synthesissolutions/geeksforkids/README.md

# geeksforkids
car_firmware - Code for RC/Joytick controlled cars
