synthesissolutions/geeksforkids/hardware/ControlBoardT36/ControlBoardT36.png

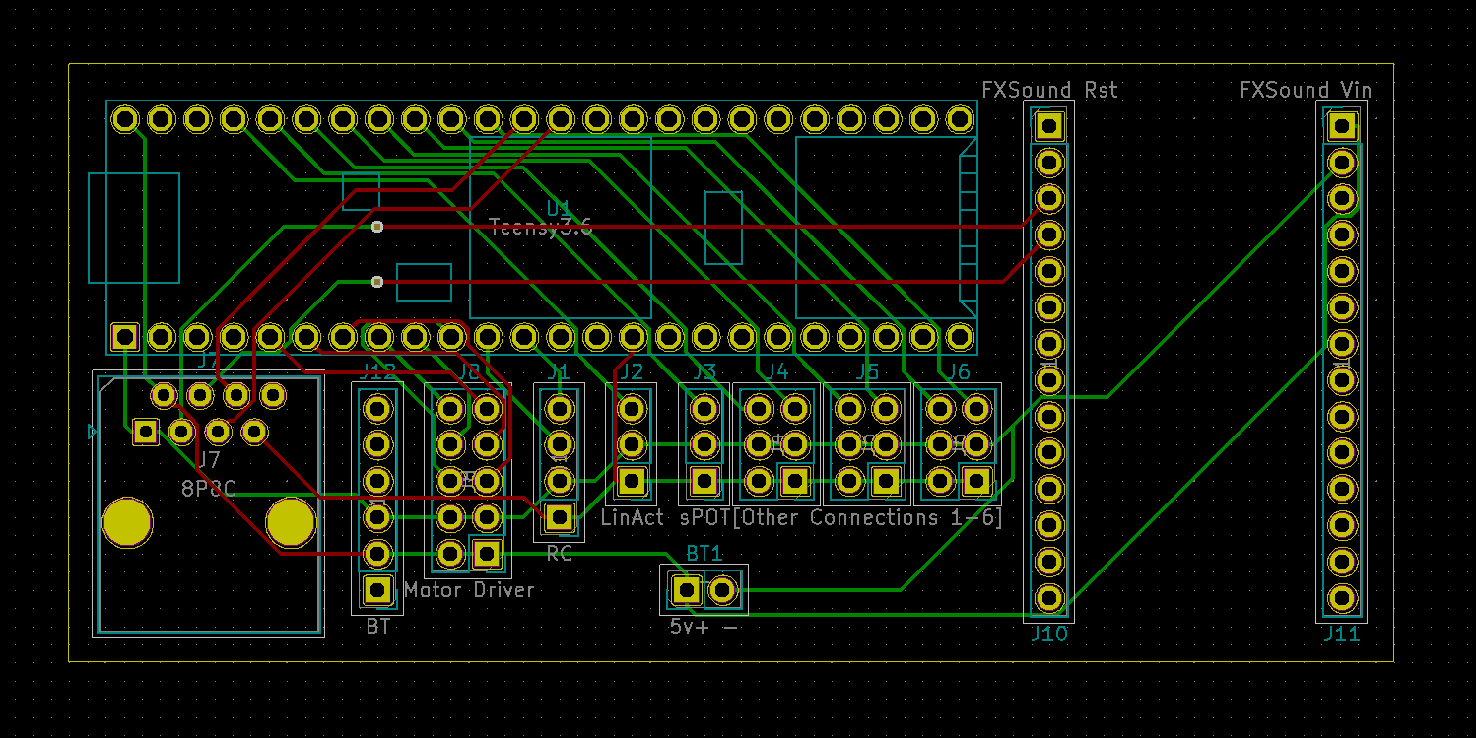
hardware/ControlBoardT36/ControlBoardT36.png
