synthesissolutions/geeksforkids/hardware/Drive Systems/Joystick/JoystickBoard/JoystickBoard.png

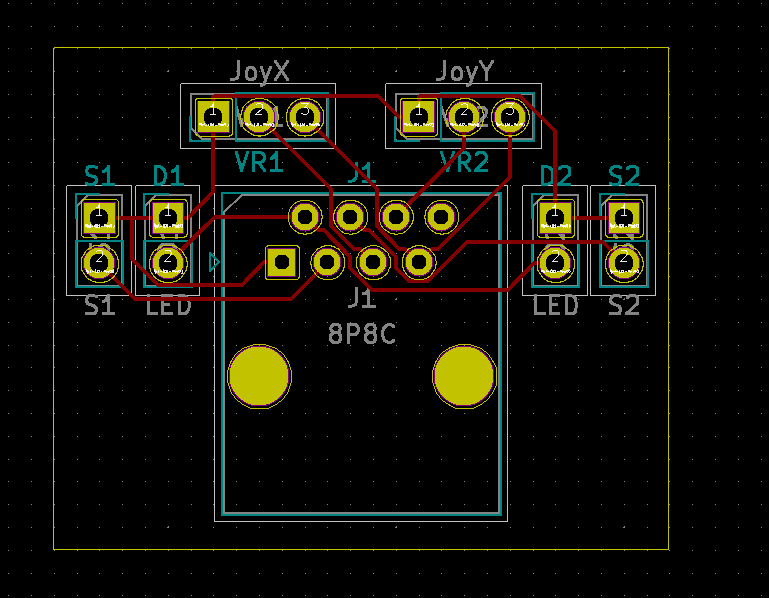
hardware/Drive Systems/Joystick/JoystickBoard/JoystickBoard.png
