synthesissolutions/geeksforkids/hardware/InputBoardSTM32/InputBoardSTM32-PCB.PNG

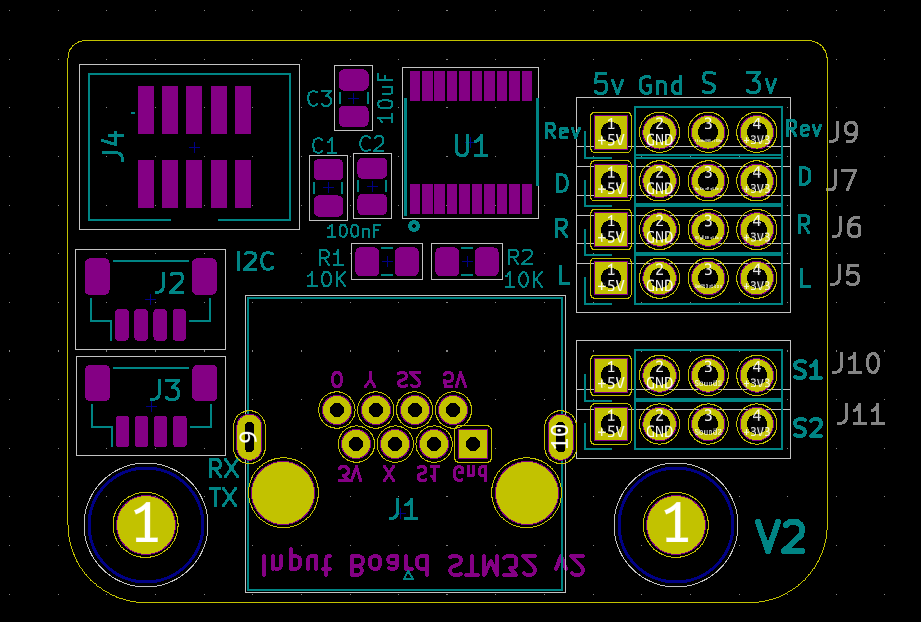
hardware/InputBoardSTM32/InputBoardSTM32-PCB.PNG
