synthesissolutions/geeksforkids/hardware/InputBoardSTM32QFN28/InputBoardSTM32QFN28-PCB.PNG

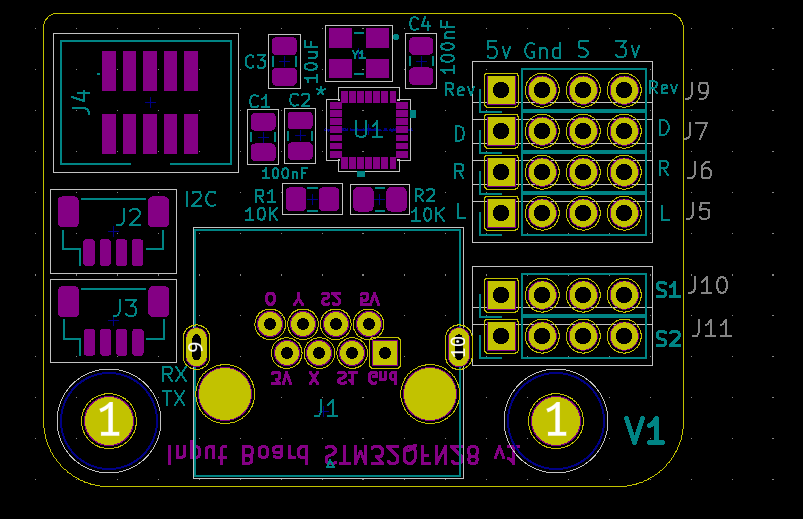
hardware/InputBoardSTM32QFN28/InputBoardSTM32QFN28-PCB.PNG
