synthesissolutions/geeksforkids/hardware/ControlPanelSTM32QFN28/production/gerber/bom.csv

Designator | Footprint | Quantity | Value | LCSC Part #
_3 |  | 1
C1, C2, C4 | 0402 | 3 | 100nF | C307331
C3 | 0603 | 1 | 10uF | C96446
D1 | 0603 | 1 | LED_Small
J1 | RJ45_x08_Tab_Up | 1 | 8P8C
J10, J11, J5, J6, J9 | JST_XH_B2B-XH-A_1x02_P2.50mm_Vertical | 5 | Conn_01x04_Male | C158012
J12, J13, J14, J15, J7, J8 | JST_XH_B2B-XH-A_1x02_P2.50mm_Vertical | 6 | Conn_01x02_Male | C158012
R1 | 0402 | 1 | 470 | C25117
U1 | STM32G031G8U6 | 1 | STM32G031F4Px | C432211
Y1 | OSC_ECS-3225MVQ-160-BP-TR | 1 | ECS-3225MVQ-160-BP-TR | C252336
