synthesissolutions/geeksforkids/hardware/Drive Systems/Drive By Wire (Ryder)/RyderSteeringButtonHolder/production/bom.csv

Designator | Footprint | Quantity | Value | LCSC Part #
J1 | JST_SH_SM03B-SRSS-TB_1x03-1MP_P1.00mm_Horizontal | 1 | Conn_01x03_Pin | C160403
J2 | button-holder1 | 1 | ButtonHolder
