synthesissolutions/geeksforkids/hardware/Drive Systems/Control Panel (New)/Small_Button/production/bom.csv

Designator | Footprint | Quantity | Value | LCSC Part #
J1 | JST_SH_SM03B-SRSS-TB_1x03-1MP_P1.00mm_Horizontal | 1 | JST SH | C160403
R1 | 0603 | 1 | 150Ω | C2907103
