synthesissolutions/geeksforkids/hardware/Evaluation and Test Boards/ATTinyBreakOut_DFRobot_Amp/parts.txt

https://www.digikey.com/product-detail/en/maxim-integrated/MAX9744ETH/MAX9744ETH-ND/1937401
https://www.digikey.com/product-detail/en/alpha-omega-semiconductor-inc/AOD417/785-1106-1-ND/1856049
https://www.digikey.com/product-detail/en/tdk-corporation/MPZ2012S221AT000/445-1568-1-ND/571898
https://www.digikey.com/product-detail/en/stackpole-electronics-inc/RNCP0805FTD10K0/RNCP0805FTD10K0CT-ND/2240601
https://www.digikey.com/product-detail/en/yageo/RC0805FR-0720KL/311-20-0KCRCT-ND/730667
https://www.digikey.com/product-detail/en/kemet/C0805C471K5RACTU/399-1142-1-ND/411417
https://www.digikey.com/product-detail/en/kemet/C0805C104M3RACTU/399-8000-1-ND/3471723
https://www.digikey.com/product-detail/en/kemet/C0805C474K4RACTU/399-8099-1-ND/3471822
https://www.digikey.com/product-detail/en/kemet/C0805C225K3RAC7800/399-11941-1-ND/5267659
https://www.digikey.com/product-detail/en/kemet/C0805C106K4PACTU/399-8012-1-ND/3471735
https://www.digikey.com/product-detail/en/rubycon/16ZLH470MEFC8X11-5/1189-1859-ND/3563382
