synthesissolutions/geeksforkids/hardware/Action Challenges/ButtonToActionChallenge/ButtonToActionChallenge.step

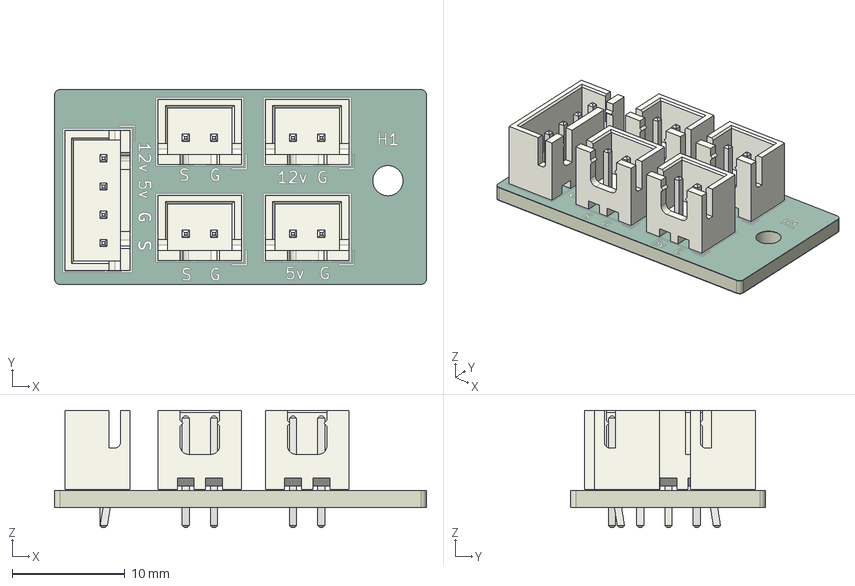
[picture p5: CAD file, 2026-05-23]
hardware/Action Challenges/ButtonToActionChallenge/ButtonToActionChallenge.step
32.9 x 17.3 x 10.4 mm
JST_XH_B4B-XH-A_1x04_P2.50mm_Vertical
JST_XH_B2B-XH-A_1x02_P2.50mm_Vertical x 4
ButtonToActionChallenge_silkscreen x 2
ButtonToActionChallenge_soldermask x 2
ButtonToActionChallenge_PCB
