synthesissolutions/geeksforkids/hardware/Action Challenges/Magic_Wand_Timer_Simplified/Magic_Wand_Timer_Simplified.step

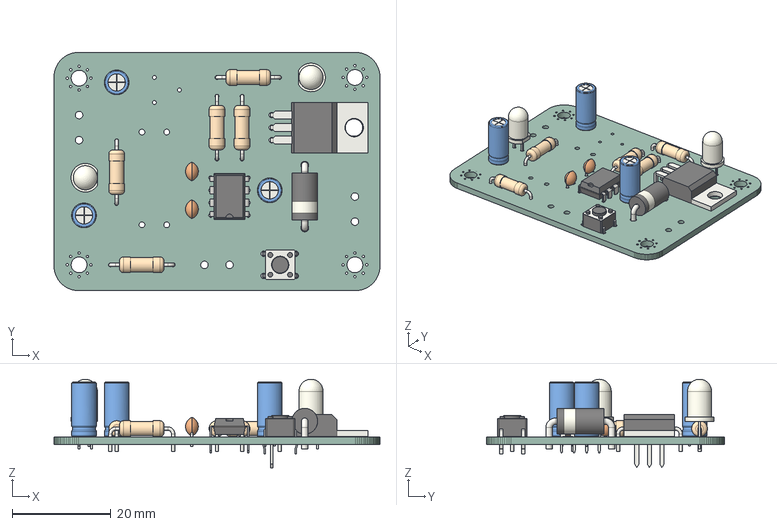
[picture p6: CAD file, 2024-05-20]
hardware/Action Challenges/Magic_Wand_Timer_Simplified/Magic_Wand_Timer_Simplified.step
66.0 x 48.3 x 17.9 mm
Magic_Wand_Timer_Simplified PCB
