synthesissolutions/geeksforkids/hardware/Action Challenges/Pulse_Fixed_Timer/3D_Models/TC33X-2-504E.step

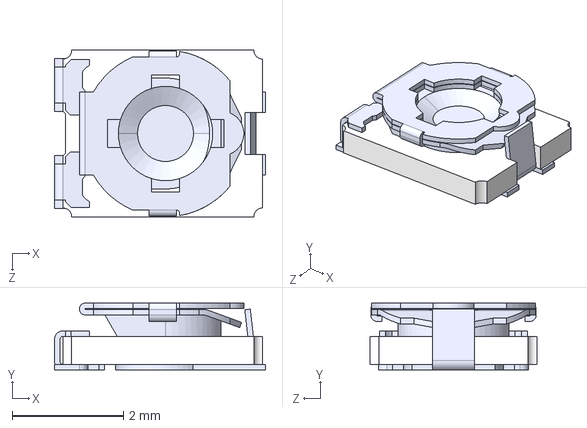
[picture p7: CAD file, 2024-11-27]
hardware/Action Challenges/Pulse_Fixed_Timer/3D_Models/TC33X-2-504E.step
3.80 x 1.20 x 3.00 mm
