synthesissolutions/geeksforkids/hardware/Action Challenges/Pulse_PWM_Timer/3D_Models/DFN8_LM393_STM.step

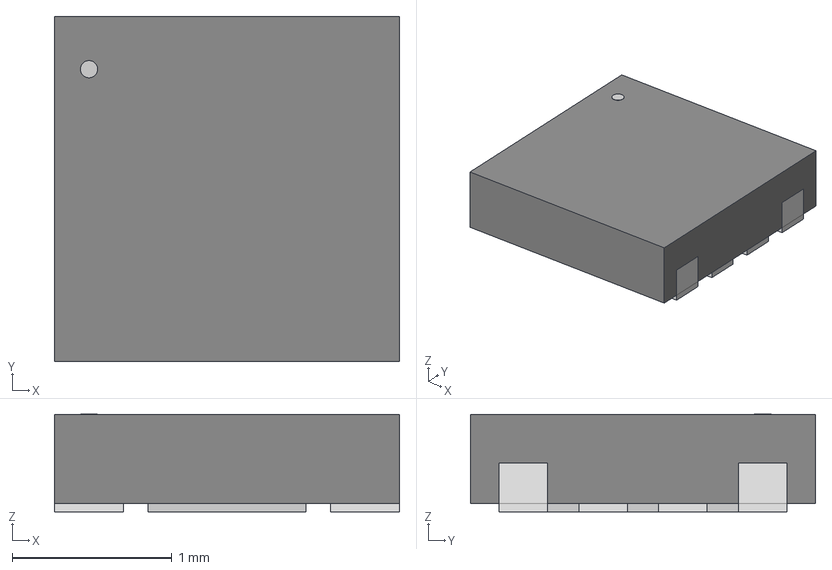
[picture p8: CAD file, 2024-11-27]
hardware/Action Challenges/Pulse_PWM_Timer/3D_Models/DFN8_LM393_STM.step
2.16 x 2.16 x 0.612 mm
