synthesissolutions/geeksforkids/hardware/Action Challenges/Pulse_PWM_Timer/Pulse_PWM_Timer.step

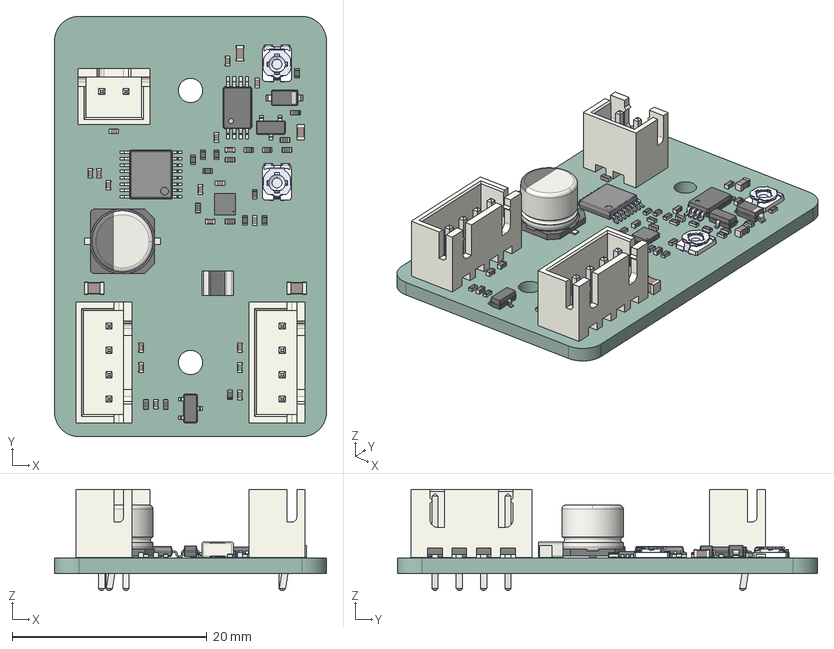
[picture p9: CAD file, 2024-11-27]
hardware/Action Challenges/Pulse_PWM_Timer/Pulse_PWM_Timer.step
27.9 x 43.2 x 10.4 mm
R_0402_1005Metric x 19
C_0402_1005Metric x 18
C_0603_1608Metric x 2
PWP0016C_ASM
SOT_23 x 2
JST_B4B_XH_A x 2
C_0805_2012Metric x 2
JST_B2B_XH_A
D_SOD_123
TC33X-2-202E x 2
Fuse_1210_3225Metric
TSSOP_8_44x3mm_P065mm
CP_Elec_63x54
Pulse_PWM_Timer_PCB
