synthesissolutions/geeksforkids/hardware/ControlPanelV3/ControlPanelV3.step

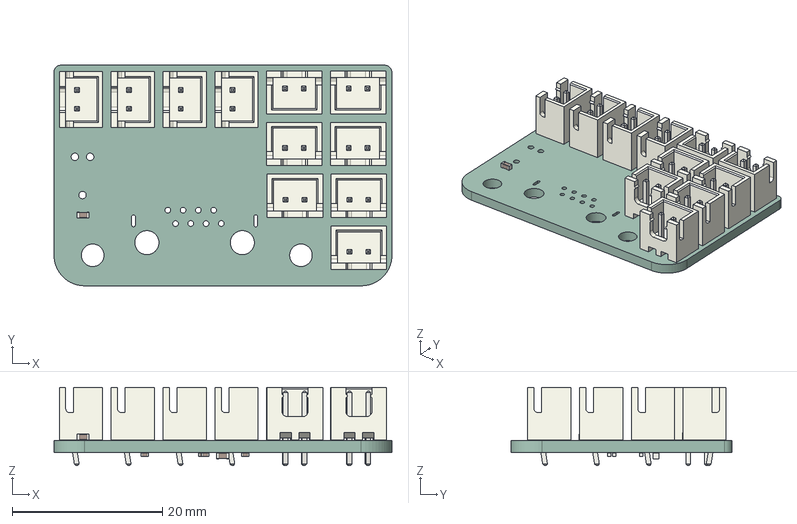
[picture p10: CAD file, 2024-12-07]
hardware/ControlPanelV3/ControlPanelV3.step
45.0 x 29.4 x 10.4 mm
JST_B2B_XH_A x 11
C_0603_1608Metric x 2
C_0402_1005Metric x 4
ControlPanelSTM32QFN28_PCB
