synthesissolutions/geeksforkids/hardware/Drive Systems/Control Panel (New)/Large_Button/button_pcb.step

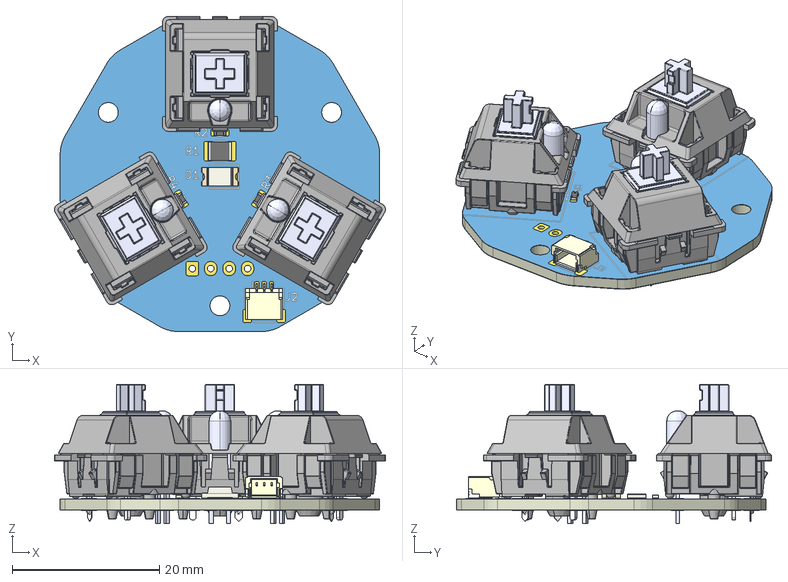
[picture p11: CAD file, 2025-04-16]
hardware/Drive Systems/Control Panel (New)/Large_Button/button_pcb.step
44.9 x 42.8 x 18.9 mm
R_0603_1608Metric x 3
MX Öá °´¼ü¡ä_¨¹___¡§1 x 3
MX ס סͥ¨¢¨¬_¡§¡顧__ x 3
MXס ϞñLEDLEDLED x 3
MXÖá ÖáÌå µ×²¿ ¦Ì¡Á2__Ä¬ÈÏ_¨¢2____¨¨_ x 3
֫½ğ__Ĭɏ__¨¨_ x 3
R_1210_3225Metric
JST_SH_SM03B-SRSS-TB_1x03-1MP_P1.00mm_Horizontal
LED_2010_5025Metric_Castellated
large_button_copper
large_button_silkscreen
large_button_soldermask
large_button_PCB
