synthesissolutions/geeksforkids/hardware/Drive Systems/Control Panel (New)/Small_Button/button_pcb.step

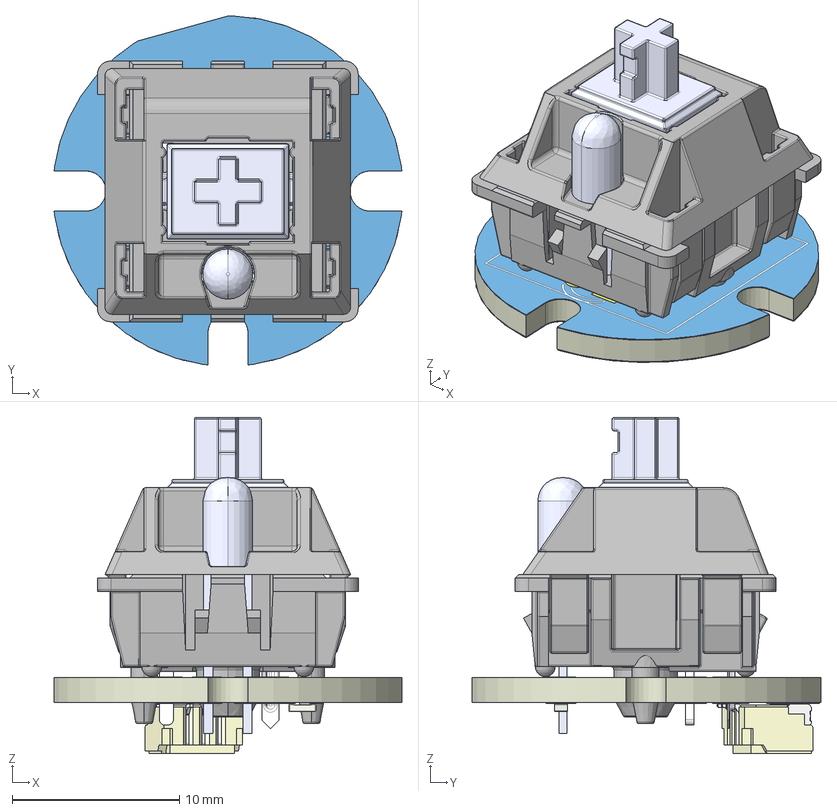
[picture p12: CAD file, 2025-04-16]
hardware/Drive Systems/Control Panel (New)/Small_Button/button_pcb.step
20.8 x 20.9 x 20.1 mm
MX Öá °´¼ü¡ä_¨¹___¡§1
MX ס סͥ¨¢¨¬_¡§¡顧__
MXס ϞñLEDLEDLED
MXÖá ÖáÌå µ×²¿ ¦Ì¡Á2__Ä¬ÈÏ_¨¢2____¨¨_
֫½ğ__Ĭɏ__¨¨_
JST_SH_SM03B-SRSS-TB_1x03-1MP_P1.00mm_Horizontal
R_0603_1608Metric
Small_Button_copper
Small_Button_silkscreen
Small_Button_soldermask
Small_Button_PCB
