synthesissolutions/geeksforkids/hardware/Drive Systems/Control Panel (No Touch)/ControlPanel_CapacitiveTouch/.step

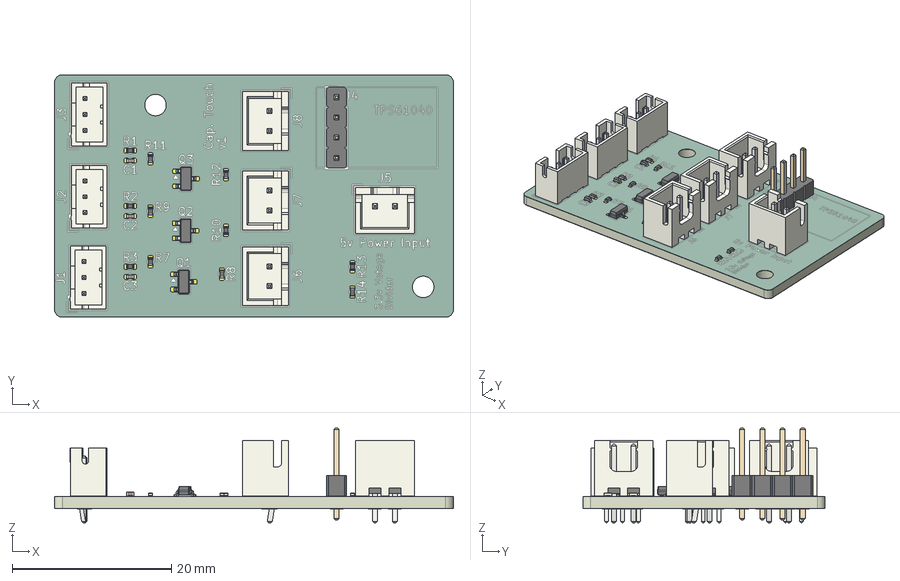
[picture p13: CAD file, 2026-05-23]
hardware/Drive Systems/Control Panel (No Touch)/ControlPanel_CapacitiveTouch/.step
50.2 x 30.5 x 11.9 mm
R_0402_1005Metric x 11
C_0402_1005Metric x 3
JST_XH_B2B-XH-A_1x02_P2.50mm_Vertical x 4
JST_PH_B3B-PH-K_1x03_P2.00mm_Vertical x 3
SOT-23 x 3
PinHeader_1x04_P2.54mm_Vertical
ControlPanel_CapacitiveTouch_copper
ControlPanel_CapacitiveTouch_silkscreen x 2
ControlPanel_CapacitiveTouch_soldermask x 2
ControlPanel_CapacitiveTouch_PCB
