synthesissolutions/geeksforkids/hardware/Drive Systems/Drive By Wire (Fisher Price)/DriveByWireInputAltSTM32QFN28/DriveByWireInputAltSTM32QFN28.step

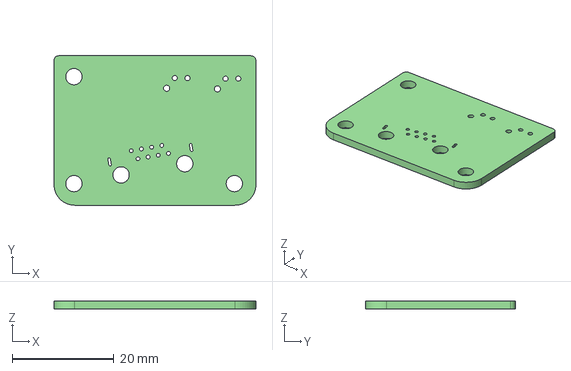
[picture p14: CAD file, 2022-08-21]
hardware/Drive Systems/Drive By Wire (Fisher Price)/DriveByWireInputAltSTM32QFN28/DriveByWireInputAltSTM32QFN28.step
39.7 x 29.4 x 1.60 mm
