synthesissolutions/geeksforkids/hardware/Drive Systems/Drive By Wire (Fisher Price)/DriveByWireMr360Sensor/3d_models/EG1249.stp

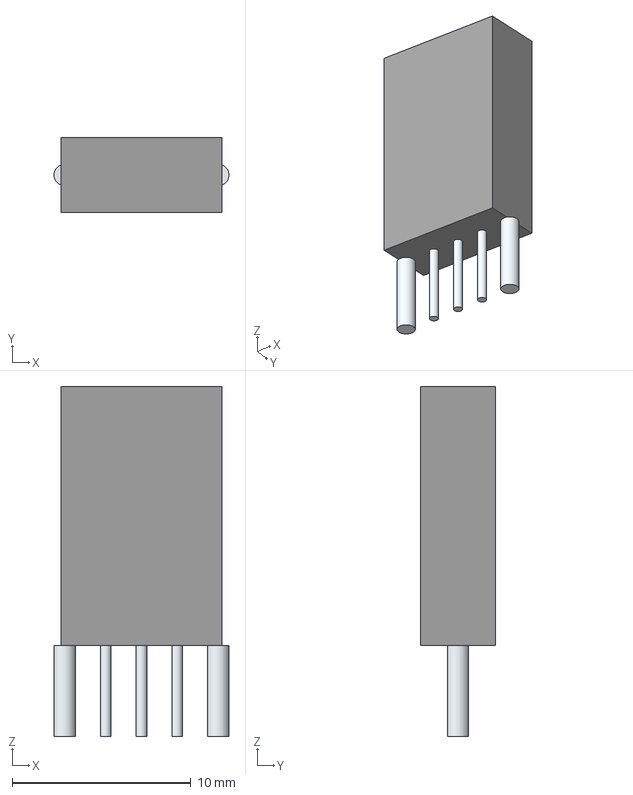
[picture p15: CAD file, 2022-07-25]
hardware/Drive Systems/Drive By Wire (Fisher Price)/DriveByWireMr360Sensor/3d_models/EG1249.stp
9.80 x 4.20 x 19.6 mm
Leads x 5
