synthesissolutions/geeksforkids/hardware/Drive Systems/Drive By Wire (Fisher Price)/DriveByWireMr360Sensor/TLE5501E0001XUMA1.step

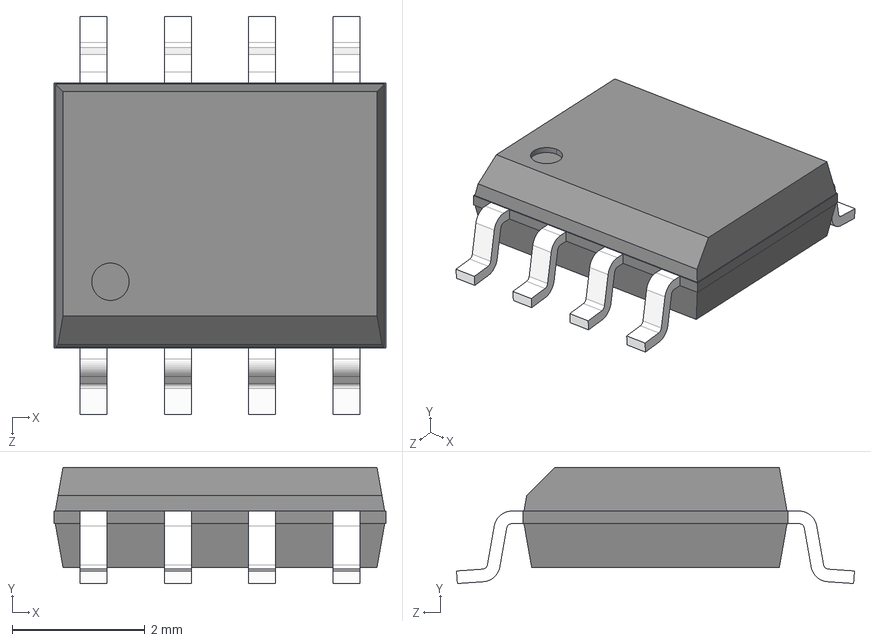
[picture p16: CAD file, 2022-08-19]
hardware/Drive Systems/Drive By Wire (Fisher Price)/DriveByWireMr360Sensor/TLE5501E0001XUMA1.step
5.00 x 1.75 x 6.00 mm
