synthesissolutions/geeksforkids/hardware/Drive Systems/Drive By Wire (Fisher Price)/DriveByWireMrSensor/3d_models/SO8_SOT96-1_NXP.step

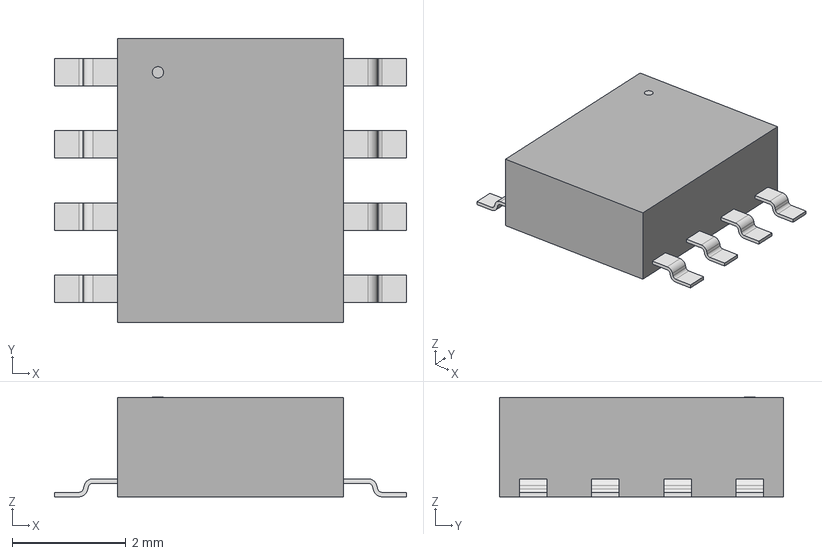
[picture p17: CAD file, 2021-11-19]
hardware/Drive Systems/Drive By Wire (Fisher Price)/DriveByWireMrSensor/3d_models/SO8_SOT96-1_NXP.step
6.20 x 5.00 x 1.75 mm
