synthesissolutions/geeksforkids/hardware/Drive Systems/Drive By Wire (Fisher Price)/DriveByWireMrSensor/DriveByWire PCB Sketch V2.dxf

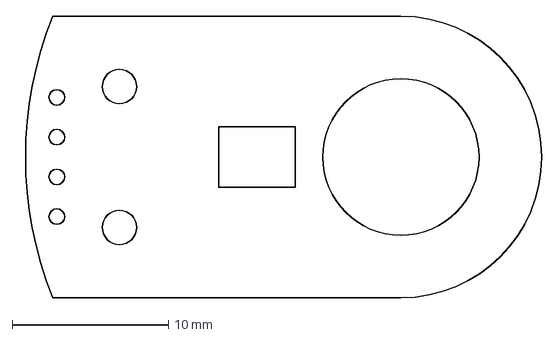
[picture p18: CAD file, 2021-12-07]
hardware/Drive Systems/Drive By Wire (Fisher Price)/DriveByWireMrSensor/DriveByWire PCB Sketch V2.dxf
33.6 x 18.0 mm
