synthesissolutions/geeksforkids/hardware/Drive Systems/Drive By Wire (Ryder)/RyderDriveByWireMicrocontroller/RyderDriveByWireMicrocontroller.step

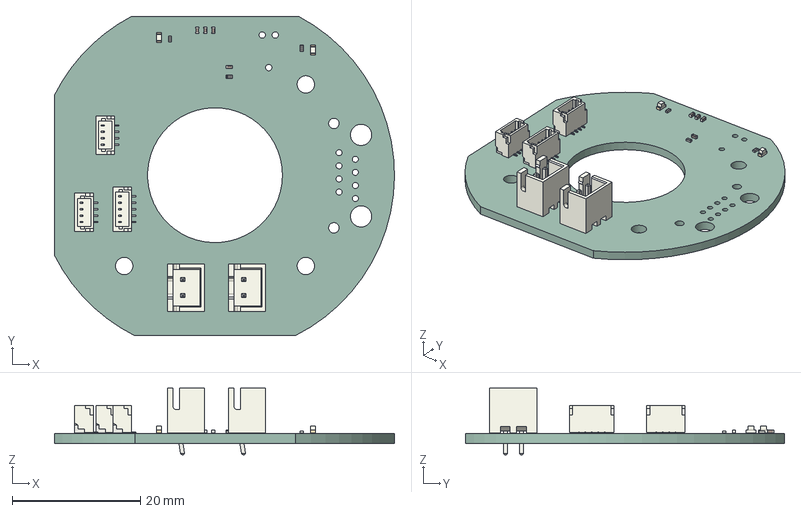
[picture p19: CAD file, 2026-04-09]
hardware/Drive Systems/Drive By Wire (Ryder)/RyderDriveByWireMicrocontroller/RyderDriveByWireMicrocontroller.step
53.0 x 49.8 x 10.4 mm
C_0402_1005Metric x 4
JST_SH_BM04B-SRSS-TB_1x04-1MP_P1.00mm_Vertical x 2
JST_XH_B2B-XH-A_1x02_P2.50mm_Vertical x 2
R_0402_1005Metric x 3
JST_SH_BM05B-SRSS-TB_1x05-1MP_P1.00mm_Vertical
LED_0603_1608Metric x 2
RyderDriveByWireMicrocontroller_PCB
