synthesissolutions/geeksforkids/hardware/Drive Systems/Drive By Wire (Ryder)/RyderSteeringButtonConnector/RyderSteeringButtonConnector.step

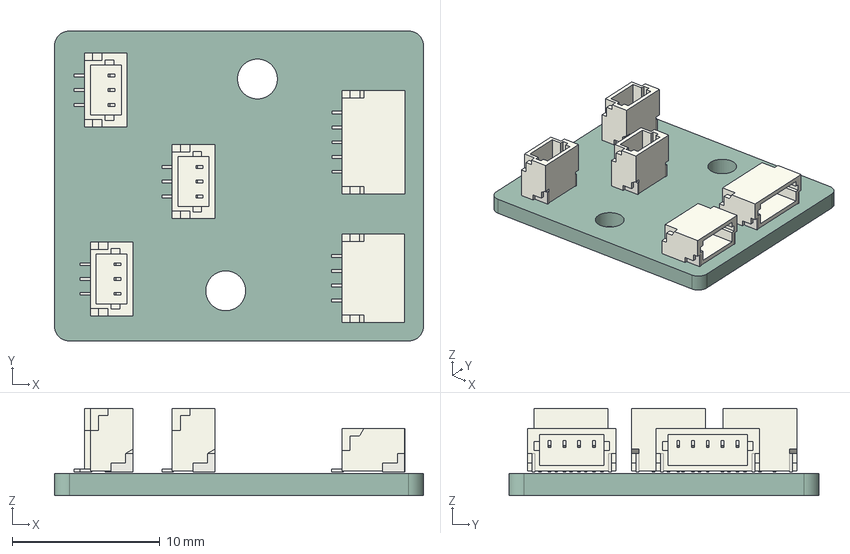
[picture p20: CAD file, 2026-03-16]
hardware/Drive Systems/Drive By Wire (Ryder)/RyderSteeringButtonConnector/RyderSteeringButtonConnector.step
25.0 x 21.0 x 5.92 mm
JST_SH_BM03B-SRSS-TB_1x03-1MP_P1.00mm_Vertical x 3
JST_SH_SM05B-SRSS-TB_1x05-1MP_P1.00mm_Horizontal
JST_SH_SM04B-SRSS-TB_1x04-1MP_P1.00mm_Horizontal
RyderSteeringButtonConnector_PCB
