synthesissolutions/geeksforkids/hardware/Drive Systems/Joystick/InputJoyStickSTM32QFN28/InputJoyStickSTM32QFN28.step

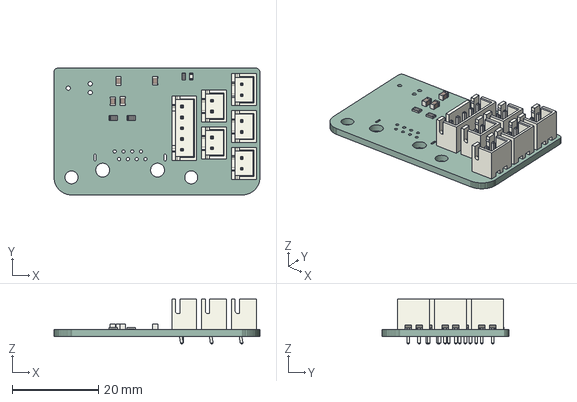
[picture p21: CAD file, 2023-12-19]
hardware/Drive Systems/Joystick/InputJoyStickSTM32QFN28/InputJoyStickSTM32QFN28.step
47.7 x 29.4 x 10.4 mm
InputJoyStickSTM32QFN28 PCB
