synthesissolutions/geeksforkids/hardware/Evaluation and Test Boards/FeatherRJ45/3d/TS-1187A-B-A-B.step

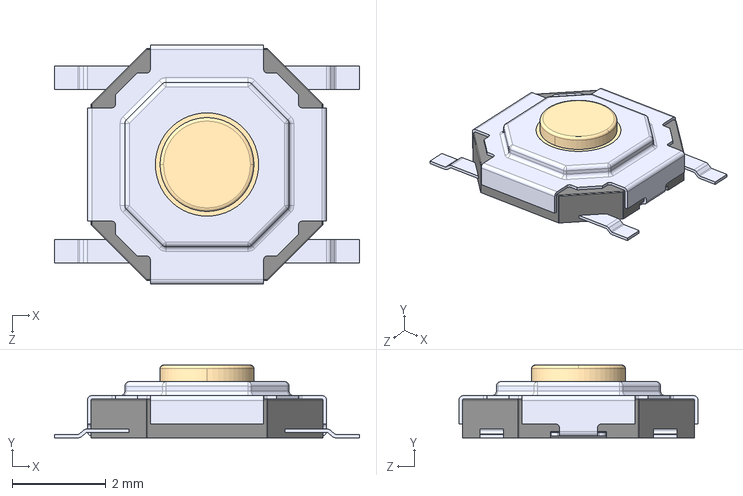
[picture p22: CAD file, 2023-11-09]
hardware/Evaluation and Test Boards/FeatherRJ45/3d/TS-1187A-B-A-B.step
6.50 x 1.55 x 5.10 mm
