synthesissolutions/geeksforkids/hardware/Evaluation and Test Boards/TOF_Button KB2040/TOF_Button KB2040.step

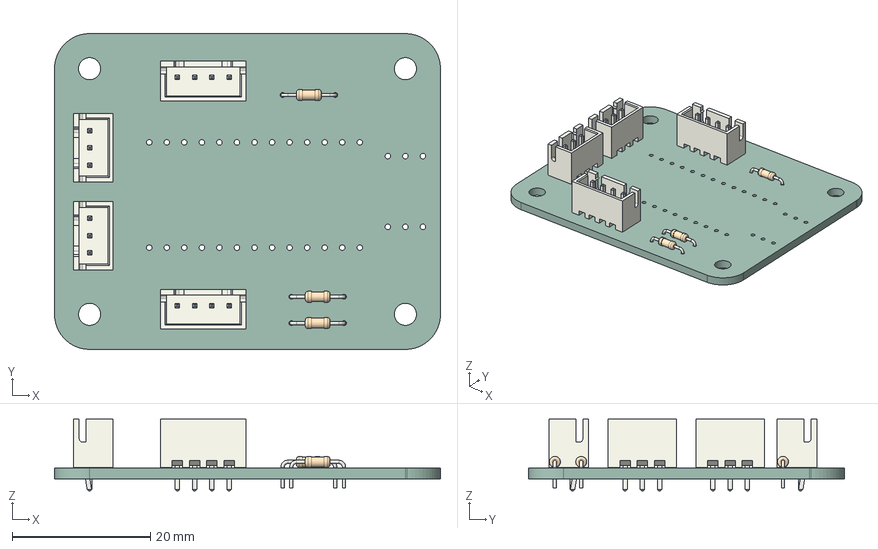
[picture p23: CAD file, 2026-03-21]
hardware/Evaluation and Test Boards/TOF_Button KB2040/TOF_Button KB2040.step
55.9 x 45.7 x 10.4 mm
R_Axial_DIN0204_L36mm_D16mm_P762mm_Horizontal x 3
JST_B3B_XH_A x 2
JST_B4B_XH_A x 2
TOF_Button KB2040_PCB
