synthesissolutions/geeksforkids/hardware/Fisher Price Base/motor-controller-v2/Brushed_DC_Motor_Driver.step

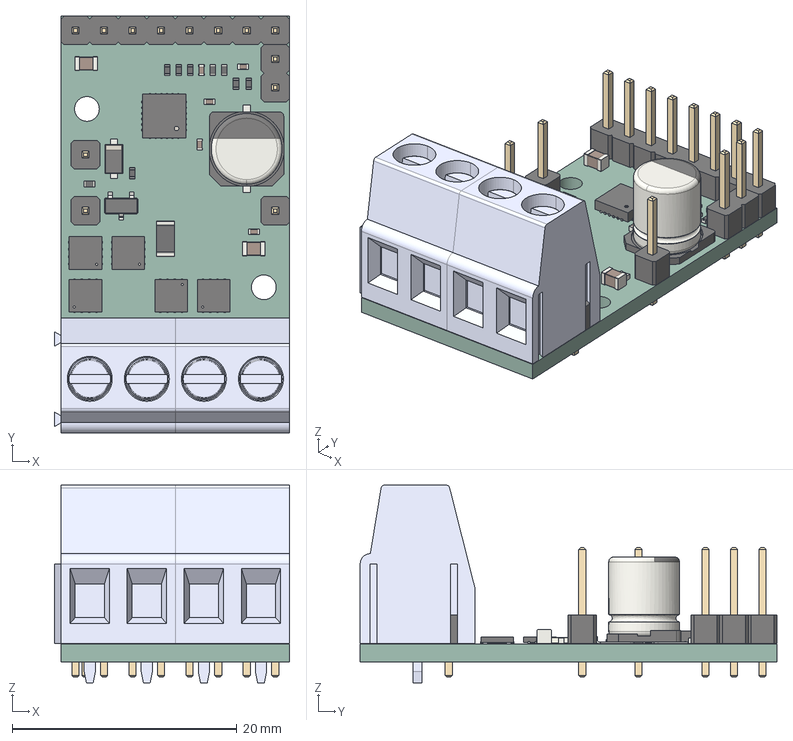
[picture p24: CAD file, 2025-10-25]
hardware/Fisher Price Base/motor-controller-v2/Brushed_DC_Motor_Driver.step
20.9 x 37.1 x 17.6 mm
PCB
