synthesissolutions/geeksforkids/hardware/SimpleBuildSoundsAmp/SimpleBuildSoundsAmp.step

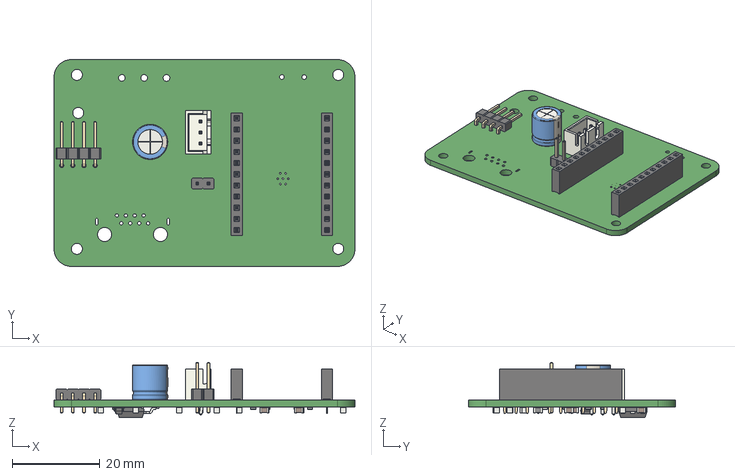
[picture p26: CAD file, 2021-07-20]
hardware/SimpleBuildSoundsAmp/SimpleBuildSoundsAmp.step
68.5 x 47.1 x 12.6 mm
