synthesissolutions/geeksforkids/hardware/Action Challenges/Pulse_PWM_Timer/3D_Models/PWP0016C.stp

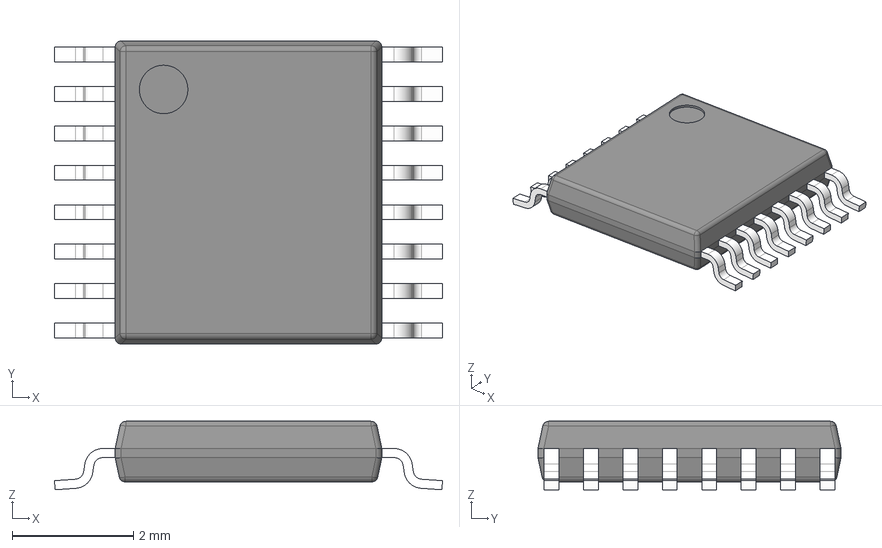
[picture p27: CAD file, 2024-11-27]
hardware/Action Challenges/Pulse_PWM_Timer/3D_Models/PWP0016C.stp
6.40 x 5.00 x 1.13 mm
BODY-TSSOP
LEAD-TSSOP x 16
PIN1
DAP
