synthesissolutions/geeksforkids/hardware/Drive Systems/Drive By Wire (Fisher Price)/DriveByWireMr360Sensor/3d_models/TLE5501E0002XUMA1.stp

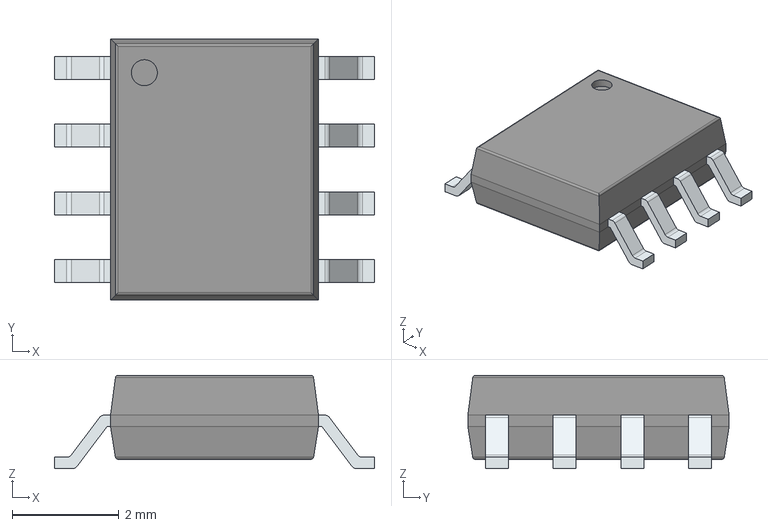
[picture p28: CAD file, 2022-07-25]
hardware/Drive Systems/Drive By Wire (Fisher Price)/DriveByWireMr360Sensor/3d_models/TLE5501E0002XUMA1.stp
6.00 x 4.90 x 1.75 mm
PinsArrayLR
