synthesissolutions/geeksforkids/hardware/Drive Systems/Drive By Wire (Fisher Price)/DriveByWireMrSensor/pcb_fusion_layout.dxf

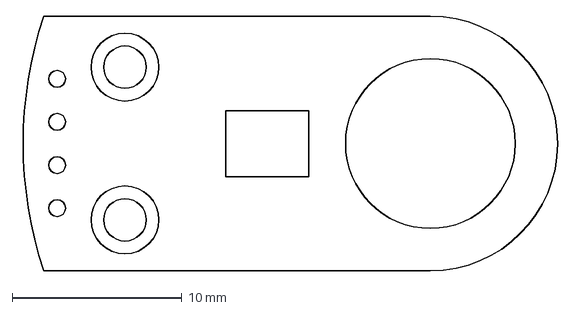
[picture p29: CAD file, 2021-11-19]
hardware/Drive Systems/Drive By Wire (Fisher Price)/DriveByWireMrSensor/pcb_fusion_layout.dxf
31.9 x 15.0 mm
