synthesissolutions/geeksforkids/hardware/Evaluation and Test Boards/FeatherRJ45/3d/TYPE-C-31-M-12.step

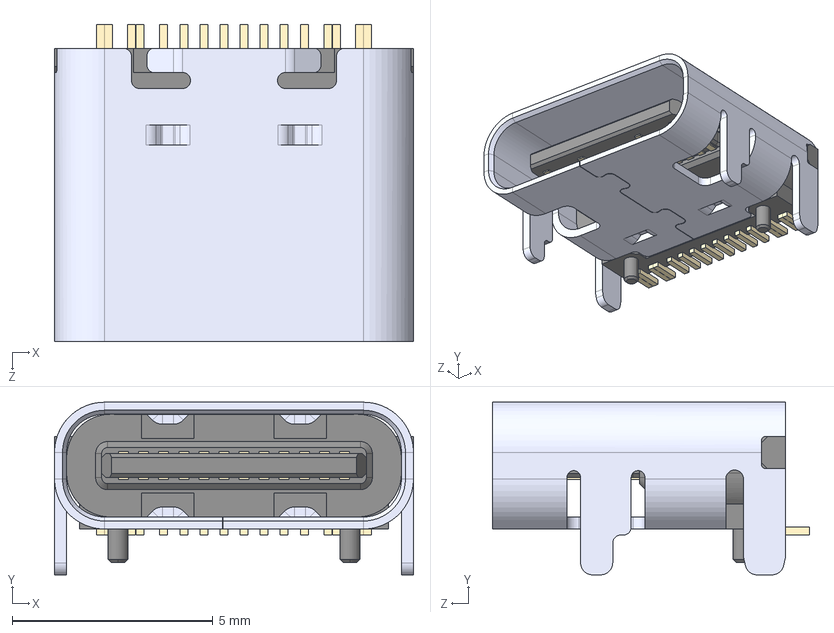
[picture p30: CAD file, 2023-11-09]
hardware/Evaluation and Test Boards/FeatherRJ45/3d/TYPE-C-31-M-12.step
8.94 x 4.30 x 7.90 mm
