synthesissolutions/geeksforkids/hardware/Ryder/geeks-ecu/3Dmodels/NS-Tech_Grove_1x04_P2mm_Vertical.step

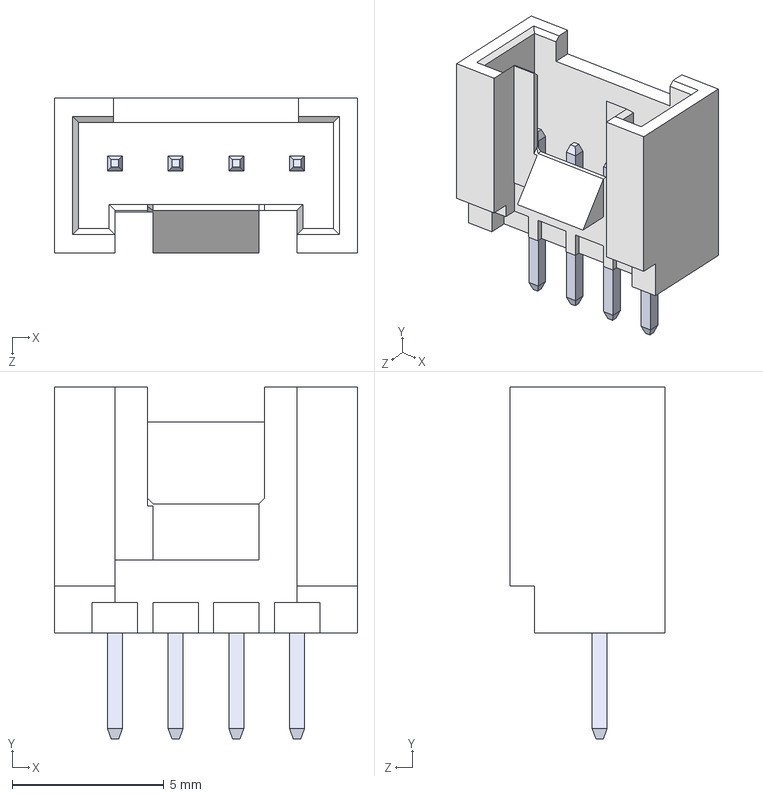
[picture p31: CAD file, 2026-04-27]
hardware/Ryder/geeks-ecu/3Dmodels/NS-Tech_Grove_1x04_P2mm_Vertical.step
10.0 x 11.6 x 5.10 mm
