synthesissolutions/geeksforkids/hardware/Drive Systems/Drive By Wire (Fisher Price)/DriveByWireMr360Sensor/3d_models/RJHSE-3380.stp

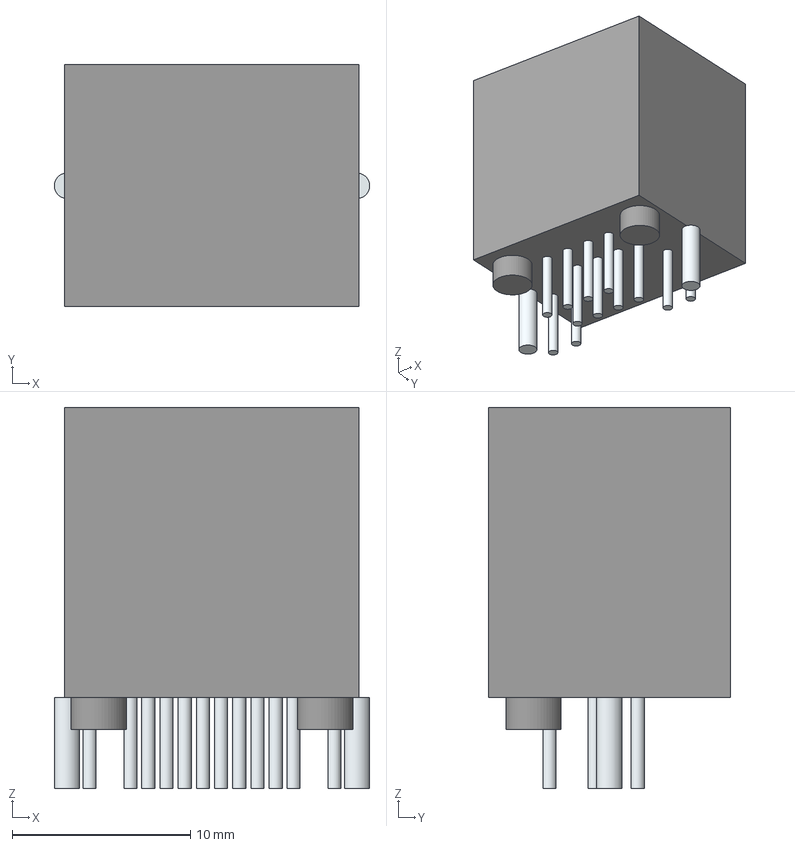
[picture p32: CAD file, 2022-07-25]
hardware/Drive Systems/Drive By Wire (Fisher Price)/DriveByWireMr360Sensor/3d_models/RJHSE-3380.stp
17.7 x 13.6 x 21.4 mm
Lugs x 16
Leads x 16
