synthesissolutions/geeksforkids/hardware/Drive Systems/Drive By Wire (Fisher Price)/DriveByWireMrSensor/DriveByWireMrSensor.step

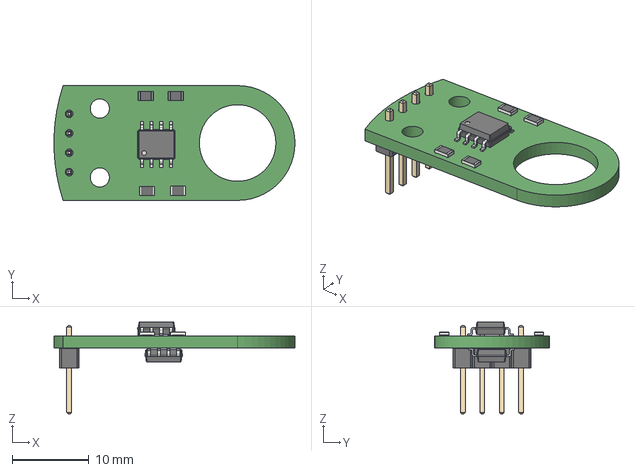
[picture p33: CAD file, 2021-11-19]
hardware/Drive Systems/Drive By Wire (Fisher Price)/DriveByWireMrSensor/DriveByWireMrSensor.step
31.5 x 15.0 x 12.0 mm
