synthesissolutions/geeksforkids/hardware/Ryder/geeks-ecu/3Dmodels/TerminalBlock_CUI_TB007-508-02_1x02_P5.08mm_Horizontal.step

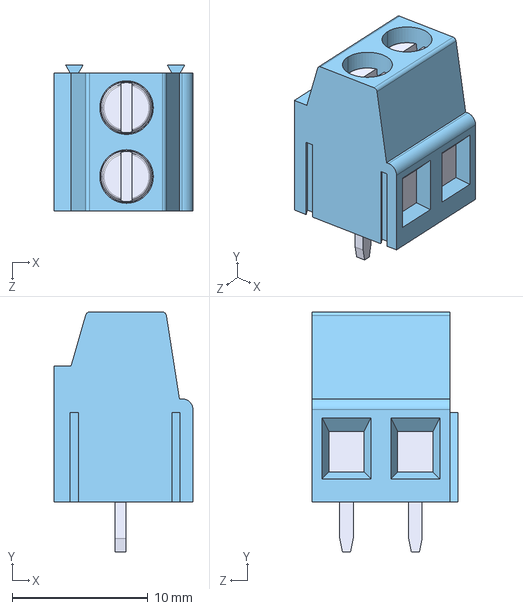
[picture p34: CAD file, 2026-04-27]
hardware/Ryder/geeks-ecu/3Dmodels/TerminalBlock_CUI_TB007-508-02_1x02_P5.08mm_Horizontal.step
10.2 x 17.7 x 10.8 mm
