synthesissolutions/geeksforkids/hardware/Ryder/geeks-ecu/3Dmodels/Same_Sky_TB005-762-02BE.step

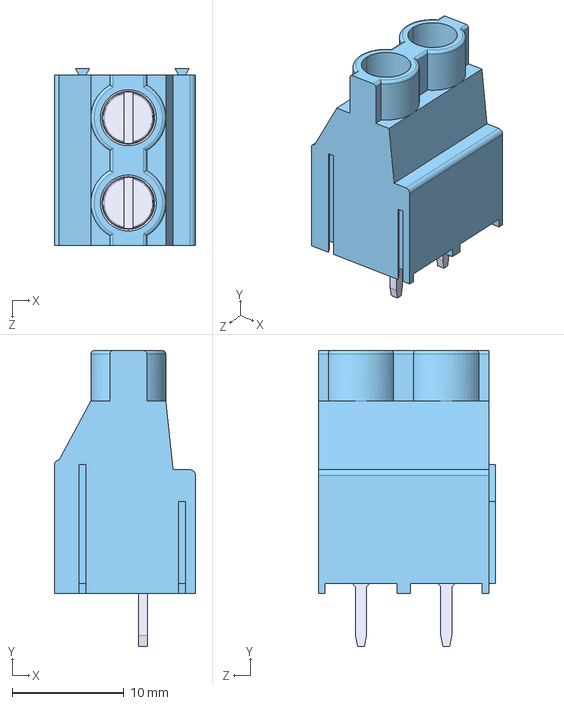
[picture p35: CAD file, 2026-03-14]
hardware/Ryder/geeks-ecu/3Dmodels/Same_Sky_TB005-762-02BE.step
12.6 x 26.5 x 15.8 mm
