synthesissolutions/geeksforkids/hardware/Ryder/geeks-ecu/3Dmodels/APR.stp

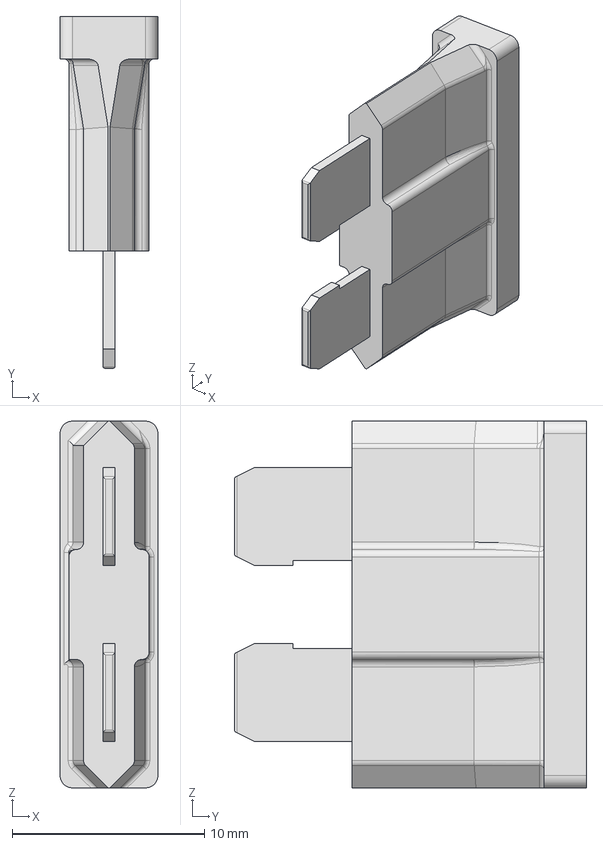
[picture p36: CAD file, 2026-03-14]
hardware/Ryder/geeks-ecu/3Dmodels/APR.stp
5.08 x 18.3 x 19.0 mm
