synthesissolutions/geeksforkids/hardware/Ryder/geeks-ecu/3Dmodels/J115F11A_Sealed_NoPin6.stp

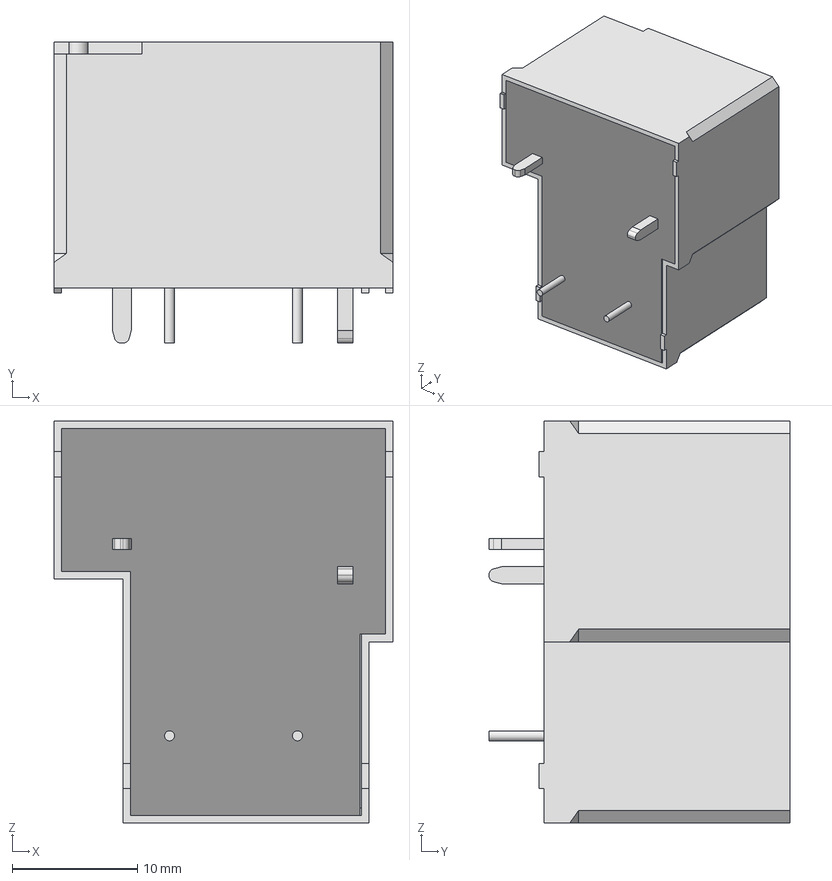
[picture p37: CAD file, 2026-03-14]
hardware/Ryder/geeks-ecu/3Dmodels/J115F11A_Sealed_NoPin6.stp
27.0 x 24.0 x 32.1 mm
J115F1_Cover
J115F11A_Base Plate
J115F1_Terminal_Coil x 2
J115F1_Terminal_Contacts
J115F1_Terminal_Common
