synthesissolutions/geeksforkids/hardware/Ryder/geeks-ecu/3Dmodels/3557-2.step

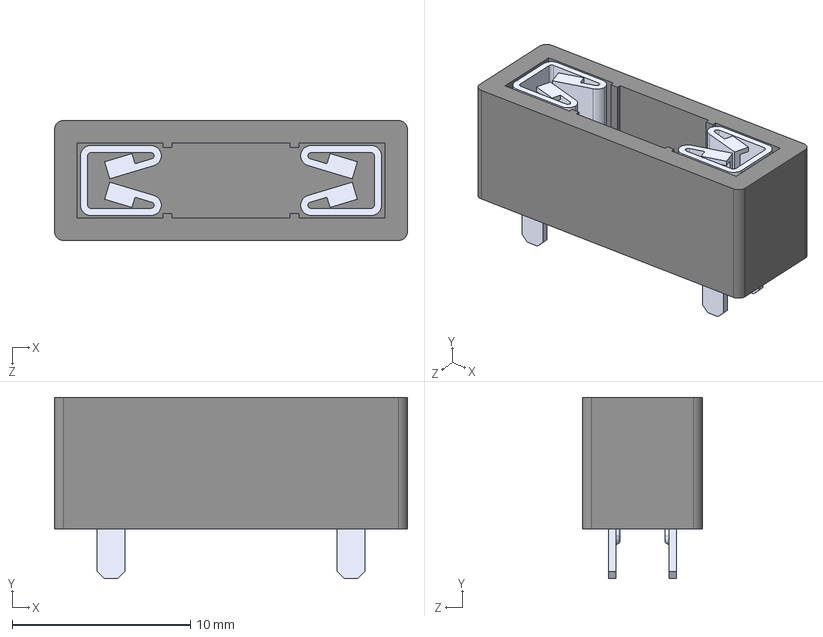
[picture p38: CAD file, 2026-03-14]
hardware/Ryder/geeks-ecu/3Dmodels/3557-2.step
19.8 x 10.2 x 6.73 mm
