synthesissolutions/geeksforkids/hardware/Ryder/geeks-ecu/3Dmodels/3568.step

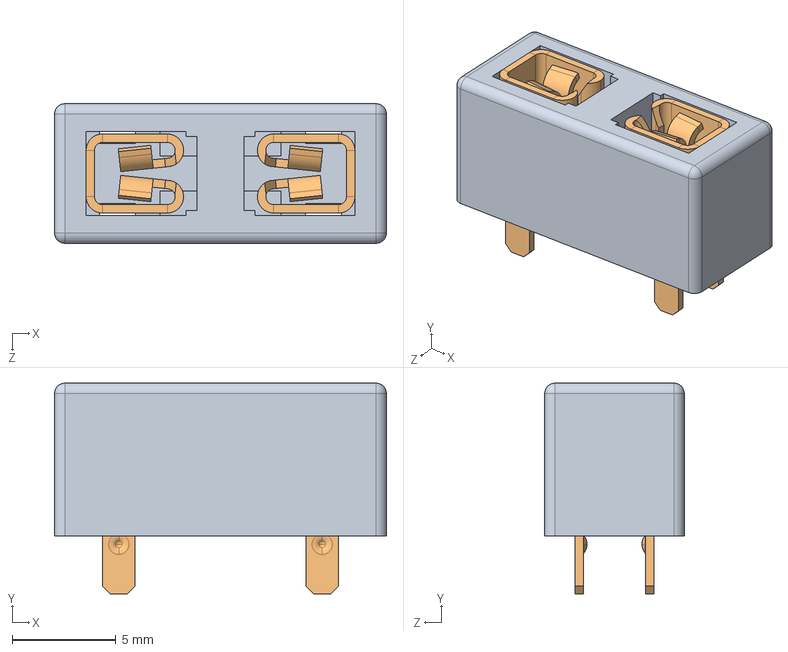
[picture p39: CAD file, 2026-03-14]
hardware/Ryder/geeks-ecu/3Dmodels/3568.step
16.0 x 10.2 x 6.73 mm
F3568-1
3557_rev.C x 2
