synthesissolutions/geeksforkids/(list of files, cad)

Other CAD files:
hardware/Drive Systems/Drive By Wire (Fisher Price)/DriveByWireMr360Sensor/3d_models/NE555DR.stp
