synthesissolutions/geeksforkids/hardware/Ryder/geeks-ecu/geeks-ecu.pdf

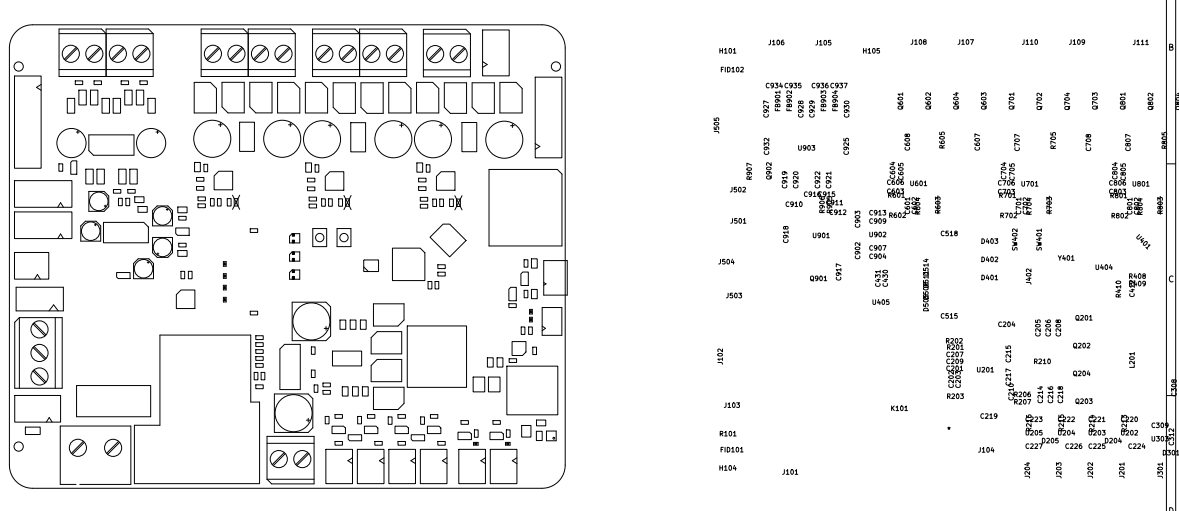
[picture p40: page 1]

Learn Science and Math Club
Sheet:
File: geeks-ecu.kicad_pcb
Title: Electronics Control Unit (ECU)

Size: USLedger | Rev: V1
KiCad E.D.A. 10.0.1 | Id: 1/1
