synthesissolutions/geeksforkids/hardware/Ryder/geeks-ecu/geeks-ecu_ASSY.pdf

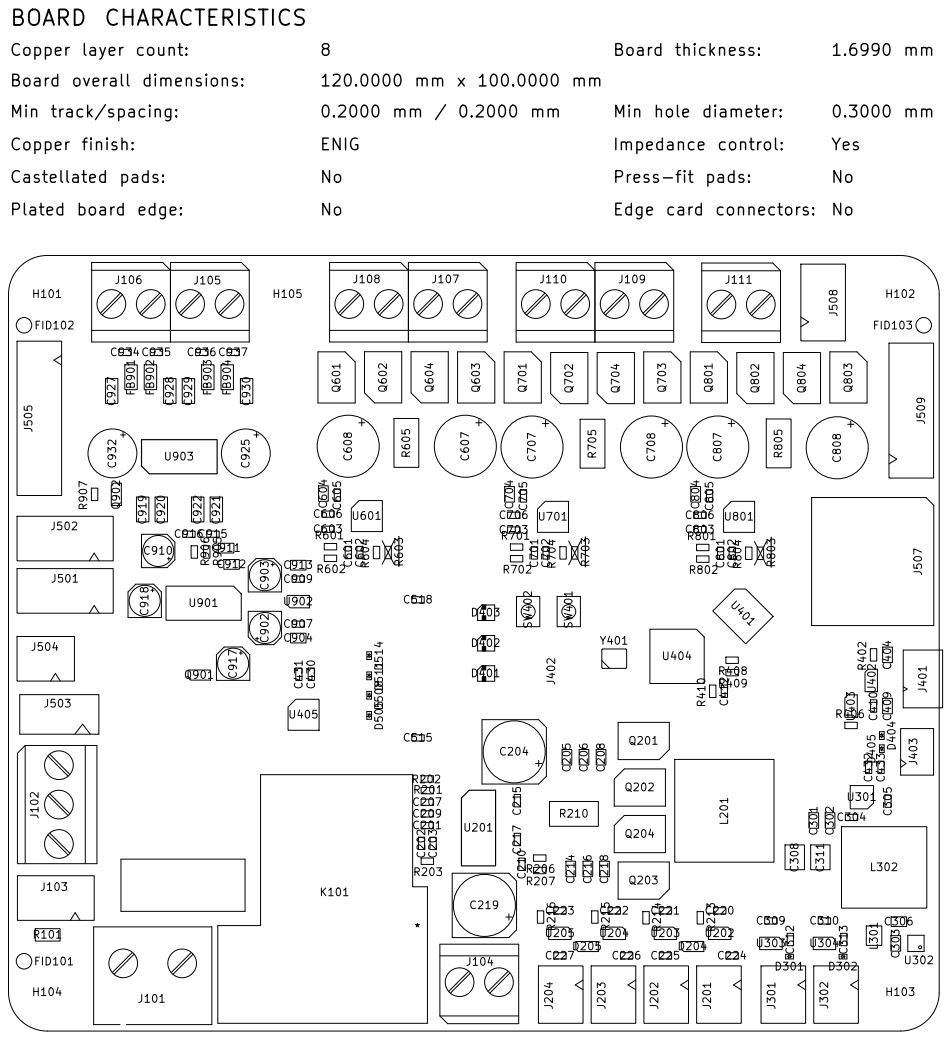
[picture p41: page 1]

Geeks for Kids
Learn Science and Math Club
Sheet:
File: geeks-ecu.kicad_pcb
Title: Electronics Control Unit (ECU)

Size: USLedger | Rev: V1
KiCad E.D.A. 10.0.1 | Id: 1/2

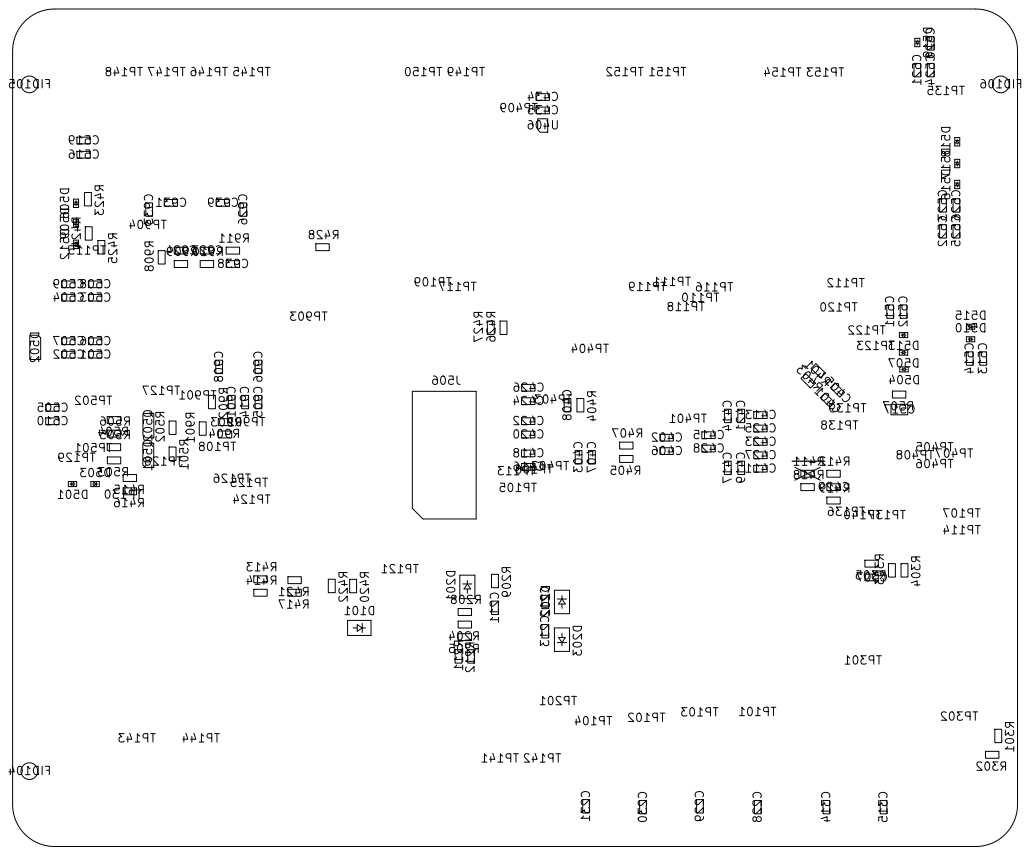
[picture p42: page 2]

Learn Science and Math Club
Sheet:
File: geeks-ecu.kicad_pcb
Title: Electronics Control Unit (ECU)

Size: USLedger | Rev: V1
KiCad E.D.A. 10.0.1 | Id: 2/2
