synthesissolutions/geeksforkids/hardware/Ryder/geeks-ecu/geeks-ecu_SCM.pdf

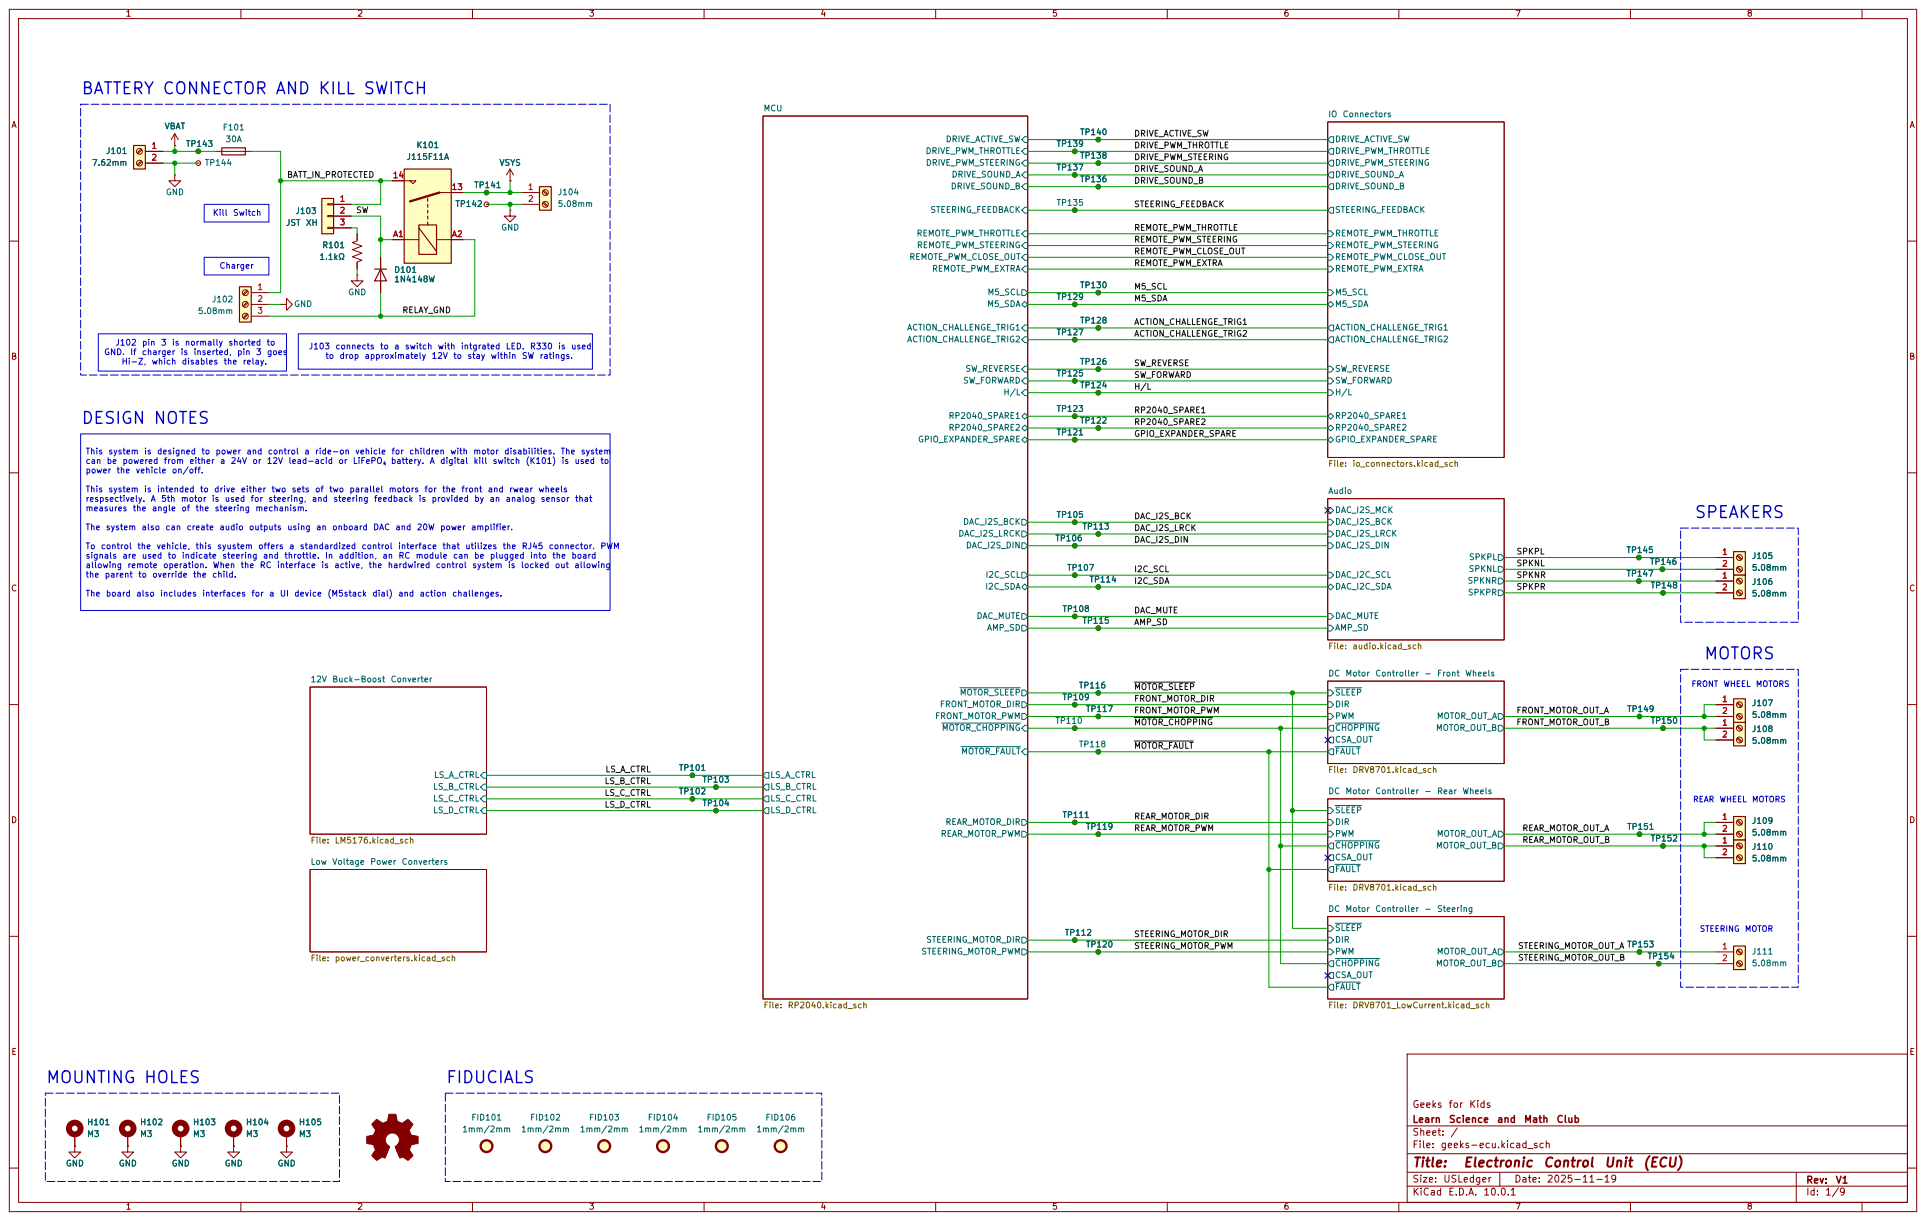
[picture p43: page 1]

BATTERY CONNECTOR AND KILL SWITCH

Charger J102 pin 3 is normally shorted to GND. If charger is inserted, pin 3 goes Hi-Z, which disables the relay. Kill Switch

J103 connects to a switch with intgrated LED. R330 is used
to drop approximately 12V to stay within SW ratings.

This system is designed to power and control a ride-on vehicle for children with motor disabilities. The system
can be powered from either a 24V or 12V lead-acid or LiFePO4 battery. A digital kill switch (K101) is used to
power the vehicle on/off. This system is intended to drive either two sets of two parallel motors for the front and rwear wheels

respsectively. A 5th motor is used for steering, and steering feedback is provided by an analog sensor that measures the angle of the steering mechanism. The system also can create audio outputs using an onboard DAC and 20W power amplifier. To control the vehicle, this syustem offers a standardized control interface that utilizes the RJ45 connector. PWM

signals are used to indicate steering and throttle. In addition, an RC module can be plugged into the board
allowing remote operation. When the RC interface is active, the hardwired control system is locked out allowing
the parent to override the child. The board also includes interfaces for a UI device (M5stack dial) and action challenges.

SPKNL TP146 TP146 | 2 2
SPKNR TP147 TP147 | 1 1
SPKPR TP148 TP148 | 2 2

LS_D_CTRL 12V Buck-Boost Converter File: LM5176.kicad_sch

DC Motor Controller - Front Wheels File: DRV8701.kicad_sch DIR

TP110 | TP150 | 1 1
TP118 | | | 2 2

DC Motor Controller - Rear Wheels File: DRV8701.kicad_sch
FAULT SLEEP

TP112 TP112 STEERING_MOTOR_DIR | | TP152 | 1 1

Low Voltage Power Converters File: power_converters.kicad_sch

DC Motor Controller - Steering

TP120 TP120 STEERING_MOTOR_PWM

STEERING_MOTOR_OUT_B TP154 TP154 | 2

Geeks for Kids
Learn Science and Math Club
Sheet: /
File: geeks-ecu.kicad_sch
Title: Electronic Control Unit (ECU)

Size: USLedger | Rev: V1
KiCad E.D.A. 10.0.1 | Id: 1/9

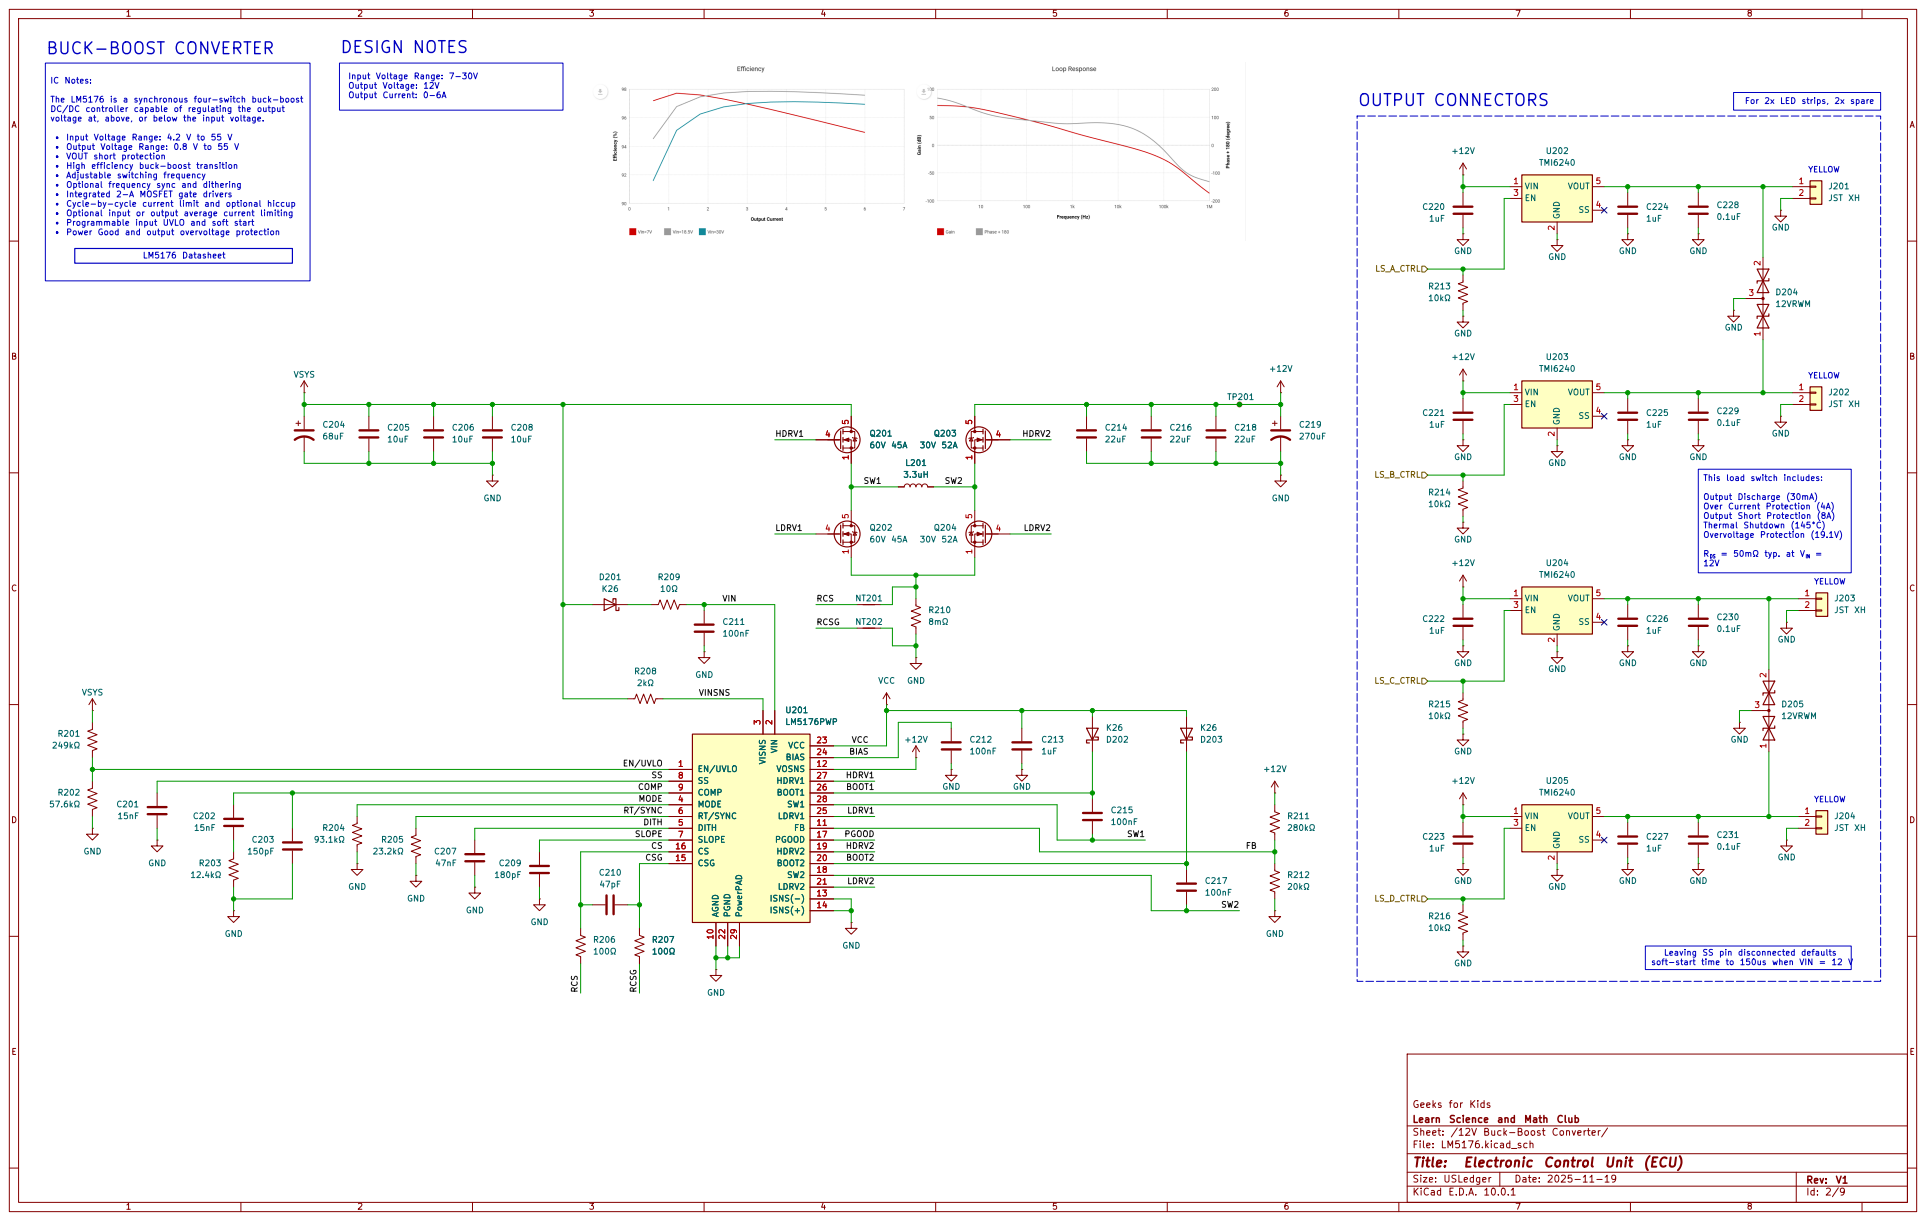
[picture p44: page 2]

YELLOW BUCK-BOOST CONVERTER

For 2x LED strips, 2x spare DESIGN NOTES

Input Voltage Range: 7-30V Output Voltage: 12V Output Current: 0-6A

IC Notes: The LM5176 is a synchronous four-switch buck-boost DC/DC controller capable of regulating the output

voltage at, above, or below the input voltage. • Input Voltage Range: 4.2 V to 55 V • Output Voltage Range: 0.8 V to 55 V • VOUT short protection • High efficiency buck-boost transition • Adjustable switching frequency • Optional frequency sync and dithering • Integrated 2-A MOSFET gate drivers • Cycle-by-cycle current limit and optional hiccup • Optional input or output average current limiting • Programmable input UVLO and soft start • Power Good and output overvoltage protection

This load switch includes: Output Discharge (30mA) Over Current Protection (4A)

Output Short Protection (8A) Thermal Shutdown (145°C)

Overvoltage Protection (19.1V) RDS = 50mΩ typ. at V IN =

3 MODE 4 DITH 5 RT/SYNC 6

Leaving SS pin disconnected defaults
soft-start time to 150us when VIN = 12 V

Learn Science and Math Club
Sheet: /12V Buck-Boost Converter/
File: LM5176.kicad_sch

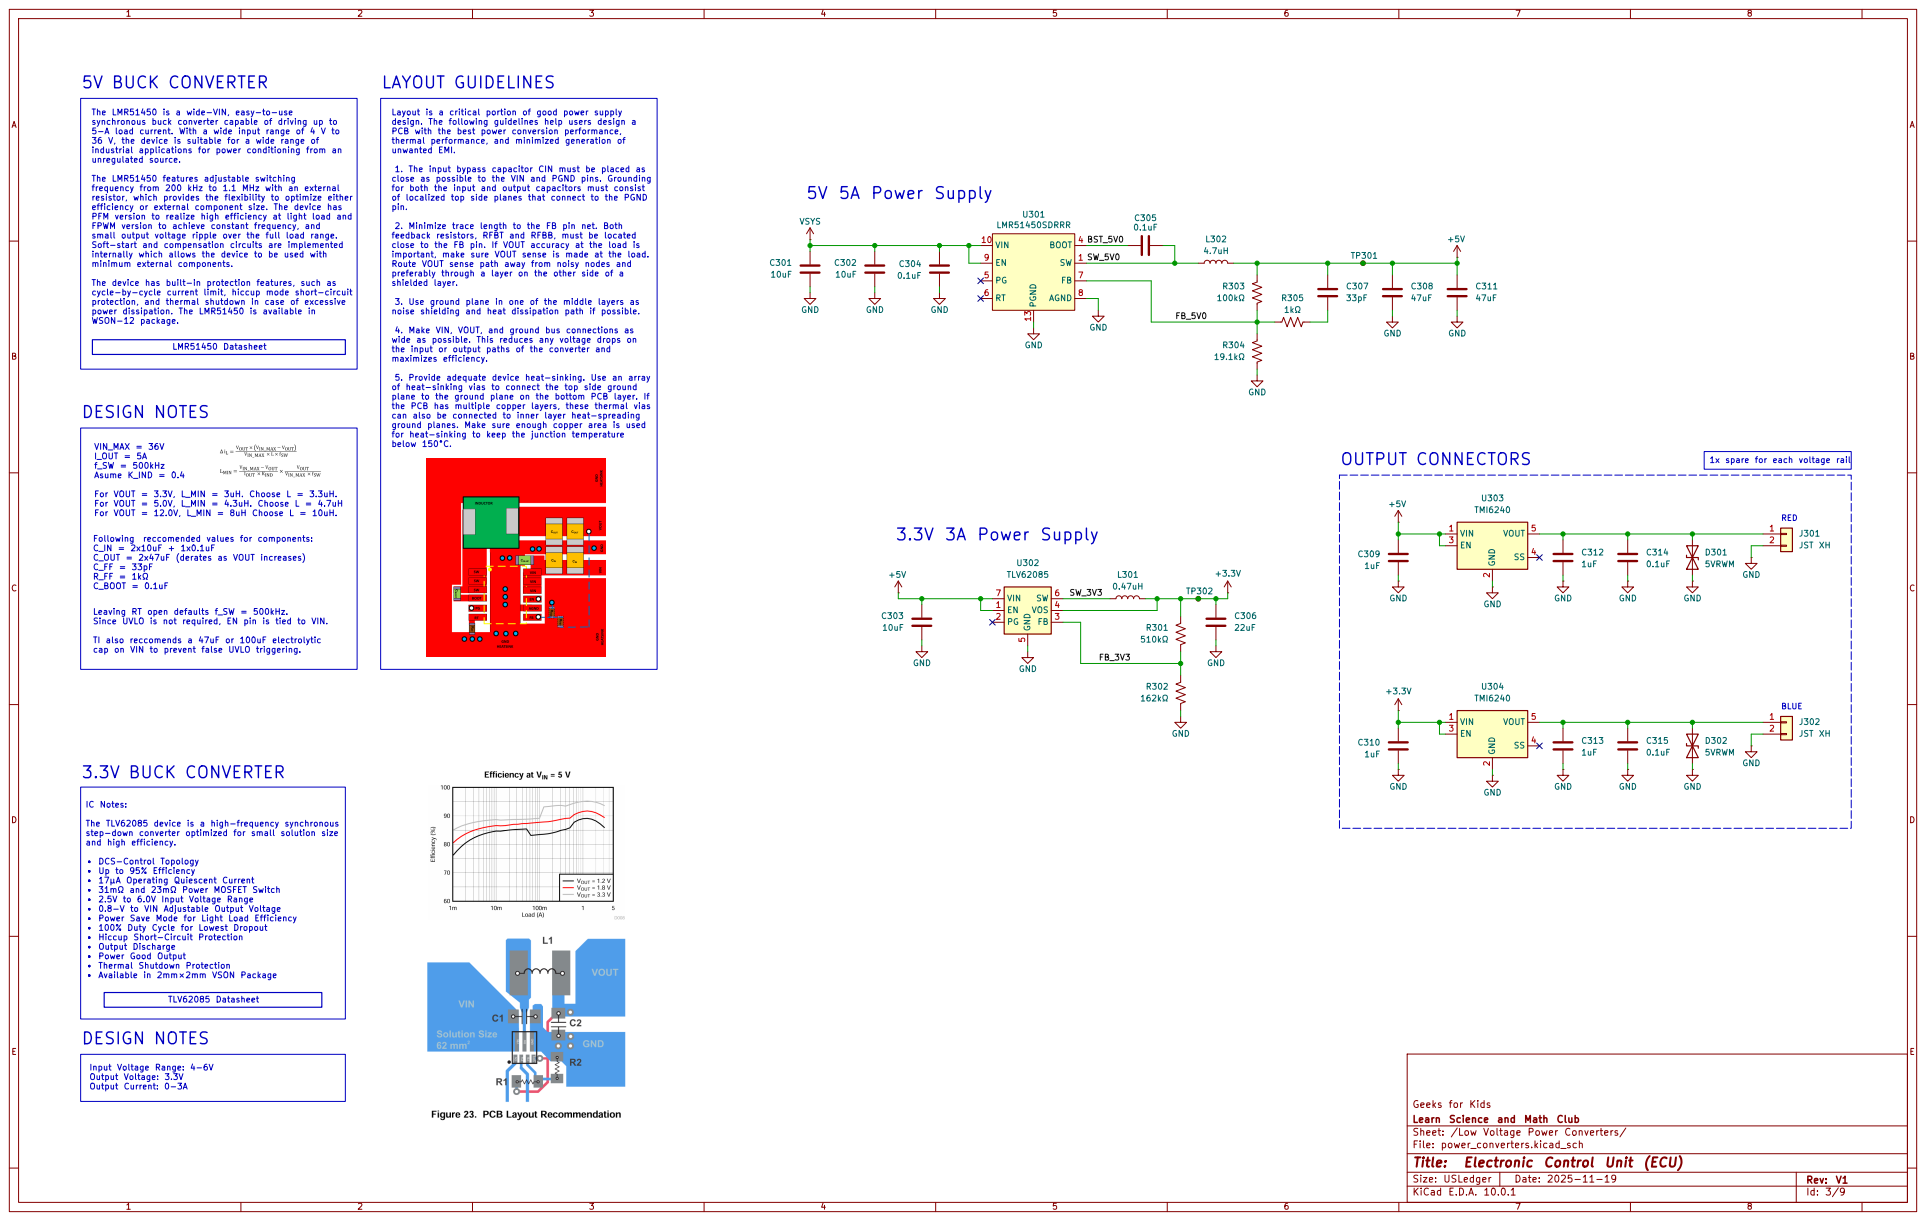
[picture p45: page 3]

BLUE RED LAYOUT GUIDELINES

The LMR51450 is a wide-VIN, easy-to-use
synchronous buck converter capable of driving up to 5-A load current. With a wide input range of 4 V to 36 V, the device is suitable for a wide range of

Layout is a critical portion of good power supply
design. The following guidelines help users design a PCB with the best power conversion performance, thermal performance, and minimized generation of unwanted EMI. 1. The input bypass capacitor CIN must be placed as close as possible to the VIN and PGND pins. Grounding

industrial applications for power conditioning from an
unregulated source. The LMR51450 features adjustable switching

frequency from 200 kHz to 1.1 MHz with an external resistor, which provides the flexibility to optimize either efficiency or external component size. The device has PFM version to realize high efficiency at light load and

for both the input and output capacitors must consist of localized top side planes that connect to the PGND

pin. 2. Minimize trace length to the FB pin net. Both

FPWM version to achieve constant frequency, and
small output voltage ripple over the full load range. Soft-start and compensation circuits are implemented

feedback resistors, RFBT and RFBB, must be located
close to the FB pin. If VOUT accuracy at the load is
important, make sure VOUT sense is made at the load. Route VOUT sense path away from noisy nodes and

internally which allows the device to be used with minimum external components. The device has built-in protection features, such as cycle-by-cycle current limit, hiccup mode short-circuit protection, and thermal shutdown in case of excessive power dissipation. The LMR51450 is available in WSON-12 package.

preferably through a layer on the other side of a
shielded layer. 3. Use ground plane in one of the middle layers as noise shielding and heat dissipation path if possible. 4. Make VIN, VOUT, and ground bus connections as wide as possible. This reduces any voltage drops on

the input or output paths of the converter and maximizes efficiency. 5. Provide adequate device heat-sinking. Use an array of heat-sinking vias to connect the top side ground

plane to the ground plane on the bottom PCB layer. If
the PCB has multiple copper layers, these thermal vias can also be connected to inner layer heat-spreading

For VOUT = 12.0V, L_MIN = 8uH Choose L = 10uH. DESIGN NOTES

ground planes. Make sure enough copper area is used
for heat-sinking to keep the junction temperature below 150°C.

1x spare for each voltage rail

For VOUT = 3.3V, L_MIN = 3uH. Choose L = 3.3uH. For VOUT = 5.0V, L_MIN = 4.3uH. Choose L = 4.7uH

Following reccomended values for components: C_IN = 2x10uF + 1x0.1uF C_OUT = 2x47uF (derates as VOUT increases) C_FF = 33pF R_FF = 1kΩ

Leaving RT open defaults f_SW = 500kHz. Since UVLO is not required, EN pin is tied to VIN.

TI also reccomends a 47uF or 100uF electrolytic cap on VIN to prevent false UVLO triggering.

IC Notes: The TLV62085 device is a high-frequency synchronous

step-down converter optimized for small solution size and high efficiency. • DCS-Control Topology • Up to 95% Efficiency • 17μA Operating Quiescent Current • 31mΩ and 23mΩ Power MOSFET Switch • 2.5V to 6.0V Input Voltage Range • 0.8-V to VIN Adjustable Output Voltage • Power Save Mode for Light Load Efficiency • 100% Duty Cycle for Lowest Dropout • Hiccup Short-Circuit Protection • Output Discharge • Power Good Output • Thermal Shutdown Protection • Available in 2mm×2mm VSON Package

Input Voltage Range: 4-6V Output Voltage: 3.3V Output Current: 0-3A

Geeks for Kids
Learn Science and Math Club
Sheet: /Low Voltage Power Converters/
File: power_converters.kicad_sch

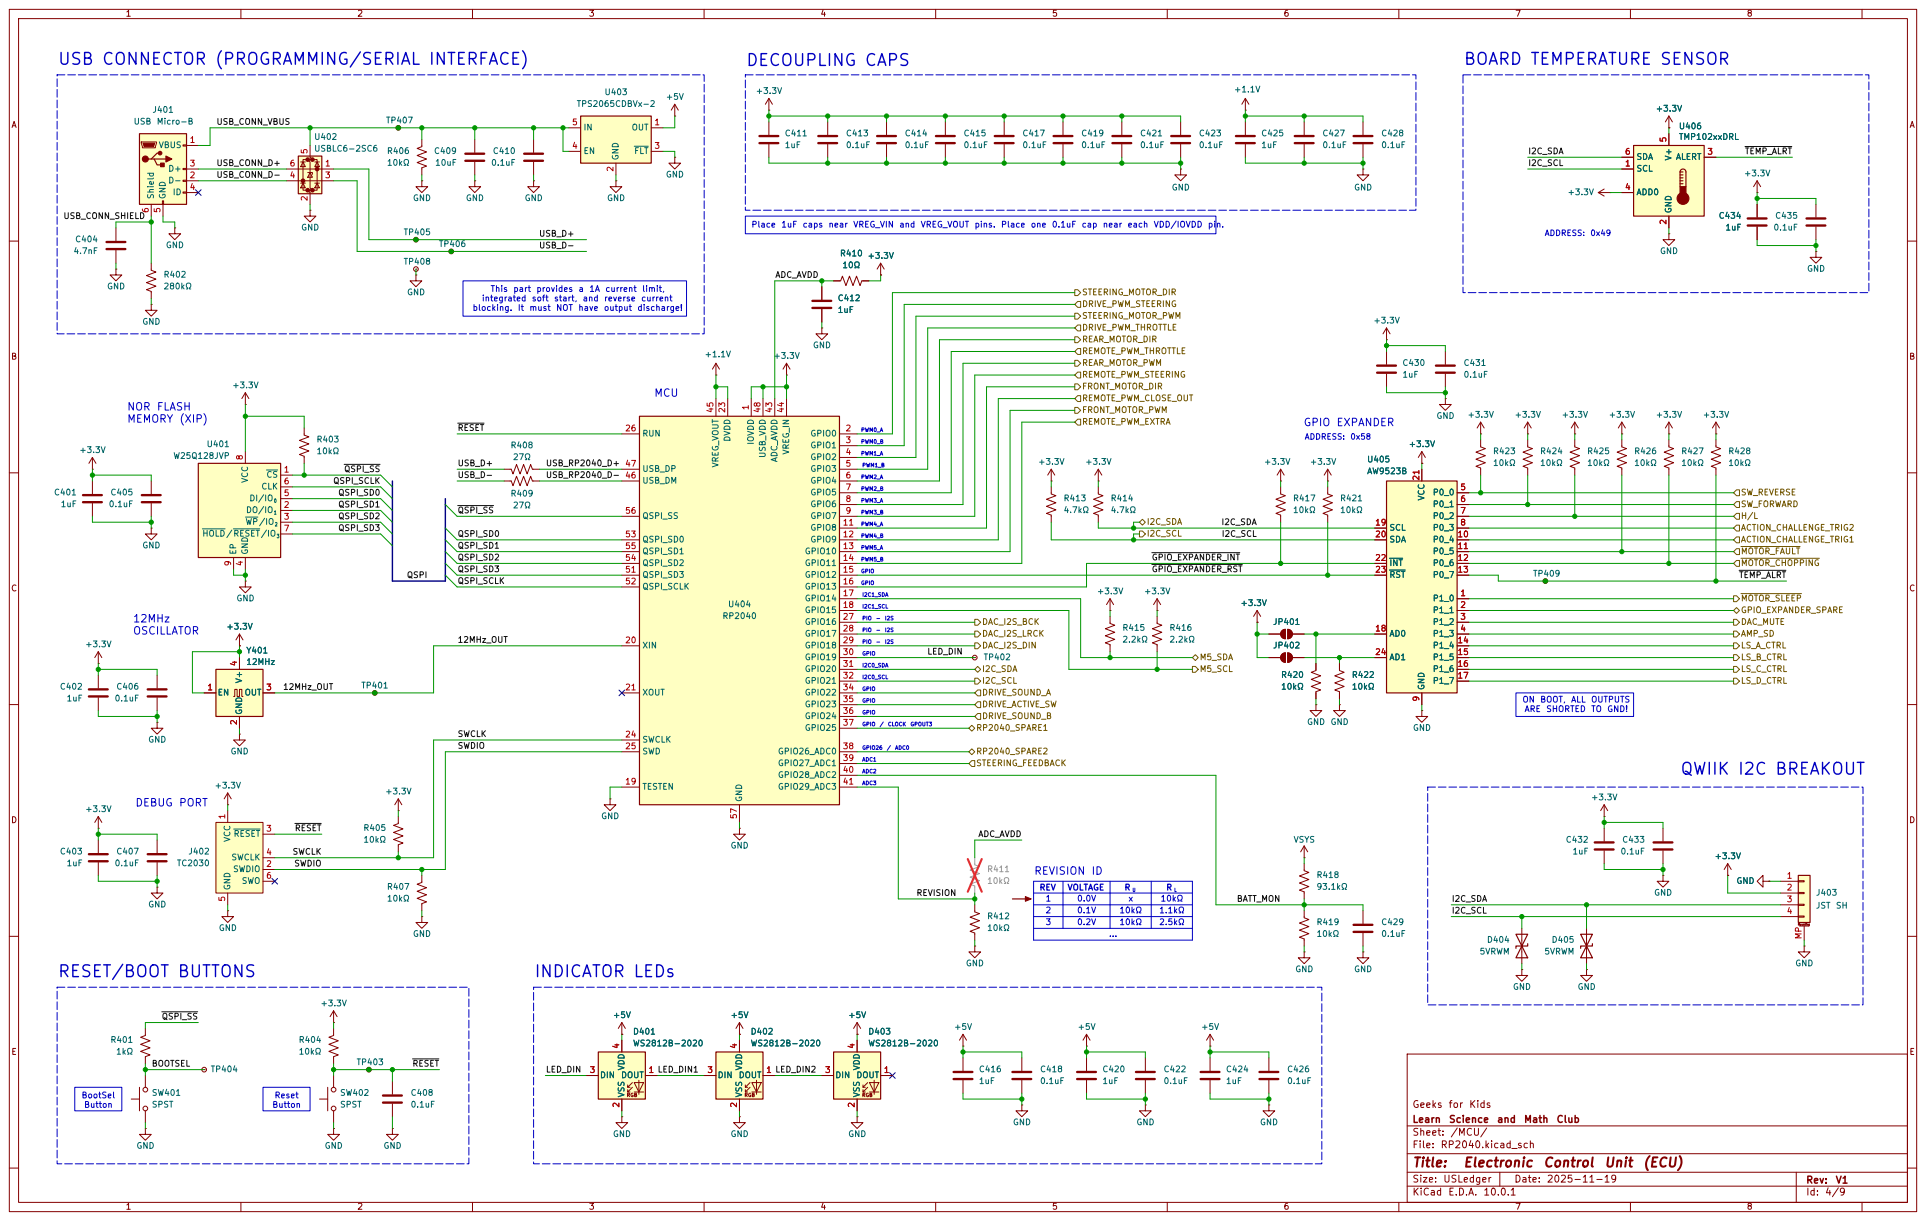
[picture p46: page 4]

USB CONNECTOR (PROGRAMMING/SERIAL INTERFACE)

This part provides a 1A current limit,

4 DI/IO0 5 CLK 6 HOLD/RESET/IO3 7 VCC

INT 22 RST 23

ARE SHORTED TO GND! Reset Button BootSel Button

2 | 0.1V | 10kΩ | 1.1kΩ
3 | 0.2V | 10kΩ | 2.5kΩ

Geeks for Kids
Learn Science and Math Club
Sheet: /MCU/
File: RP2040.kicad_sch

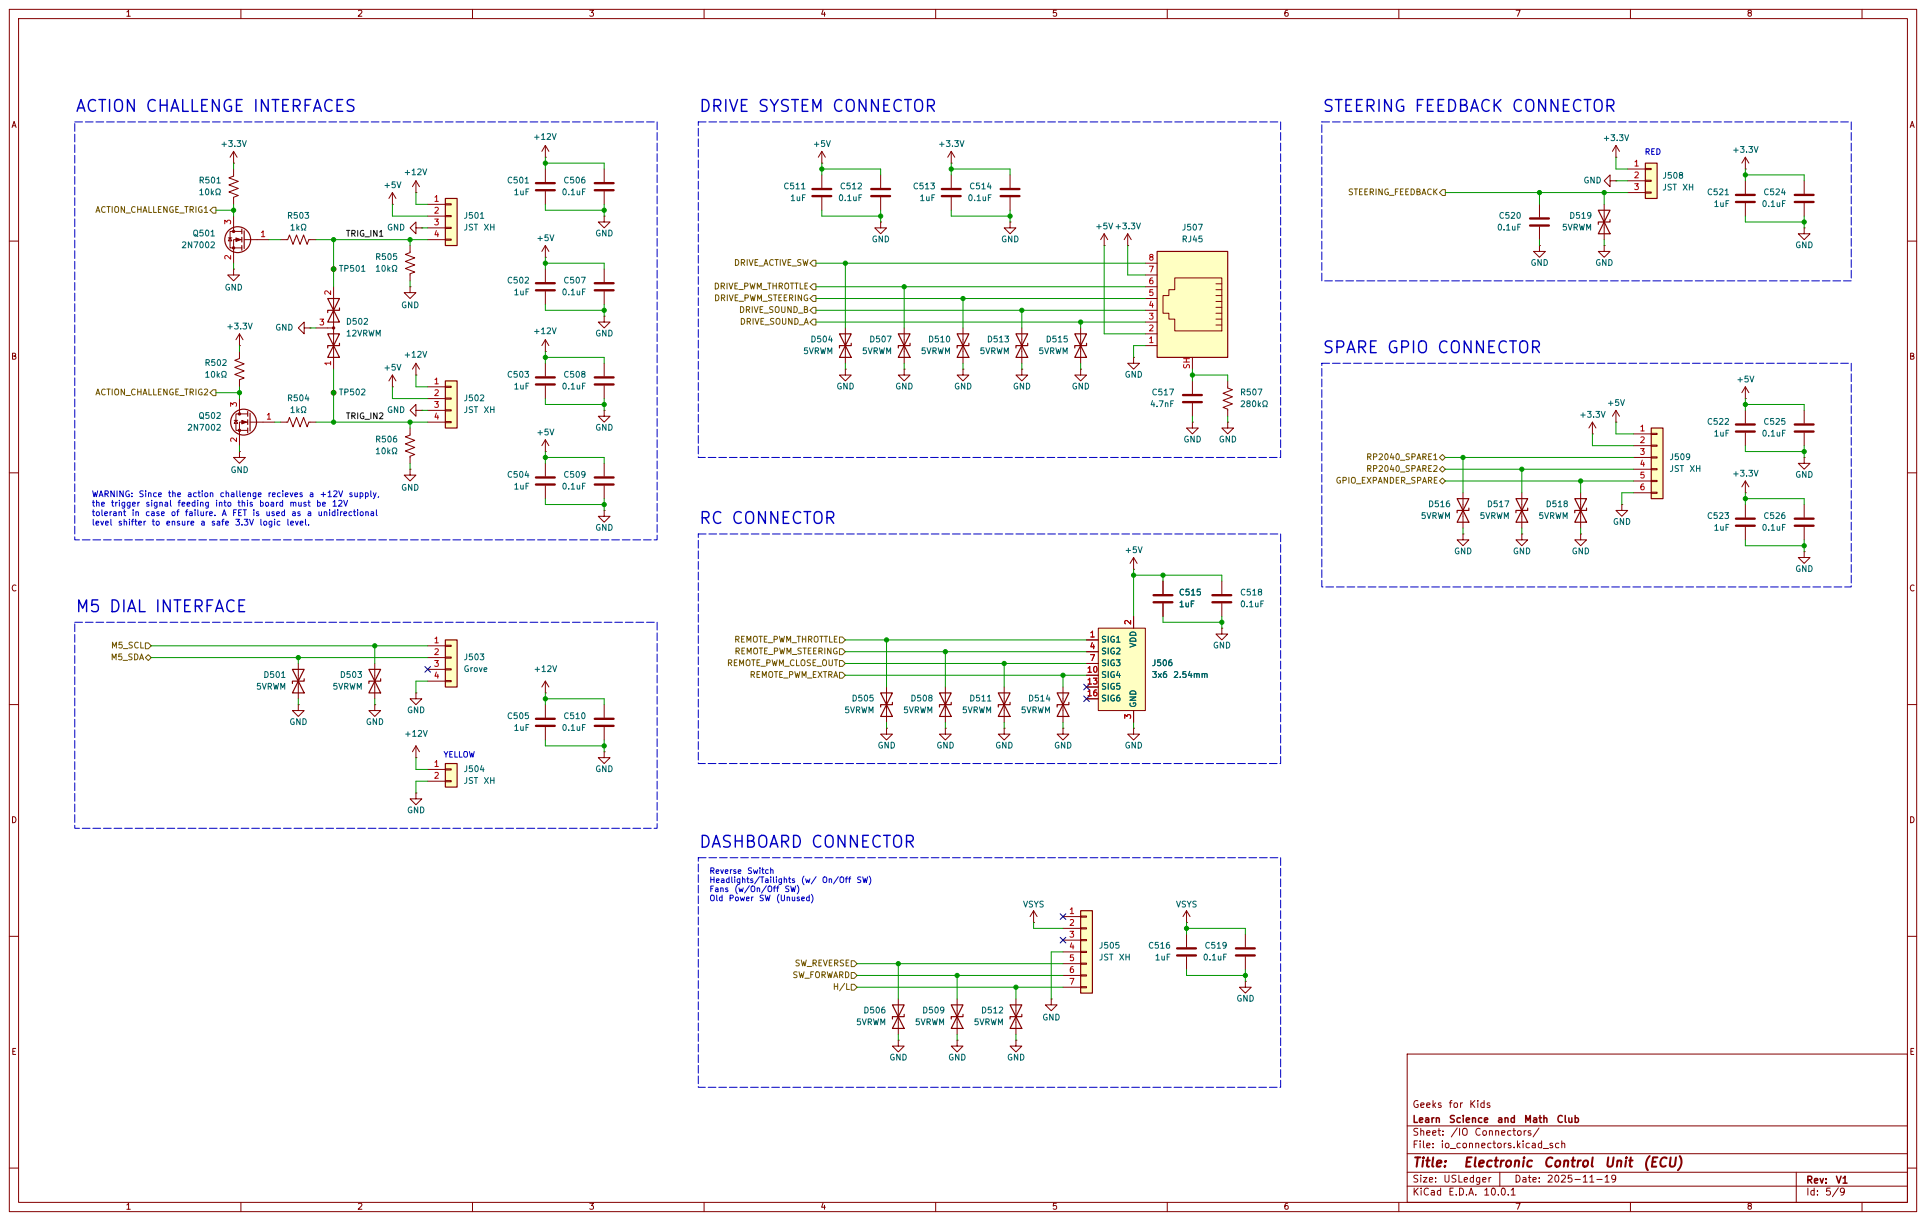
[picture p47: page 5]

WARNING: Since the action challenge recieves a +12V supply,
the trigger signal feeding into this board must be 12V
tolerant in case of failure. A FET is used as a unidirectional

SIG3 7
SIG4 10

Reverse Switch Headlights/Tailights (w/ On/Off SW) Fans (w/On/Off SW) Old Power SW (Unused)

Geeks for Kids
Learn Science and Math Club
Sheet: /IO Connectors/
File: io_connectors.kicad_sch

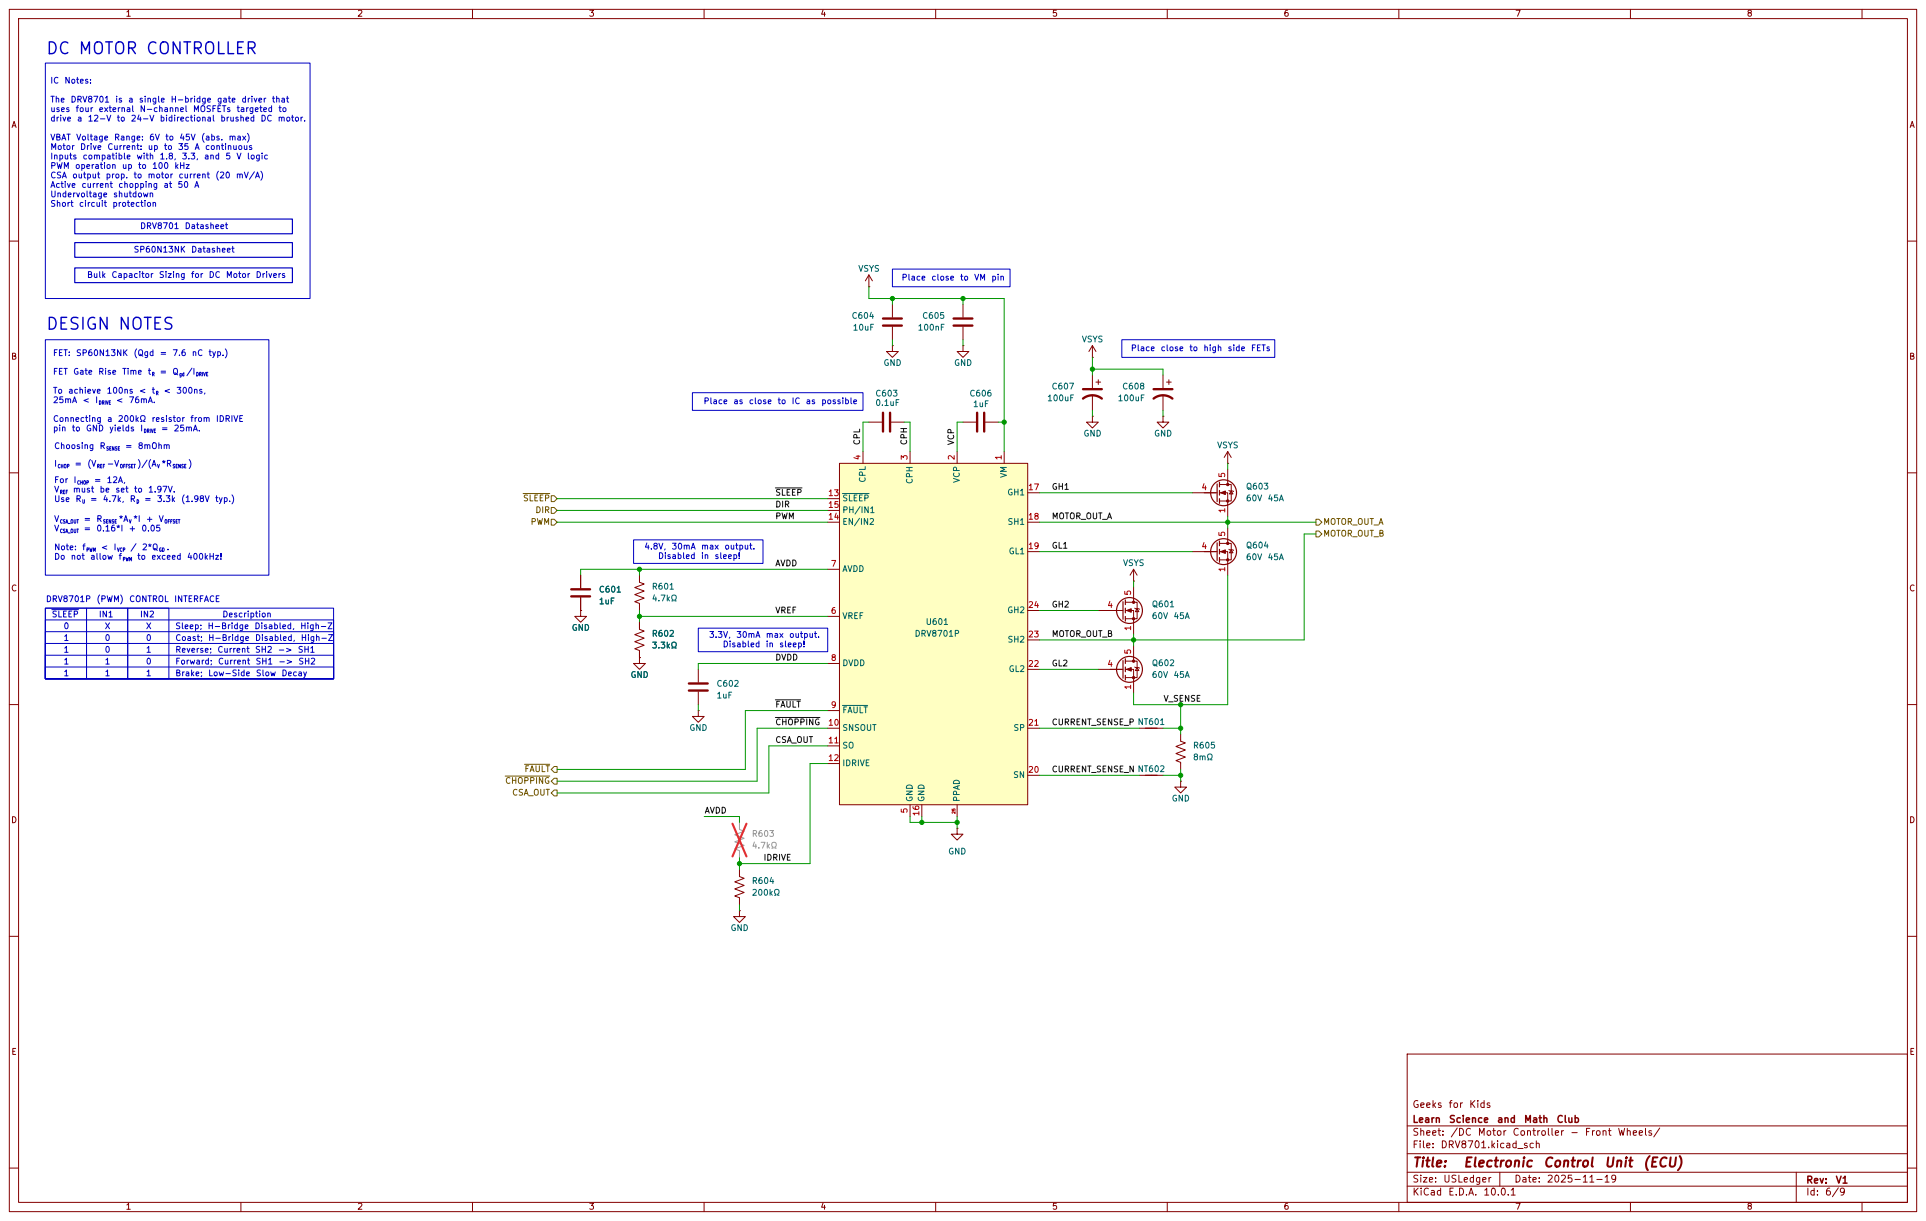
[picture p48: page 6]

IC Notes: The DRV8701 is a single H-bridge gate driver that uses four external N-channel MOSFETs targeted to

drive a 12-V to 24-V bidirectional brushed DC motor. VBAT Voltage Range: 6V to 45V (abs. max) Motor Drive Current: up to 35 A continuous

FET: SP60N13NK (Qgd = 7.6 nC typ.) FET Gate Rise Time t R = Qgd /I DRIVE To achieve 100ns < t R < 300ns, 25mA < I DRIVE < 76mA. DESIGN NOTES

Connecting a 200kΩ resistor from IDRIVE pin to GND yields I DRIVE = 25mA. V CSA_OUT = RSENSE *A V *I + V OFFSET V CSA_OUT = 0.16*I + 0.05

For I CHOP = 12A, V REF must be set to 1.97V. Use R U = 4.7k, RD = 3.3k (1.98V typ.)

1 Note: f PWM < I VCP / 2*QGD . Do not allow f PWM to exceed 400kHz!

0 | X | X | Forward; Current SH1 -> SH2 Brake; Low-Side Slow Decay DRV8701P (PWM) CONTROL INTERFACE 1 Sleep; H-Bridge Disabled, High-Z
SLEEP 1 | 0 | 0 | Description 1 Coast; H-Bridge Disabled, High-Z

0 | | Reverse; Current SH2 -> SH1

Learn Science and Math Club
Sheet: /DC Motor Controller - Front Wheels/
File: DRV8701.kicad_sch

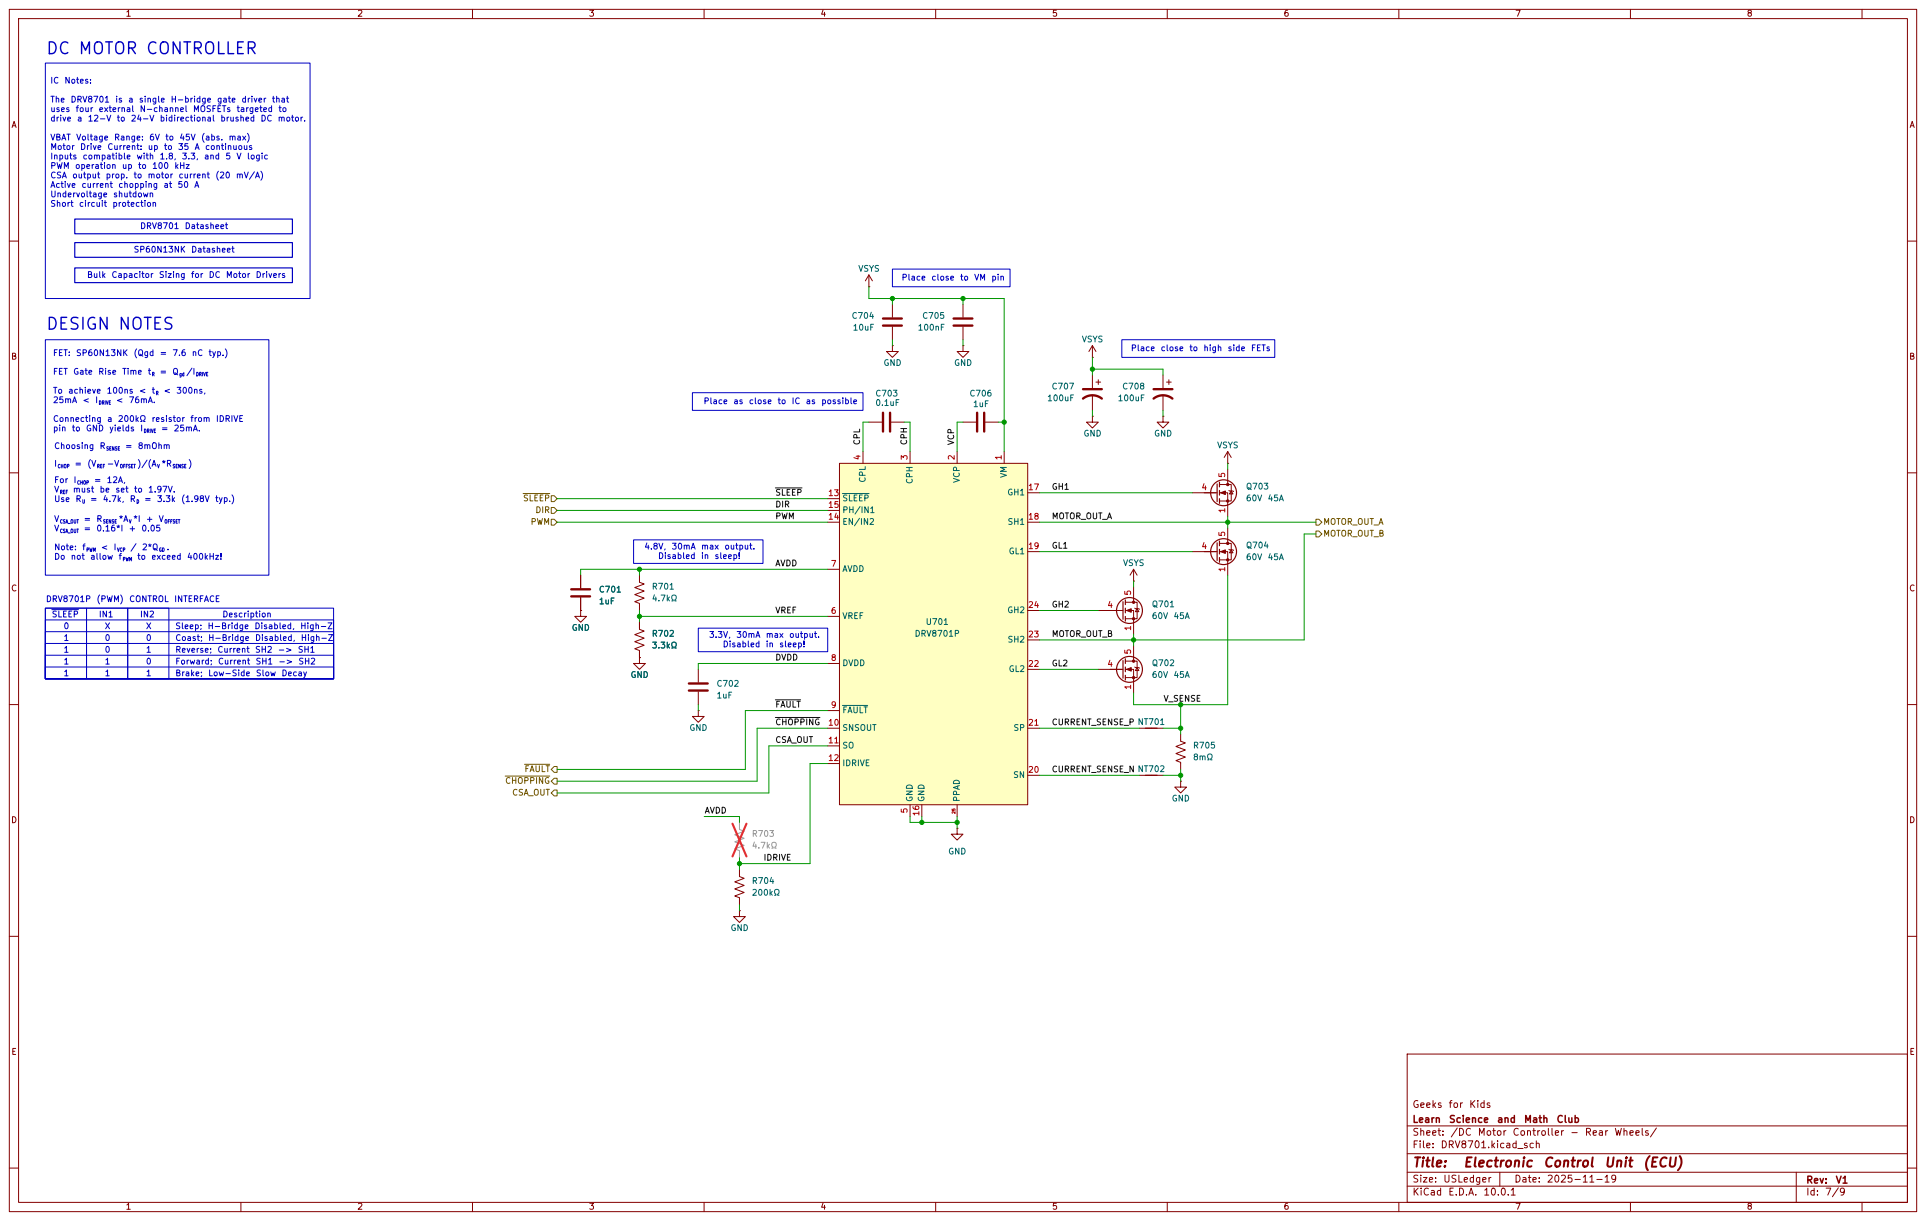
[picture p49: page 7]
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

1 Note: f PWM < I VCP / 2*QGD . Do not allow f PWM to exceed 400kHz!

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

0 | | Reverse; Current SH2 -> SH1

Learn Science and Math Club
Sheet: /DC Motor Controller - Rear Wheels/
File: DRV8701.kicad_sch

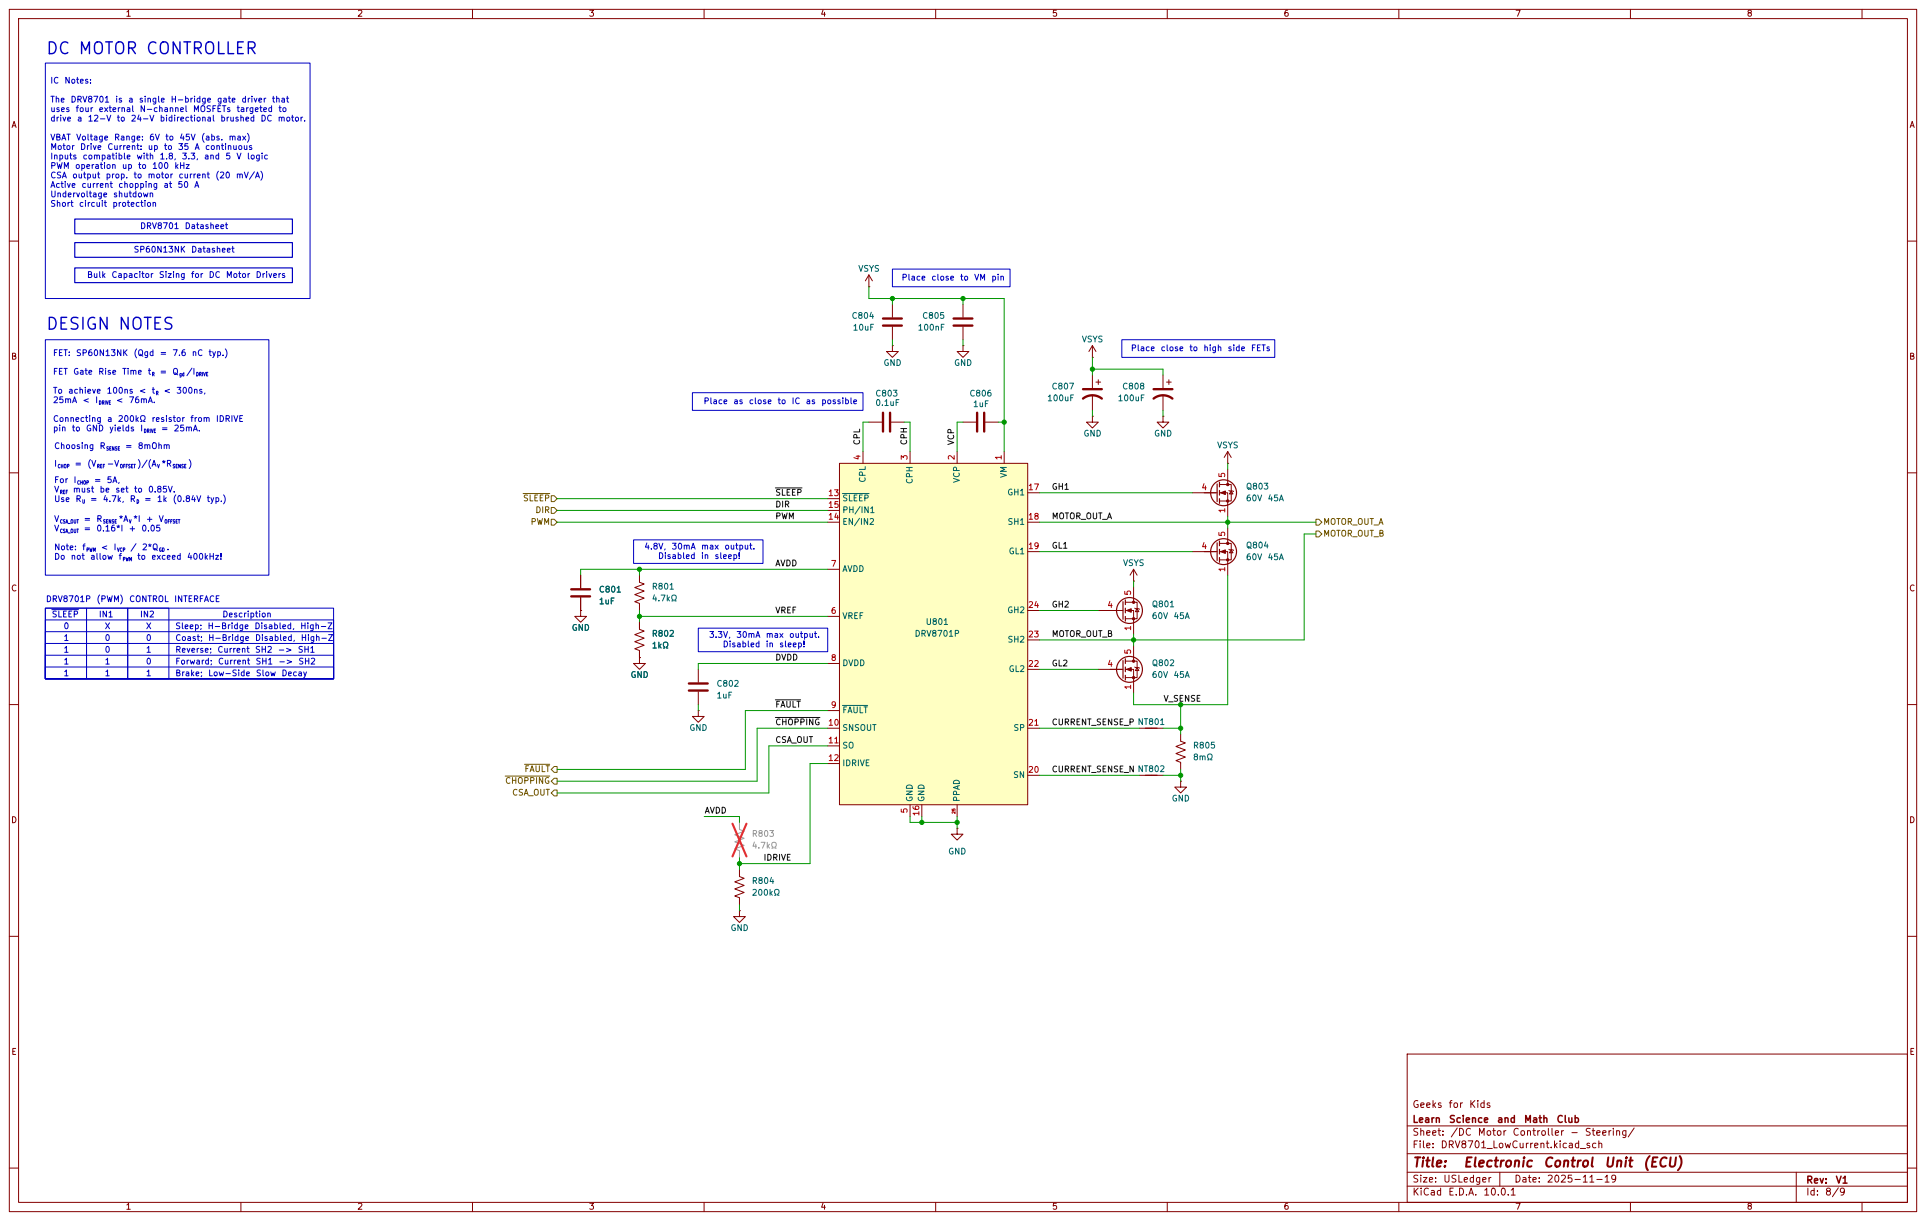
[picture p50: page 8]
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

V CSA_OUT = RSENSE *A V *I + V OFFSET V CSA_OUT = 0.16*I + 0.05 Note: f PWM < I VCP / 2*QGD . Do not allow f PWM to exceed 400kHz! DESIGN NOTES

FET: SP60N13NK (Qgd = 7.6 nC typ.) 0

I CHOP = (V REF -V OFFSET )/(A V *RSENSE )
For I CHOP = 5A, V REF must be set to 0.85V. Use R U = 4.7k, RD = 1k (0.84V typ.) 1

4.8V, 30mA max output. Disabled in sleep!

SLEEP | IN1 | IN2
0 | X | X | Sleep; H-Bridge Disabled, High-Z

Reverse; Current SH2 -> SH1 Coast; H-Bridge Disabled, High-Z

3.3V, 30mA max output. Disabled in sleep!

1 | | 0 | Forward; Current SH1 -> SH2 Brake; Low-Side Slow Decay

Geeks for Kids
Learn Science and Math Club
Sheet: /DC Motor Controller - Steering/
File: DRV8701_LowCurrent.kicad_sch

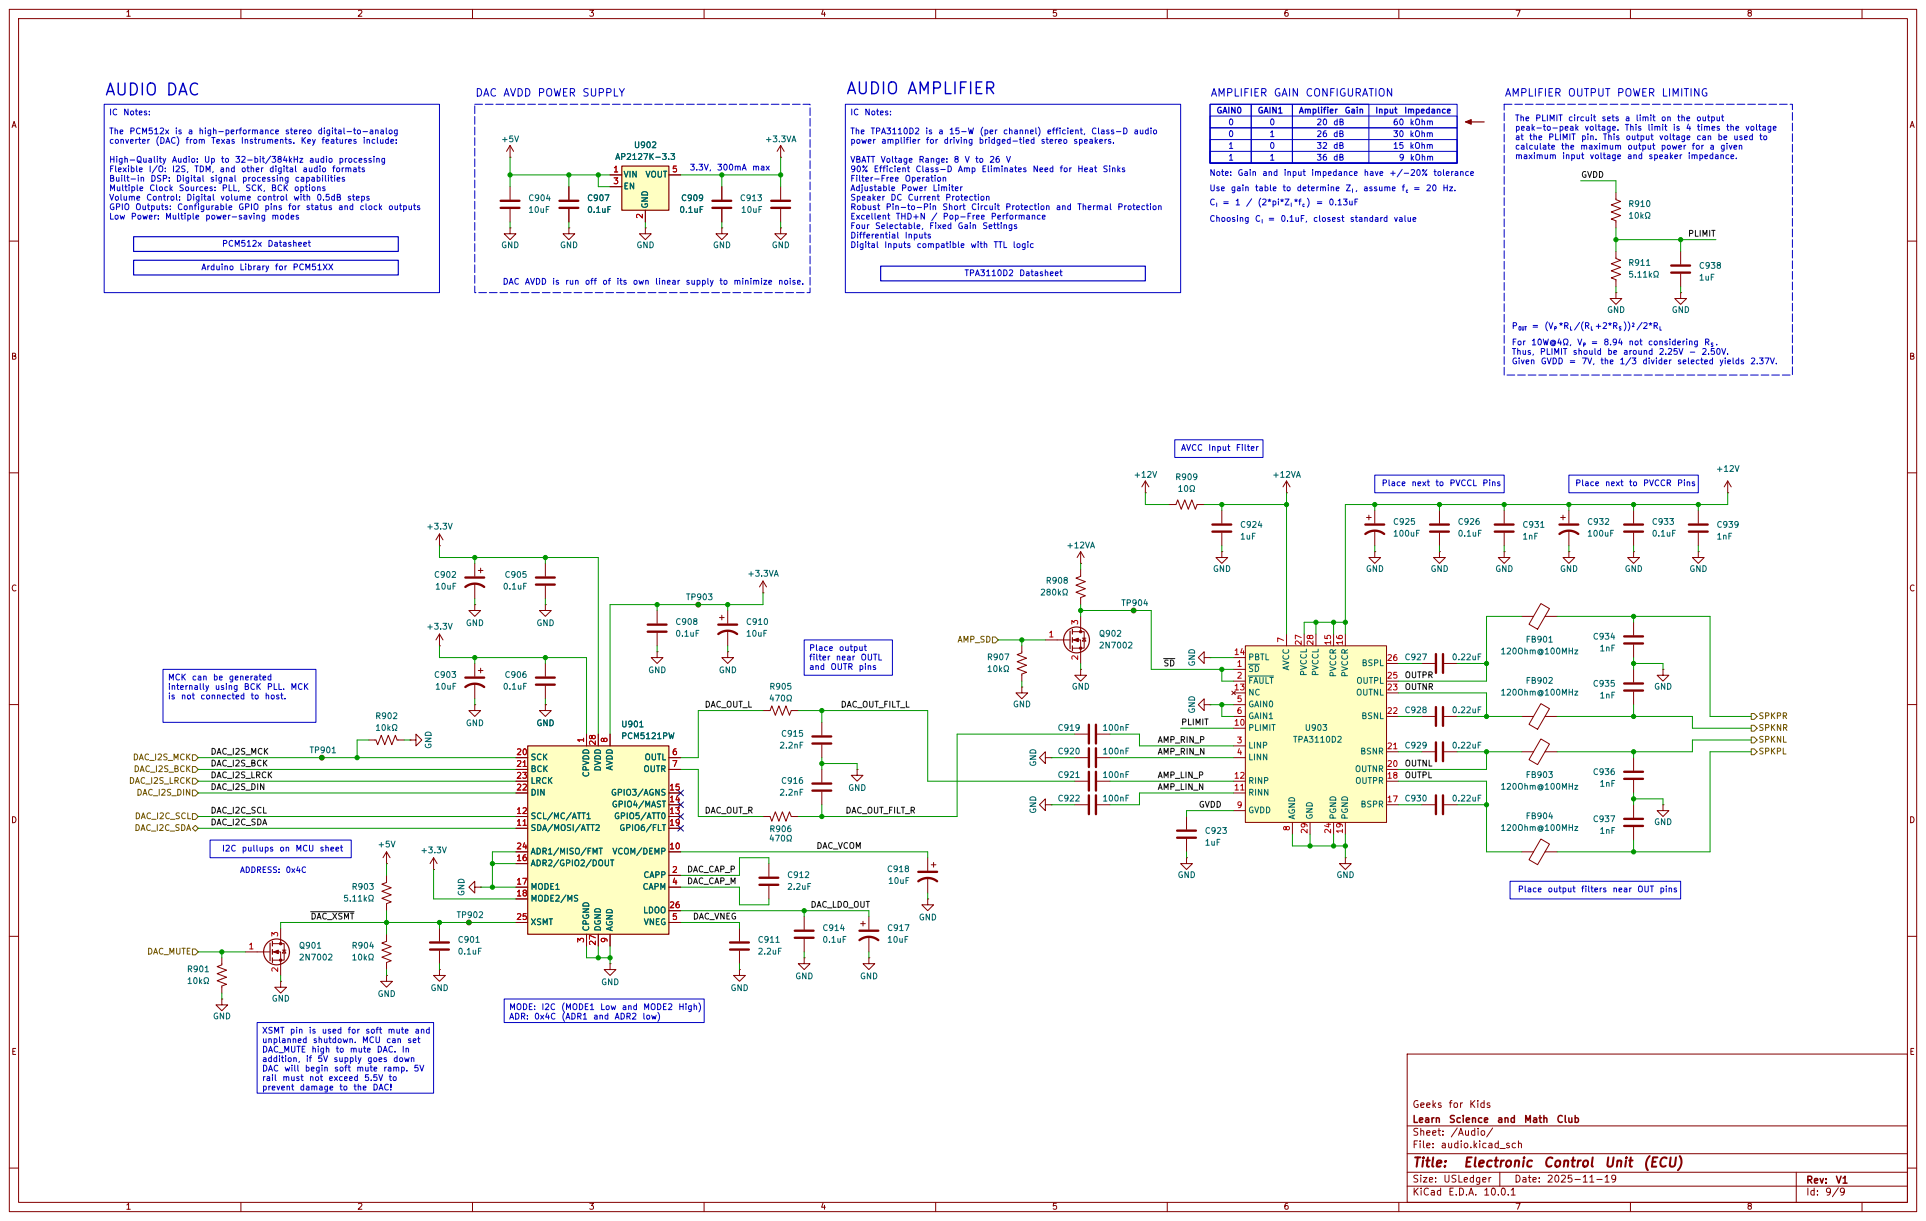
[picture p51: page 9]

36 dB DAC AVDD POWER SUPPLY
0.1uF GND

2 /2*RL 9 kOhm AUDIO AMPLIFIER
+3.3VA GND

Thus, PLIMIT should be around 2.25V - 2.50V. Given GVDD = 7V, the 1/3 divider selected yields 2.37V. AMPLIFIER GAIN CONFIGURATION

IC Notes: The PCM512x is a high-performance stereo digital-to-analog

IC Notes: The TPA3110D2 is a 15-W (per channel) efficient, Class-D audio

The PLIMIT circuit sets a limit on the output
peak-to-peak voltage. This limit is 4 times the voltage at the PLIMIT pin. This output voltage can be used to

converter (DAC) from Texas Instruments. Key features include: High-Quality Audio: Up to 32-bit/384kHz audio processing

power amplifier for driving bridged-tied stereo speakers. VBATT Voltage Range: 8 V to 26 V 90% Efficient Class-D Amp Eliminates Need for Heat Sinks Filter-Free Operation

calculate the maximum output power for a given maximum input voltage and speaker impedance. PCM512x Datasheet MCK can be generated

Flexible I/O: I2S, TDM, and other digital audio formats Built-in DSP: Digital signal processing capabilities

Multiple Clock Sources: PLL, SCK, BCK options Volume Control: Digital volume control with 0.5dB steps GPIO Outputs: Configurable GPIO pins for status and clock outputs

Adjustable Power Limiter Speaker DC Current Protection Robust Pin-to-Pin Short Circuit Protection and Thermal Protection

Low Power: Multiple power-saving modes

Excellent THD+N / Pop-Free Performance
Four Selectable, Fixed Gain Settings Differential Inputs

Choosing CI = 0.1uF, closest standard value

Digital Inputs compatible with TTL logic

For 10W@4Ω, V P = 8.94 not considering RS .

8 GVDD 9 PLIMIT 10 RINN 11 RINP 12 NC 13 PBTL 14 PVCCR 15 PVCCR 16 BSPR 17 OUTPR 18 PGND 19 OUTNR 20 BSNR 21 BSNL 22 OUTNL 23 PGND 24 OUTPL 25 BSPL 26 PVCCL 27 PVCCL 28 GND 29 U903

internally using BCK PLL. MCK
is not connected to host.

SCK 20 BCK 21 DIN 22 LRCK 23

I2C pullups on MCU sheet

Place output filters near OUT pins

MODE: I2C (MODE1 Low and MODE2 High) ADR: 0x4C (ADR1 and ADR2 low)

unplanned shutdown. MCU can set DAC_MUTE high to mute DAC. In

addition, if 5V supply goes down DAC will begin soft mute ramp. 5V

rail must not exceed 5.5V to
prevent damage to the DAC!

Geeks for Kids
Learn Science and Math Club
Sheet: /Audio/
File: audio.kicad_sch
