synthesissolutions/geeksforkids/hardware/Evaluation and Test Boards/motor-controller-v3/motor-controller-v3_PCB.pdf

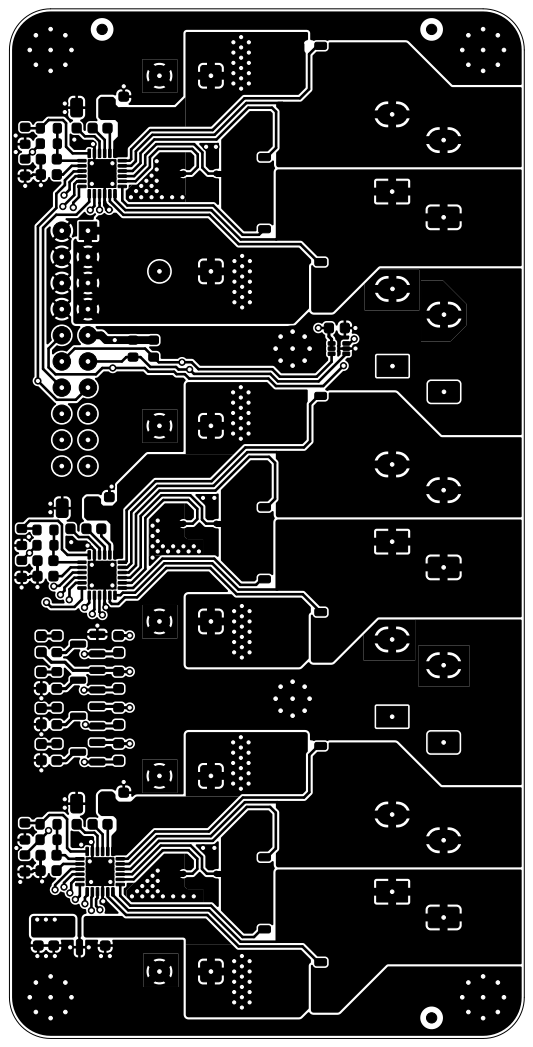
[picture p52: page 1]

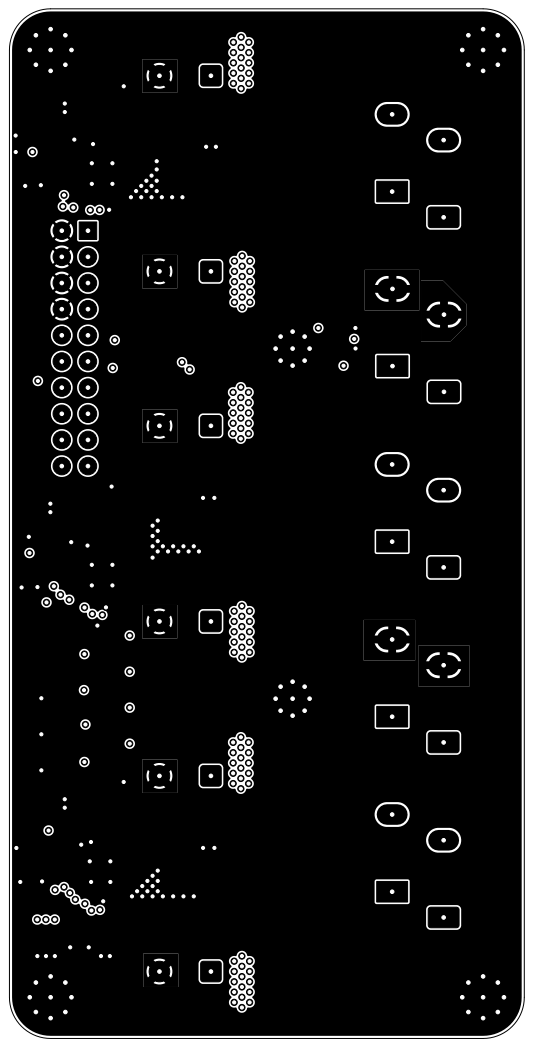
[picture p53: page 2]

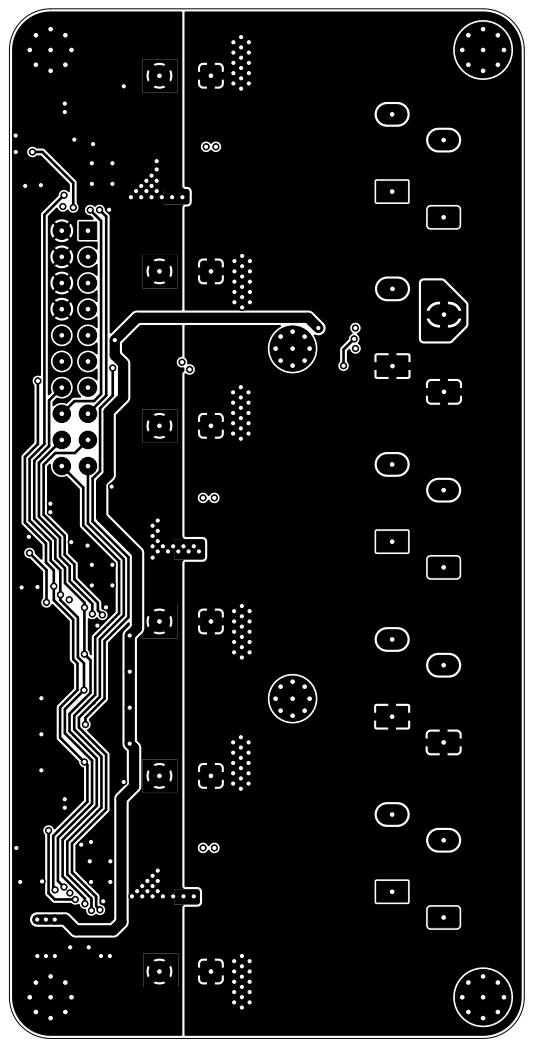
[picture p54: page 3]

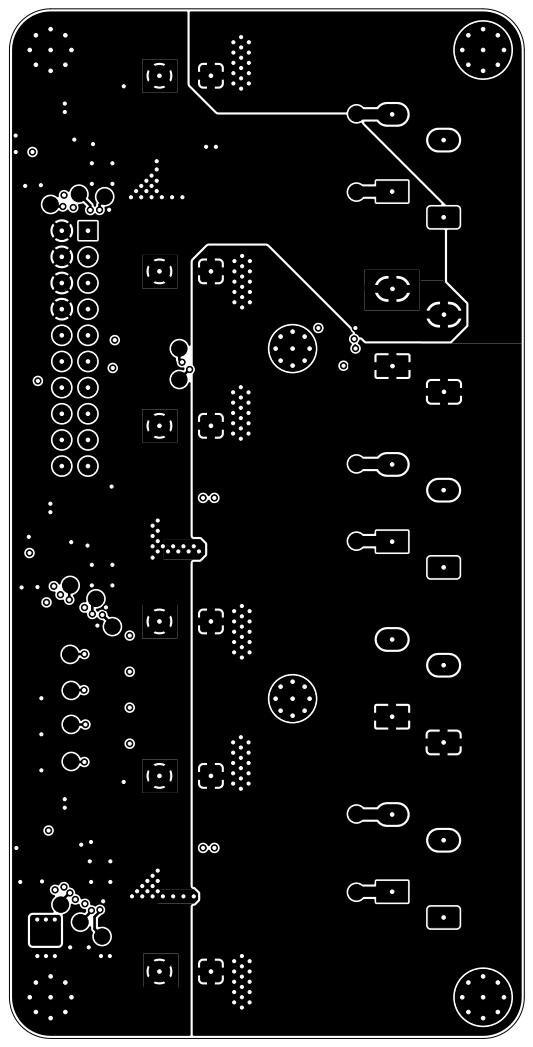
[picture p55: page 4]

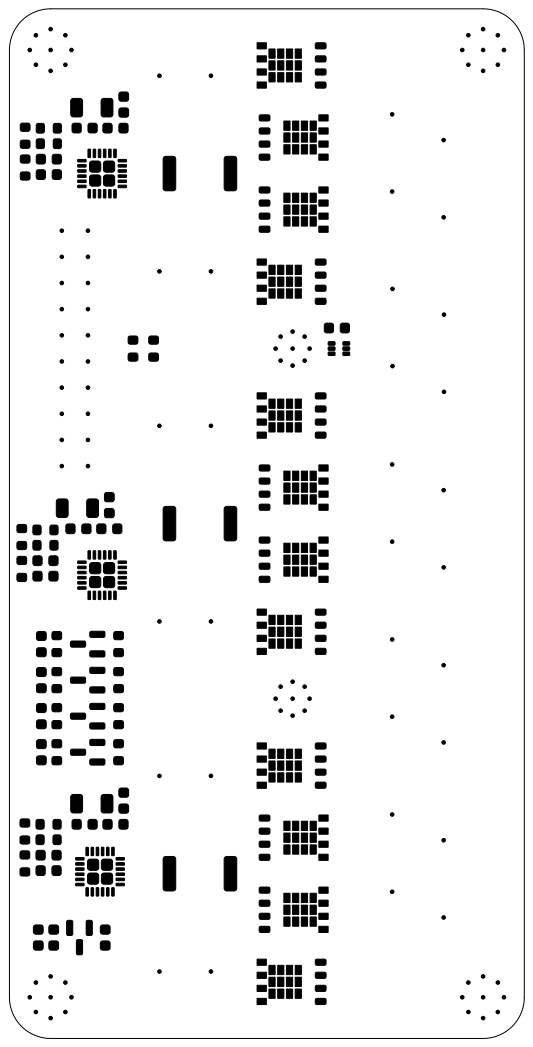
[picture p56: page 5]

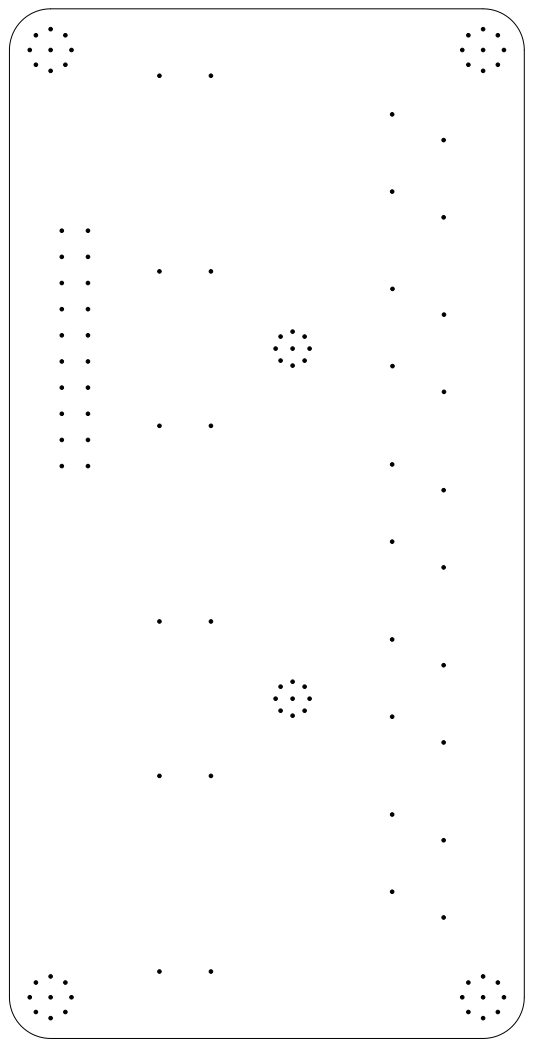
[picture p57: page 6]

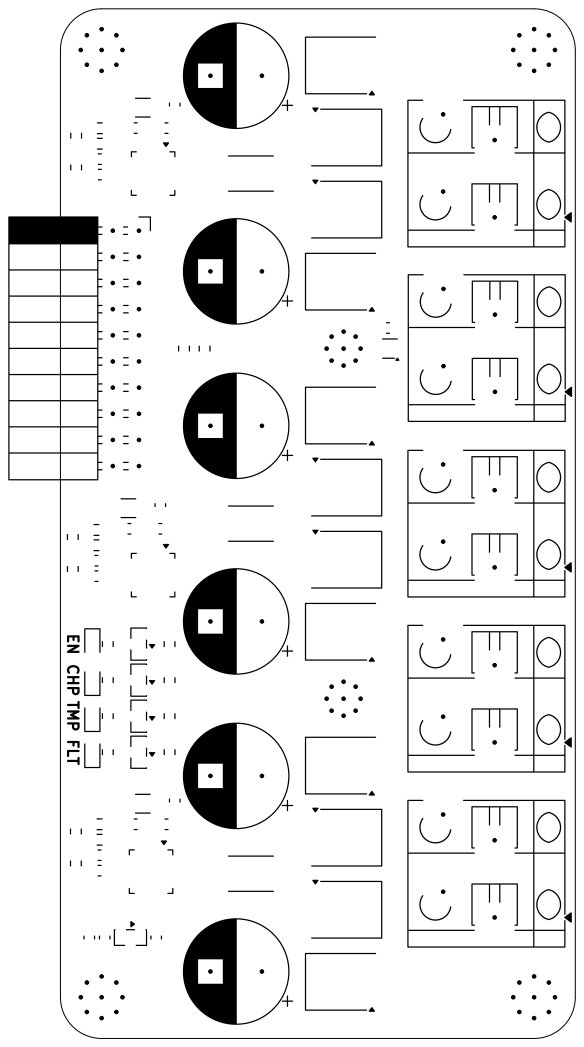
[picture p58: page 7]

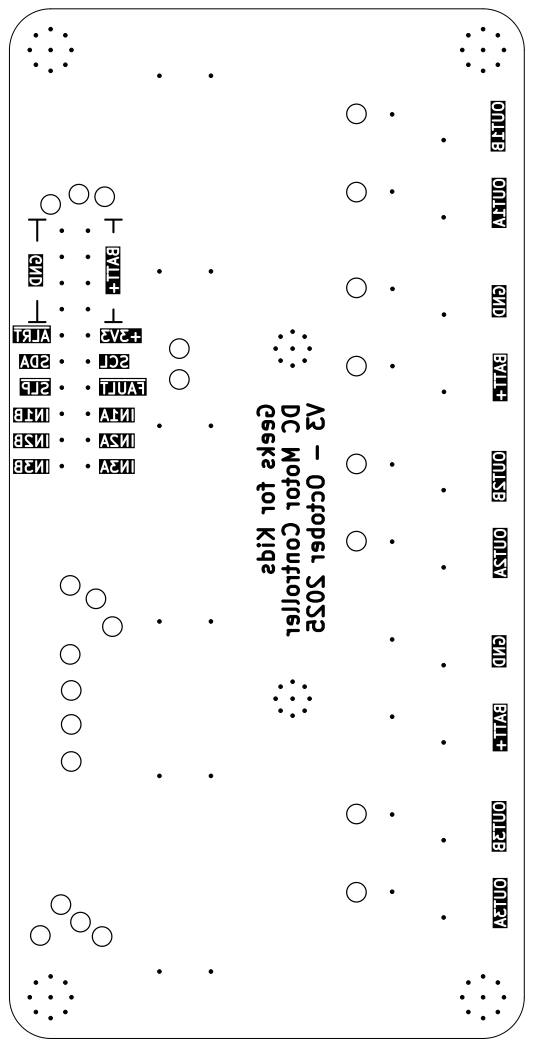
[picture p59: page 8]

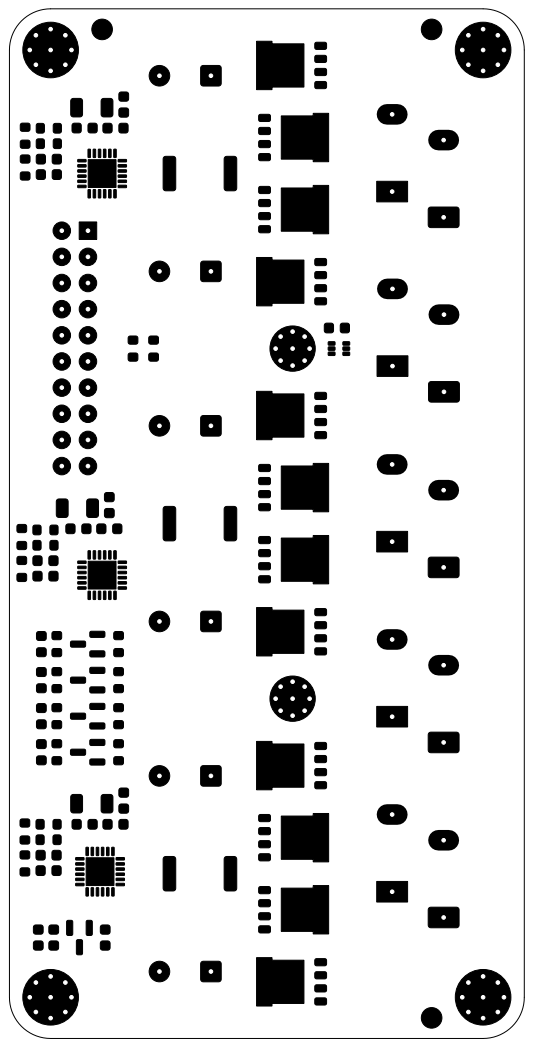
[picture p60: page 9]

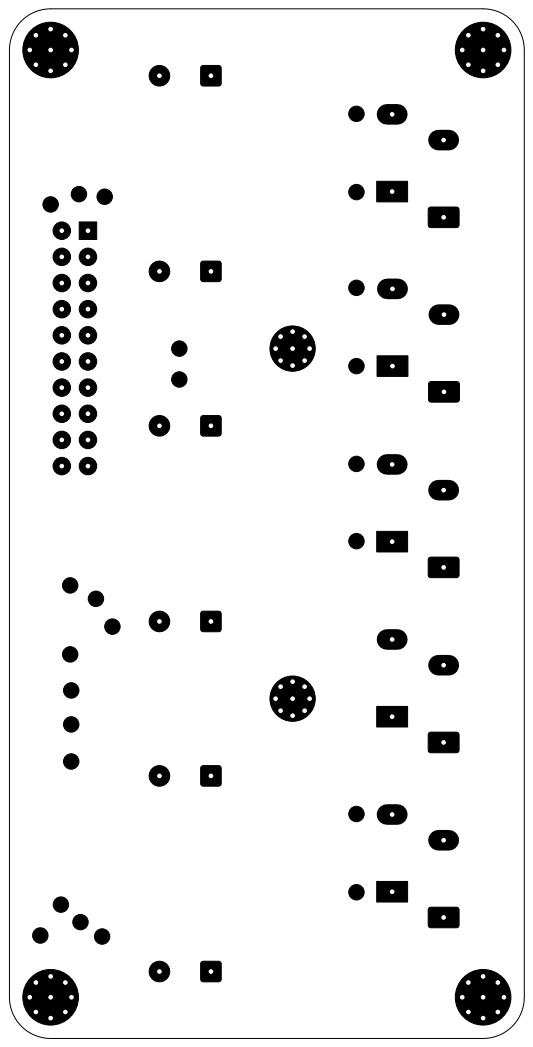
[picture p61: page 10]

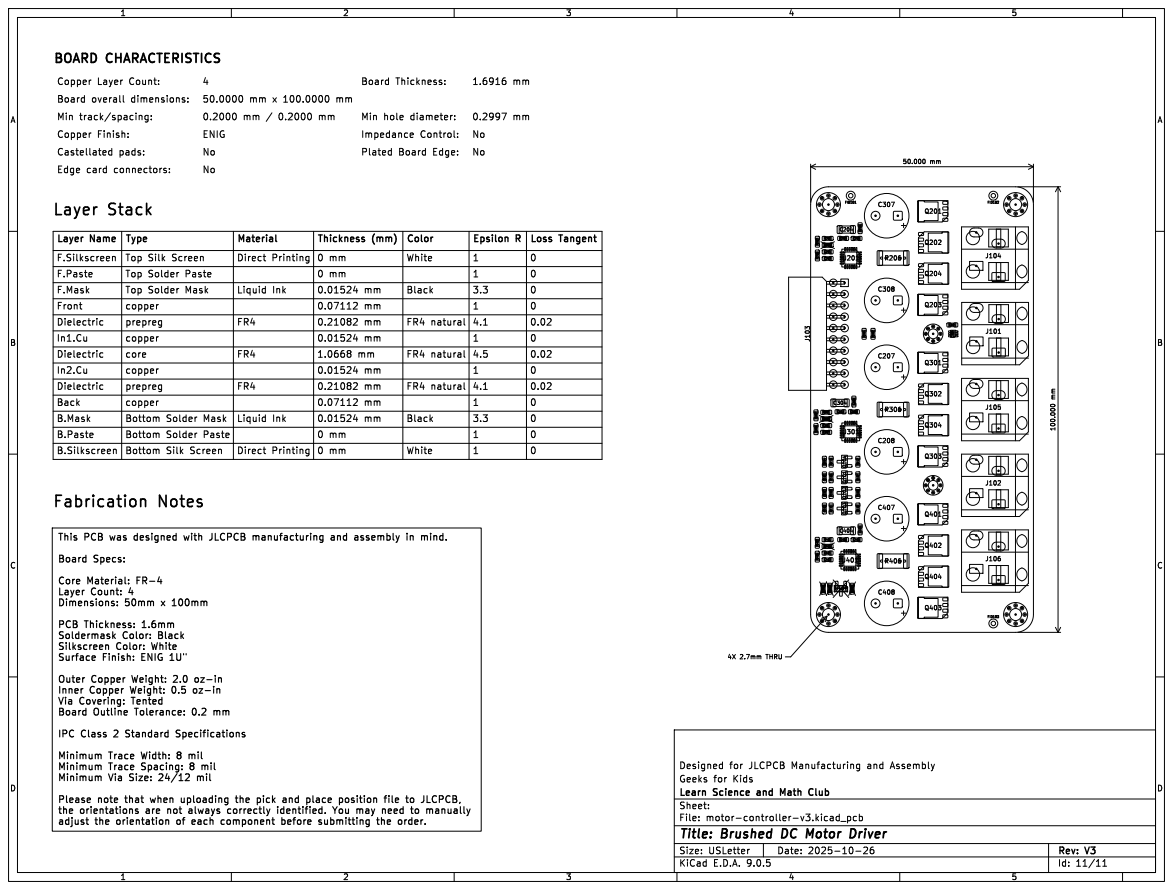
[picture p62: page 11]

Edge card connectors: Layer Name | prepreg Layer Stack Type | 0.21082 mm | Color | Epsilon R | 0.02 F.Mask B.Paste Copper Finish:

Material Back | Thickness (mm) 0.07112 mm | | White
Notes Screen Fabrication | | 0.01524 mm | | | 0 Top Silk

Screen | | 0.21082 mm | | | | | 0 Bottom Silk

0 mm
0 mm | | 0
0.01524 mm

In2.Cu | copper B.Silkscreen | | | 0.01524 mm | | 1 | 0
FR4 natural | 1 Dielectric | 0

core | | 1.0668 mm | | 4.5

B.Mask | prepreg | | | | 1 | 0

Bottom Solder Paste Bottom Solder Mask | | 0.01524 mm | | | 3.3 | 0

0 mm | | | 1
0 mm | | | 0

Core Material: FR-4 Layer Count: 4 Dimensions: 50mm x 100mm

PCB Thickness: 1.6mm
Soldermask Color: Black Silkscreen Color: White Surface Finish: ENIG 1U" Outer Copper Weight: 2.0 oz-in

Inner Copper Weight: 0.5 oz-in Via Covering: Tented Board Outline Tolerance: 0.2 mm
