synthesissolutions/geeksforkids/hardware/Evaluation and Test Boards/motor-controller-v3/motor-controller-v3_SCM.pdf

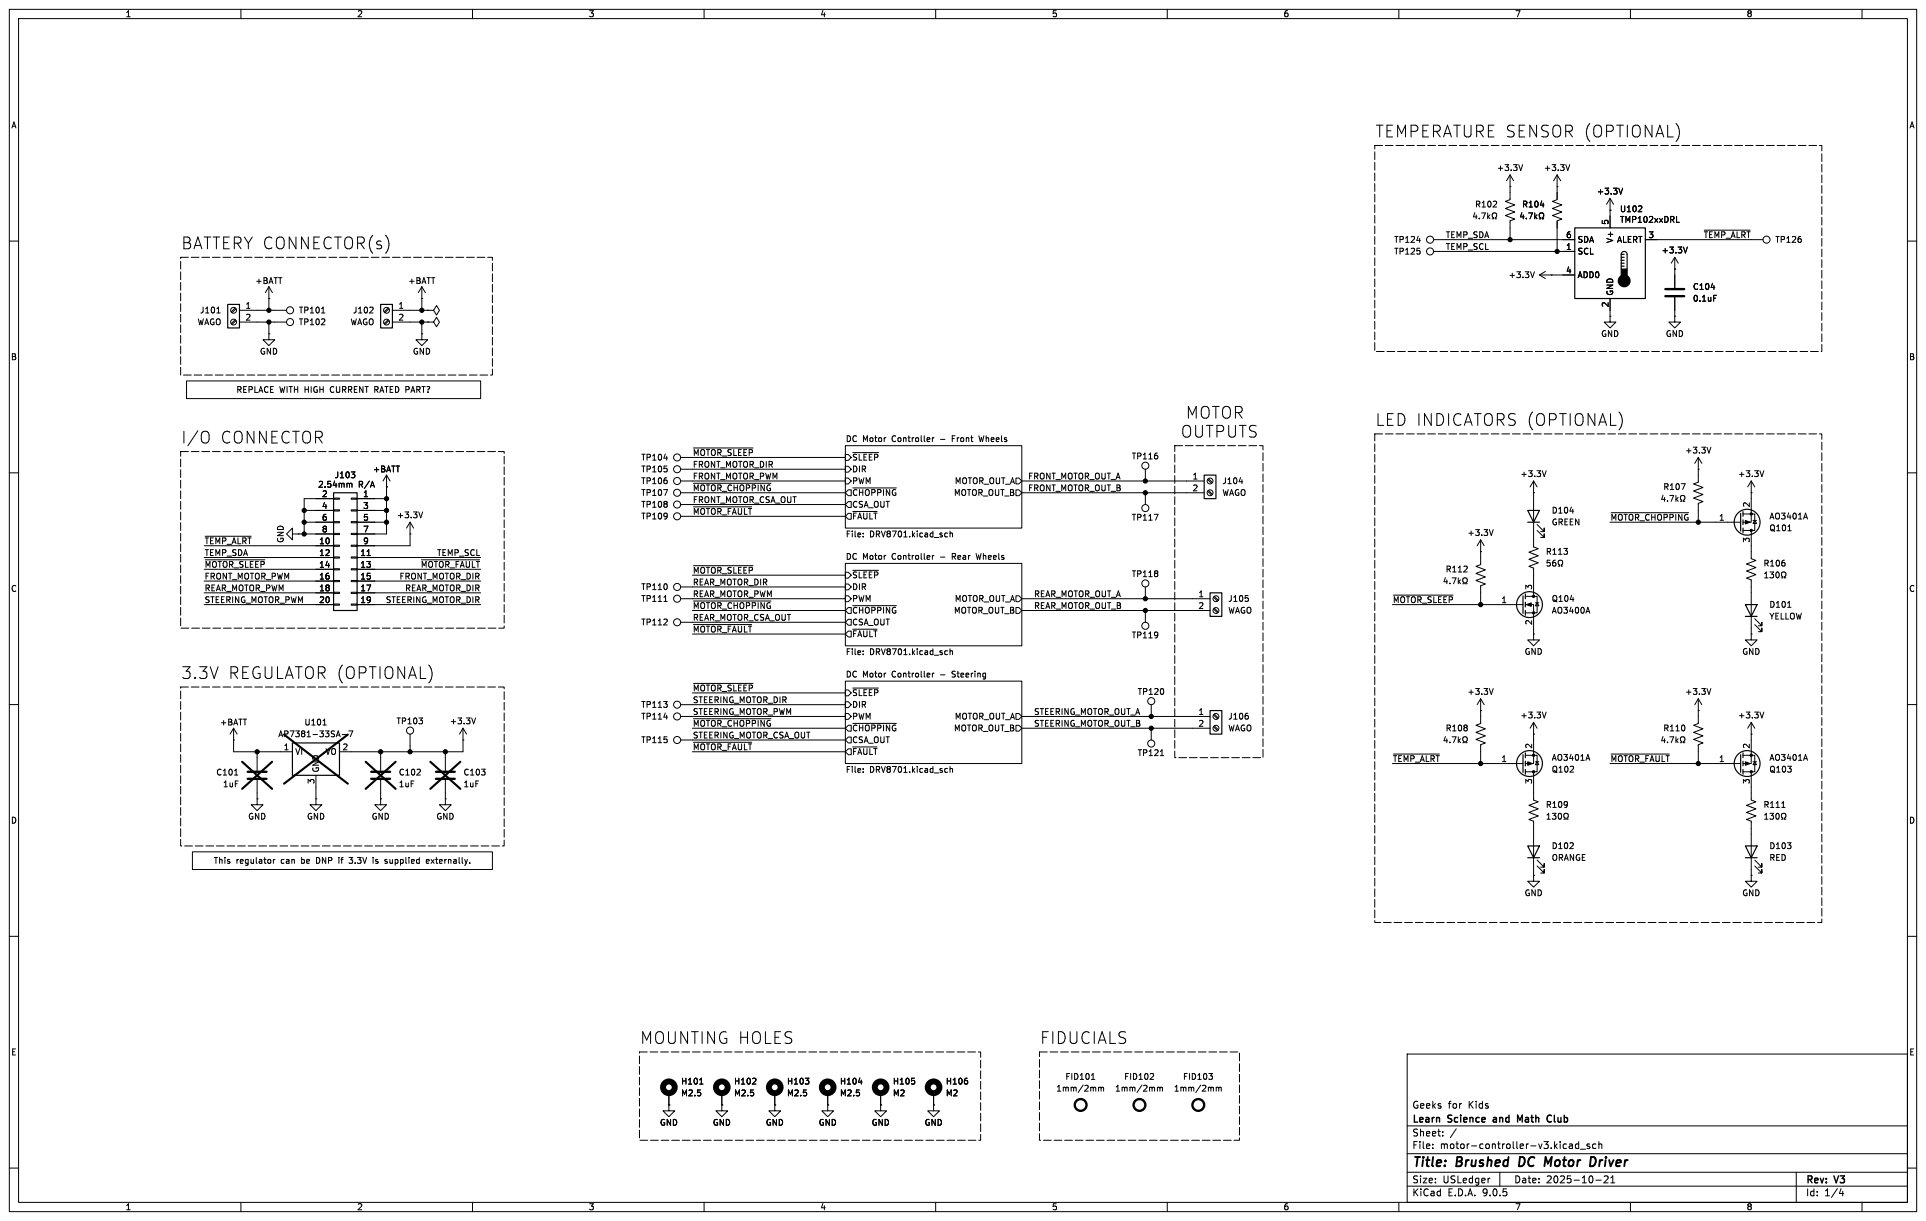
[picture p63: page 1]

REPLACE WITH HIGH CURRENT RATED PART? BATTERY CONNECTOR(s)

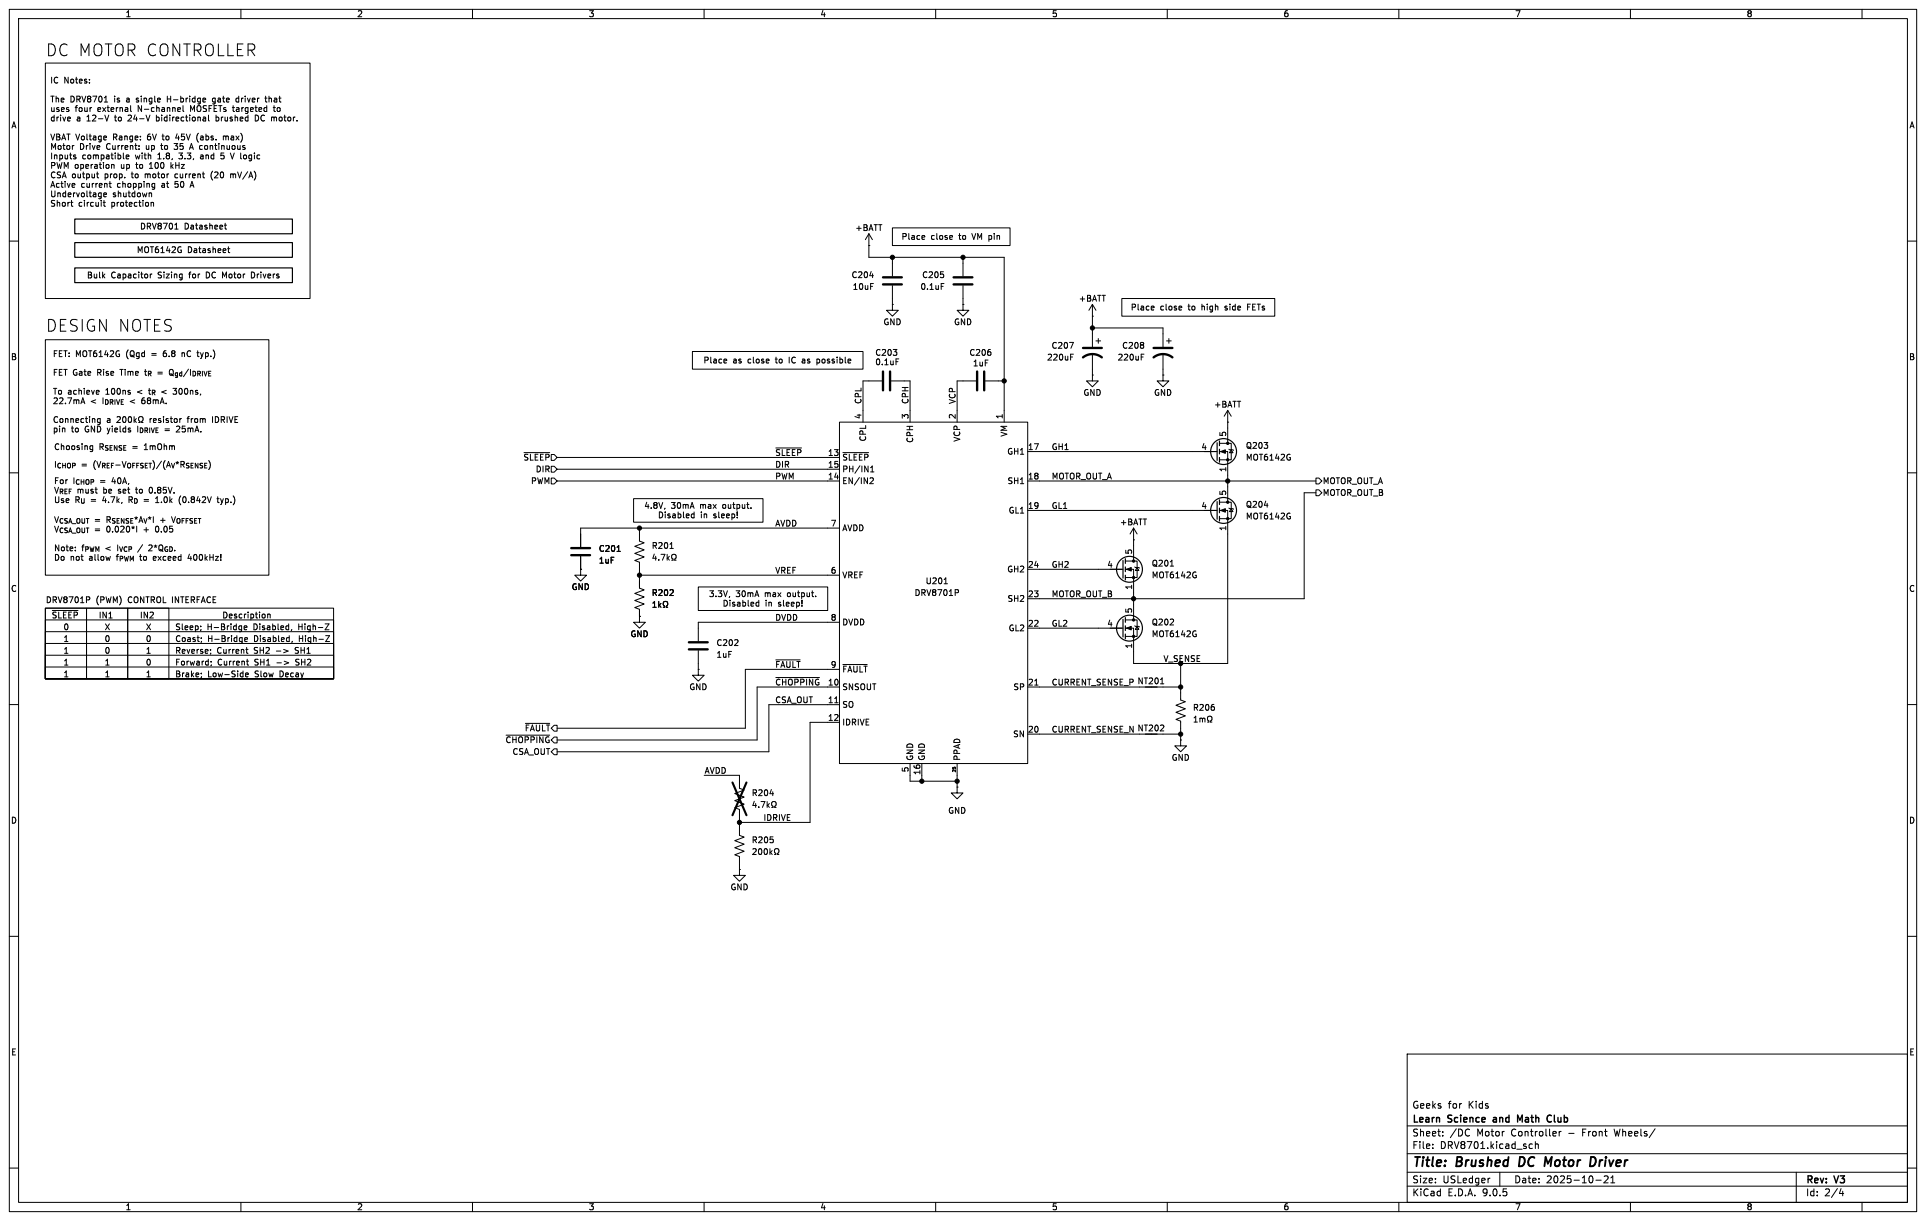
[picture p64: page 2]

FET Gate Rise Time t_{R}= Q_{gd}/I_{DRIVE} To achieve 100ns < t_{R}< 300ns, 22.7mA < I_{DRIVE} < 68mA. FET: MOT6142G (Qgd = 6.8 nC typ.)

pin to GND yields I_{DRIVE} = 25mA. V_{CSA_OUT} = R_{SENSE}*A_{V}*I + V_{OFFSET}
Choosing R_{SENSE} = 1mOhm
I_{CHOP} = (V_{REF}-V_{OFFSET})/(A_{V}*R_{SENSE})
For I_{CHOP} = 40A, V_{REF} must be set to 0.85V. Use R_{U}= 4.7k, R_{D}= 1.0k (0.842V typ.)

IN2 DRV8701P (PWM) CONTROL INTERFACE Description

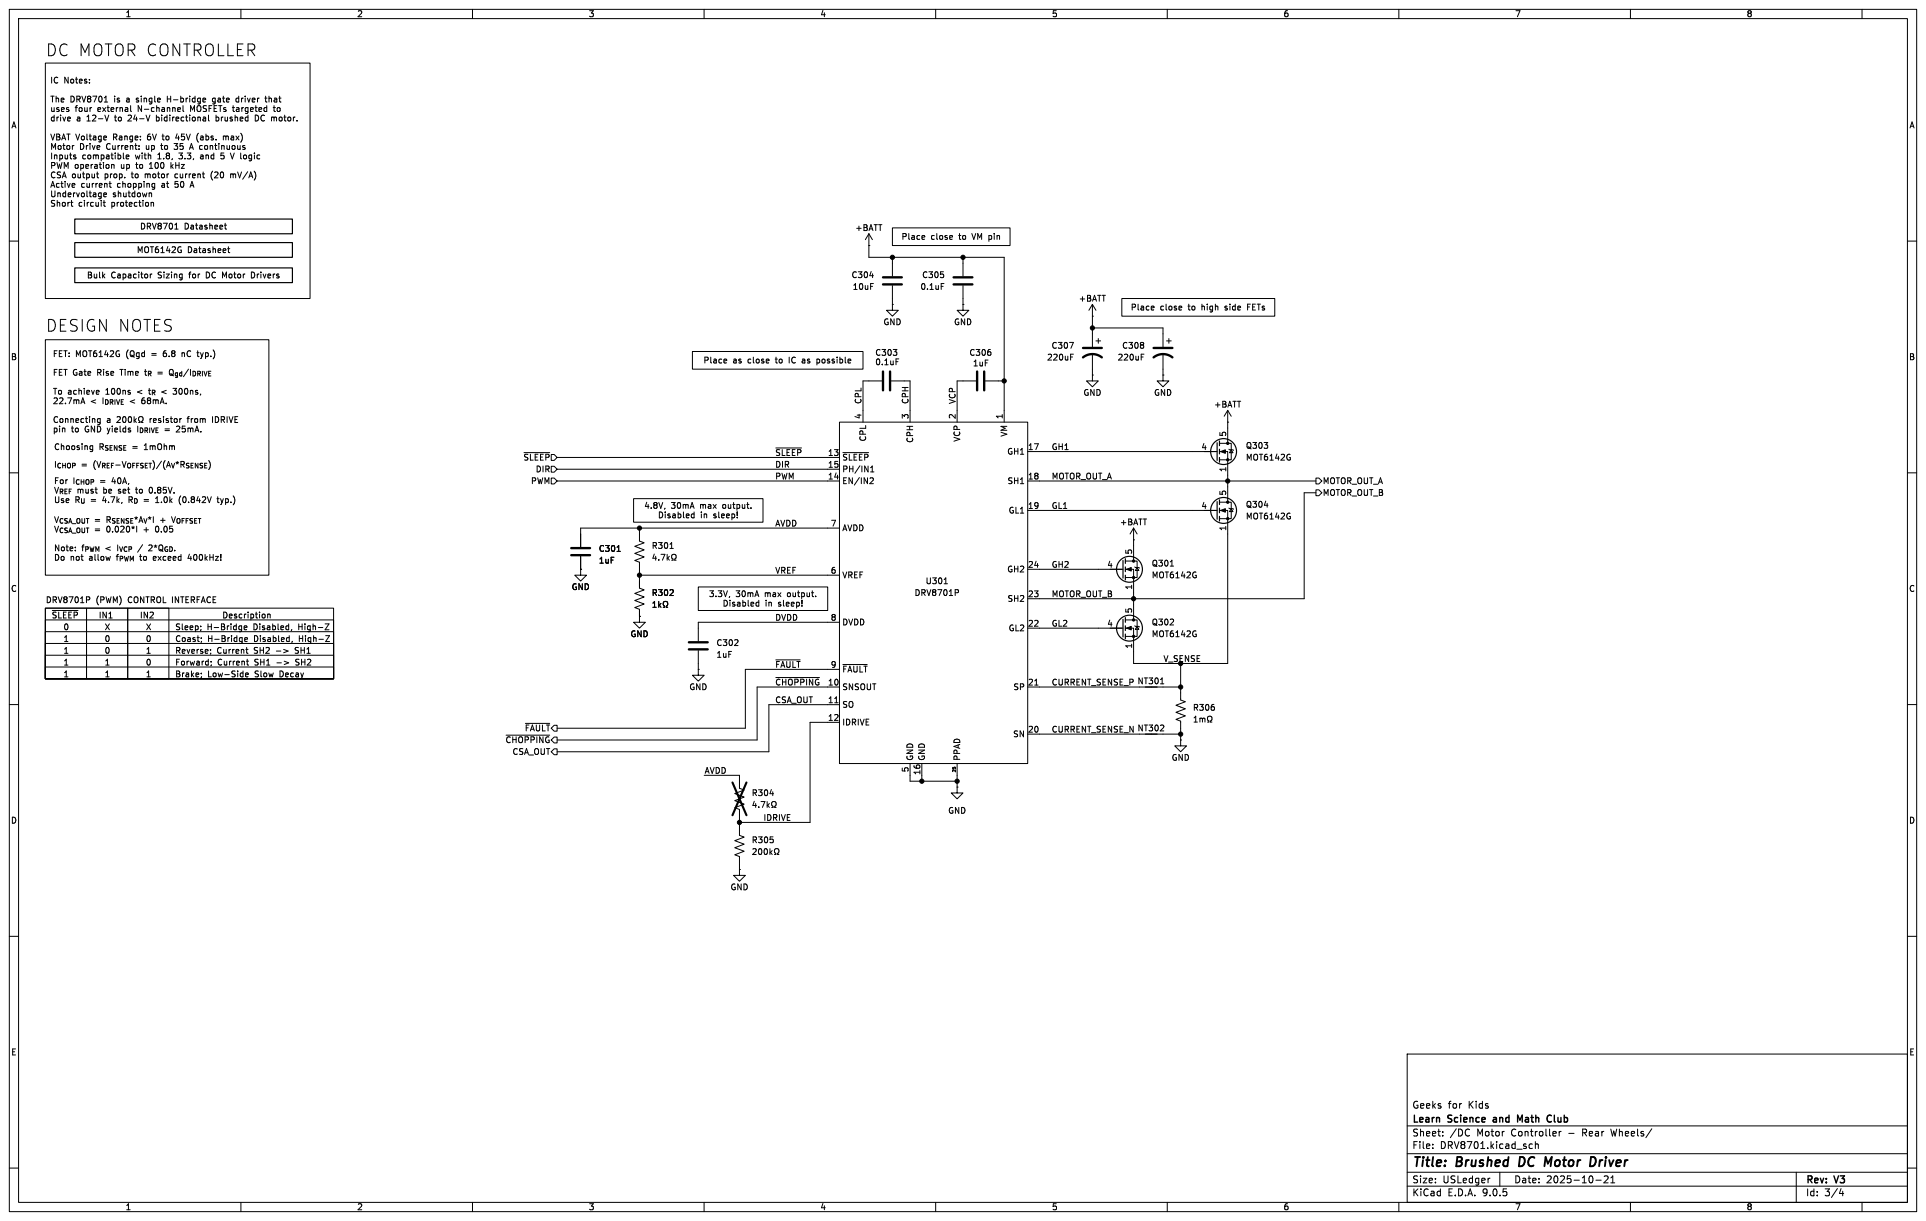
[picture p65: page 3]
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

IN2 DRV8701P (PWM) CONTROL INTERFACE Description

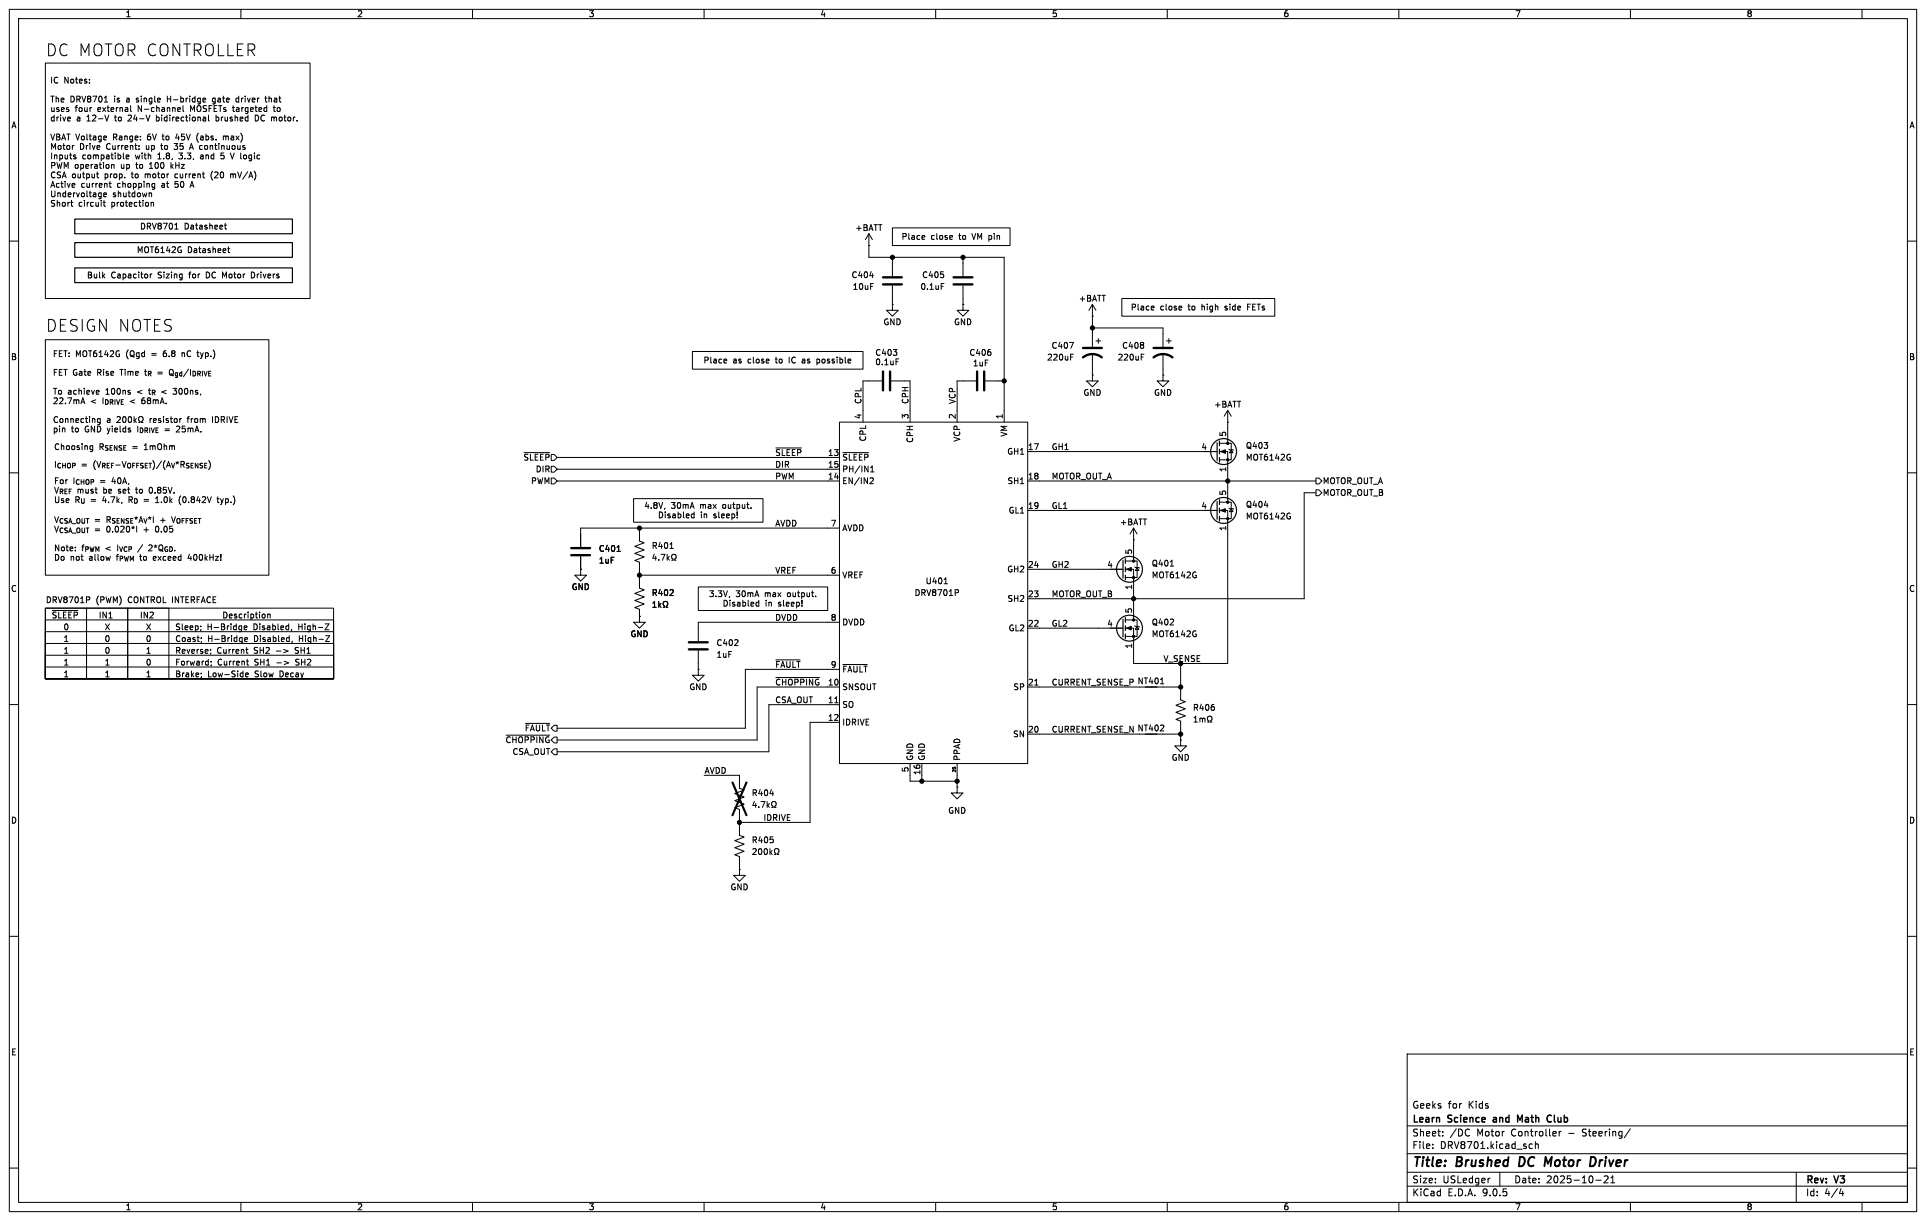
[picture p66: page 4]
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

IN2 DRV8701P (PWM) CONTROL INTERFACE Description
