synthesissolutions/geeksforkids/hardware/InputBoardSTM32/InputBoardSTM32-schematic.pdf

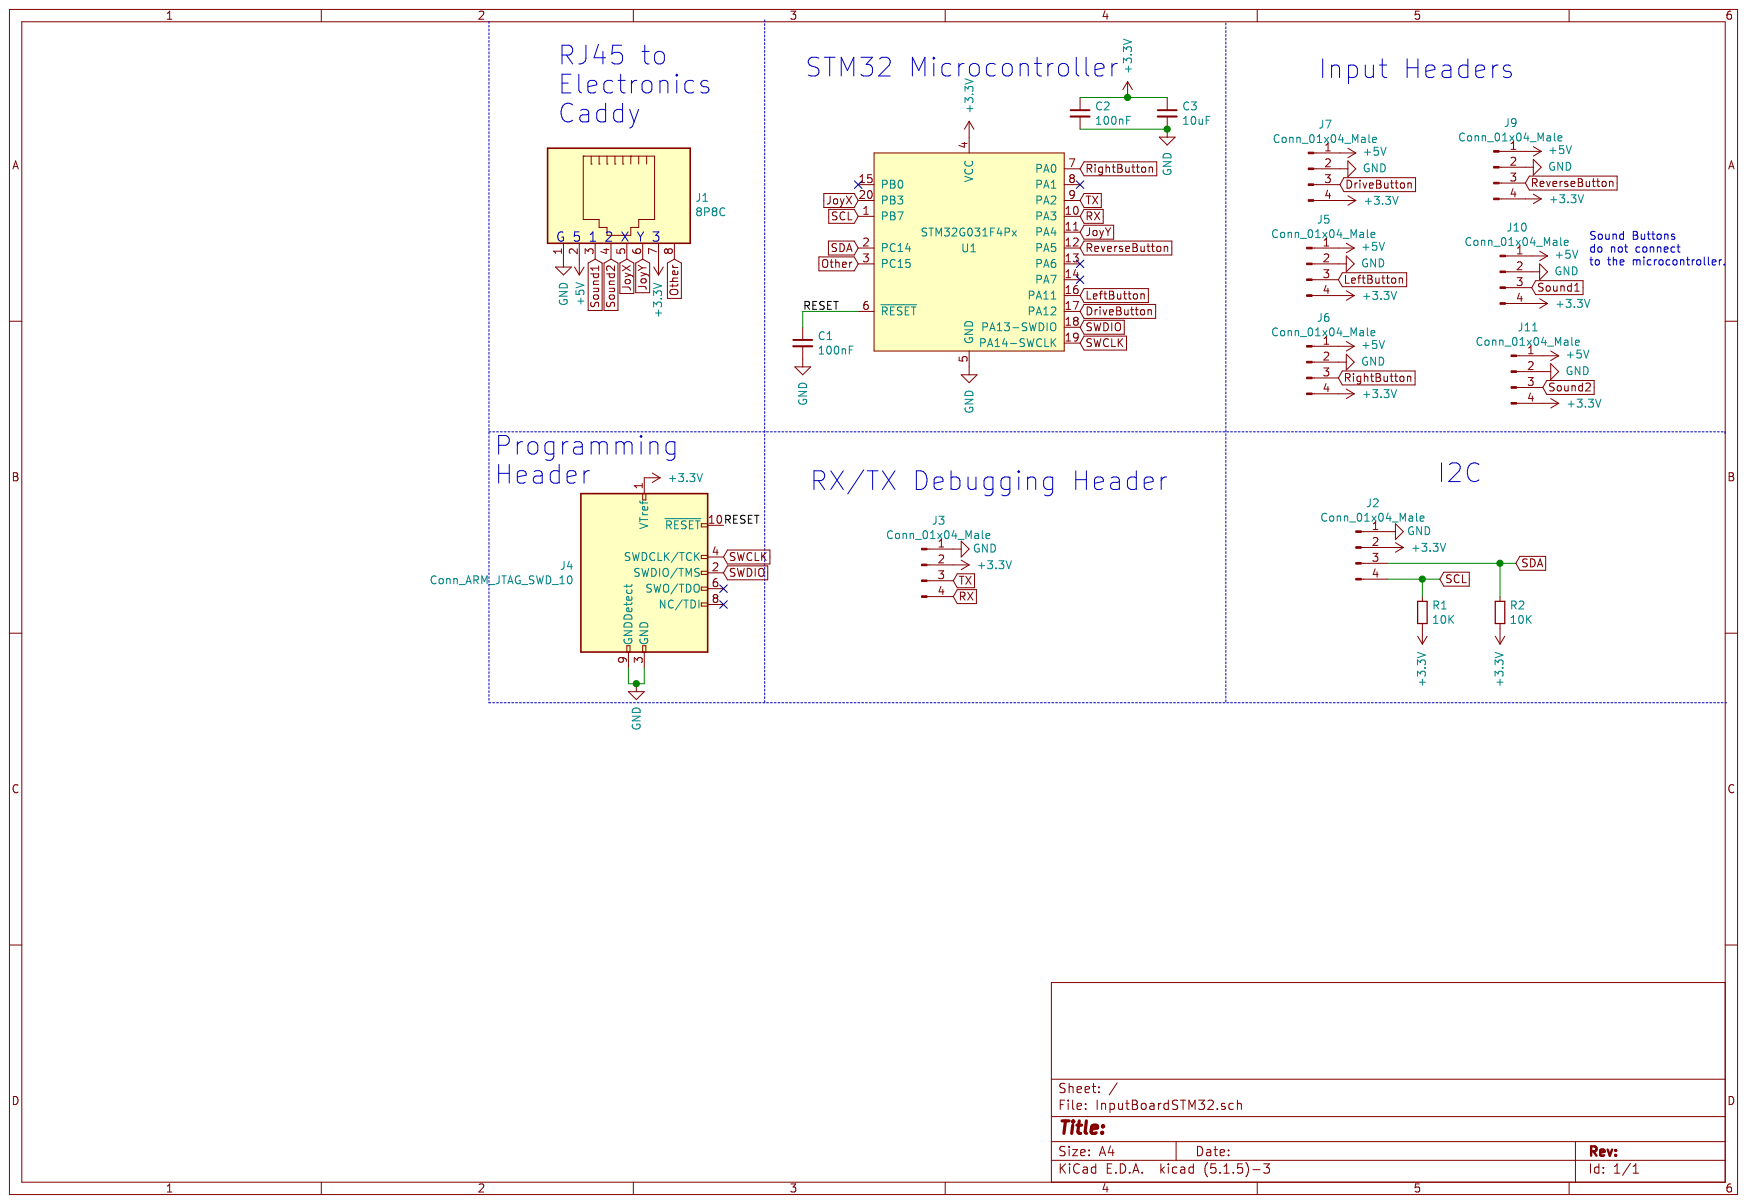
[picture p67: page 1]
