synthesissolutions/geeksforkids/hardware/InputBoardSTM32QFN28/InputBoardSTM32QFN28-schematic.pdf

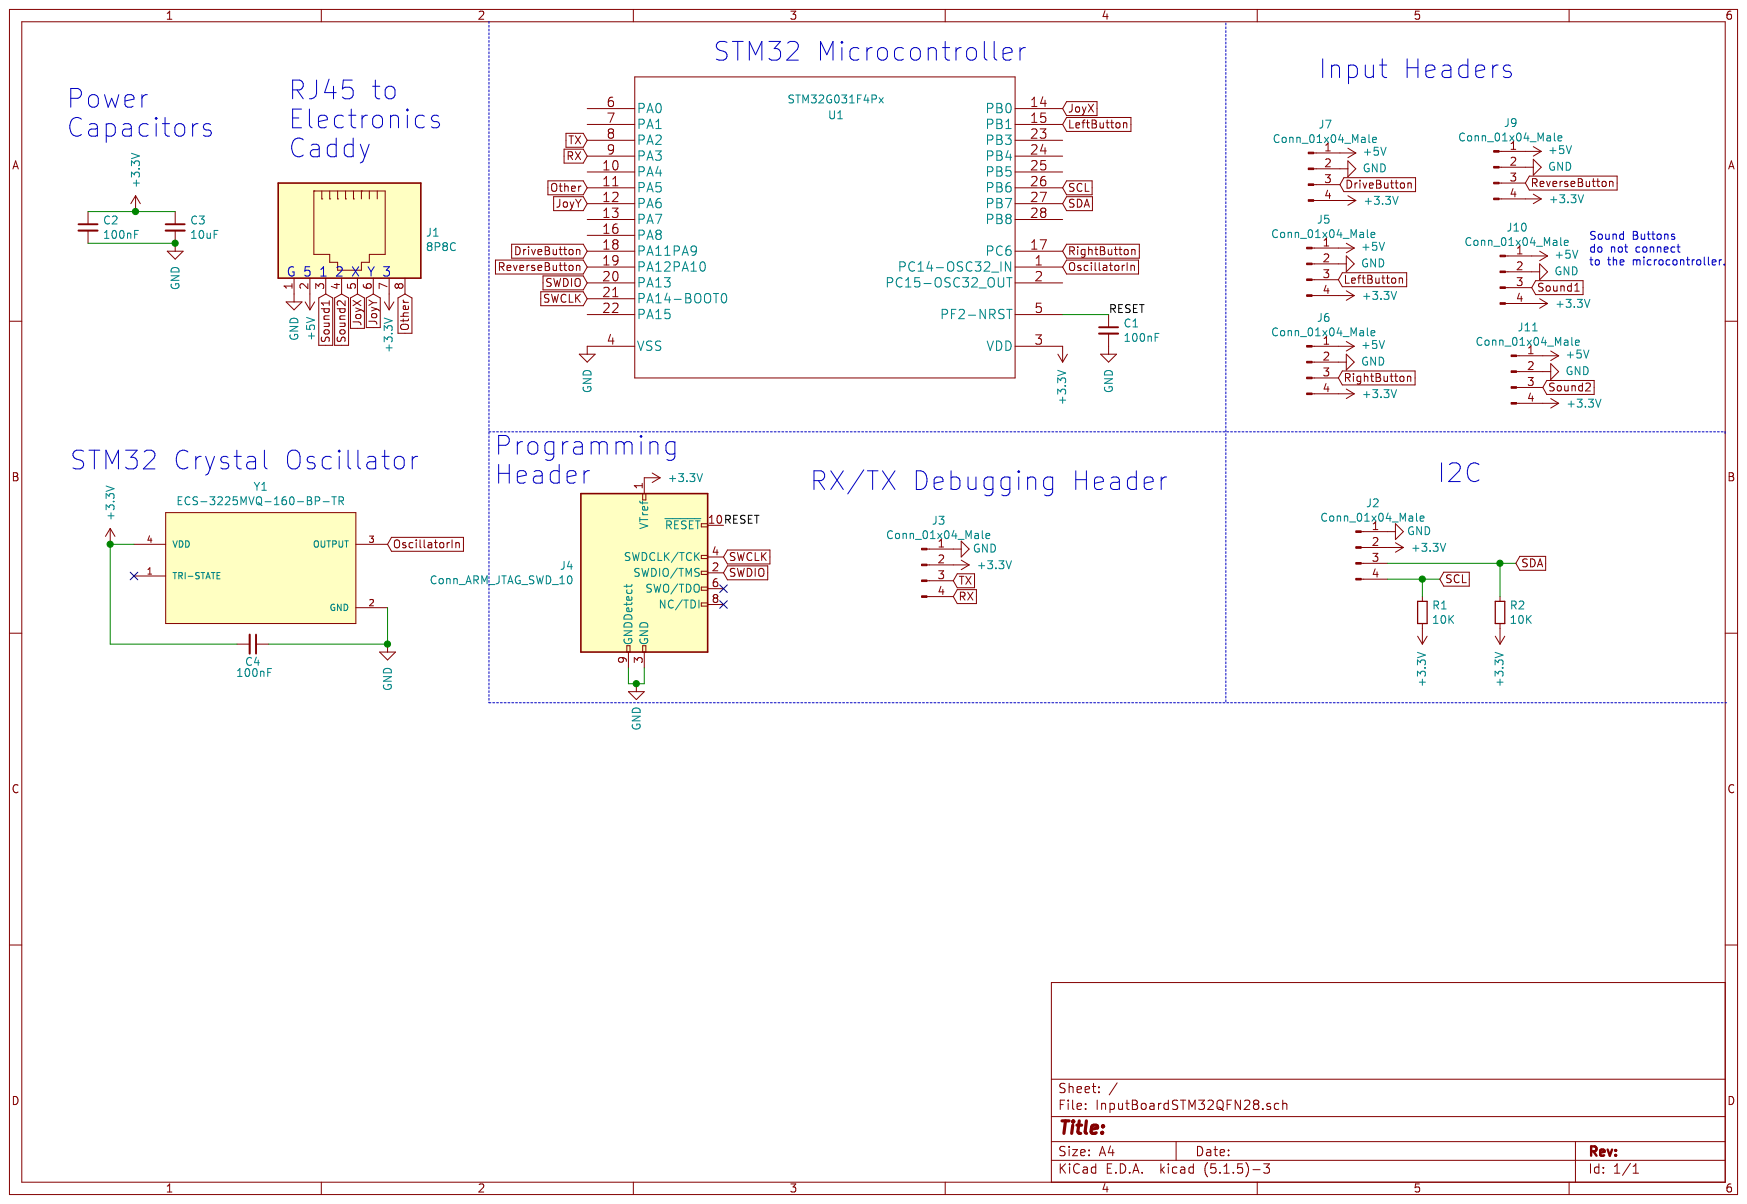
[picture p68: page 1]
