synthesissolutions/geeksforkids/hardware/STM32QFN28Breakout/STM32QFN28Breakout-PCB.pdf

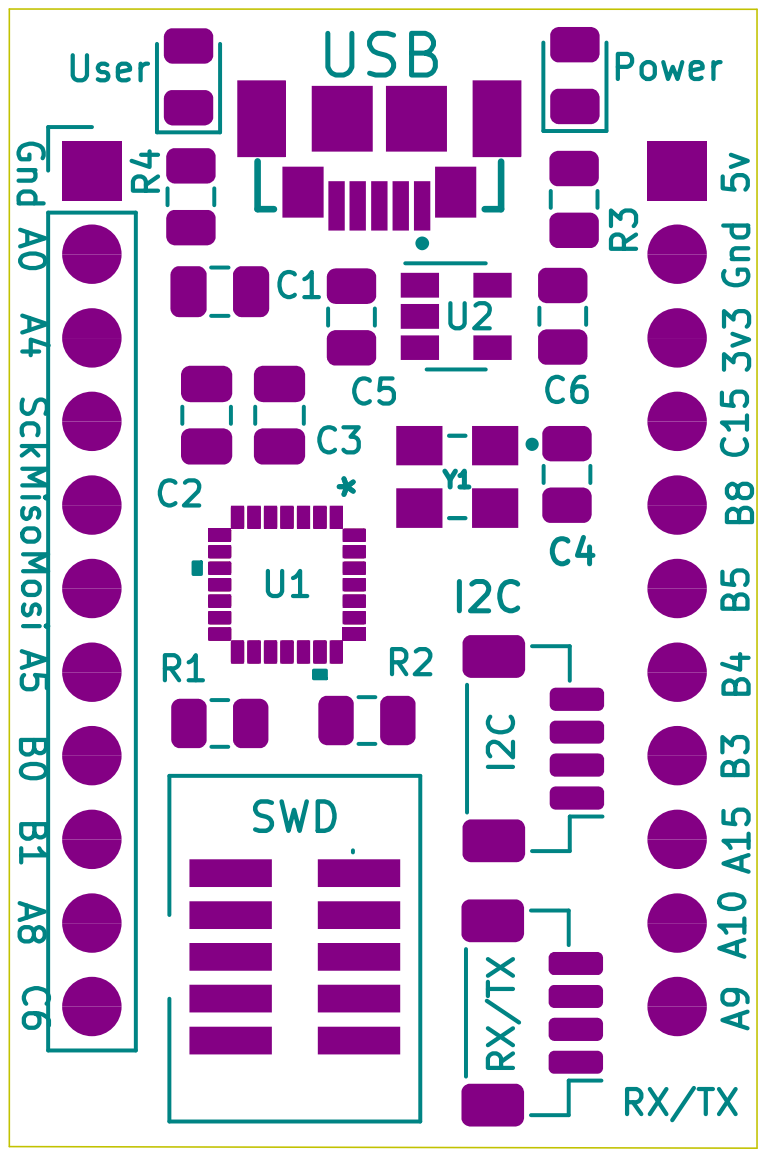
[picture p69: page 1]
