synthesissolutions/geeksforkids/hardware/STM32QFN28Breakout/STM32QFN28Breakout-schematic.pdf

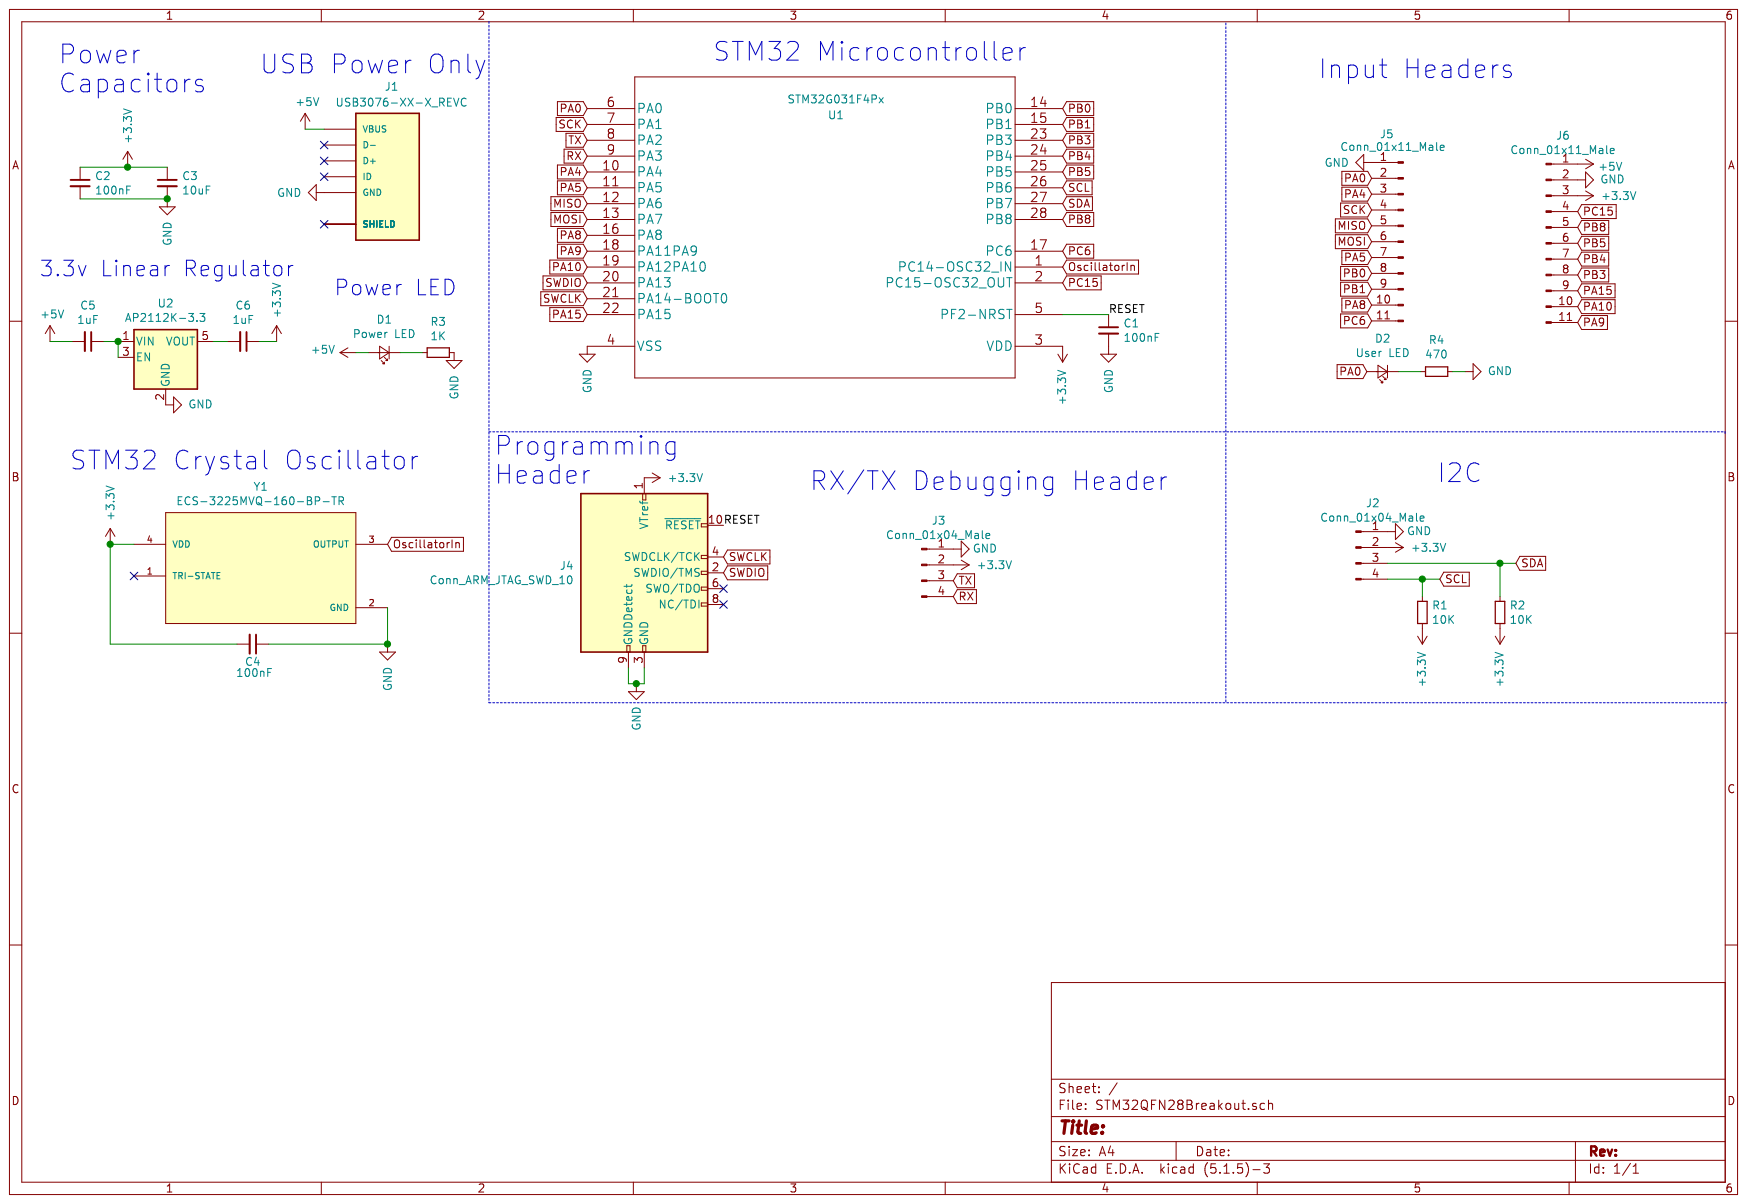
[picture p70: page 1]
