synthesissolutions/geeksforkids/hardware/HallSensorSMD/Hall Sensor SMD 7 Pos-PCB Layout.pdf

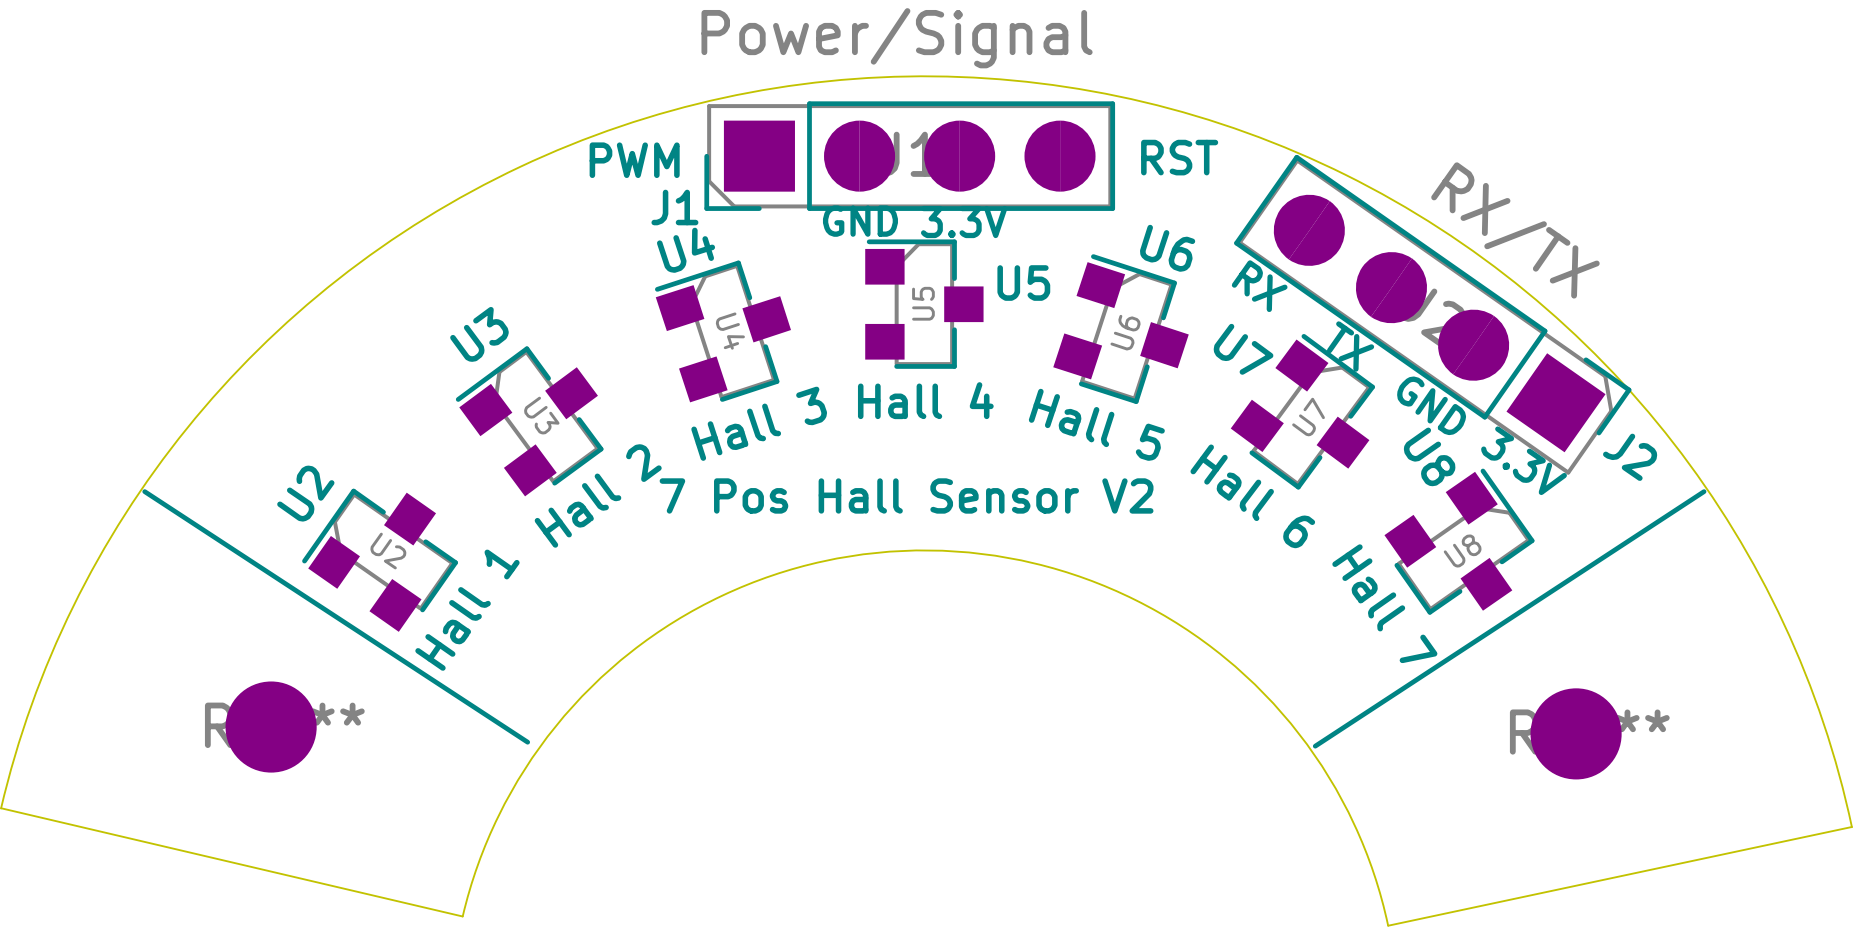
[picture p71: page 1]
