synthesissolutions/geeksforkids/hardware/HallSensorSMD/Hall Sensor SMD 7 Pos-Schematic.pdf

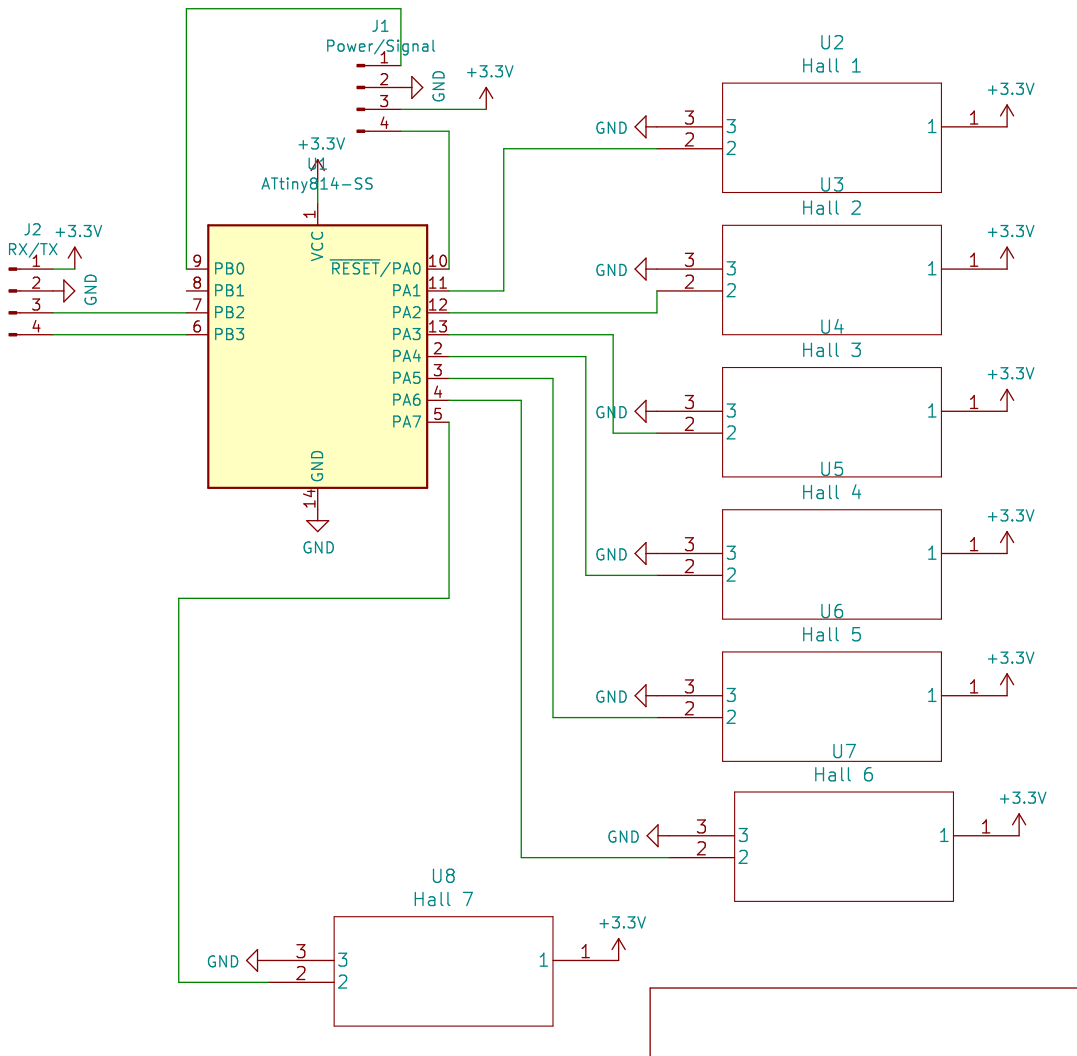
[picture p72: page 1]
