synthesissolutions/geeksforkids/hardware/HallSensorSMD_9_Pos/Hall Sensor SMD 9 Pos-PCB Layout.pdf

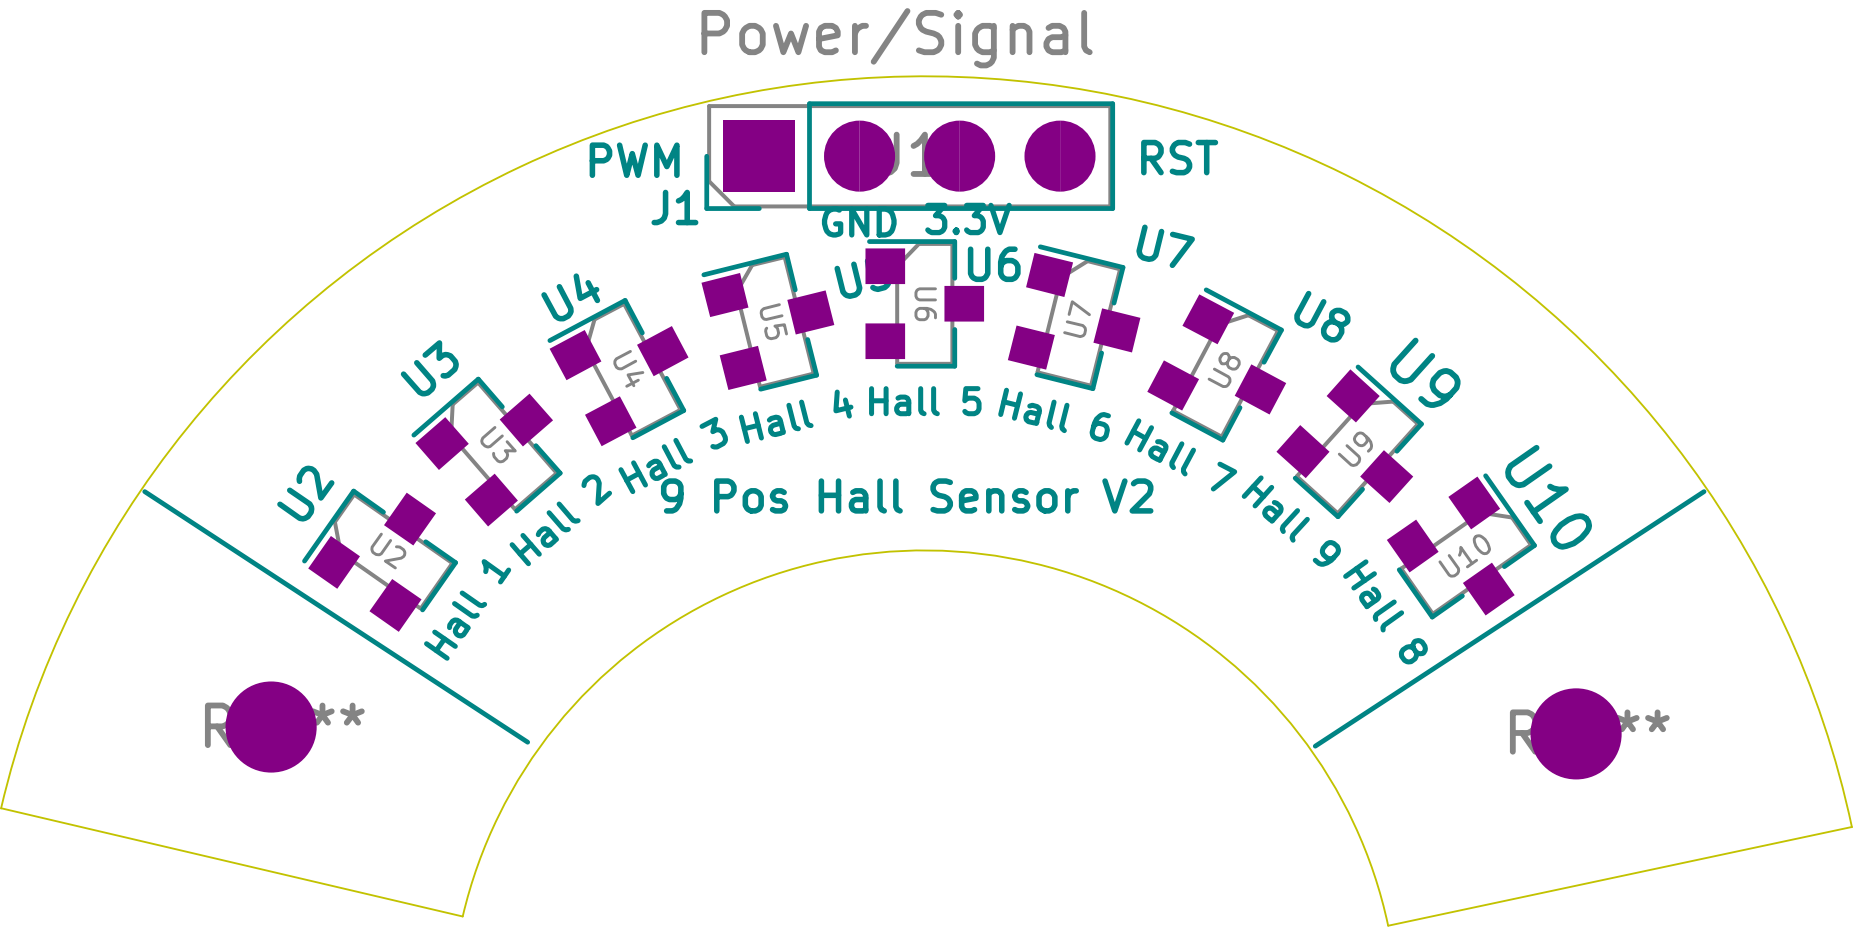
[picture p73: page 1]
