synthesissolutions/geeksforkids/hardware/HallSensorSMD_9_Pos/Hall Sensor SMD 9 Pos-Schematic.pdf

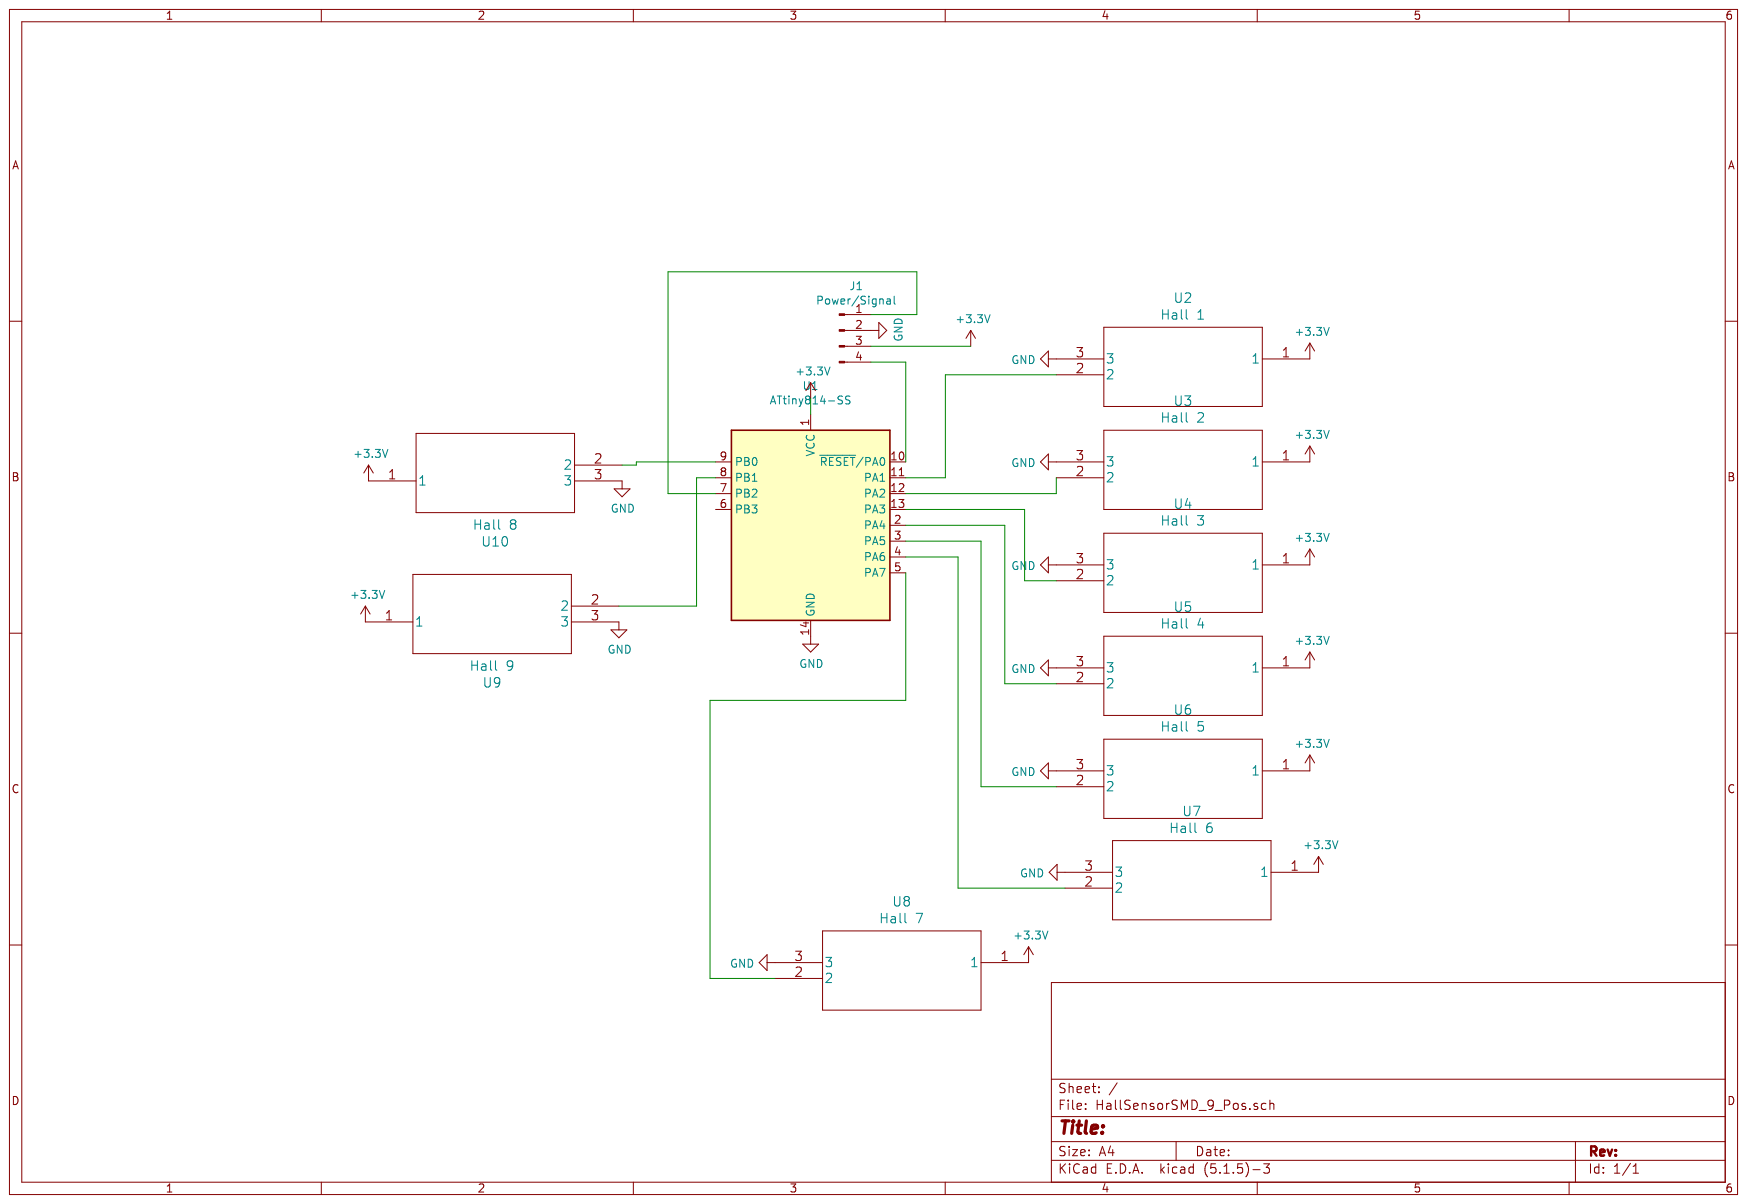
[picture p74: page 1]
