synthesissolutions/geeksforkids/hardware/ControlBoardT4/ControlBoardT4_PCB.pdf

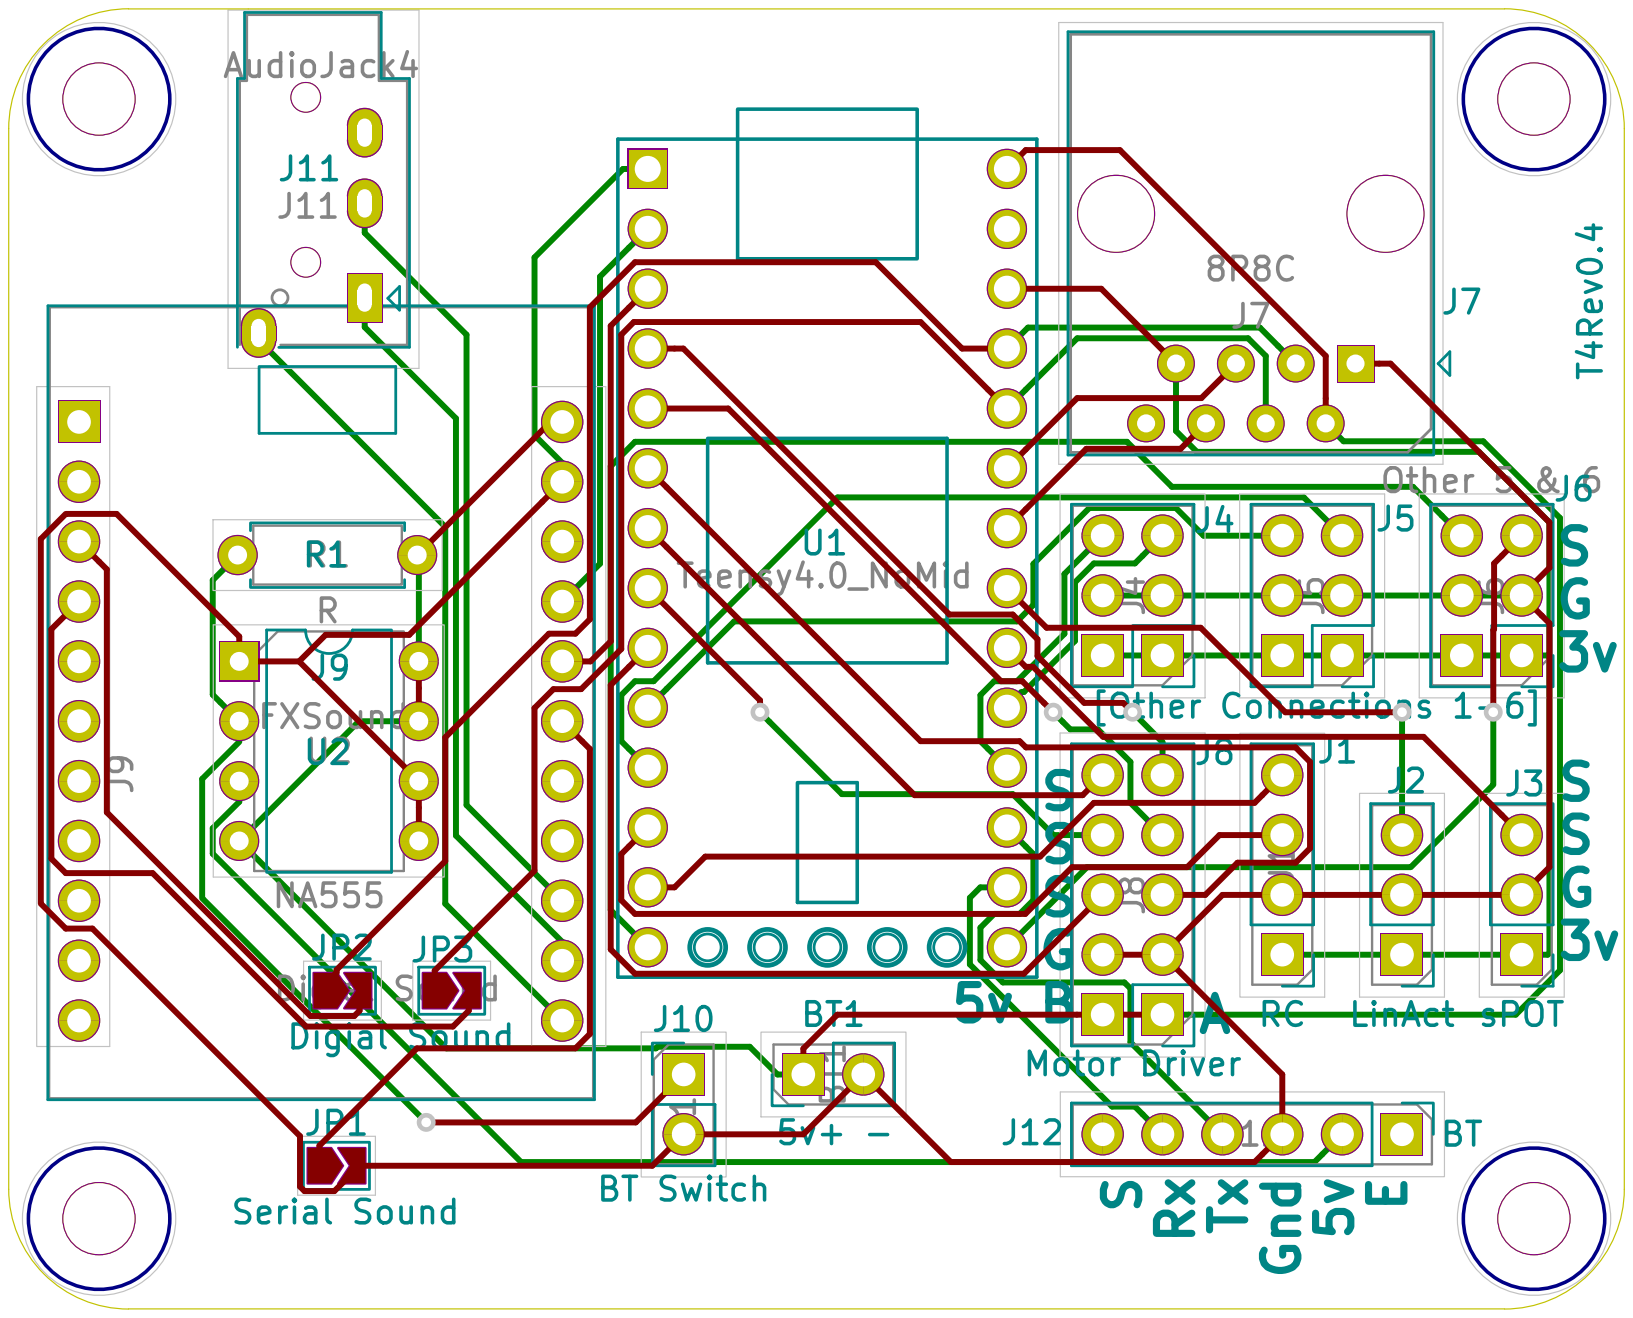
[picture p75: page 1]
