synthesissolutions/geeksforkids/hardware/ControlBoardT4/ControlBoardT4_Schematic.pdf

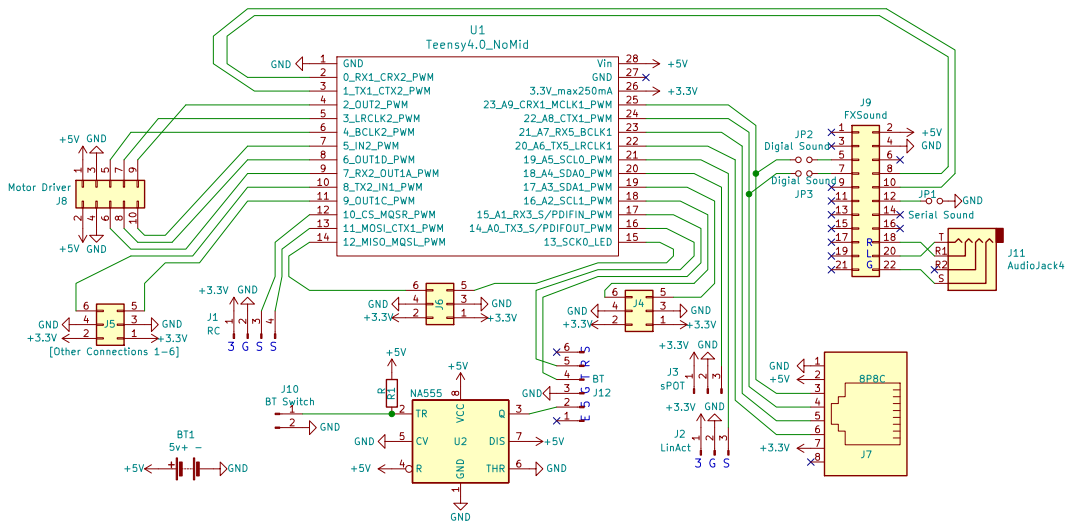
[picture p76: page 1]
