synthesissolutions/geeksforkids/hardware/PowerBreakout/PowerBreakout_PCB.pdf

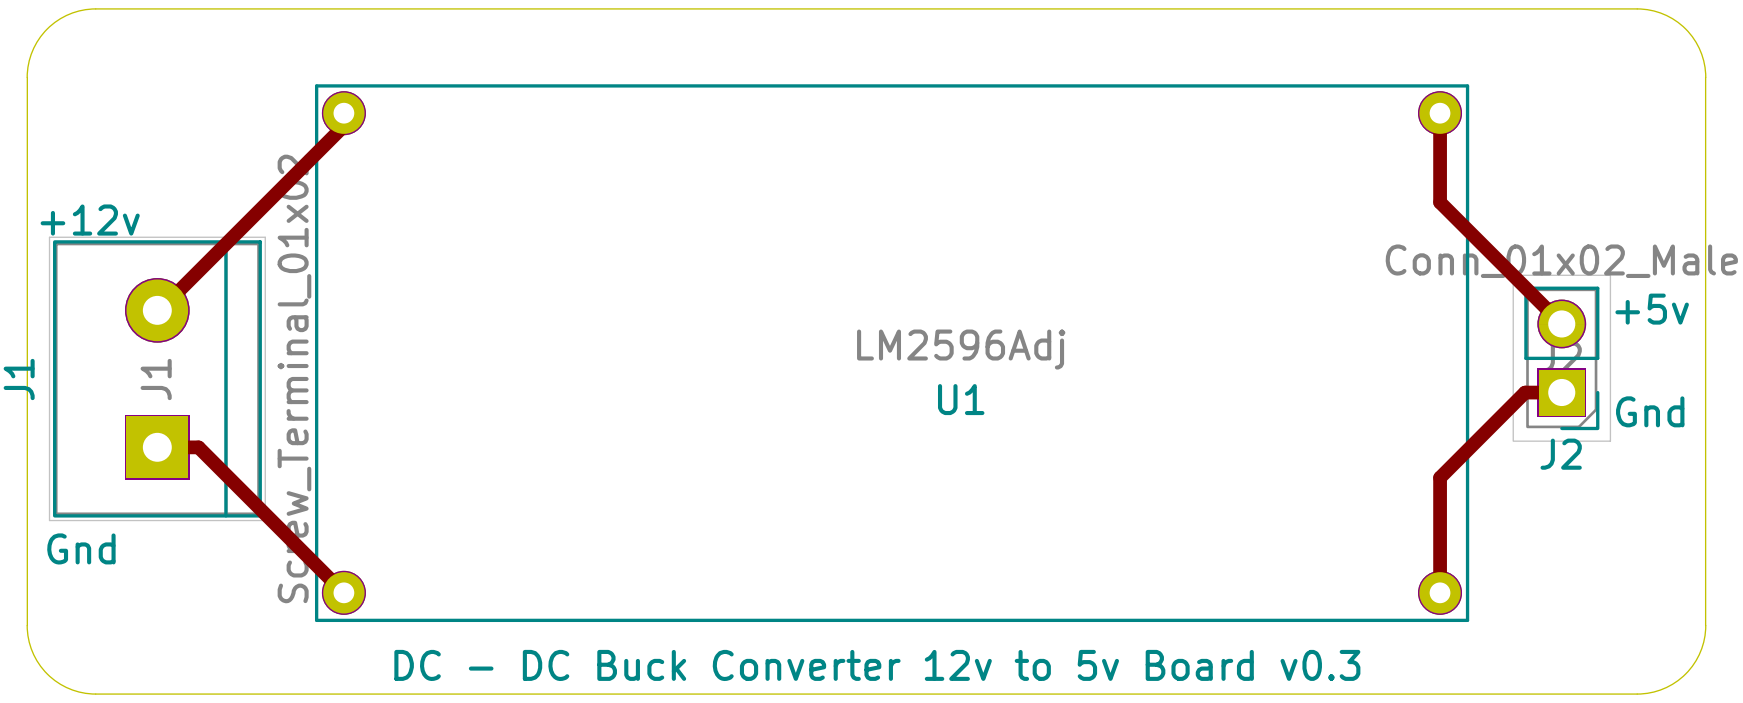
[picture p77: page 1]
