synthesissolutions/geeksforkids/hardware/PowerBreakout/PowerBreakout_Schematic.pdf

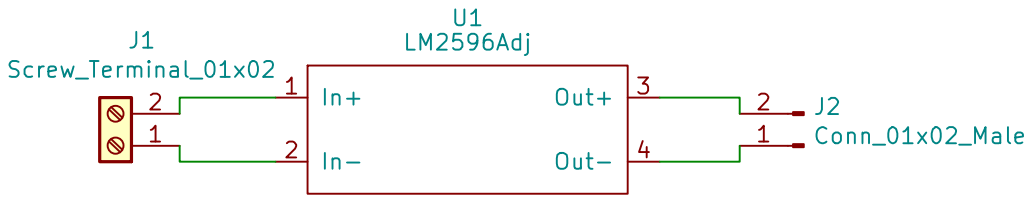
[picture p78: page 1]
