synthesissolutions/geeksforkids/hardware/Action Challenges/Magic_Wand_Timer_Simplified/Magic_Wand_Timer_Simplified.pdf

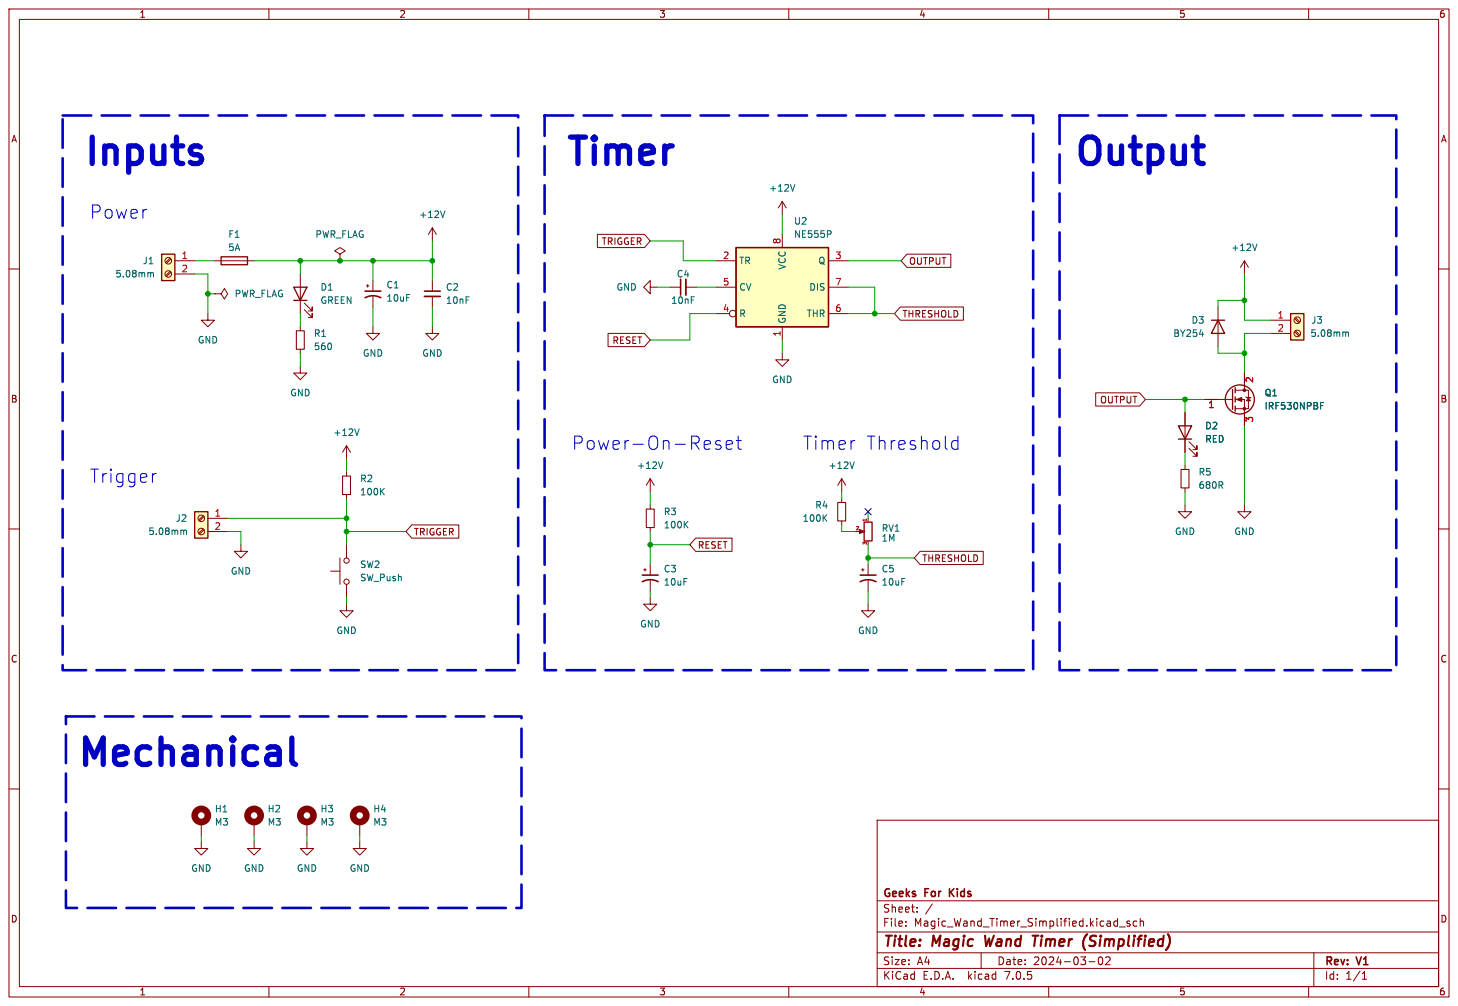
[picture p79: page 1]
