synthesissolutions/geeksforkids/hardware/Fisher Price Base/motor-controller-v2/Brushed_DC_Motor_Driver_SCM.pdf

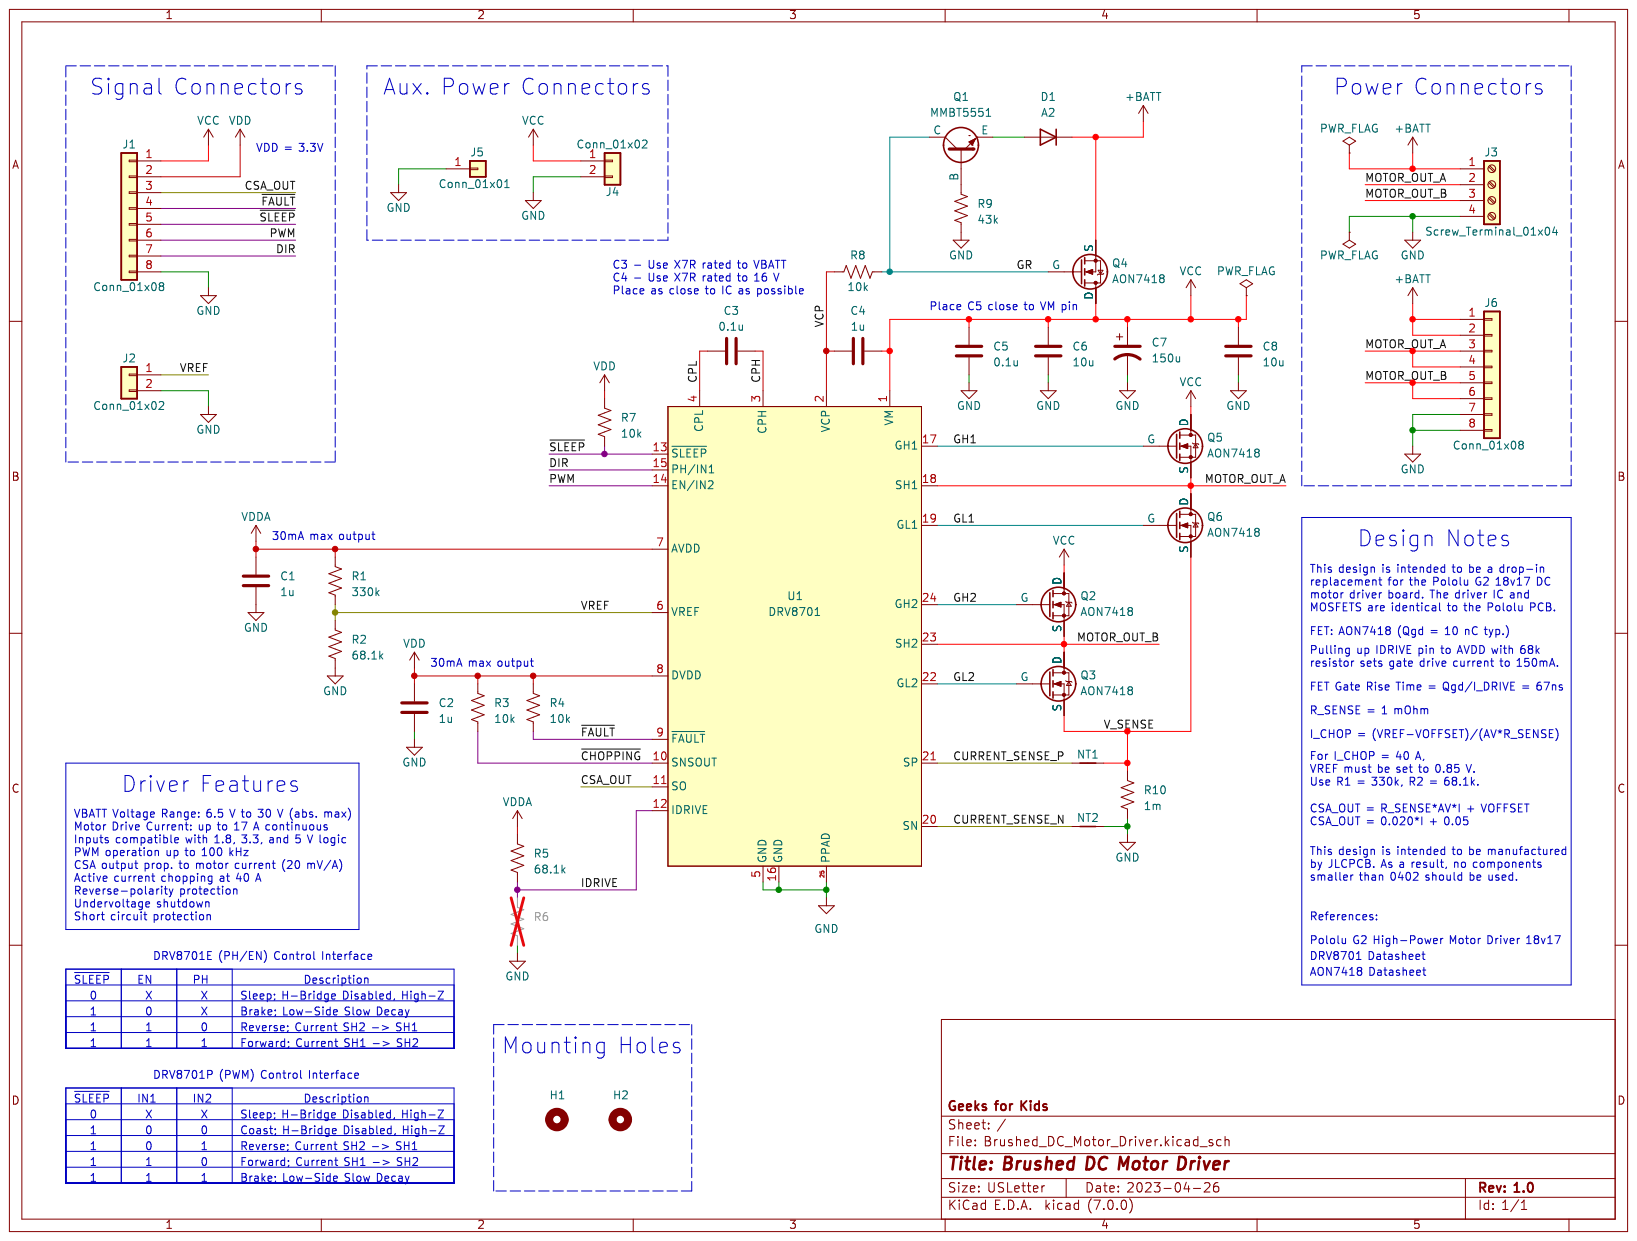
[picture p89: page 1]
