synthesissolutions/geeksforkids/hardware/Drive Systems/Joystick/JoystickBoard/JoystickBoard_PCB.pdf

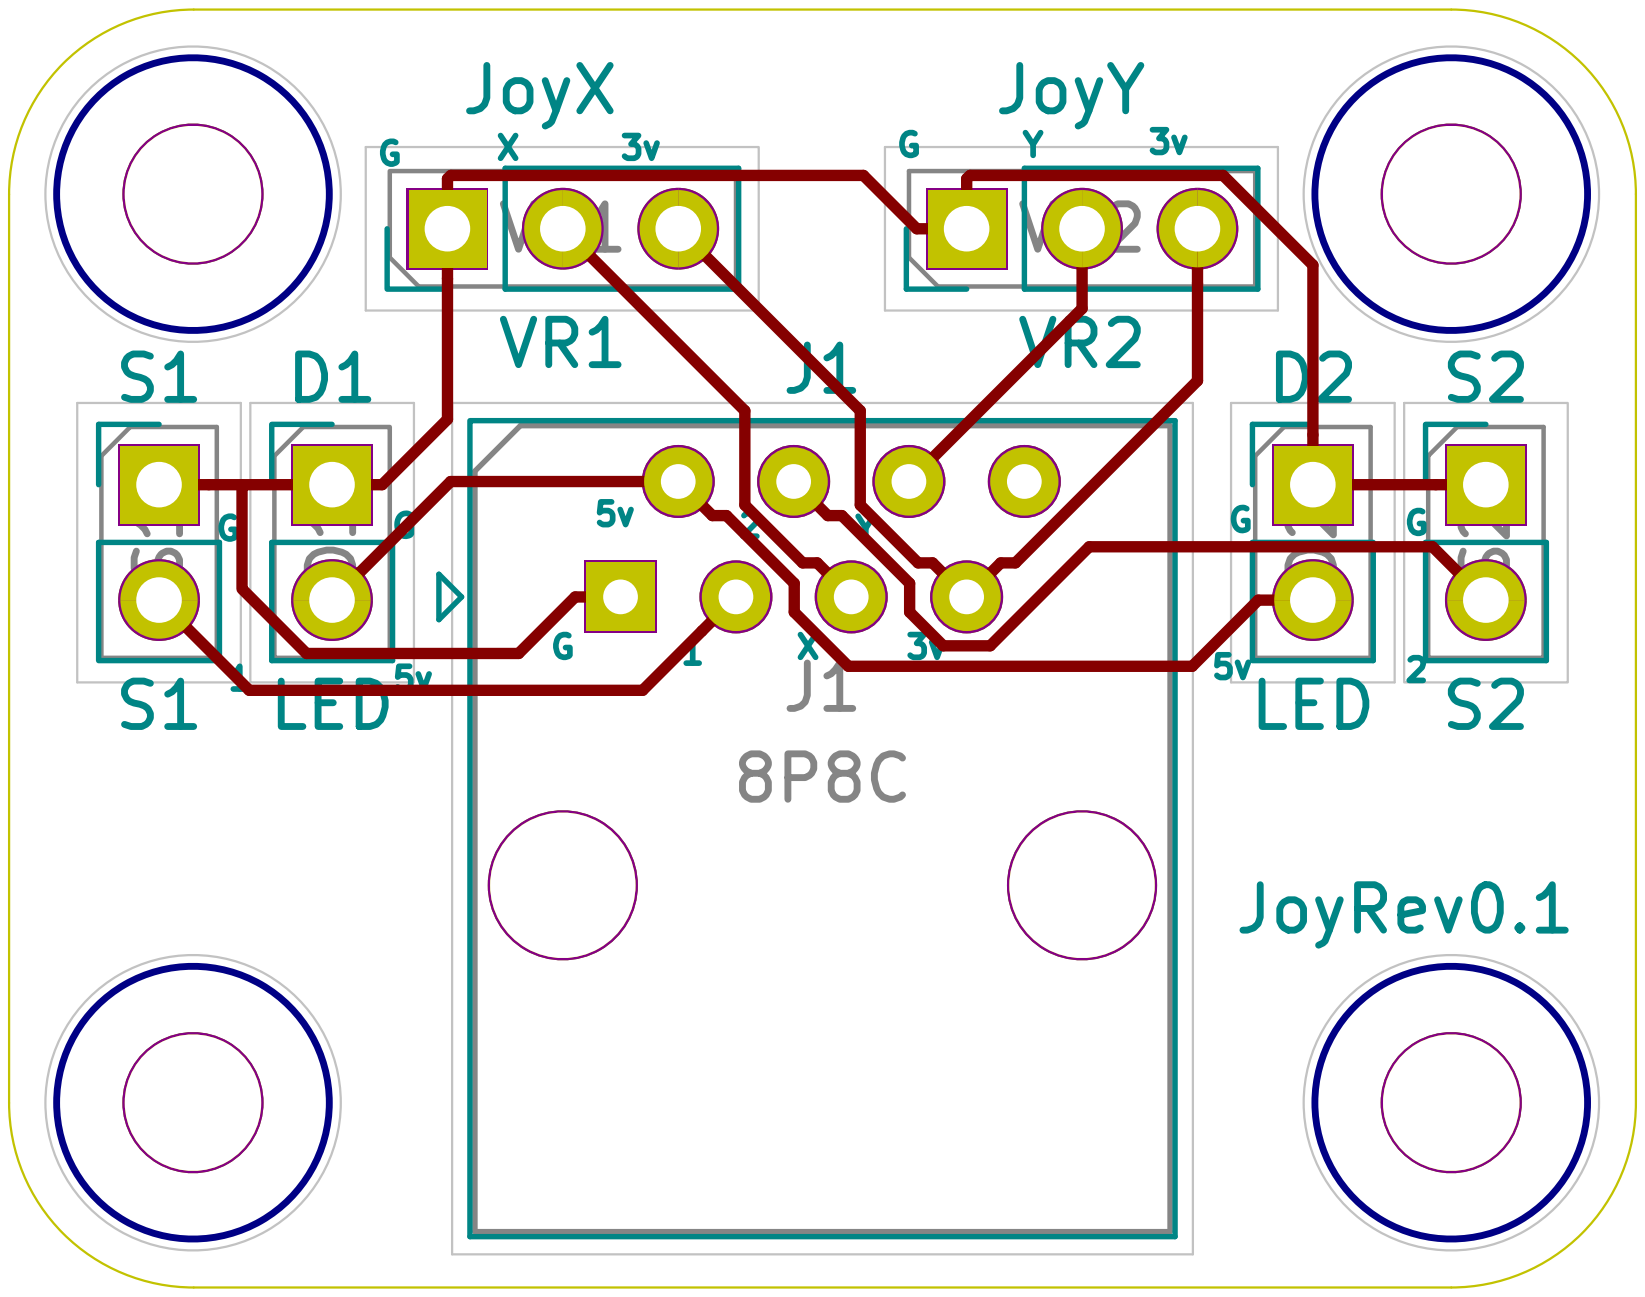
[picture p90: page 1]
