synthesissolutions/geeksforkids/hardware/Drive Systems/Joystick/JoystickBoard/JoystickBoard_Schematic.pdf

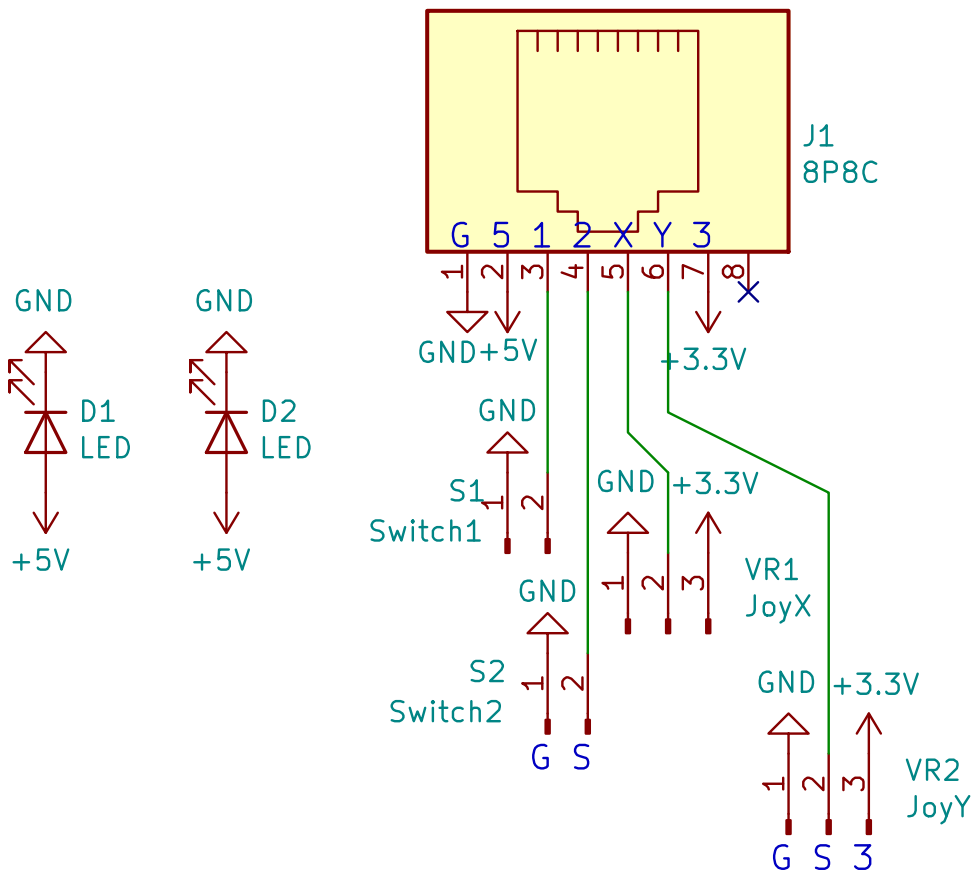
[picture p91: page 1]
