synthesissolutions/geeksforkids/hardware/ControlInputTestFeather/MAX9744.sch

## KiCad design hardware/ControlInputTestFeather/MAX9744.sch (2021-03-09)

Schematic: MAX9744.sch

Parts:
C1, C2: 0.47µF; C_0805_2012Metric_Pad1.15x1.40mm_HandSolder; DigiKey ID 399-8099-1-ND
C3: 470µF; CP_Radial_D8.0mm_P3.50mm; DigiKey ID 1189-1859-ND
C4, C5: 10µF; C_0805_2012Metric_Pad1.15x1.40mm_HandSolder; DigiKey ID 399-8012-1-ND
C6, C7, C9, C10: 0.1µF; C_0805_2012Metric_Pad1.15x1.40mm_HandSolder; DigiKey ID 399-8000-1-ND
C8: 2.2µF; C_0805_2012Metric_Pad1.15x1.40mm_HandSolder; DigiKey ID 399-11941-1-ND
C12, C13: 470pF; C_0805_2012Metric_Pad1.15x1.40mm_HandSolder; DigiKey ID 399-1142-1-ND
FB1, FB2, FB3: MPZ2012S221AT00; L_0805_2012Metric_Pad1.15x1.40mm_HandSolder; DigiKey ID 445-1568-1-ND
J14: Volume; PinHeader_1x03_P2.54mm_Vertical
J15: Left Speaker; TerminalBlock_bornier-2_P5.08mm
Q1: AOD417; TO-252-2pin3D; DigiKey ID 785-1106-1-ND
R5, R6, R7, R8: 20K; R_0805_2012Metric_Pad1.15x1.40mm_HandSolder; DigiKey ID 311-20.0KCRCT-ND
R9, R10: 10K; R_0805_2012Metric_Pad1.15x1.40mm_HandSolder; DigiKey ID RNCP0805FTD10K0CT-ND
U4: MAX9744; max9744eth&plus_Mod; DigiKey ID MAX9744ETH+-ND

Notes on the sheet:
+ -
