synthesissolutions/geeksforkids/hardware/PowerBreakout/PowerBreakout.sch

## KiCad design hardware/PowerBreakout/PowerBreakout.sch (2019-11-03)

Schematic: PowerBreakout.sch

Parts:
J1: Screw_Terminal_01x02; TerminalBlock_bornier-2_P5.08mm
J2: Conn_01x02_Male; PinHeader_1x02_P2.54mm_Vertical
U1: LM2596Adj
