synthesissolutions/geeksforkids/hardware/TeensyPlusFeather/TeensyPlusFeather.sch

## KiCad design hardware/TeensyPlusFeather/TeensyPlusFeather.sch (2022-02-03)


Parts:
J5: I2C; JST_SH_SM05B-SRSS-TB_1x05-1MP_P1.00mm_Horizontal
R1, R2: 10K; R_0805_2012Metric_Pad1.15x1.40mm_HandSolder
U1: Teensy4.0_NoMid; Teensy40_NoMid
U3: OLED Feather; Feather_nRF52840

Connections:
+3.3V: J5.2, U1.26 (3.3V_max250mA), U3.2 (3V)
+5V: U1.28 (Vin), U3.26 (USB)
A0: U1.16 (14_A0_TX3_S/PDIFOUT_PWM), U3.5 (A0)
A1: U1.17 (15_A1_RX3_S/PDIFIN_PWM), U3.6 (A1)
A2: U1.18 (16_A2_SCL1_PWM), U3.7 (A2)
A3: U1.19 (17_A3_SDA1_PWM), U3.8 (A3)
D2: U1.4 (2_OUT2_PWM), U3.16 (D2)
D5: U1.7 (5_IN2_PWM), U3.19 (5)
D6: U1.8 (6_OUT1D_PWM), U3.20 (6)
D7: U1.9 (7_RX2_OUT1A_PWM)
D8: U1.10 (8_TX2_IN1_PWM)
D9: U1.11 (9_OUT1C_PWM), U3.21 (9)
D10: U1.12 (10_CS_MQSR_PWM), U3.22 (10)
D11: U1.13 (11_MOSI_CTX1_PWM), U3.23 (11)
GND: J5.1, U1.1 (GND), U1.27 (GND), U3.4 (Gnd)
I2C_SCL: R1.1, U1.21 (19_A5_SCL0_PWM), U3.10 (A5), U3.18 (SCL)
I2C_SDA: R2.1, U1.20 (18_A4_SDA0_PWM), U3.9 (A4), U3.17 (SDA)
MI: U1.14 (12_MISO_MQSL_PWM), U3.13 (MI), U3.24 (12)
unnamed: J5.3, R2.2
unnamed: J5.4, R1.2
RCPWMSteering: U3.12 (M0)
RX: U1.2 (0_RX1_CRX2_PWM), U3.14 (RX)
SCK: U1.15 (13_SCK0_LED), U3.11 (SCK), U3.25 (13)
TX: U1.3 (1_TX1_CTX2_PWM), U3.15 (TX)
