synthesissolutions/geeksforkids/software/Arduino/car_firmware_ryder_rp2040_m5dial/r_remote_control.ino

 /**
 * RemoteControl Class
 * 
 * This class serves to be the interface to the to the parental remote control unit
 */

// The number of throttle and steering readings to average to smooth results
#define RC_THROTTLE_READINGS 15
#define RC_STEERING_READINGS 15

// The number of readings to take to check for unusual values that would indicate
// a bad RC start. Typically caused by someone holding the throttle in while turning on the remote.
#define RC_START_LENGTH 10

// We are getting small amounts of spurious data related to the I2S signal this amounts
// to 1 or 2 bad signals per second. To avoid this appearing like the parent is taking control
// of the car, we require a number of consecutive signals not at "center" for steering or throttle
// before locking the child out of the car and taking action on the signal.
#define CONSECUTIVE_SIGNALS_REQUIRED  10

class RemoteControl {
  private:

    int pinRCSteering;
    int pinRCThrottle;

    // If this is set to true, the parent will be steering the car with the remote
    // while the child uses a button or equivalent to control the throttle
    // in this case, we don't want the parent steering the car to lock the child out
    bool childThrottleOnly;
    
    // variables to track the PWM signals
    unsigned long steeringPulseStart; // the timestamp in ms for the current PWM steering pulse
    unsigned long steeringPwm = 0;    // the length of the last full PWM steering pulse in microseconds
    boolean steeringSignalHigh = false; // flag indicating that the start of a PWM signal (rising edge) has occured
    unsigned long throttlePulseStart; // the timestamp in ms for the current PWM throttle pulse
    unsigned long throttlePwm = 0;    // the length of the last full PWM throttle pulse in microseconds
    boolean throttleSignalHigh = false; // flag indicating that the start of a PWM signal (rising edge) has occured
    
    // these are in raw pin read units (0 to 1024)
    int steeringMin = STEERING_RC_MIN;
    int steeringCenter = STEERING_RC_CENTER;
    int steeringMax = STEERING_RC_MAX;

    // these are in raw pin read units (0 to 1024)
    int throttleMin = THROTTLE_RC_MIN;
    int throttleCenter = THROTTLE_RC_CENTER;
    int throttleMax = THROTTLE_RC_MAX;
    
    // initial values of -1 ... used to help figure out if we've seen a 0 signal yet
    int steeringScaled = -1;
    int throttleScaled = -1;

    unsigned long lastSignificantInputMillis = 0;
    unsigned long numberOfSteeringInputs = 0;
    unsigned long numberOfThrottleInputs = 0;


    int throttleReadings[RC_THROTTLE_READINGS];
    int throttleIndex = 0;

    int steeringReadings[RC_STEERING_READINGS];
    int steeringIndex = 0;
    
    boolean hasCentered = false;

  public: 
    // Track the first few signal readings and mark a bad start if any of those readings
    // are outside of a small dead zone
    boolean badControlStart = false;
    unsigned long throttlePwmStart[RC_START_LENGTH];
    int throttlePwmStartIndex = 0;
    unsigned long steeringPwmStart[RC_START_LENGTH];
    int steeringPwmStartIndex = 0;

    // Default constructor ... does nothing.  This allows us to delay setting the pins until we want to (via the init method).
    RemoteControl() {
    }

    // initial setup
    void init(int steeringPin, int throttlePin, bool throttleOnly) {
      pinRCSteering = steeringPin;
      pinRCThrottle = throttlePin;
      childThrottleOnly = throttleOnly;
    }

    void initAveragingArrays() {
      for (int i = 0; i < RC_THROTTLE_READINGS; i++) {
        throttleReadings[i] = throttleCenter;
      }
      for (int i = 0; i < RC_STEERING_READINGS; i++) {
        steeringReadings[i] = steeringCenter;
      }
    }
    
    void setSteeringRange(int sMin, int sCenter, int sMax) {
      steeringMin = sMin;
      steeringCenter = sCenter;
      steeringMax = sMax;
    }

    void setThrottleRange(int tMin, int tCenter, int tMax) {
      throttleMin = tMin;
      throttleCenter = tCenter;
      throttleMax = tMax;
    }
    
    /*
     * get the current steering position (scaled units -100 to 100)
     */
    int getSteeringScaled() {
      return steeringScaled;
    }
    
    int updateSteeringScaled() {
      int steeringRaw = steeringPwm;
      
      // Value is not in the expected range return 0 as a safe value
      if (steeringRaw == 0 || steeringRaw >= RC_LIMIT) {
        return 0; 
      }

      if (steeringRaw < steeringCenter) {
        steeringScaled = constrain(map(steeringRaw, steeringMin, steeringCenter, -100, 0), -100, 0);
      } else if (steeringRaw > steeringCenter) {
        steeringScaled = constrain(map(steeringRaw, steeringCenter, steeringMax, 0, 100), 0, 100);        
      } else {
        steeringScaled = 0;
      }

      if (steeringScaled >= RC_STEERING_DEADZONE_LOW && steeringScaled <= RC_STEERING_DEADZONE_HIGH) {
        steeringScaled = 0;
        numberOfSteeringInputs = 0;
      } else {
        if (!childThrottleOnly) {
          numberOfSteeringInputs++;
          if (numberOfSteeringInputs > CONSECUTIVE_SIGNALS_REQUIRED) {
            lastSignificantInputMillis = millis();
          }
        }
      }
      
      return steeringScaled;
    }

    /*
     * get the current throttle position (scaled units -100 to 100)
     */
    int getThrottleScaled() {
      return throttleScaled;
    }
    
    int updateThrottleScaled() {  
      int throttleRaw = throttlePwm;

      // Value is not in the expected range return 0 as a safe value
      if (throttleRaw == 0 || throttleRaw >= RC_LIMIT) {
        return 0; 
      }

      if (throttleRaw < throttleCenter) {
        throttleScaled = constrain(map(throttleRaw, throttleMin, throttleCenter, -100, 0), -100, 0);
      } else if (throttleRaw > throttleCenter) {
        throttleScaled = constrain(map(throttleRaw, throttleCenter, throttleMax, 0, 100), 0, 100);        
      } else {
        throttleScaled = 0;
      }

      if (throttleScaled >= RC_THROTTLE_DEADZONE_LOW && throttleScaled <= RC_THROTTLE_DEADZONE_HIGH) {
        throttleScaled = 0;
        numberOfThrottleInputs = 0;
      } else {
        numberOfThrottleInputs++;
        if (numberOfThrottleInputs > CONSECUTIVE_SIGNALS_REQUIRED) {
          lastSignificantInputMillis = millis();
        }
      }

      return throttleScaled;
    }

    boolean isBadRcStart() {
      return badControlStart;
    }

    /*
     * Is the remote control "hot" ... meaning does the parent have control.  This also accounts for the timeout... e.g. has the parent had control recently.
     */
    boolean isActive() {
       
      //If we've not yet centered the controls, then we're not active yet
      if (!hasCentered) {
        if (steeringScaled == 0 && throttleScaled == 0) {
          hasCentered=true;          
        } else {
          return false;         
        }
      }

      // we're active if we've had a significant input recently enough
      if (millis() - lastSignificantInputMillis < RC_OVERRIDE_TIMEOUT) {
        return true;
      }
      
      return false;
    }

    /* 
     * Handler for IRQ updates for steering.
     * 
     * NOTE: This code is considered critical (should not be interrupted), but does not disable interrupts.  This is because we assume it's being 
     *       called in an IRQ handler and therefore interrupts are already disabled until we exit.  We are doing the math to figure out the pulse width
     *       and the scaled signal here, which is based on the assumption that the board in use (e.g. teensy) is much faster in clock speed than the 
     *       resolution of the PWM signal.  
     */
    void steeringIRQHandler() {
      if(digitalRead(pinRCSteering) == 1){
        if (!steeringSignalHigh) {
          // rising edge of the PWM signal
          // record when the pulse started
          steeringPulseStart = micros();
          steeringSignalHigh = true;
        }
        
      } else if (steeringSignalHigh) {
        // falling edge of the PWM signal
        // record the duty cycle in microseconds
        steeringPwm = micros() - steeringPulseStart;

        if (steeringPwmStartIndex < 10) {
          steeringPwmStart[steeringPwmStartIndex] = steeringPwm;
          steeringPwmStartIndex++;

          // CRITICAL NOTE: If the RC steering is not centered when it is turned on
          // then when it is turned off it will return a non-centered result.
          // !!!!! IMPORTANT !!!!! This means that when the RC remote is turned off in this
          // case and the car is still it will turn the wheel in that direction
          // and prevent the child from controlling via the joystick
          if (steeringPwm < 1400 || steeringPwm > 1600) {
            badControlStart = true;
          }
        }

        // reset for the next pulse
        steeringSignalHigh = false;
      }
      
    }
   
    /* 
     * Handler for IRQ updates for throttle.
     * 
     * NOTE: This code is considered critical (should not be interrupted), but does not disable interrupts.  This is because we assume it's being 
     *       called in an IRQ handler and therefore interrupts are already disabled until we exit.  We are doing the math to figure out the pulse width
     *       and the scaled signal here, which is based on the assumption that the board in use (e.g. teensy) is much faster in clock speed than the 
     *       resolution of the PWM signal.  
     */
    void throttleIRQHandler() {
      if(digitalRead(pinRCThrottle) == 1){
        if (!throttleSignalHigh) {
          // rising edge of the PWM signal
          // record when the pulse started
          throttlePulseStart = micros();
          throttleSignalHigh = true;
        }
      } else if (throttleSignalHigh) {
        // falling edge of the PWM signal
        // record the duty cycle in microseconds
        throttlePwm = micros() - throttlePulseStart;

        if (throttlePwmStartIndex < 10) {
          int badPwmCount = 0;
          throttlePwmStart[throttlePwmStartIndex] = throttlePwm;
          throttlePwmStartIndex++;

          // CRITICAL NOTE: If the RC throttle is not centered when it is turned on
          // then when it is turned off it will return a non-centered result.
          // !!!!! IMPORTANT !!!!! This means that when the RC remote is turned off in this
          // case and the car is still it will drive in that direction with the child having
          // no control via the joystick.
          if (throttlePwm < 1400 || throttlePwm > 1600) {
            badPwmCount++;
            // Because of spurious I2S signals, we don't want to declare a bad start from
            // a single bad reading
            if (badPwmCount > 1) {
              badControlStart = true;
            }
          }
        }

        // reset for the next pulse
        throttleSignalHigh = false;
      }
    }
    
    void getBadStartData(char *buffer) {
      sprintf(buffer, "%i %i %i %i %i %i %i %i %i %i", throttlePwmStart[0], throttlePwmStart[1], throttlePwmStart[2], throttlePwmStart[3], throttlePwmStart[4], throttlePwmStart[5], throttlePwmStart[6], throttlePwmStart[7], throttlePwmStart[8], throttlePwmStart[9]);
    }

    
    void getStatus(char * status) {
      sprintf(status, "[RemoteControl] throttleRaw:%lu throttleScaled:%i steeringRaw:%lu steeringScaled:%i last input: %lu counts: %lu %lu isActive:%s Bad Start:%s Has Centered: %s",
        throttlePwm,
        throttleScaled,
        steeringPwm,
        steeringScaled,
        lastSignificantInputMillis,
        numberOfSteeringInputs,
        numberOfThrottleInputs,
        isActive() ? "true" : "false",
        badControlStart ? "true" : "false",
        hasCentered ? "true" : "false");
    }  
};
