synthesissolutions/geeksforkids/software/STM32Workspace/STM32G031G8_DriveByWireRyder/Core/Src/main.c

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
/* Includes ------------------------------------------------------------------*/
#include "main.h"

/* USER CODE BEGIN PD */
#define MIN_SIN_SENSOR	425
#define MAX_SIN_SENSOR	630
#define MIN_SENSOR	350
#define MAX_SENSOR	700

// Read the Go Button and Reverse Switch and select one of the three options
#define THROTTLE_OFF 500
#define THROTTLE_FORWARD 800
#define THROTTLE_REVERSE 200

// Take the reading from the magnetic sensor and apply it's reading to the
// range below.
#define STEERING_LEFT 200
#define STEERING_RIGHT 800

#define CONFIG_THRESHOLD 1000
/* USER CODE END PD */

ADC_HandleTypeDef hadc1;
DMA_HandleTypeDef hdma_adc1;

TIM_HandleTypeDef htim3;

void SystemClock_Config(void);
static void MX_GPIO_Init(void);
static void MX_DMA_Init(void);
static void MX_TIM3_Init(void);
static void MX_ADC1_Init(void);
/* USER CODE BEGIN 0 */
long map(long x, long in_min, long in_max, long out_min, long out_max) {
  return (x - in_min) * (out_max - out_min) / (in_max - in_min) + out_min;
}
/* USER CODE END 0 */

/**
  * @brief  The application entry point.
  * @retval int
  */
int main(void)
{

  /* USER CODE BEGIN 1 */
	uint16_t pwmSteering = (STEERING_LEFT + STEERING_RIGHT) / 2;
	uint16_t pwmThrottle = THROTTLE_OFF;
	int throttleOn = 0;

	uint32_t configPressStartTime;
	uint8_t isConfigPressed = 0;
	uint8_t isInConfig = 0;

	uint32_t sensorData[2];
	uint32_t prevRawCosData;
	uint32_t rawSinData;
	uint32_t rawCosData;
	uint32_t finalData;
	uint8_t  startupComplete = 0;
  /* USER CODE END 1 */

  /* MCU Configuration--------------------------------------------------------*/

  /* Reset of all peripherals, Initializes the Flash interface and the Systick. */
  HAL_Init();

  /* Configure the system clock */
  SystemClock_Config();

  /* Initialize all configured peripherals */
  MX_GPIO_Init();
  MX_DMA_Init();
  MX_TIM3_Init();
  MX_ADC1_Init();
  /* USER CODE BEGIN 2 */
  HAL_TIM_PWM_Start(&htim3, TIM_CHANNEL_1);
  HAL_TIM_PWM_Start(&htim3, TIM_CHANNEL_3);

  HAL_ADC_Start_DMA(&hadc1, sensorData, 2);
  /* USER CODE END 2 */

  /* Infinite loop */
  /* USER CODE BEGIN WHILE */
  while (1)
  {
		// Get ADC values
		rawSinData = sensorData[0];
		prevRawCosData = rawCosData;
		rawCosData = sensorData[1];

	  	if (! HAL_GPIO_ReadPin(CONFIG_BUTTON_GPIO_Port, CONFIG_BUTTON_Pin)) {
	  		if (!isConfigPressed) {
	  			isConfigPressed = 1;
	  			configPressStartTime = HAL_GetTick();
	  		}
	  		HAL_GPIO_WritePin(LED_LEFT_GPIO_Port, LED_LEFT_Pin, GPIO_PIN_SET);

	  		if (HAL_GetTick() - configPressStartTime > CONFIG_THRESHOLD) {
	  			isInConfig = 1;
	  			HAL_GPIO_WritePin(LED_RIGHT_GPIO_Port, LED_RIGHT_Pin, GPIO_PIN_SET);
	  		}
	  	} else {
	  		isConfigPressed = 0;
	  		HAL_GPIO_WritePin(LED_LEFT_GPIO_Port, LED_LEFT_Pin, GPIO_PIN_RESET);
	  	}

		/*
		if (rawSinData < MIN_SIN_SENSOR) {
			finalData += rawCosData - prevRawCosData;
		} else if (rawSinData > MAX_SIN_SENSOR) {
			finalData -= rawCosData - prevRawCosData;
		} else {
			finalData = rawSinData;
			startupComplete = 1;
		}
		*/

		finalData = rawSinData;
		startupComplete = 1;

		if (startupComplete) {
			pwmSteering = map(finalData, MIN_SENSOR, MAX_SENSOR, STEERING_LEFT, STEERING_RIGHT);
		} else {
			pwmSteering = (STEERING_LEFT + STEERING_RIGHT)  / 2;
		}


		if (pwmSteering > STEERING_RIGHT) {
			pwmSteering = STEERING_RIGHT;
		} else if (pwmSteering < STEERING_LEFT) {
			pwmSteering = STEERING_LEFT;
		}

		HAL_ADC_Start_DMA(&hadc1, sensorData, 2);

		throttleOn = ! HAL_GPIO_ReadPin(GO_BUTTON_GPIO_Port, GO_BUTTON_Pin);

		// No longer using the reverse switch on the steering column
		if (throttleOn) {
			pwmThrottle = THROTTLE_FORWARD;
		} else {
			pwmThrottle = THROTTLE_OFF;
		}

		__HAL_TIM_SET_COMPARE(&htim3, TIM_CHANNEL_3, pwmSteering);
		__HAL_TIM_SET_COMPARE(&htim3, TIM_CHANNEL_1, pwmThrottle);
    /* USER CODE END WHILE */

    /* USER CODE BEGIN 3 */
  }
  /* USER CODE END 3 */
}

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
