synthesissolutions/geeksforkids/software/Arduino/car_firmware_ryder_rp2040_m5dial/z_setup_loop.ino

/**
 * THIS SHOULD BE THE LAST FILE TO LOAD.  
 * 
 * This contains the Arduino required setup() and loop() functions.  These functions depend upon everything else already being loaded, 
 *   so should be last in the compile process.
 * 
 */

/*
 * Objects that we'll need.  They'll auto construct, but the pattern we're using will require them to have their init() method called.
 */
Eeprom eeprom;
Configuration configuration;
M5DialConfiguration m5DialConfiguration;
Joystick joystick;
Steering steering;
Throttle throttle;
RemoteControl remoteControl;
Logger logger;
GpioExpander gpioExpander;
Led led;
SoundButtons soundButtons;
SoundProcessing soundProcessing;
SoundProcessingPcm soundProcessingPcm;

boolean isLogging = false;
boolean isConfiguring = false;

boolean checkForExtendedThrottle = false;
int extendThrottleTimeMilliseconds = 0;
int extendThrottleValueScaled = 0;
int extendSteeringValueScaled = 0;
int lastThrottleOnMillis = 0;
int yAxisScaled = 0;
int xAxisScaled = 0;
long millisTemp = 0;
long loopCount = 0;

/*
 * Interrupt request handlers.  The Arduino environment appears to require these to be global methods with no parms, so defining them here.
 *   Really just wrappers to call the proper RemoteControl methods.  
 */
 void handleRCSteeringInterrupt() { remoteControl.steeringIRQHandler(); }
 void handleRCThrottleInterrupt() { remoteControl.throttleIRQHandler(); }
 void handleJoystickSteeringInterrupt() { joystick.steeringIRQHandler(); }
 void handleJoystickThrottleInterrupt() { joystick.throttleIRQHandler(); }

/*
 * Now a couple of variables that help us do a bit of logging
 */
boolean rcInControl = false;
boolean joystickInControl = false;
boolean badStartMessageDisplayed = false;

boolean muteDac = false;
boolean dacMuted = false;

long tempMillis;

/*
 * Arduino defined setup function.  Automatically run once at restart of the device.
 */
void setup1() {
  soundProcessing.init();
}

void loop1() {
  if (!isConfiguring) {
    if (!soundProcessing.mp3Playing()) {
      if (soundButtons.getSoundAButtonPressed()) {
        soundProcessing.playSoundButtonA();
      } else if (soundButtons.getSoundBButtonPressed()) {
        soundProcessing.playSoundButtonB();
      } else if (soundButtons.getTrigger1Activated()) {
        soundProcessing.playActionTrigger1();
      } else if (soundButtons.getTrigger2Activated()) {
        soundProcessing.playActionTrigger2();
      } else {
        muteDac = true;
      }
    } else {
      muteDac = false;
    }
  }

  soundProcessing.processSoundRequests();
}

void setup() {
  // Control Connected setup
  // Each control system (joystick, control panel, etc.) must take this pin high to show they are connected
  pinMode(PIN_ACTIVE_SWITCH, INPUT_PULLDOWN);
  Wire.setSDA(PIN_I2C_SDA);
  Wire.setSCL(PIN_I2C_SCL);
  Wire.begin();   // Initialize I2C
      
  // set up the logger
  logger.init(LOGGER_UPDATE_TIME, &eeprom, &configuration, &joystick, &remoteControl, &steering, &throttle, &gpioExpander, &led, &soundButtons, &soundProcessingPcm, &soundProcessing);

  eeprom.init();
  logger.addLogLine("Eeprom initialized");
    
  configuration.init(&eeprom);
  logger.addLogLine("configuration initialized");

  soundProcessingPcm.init();
  gpioExpander.init();

  soundButtons.init(&gpioExpander);

  joystick.init(PIN_JOYSTICK_STEERING, PIN_JOYSTICK_THROTTLE, &gpioExpander);
  logger.addLogLine("joystick initialized");

  if (configuration.useRc()) {
    if (configuration.getReverseRcChannels()) {
      remoteControl.init(PIN_RC_THROTTLE, PIN_RC_STEERING, configuration.getChildThrottleOnly());
    } else {
      remoteControl.init(PIN_RC_STEERING, PIN_RC_THROTTLE, configuration.getChildThrottleOnly());
    }
    logger.addLogLine("remote control initialized");
  }

  led.init();
  led.setPowerPixel(0, 255, 0);
  led.setStatusPixel(0, 255, 0);

  throttle.init(PIN_THROTTLE_DIRECTION_FRONT, PIN_THROTTLE_PWM_FRONT, PIN_THROTTLE_DIRECTION_REAR, PIN_THROTTLE_PWM_REAR, configuration.getThrottleCoastMs(), configuration.getBrakeIntensity());
  logger.addLogLine("throttle initialized");
  
  steering.init(PIN_STEERING_DIRECTION, PIN_STEERING_PWM, PIN_STEERING_POSITION);
  logger.addLogLine("steering initialized");

  m5DialConfiguration.init(&configuration, &joystick, &steering);

  // Set steering limits from configuration
  steering.setSteeringCenterScaled(configuration.getSteeringCenter());
  steering.setSteeringMinScaled(configuration.getSteeringMin());
  steering.setSteeringMaxScaled(configuration.getSteeringMax());
  steering.initAveragingArrays();

  // Set Joystick configuration
  joystick.setXAxisRange(configuration.getJoystickSteeringMin(), configuration.getJoystickSteeringCenter(), configuration.getJoystickSteeringMax());
  joystick.setYAxisRange(configuration.getJoystickThrottleMin(), configuration.getJoystickThrottleCenter(), configuration.getJoystickThrottleMax());
  joystick.setInvertXAxis(configuration.getInvertJoystickX());
  joystick.setInvertYAxis(configuration.getInvertJoystickY());
  joystick.setUseDashShifterDirection(configuration.getUseDashDirection());

  checkForExtendedThrottle = configuration.getExtendThrottle() && configuration.usePwmJoystickY() && configuration.usePwmJoystickX();
  extendThrottleTimeMilliseconds = configuration.getExtendThrottleTimeMilliseconds();

  // Set RC/Parental Control Configuration
  remoteControl.setSteeringRange(configuration.getRcSteeringMin(), configuration.getRcSteeringCenter(), configuration.getRcSteeringMax());
  remoteControl.setThrottleRange(configuration.getRcThrottleMin(), configuration.getRcThrottleCenter(), configuration.getRcThrottleMax());
  remoteControl.initAveragingArrays();

  led.showPixels();
  delay(250); // give time for external device like M5Dial to startup

  configuration.update();

  delay(10);

  // All motors have been initialized to a non-moving state, ready to enable to the motor drivers`
  gpioExpander.setMotorSleep(HIGH);
  
  // set up the interrupt handlers
  if (configuration.useRc()) {
    if (configuration.getReverseRcChannels()) {
      attachInterrupt(digitalPinToInterrupt(PIN_RC_THROTTLE), &handleRCSteeringInterrupt, CHANGE);
      attachInterrupt(digitalPinToInterrupt(PIN_RC_STEERING), &handleRCThrottleInterrupt, CHANGE);
    } else {
      attachInterrupt(digitalPinToInterrupt(PIN_RC_STEERING), &handleRCSteeringInterrupt, CHANGE);
      attachInterrupt(digitalPinToInterrupt(PIN_RC_THROTTLE), &handleRCThrottleInterrupt, CHANGE);
    }
  }

  if (configuration.usePwmJoystickX()) {
    attachInterrupt(digitalPinToInterrupt(PIN_JOYSTICK_STEERING), &handleJoystickSteeringInterrupt, CHANGE);    
    joystick.setUseSteeringPwm(true);
  } else {
    joystick.setUseSteeringPwm(false);    
  }

  if (configuration.usePwmJoystickY()) {
    attachInterrupt(digitalPinToInterrupt(PIN_JOYSTICK_THROTTLE), &handleJoystickThrottleInterrupt, CHANGE);        
    joystick.setUseThrottlePwm(true);
  } else {
    joystick.setUseThrottlePwm(false);    
  }

  joystick.initAveragingArrays();
}

/*
 * Arduino defined loop function.  Automatically run repeatedly (after setup).
 */
void loop() {
  if (!isConfiguring && !isLogging && Serial) {
    // We have detected a Serial connection, check to see if we want logging or configuration
    led.setStatusPixel(0, 0, 255);
    led.showPixels();
    //delay(10);
    Serial.println("Press c to configure or any other key to run with logging");
    throttle.forceStop();
    steering.forceStop();

    while (!isConfiguring && !isLogging) {
      if (Serial.available() > 0) {
        if (Serial.read() == 'c') {
          Serial.println("Start Configuring");
          isConfiguring = true;
        } else {
          Serial.println("Start Logging");
          isLogging = true;
        }
      }
    }

    // Read and discard other input. This will also include the carriage return
    while (Serial.available() > 0) {
      Serial.read();
    }
  }
  
  if (isConfiguring) {
    // When configuration is active, the car cannot be driven.
    throttle.forceStop();
    steering.forceStop();

    gpioExpander.setDacMute(true);
    gpioExpander.setAmpSd(true);

    led.setStatusPixel(128, 0, 128);
    led.showPixels();
    delay(10);

    configuration.configureCar();
    // We will never return from this method.
    // The microcontroller will have to be reset for the car to begin running normally again
  } else if (configuration.getIsM5DialConfigurationMode()) {
    // When M5 Dial Configuration is active, the car cannot be driven.
    throttle.forceStop();
    steering.forceStop();

    m5DialConfiguration.m5DialConfigureCar();
    // We will never return from this method.
    // The microcontroller will have to be reset for the car to begin running normally again    
  } else if (configuration.useRc() && remoteControl.isBadRcStart()) {
    // A bad RC start is when the throttle trigger on the RC remote is pulled 
    // when the remote is turned on. This creates a situation where the 
    // failsafe setting used if the RC remote is turned off or loses connection,
    // will cause the car will drive at whatever speed was set when the remote was switched on.
    // To prevent this from happening, we disable the car if this is detected.
    // A full power cycle is required to break out of this condition.
    logger.addLogLine("Bad Start");
    throttle.forceStop();
    steering.forceStop();
  } else {
    // recalculate the scaled RC throttle and steering values
    // this is necessary to know whether or not the RC is active
    if (configuration.useRc()) {
      remoteControl.updateThrottleScaled();
      remoteControl.updateSteeringScaled();
    }
    
    // Is the parent overriding and taking control?
    if (configuration.useRc() && remoteControl.isActive()) {
      // while the RC is active, we want to keep averaging the childs controls
      lastThrottleOnMillis = 0;
      joystick.getXAxisScaled();
      joystick.getYAxisScaled();
      
      // Yep, the parent has taken over ... parent inputs only
      if (joystickInControl) {
        logger.addLogLine("RC has gone active, taking over from Joystick");
        joystickInControl=false;
        rcInControl=true;
      }
  
      // set the inputs from the RC
      steering.setSteeringPosition(remoteControl.getSteeringScaled());
      throttle.setThrottle(remoteControl.getThrottleScaled());
    } else if (!digitalRead(PIN_ACTIVE_SWITCH)) {
      // The Active Switch must be pulled high by the connected control system. Otherwise, we stop the car.
      logger.addLogLine("No control system connected. Force car to stop.");
      throttle.forceStop();
      steering.forceStop();
  
      // Take a few more steps so the logging can still be used without a control system attached
      joystick.getXAxisScaled();
      joystick.getYAxisScaled();
    } else {
      // Nope... the parent isn't controlling
      // check to see if the joystick active (e.g. has it centered at least once?)
      if (joystick.isActive()) {  
        // Yeah!  The kid is in control!
        if (rcInControl) {
          logger.addLogLine("Joystick is now in control, taking over from RC");
          joystickInControl=true;
          rcInControl=false;
        }

        if (configuration.getChildThrottleOnly()) {
          xAxisScaled = remoteControl.getSteeringScaled();
        } else {
          xAxisScaled = joystick.getXAxisScaled();          
        }
        
        yAxisScaled = joystick.getYAxisScaled();

        // Check for extended throttle and track if necessary
        if (checkForExtendedThrottle) {
          millisTemp = millis();
          
          if (abs(yAxisScaled) > 75) {
            lastThrottleOnMillis = millisTemp;
            extendThrottleValueScaled = yAxisScaled;
            extendSteeringValueScaled = xAxisScaled;
          } else if(millisTemp > 5000 && millisTemp - lastThrottleOnMillis < extendThrottleTimeMilliseconds) {
            // Override the current throttle and steering values with the saved values until the extended time expires
            xAxisScaled = extendSteeringValueScaled;
            yAxisScaled = extendThrottleValueScaled;
          }
        }

        // set the inputs from the Joystick
        // we need to get the speed multiplier each time,
        // because the speed potentiometer can be turned at any time to adjust the max speed
        steering.setSteeringPosition(xAxisScaled);
        throttle.setThrottle(yAxisScaled * configuration.getSpeedMultiplier());
      } else {
  
        // Whoops ... we got here becuase neither control is active.  Nobody is going anywhere until that changes.
        logger.addLogLine("RC in not active, Joystick is not active");
      }
    }      
  }

  // When Configuration is active we use the Serial output for logging message directly from that module
  if (isLogging) {
    // Only write the log messages if there is an active serial connection
    logger.writeLog();
  }

  // Don't need to update the configuration every time through the loop
  if (loopCount % 50 == 0) {
    configuration.update();
  }

  // Check for various error conditions and set the error neopixel
  // check in priority order
  if (gpioExpander.getMotorFault()) {
    led.setErrorPixel(255, 0, 0);    
  } else if (gpioExpander.getMotorChopping()) {
    led.setErrorPixel(255, 153, 28);    
  } else if (!digitalRead(PIN_ACTIVE_SWITCH)) {
    led.setErrorPixel(128, 128, 0);    
  } else {
    led.setErrorPixel(0, 0, 0);
  }

  if (muteDac && !dacMuted) {
    gpioExpander.setDacMute(true);
    dacMuted = true;
  } else if (dacMuted) {
    gpioExpander.setDacMute(false);
    dacMuted = false;
  }
  soundProcessingPcm.setVolume(configuration.getVolume());
  led.showPixels();
  soundButtons.processSoundButtons();
  loopCount++;
}
