synthesissolutions/geeksforkids/software/Arduino/car_firmware_ryder_rp2040_m5dial/t_throttle.ino

/**
 * Throttle class
 * 
 * This class serves to be the actual interface to driving the throttle for the car.  The intent of this class is to 
 *   allow for a throttle position to be set in scaled units (-100 to 100), and this class will take care of making the 
 *   changes to the steering as appropriate.
 *   
 *   A key feature of this class is the idea of moving the throttle to a new value over time (rather than an imeediate change), 
 *     to help minimize jerky behavior.  
 */
 
#define DRIVE_MOTOR_STATE_STOPPED   0
#define DRIVE_MOTOR_STATE_STOPPING  1
#define DRIVE_MOTOR_STATE_MOVING    2

class Throttle {

  private:

    int frontForwardPin;
    int frontReversePin;
    int rearForwardPin;
    int rearReversePin;

    int throttleTargetScaled = 0;
    float currentThrottleScaled = 0;
    int currentPwmOut = 0;

    int currentMotorState = DRIVE_MOTOR_STATE_STOPPED;
    int motorCoastTimeMs = 0;
    int brakingIntensity = 7;
    long motorStoppingStartMs = 0;
    int motorBrakePulseCount = 0;

    unsigned long lastThrottleUpdateMillis = 0;
  public: 

    // default constructor that really does nothing
    Throttle() {
    }

    // Used during a bad start scenario or when the car is being configured
    void forceStop() {
      // Set both Pins HIGH for brake, LOW for coast
      currentMotorState = DRIVE_MOTOR_STATE_STOPPED;
      digitalWrite(frontForwardPin, HIGH);
      digitalWrite(frontReversePin, HIGH);
      digitalWrite(rearForwardPin, HIGH);
      digitalWrite(rearReversePin, HIGH);
    }
    
    // initial setup
    void init(int dirLeftPin, int pwmLeftPin, int dirRightPin, int pwmRightPin, int coastMs, int bi) {
      // set the pins
      frontForwardPin = dirLeftPin;
      frontReversePin = pwmLeftPin;
      rearForwardPin = dirRightPin;
      rearReversePin = pwmRightPin;

      // set the pin modes
      pinMode(frontForwardPin, OUTPUT);
      pinMode(frontReversePin, OUTPUT);
      pinMode(rearForwardPin, OUTPUT);
      pinMode(rearReversePin, OUTPUT);

      motorCoastTimeMs = coastMs;
      brakingIntensity = bi;

      // make sure the motors are all off
      forceStop();

      // and do an initial update to get the timer kicked off
      updateThrottle();
    }

    /*
     * set the scaled throttle target.  Expected range is -100 to 100, 0=stopped
     */
    void setThrottle(int target) {
      if (target < -100) target = -100;
      if (target > 100) target = 100;
      
      this->throttleTargetScaled = target;

      updateThrottle();
    }

    /*
     * gets the current throttle
     */
    int getCurrentThrottleScaled() {
      return this->currentThrottleScaled;
    }

    /* 
     * updateThrottle
     * 
     * This is usually not necessary to call as it will get called by setThrottleScaled().  But it is safe to call as necessary.
     */
    void updateThrottle() {
      // Looks like it's time to update the throttle.  Now ... figure out the new current throttle should be.
      if (lastThrottleUpdateMillis == 0 || millis() - lastThrottleUpdateMillis > THROTTLE_UPDATE_MILLIS * 3) {
        // Case 1: just starting up.  Set the throttle to 0, and get set up for further running
        //         or we have a very large delta - this happens when there is no drive system and the remote is used for the first time
        currentThrottleScaled = 0;
      } else {
        // Case 2: not staring up, so let's do some work
        float throttleDelta = 2;
         
        // Figure out what to do with the current throttle (which direction do we apply the delta)
        /*
         * NOTE: This is the simplest application of a throttle rate change that is possible.  Nothing fancy, just decide in which direction to apply the 
         *        throttle change and apply it.  No special logic about stopping or anything.
         */
        if (throttleTargetScaled < currentThrottleScaled) {
          // calling for the throttle to be reduced in value
          currentThrottleScaled -= throttleDelta;        
        } else if (throttleTargetScaled > currentThrottleScaled) {
          // calling for the throttle to be increased in value
          currentThrottleScaled += throttleDelta;
        }
      }

      // figure out the throttle pwm setting (ignoring the direction)
      currentPwmOut = map(abs(currentThrottleScaled), 0.0, 100.0, THROTTLE_PWM_MIN, THROTTLE_PWM_MAX);

      // now set the direction and the throttle
      if (int(currentThrottleScaled)==0) {
        // stop
        bool motorStop = true;  // set to false to coast

        if (currentMotorState == DRIVE_MOTOR_STATE_MOVING) {
          // start coasting
          motorStop = false;
          motorStoppingStartMs = millis();
          currentMotorState = DRIVE_MOTOR_STATE_STOPPING;
          motorBrakePulseCount = 0;
        } else if (currentMotorState == DRIVE_MOTOR_STATE_STOPPING) {
          if (millis() - motorStoppingStartMs > motorCoastTimeMs) {
            // apply brake
            motorStop = true; 
            currentMotorState = DRIVE_MOTOR_STATE_STOPPED;
          } else {
            // brakingIntensity is a number from 1 to 10
            // convert that into an inverted number from 1 to 10 for the modulus operation
            // the higher the modulus number, the weaker the braking
            if(motorBrakePulseCount % (11 - brakingIntensity) == 0) {
              motorStop = true;
            } else {
              motorStop = false;
            }
            
            motorBrakePulseCount++;
          }
        }

        if (motorStop) {
          // break
          digitalWrite(frontForwardPin, HIGH);
          digitalWrite(frontReversePin, HIGH); 
          digitalWrite(rearForwardPin, HIGH);
          digitalWrite(rearReversePin, HIGH);                
        } else {
          // coast
          digitalWrite(frontForwardPin, LOW);
          digitalWrite(frontReversePin, LOW); 
          digitalWrite(rearForwardPin, LOW);
          digitalWrite(rearReversePin, LOW);                          
        }
      } else if (currentThrottleScaled < 0) {
        //reverse
        currentMotorState = DRIVE_MOTOR_STATE_MOVING;
        digitalWrite(frontForwardPin, LOW);
        analogWrite(frontReversePin, currentPwmOut);   
        analogWrite(rearForwardPin, currentPwmOut);       
        digitalWrite(rearReversePin, LOW);
      } else if (currentThrottleScaled>0) {
        //forward
        currentMotorState = DRIVE_MOTOR_STATE_MOVING;
        analogWrite(frontForwardPin, currentPwmOut);       
        digitalWrite(frontReversePin, LOW);
        digitalWrite(rearForwardPin, LOW);
        analogWrite(rearReversePin, currentPwmOut);             
      }

      lastThrottleUpdateMillis = millis();
    }

    void getStatus(char * status) {
      sprintf(status, "[Throttle] target:%i current:%f PWM:%i Brake Pulses: %i Coast Time: %i Braking Intensity: %i Motor State: %s",
        throttleTargetScaled,
        currentThrottleScaled,
        currentPwmOut,
        motorBrakePulseCount,
        motorCoastTimeMs,
        brakingIntensity,
        currentMotorState == DRIVE_MOTOR_STATE_STOPPED ? "stopped" : currentMotorState == DRIVE_MOTOR_STATE_STOPPING ? "*stopping*" : "moving");
    }
};
