synthesissolutions/geeksforkids/software/Arduino/car_firmware_ryder_rp2040_m5dial/aa_todo.ino

 /*
  * TODO:  Previous code had a "runaway" safety where if the same rc input was detected for too long (something like 2000 samples or 40 seconds) it would
  *         assume the rc input was faulty and ignore it until some kind of change was detected.  Should that still be done?  If so, the best place for
  *         that logic is probably in the isActive code for the remote control.
  *         
  *        The previous code also had an array to keep track of the pwm samples.  I think was was in anticipation of either averaging or doing some
  *         kind of sampling.  That code has not been repeated here.  We need to verify that is OK, and something hasn't been missed.
  */

/*

- figure out why the SoundProcessing status isn't printing properly - not urgent
- add the ability to show multiple error conditions - changing color each second to cycle through error conditions - not urgent

 */  
