synthesissolutions/geeksforkids/(commit log)

2019-05-18 arduino code from 2018 for reference
2019-05-18 isolated test code for joystick control of the LN298N motor controller with the linear actuator
2019-05-18 isolated test code for joystick control of the drive motors with motor controller
2019-05-18 combined test code for teensy with RC and Joystick input
2019-05-24 tuning and pin assignments. dip switch support. bug fixes
    [a_constants.ino, j_joystick.ino, s_steering.ino, x_logger.ino, z_setup_loop.ino]
2019-05-24 added invert steering
2019-05-24 rework of inversion ... joystick axes and rc steering/throttle can now be inverted. Removed the invert from the steering class. Joystick x-axis is now set to be inverted.
    [a_constants.ino, j_joystick.ino, r_remote_control.ino, s_steering.ino, x_logger.ino, z_setup_loop.ino]
2019-05-27 removing hard coded PWM values, adding logic to deal with asymmetrical throttle readings, updating pins for RC throttle and steering
2019-05-27 adding configuration class to handle configuration values based on the dip switches, implemented max speed multiplier configuration
2019-05-27 adding configuration, logging and functionality for the steering potentiometer and go button setup
2019-05-27 moving X/Y axis inversion from being set only through the constants to using the configuration object/dip switches
2019-05-29 reversing dip switch readings so the off position returns 0 and setting defaults so all dip switches down is the normal configuration
    [a_constants.ino, e_configuration.ino]
2019-06-01 adding additional log info to steering potentiometer configuration
2019-06-01 changes for steering potentiometer reality
2019-06-01 inverting the steering on the potetiometer
2019-06-01 manual steering adjustment for carter's car, need a much better way to handle this
2019-06-09 tuning the steering center deadzone to try to make the steering a bit more responsive
2019-06-09 swapping hard coded steering min and max with constants, commenting out some code
    [s_steering.ino]
2019-06-09 swapping logic on isReverse call for steering by potentiometer
2019-06-09 CRITICAL PATCH to prevent the car from moving unexpectedly if the RC remote is turned off based on special case start conditions
    [r_remote_control.ino, z_setup_loop.ino]
2019-09-05 moving software to a subfolder in preparation for adding kicad pcb files
2019-09-05 adding kicad files to .gitignore
2019-09-05 adding kicad files for teensy 3.6 and 4.0 control boards and small joystick breakout board
    [ControlBoardT36.kicad_pcb, ControlBoardT36.sch, ControlBoardT4.kicad_pcb, ControlBoardT4.sch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]
2019-09-05 moving Arduino sketches to a subfolder under software
2019-09-13 removing dip switch configuration and changing pins assignments for the go button and reverse switch
    [a_constants.ino, e_configuration.ino, x_logger.ino, z_setup_loop.ino]
2019-09-15 adjusting pin assignments for teensy 4 pcb
2019-09-20 updated the 555 timer pin 2 configuration with the resistor
    [ControlBoardT4.kicad_pcb, ControlBoardT4.sch]
2019-10-06 adding buck converter power breakout PCB
    [PowerBreakout-B_Cu.gbr, PowerBreakout-B_Mask.gbr, PowerBreakout-B_Paste.gbr, PowerBreakout-B_SilkS.gbr, PowerBreakout-Edge_Cuts.gbr, PowerBreakout-F_Cu.gbr, PowerBreakout-F_Mask.gbr, PowerBreakout-F_Paste.gbr]
2019-10-06 generating new Gerber files for rev 2 board
    [ControlBoardT4-B_Cu.gbr, ControlBoardT4-B_Mask.gbr, ControlBoardT4-B_Paste.gbr, ControlBoardT4-B_SilkS.gbr, ControlBoardT4-Edge_Cuts.gbr, ControlBoardT4-F_Cu.gbr, ControlBoardT4-F_Mask.gbr, ControlBoardT4-F_Paste.gbr]
2019-10-08 updated pcb file from creating drill file
    [ControlBoardT4.kicad_pcb]
2019-10-09 Separate Headphone Jack
    Updated T4 Control board to use a distinct headphone jack and the cheaper Adafruit FX board.
2019-10-17 Switched direction of the headphone jack
    Pointed the headphone jack in the same direction as the RJ45 connector.
    [ControlBoardT4.kicad_pcb]
2019-10-22 fixing power breakout board and footprint with proper dimensions
    [PowerBreakout.kicad_pcb]
2019-11-01 Fixed headphone jack x-axis.
    Fixed headphone jack x-axis. Created new PJ320A footprint in 'Useful Modifications' library. Updated schematic to use the new footprint.
    [ControlBoardT4.kicad_pcb, ControlBoardT4.sch]
2019-11-02 control board gerbers and zipped power board gerbers
    [ControlBoardT4-B_Cu.gbr, ControlBoardT4-B_Mask.gbr, ControlBoardT4-B_Paste.gbr, ControlBoardT4-B_SilkS.gbr, ControlBoardT4-Edge_Cuts.gbr, ControlBoardT4-F_Cu.gbr, ControlBoardT4-F_Mask.gbr, ControlBoardT4-F_Paste.gbr]
2019-11-02 adding text to mark Motor A and B for the motor controller headers, generating new Gerbers
    [ControlBoardT4-B_Cu.gbr, ControlBoardT4-B_Mask.gbr, ControlBoardT4-B_Paste.gbr, ControlBoardT4-B_SilkS.gbr, ControlBoardT4-Edge_Cuts.gbr, ControlBoardT4-F_Cu.gbr, ControlBoardT4-F_Mask.gbr, ControlBoardT4-F_Paste.gbr]
2019-11-03 fixing hole size for screw terminals (manually modified footprint) and generating gerbers
    [PowerBreakout-B_Cu.gbr, PowerBreakout-B_Mask.gbr, PowerBreakout-B_Paste.gbr, PowerBreakout-B_SilkS.gbr, PowerBreakout-Edge_Cuts.gbr, PowerBreakout-F_Cu.gbr, PowerBreakout-F_Mask.gbr, PowerBreakout-F_Paste.gbr]
2019-11-04 teenys 4 pin updates and adding bluetooth pin constants
2019-11-04 adding PDFs of the schematics and PCBs for quick reference
2019-12-07 Switched Motor Label moved headphone jack
    Switched A and B on motor label. Adjusted the headphone jack holes to allow the headphone jack to plug in further.
    [ControlBoardT4.kicad_pcb]
2019-12-07 New Board to allow sounds on the simple builds
    New Board to allow sounds on the simple builds
    [SimpleBuildSounds.kicad_pcb, SimpleBuildSounds.sch]
2019-12-07 Added Revision Number
    Added Revision Number to the silk screen of the pcb.
    [SimpleBuildSounds.kicad_pcb]
2020-01-27 Detail Silk Screen Changes
    Added In/Out labels for Buck Converter. Added voltage references for voltage in. Labeled Go Button and other button.
    [SimpleBuildSounds.kicad_pcb]
2020-02-16 Updated Screw Terminal to 3 position
    Removed the two, 2 position screw terminals and replaced with a single 3 position screw terminal.
    [SimpleBuildSounds.kicad_pcb, SimpleBuildSounds.sch]
2020-02-16 Added 3 position Screw Terminal
    Added 3 position Screw terminal to library.
2020-04-08 New Complex Control Board with 28 Pin Sound
    New Board that takes the 28 Pin FXSound board instead of the 22 Pin FXSound board.
    [ControlBoardT4_28PinSound.kicad_pcb, ControlBoardT4_28PinSound.sch]
2020-04-08 Adapter Board for 28Pin to 22Pin Conversion
    New Adapter board to convert the larger 28 Pin FXSound board to fit the control boards that receive the 22 Pin FX Board.
    [SoundAdapter28Pto22P.kicad_pcb, SoundAdapter28Pto22P.sch]
2020-05-03 5v power trace fix
    Update to fix a lost trace
    [ControlBoardT4_28PinSound.kicad_pcb]
2020-06-11 for some bizarre reason line[i] = String(""); causes a hard crash, switching to lines[i] = "" works fine, somehow caused by upgrading Arduino or Teensyduino
    [x_logger.ino]
2020-06-11 * some minor code formatting tweaks * changing configuration for actuator center, min and max to use scaled units instead of analog read units * changing steering code to use the center, min and max 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
2020-06-11 3.5mm Control, 3rd Button update, and new 28 pins
    Created a new Headphone Jack board to control cars with more standardized control systems. Added a third analog button to the Joystick board to allow for 3 button control. Added a configuration jumper to the 28 pin control boards to allow 3rd button control toggle. Created a new control board that integrates the buck converter into the board.
    [ControlBoardT4_28PinSound_Power.kicad_pcb, ControlBoardT4_28PinSound_Power.sch, HeadphoneJack.kicad_pcb, HeadphoneJack.sch, SimpleBuildSounds_28PinSound.kicad_pcb, SimpleBuildSounds_28PinSound.sch]
2020-06-28 two new boards for the hall sensor rotary encoder
    [HallSensor.kicad_pcb, HallSensor.sch, HallSensorDevBoard.kicad_pcb, HallSensorDevBoard.sch]
2020-06-28 gerbers for updated joystick pcb
    [JoystickBoard-B_Cu.gbr, JoystickBoard-B_Mask.gbr, JoystickBoard-B_Paste.gbr, JoystickBoard-B_SilkS.gbr, JoystickBoard-Edge_Cuts.gbr, JoystickBoard-F_Cu.gbr, JoystickBoard-F_Mask.gbr, JoystickBoard-F_Paste.gbr]
2020-06-28 gerbers for new hall sensor pcbs
    [HallSensor-B_Cu.gbr, HallSensor-B_Mask.gbr, HallSensor-B_Paste.gbr, HallSensor-B_SilkS.gbr, HallSensor-Edge_Cuts.gbr, HallSensor-F_Cu.gbr, HallSensor-F_Mask.gbr, HallSensor-F_Paste.gbr]
2020-06-28 switching bluetooth button to pulldown instead of pullup and swappping button press logic
    [bl_bluetooth.ino]
2020-06-28 adding gerbers for a variety of pcbs
    [ControlBoardT4_28PinSound-B_Cu.gbr, ControlBoardT4_28PinSound-B_Mask.gbr, ControlBoardT4_28PinSound-B_Paste.gbr, ControlBoardT4_28PinSound-B_SilkS.gbr, ControlBoardT4_28PinSound-Edge_Cuts.gbr, ControlBoardT4_28PinSound-F_Cu.gbr, ControlBoardT4_28PinSound-F_Mask.gbr, ControlBoardT4_28PinSound-F_Paste.gbr]
2020-06-28 adding gerbers for headphone jack pcb
    [HeadphoneJack-B_Cu.gbr, HeadphoneJack-B_Mask.gbr, HeadphoneJack-B_Paste.gbr, HeadphoneJack-Edge_Cuts.gbr, HeadphoneJack-F_Cu.gbr, HeadphoneJack-F_Paste.gbr, HeadphoneJack-F_SilkS.gbr, HeadphoneJack-NPTH.drl]
2020-06-29 adding drive by button functionality, general code cleanup
2020-07-05 adding drive by wire code
2020-07-05 adding missing kicad symbol libraries
2020-07-15 Hall Sensor PCB updates and Gerbers
    [HallSensor-B_Cu.gbr, HallSensor-B_Mask.gbr, HallSensor-B_Paste.gbr, HallSensor-B_SilkS.gbr, HallSensor-Edge_Cuts.gbr, HallSensor-F_Cu.gbr, HallSensor-F_Mask.gbr, HallSensor-F_Paste.gbr]
2020-07-15 Adding Pot to Servo Wire PCB
    [PotentiometerToServoWire-B_Cu.gbr, PotentiometerToServoWire-B_Mask.gbr, PotentiometerToServoWire-B_Paste.gbr, PotentiometerToServoWire-B_SilkS.gbr, PotentiometerToServoWire-Edge_Cuts.gbr, PotentiometerToServoWire-F_Cu.gbr, PotentiometerToServoWire-F_Mask.gbr, PotentiometerToServoWire-F_Paste.gbr]
2020-07-15 Adding VL53L0X Sesnor PCB
    [VL53L0XSensor-B_Cu.gbr, VL53L0XSensor-B_Mask.gbr, VL53L0XSensor-B_Paste.gbr, VL53L0XSensor-B_SilkS.gbr, VL53L0XSensor-Edge_Cuts.gbr, VL53L0XSensor-F_Cu.gbr, VL53L0XSensor-F_Mask.gbr, VL53L0XSensor-F_Paste.gbr]
2020-07-15 Minor update to VL53L0X sensor PCB
    [VL53L0XSensor.kicad_pcb]
2020-07-18 first pass at hall sensor code
2020-07-18 first pass at no-touch button using VL53L0X sensor
2020-07-27 tweaks for drive by wire and drive by button
2020-07-27 adjusting pins for distance sensor to use with ATTiny 3216 PCB
2020-07-28 hall sensor updates
2020-07-28 possible hall sensor for 814
    [HallSensorAtTiny814.kicad_pcb, HallSensorAtTiny814.sch]
2020-07-28 potentiometer to servo wire and other pcb tweaks
    [PotentiometerToServoWire-B_Cu.gbr, PotentiometerToServoWire-B_Mask.gbr, PotentiometerToServoWire-B_Paste.gbr, PotentiometerToServoWire-B_SilkS.gbr, PotentiometerToServoWire-Edge_Cuts.gbr, PotentiometerToServoWire-F_Cu.gbr, PotentiometerToServoWire-F_Mask.gbr, PotentiometerToServoWire-F_Paste.gbr]
2020-07-29 vl53l0x sensor pcb updates and pot pcb updates
    [PotentiometerToServoWire-B_Cu.gbr, PotentiometerToServoWire-B_Mask.gbr, PotentiometerToServoWire-B_Paste.gbr, PotentiometerToServoWire-B_SilkS.gbr, PotentiometerToServoWire-Edge_Cuts.gbr, PotentiometerToServoWire-F_Cu.gbr, PotentiometerToServoWire-F_Mask.gbr, PotentiometerToServoWire-F_Paste.gbr]
2020-07-30 changes to throttle and steering for Pololu 18v22 motor controller
2020-08-07 updating version number for pololu motor controller change
2020-08-15 adjusting code to support 3 motor channels instead of using a shared channel for the left and right motors
2020-08-21 Component Shift and Voltage Divider
    Shifted the teensy by 5mm and the headphone jack by 3mm. Integrated the voltage divider. Converted resistors to surface mount.
    [ControlBoardT4_28PinSound_Power.kicad_pcb, ControlBoardT4_28PinSound_Power.sch]
2020-08-21 KiCad 5.1.6 Schematic Update
    Updated KiCad to 5.1.6 and updated 555 timer footprint.
    [ControlBoardT4_28PinSound_Power.sch]
2020-09-03 Removed Headphone Jack Added Amp Chip
    Added the MAX9744 chip and removed the headphone jack. Added audio out for speaker connection. Moved 555 timer and jumper pins. Other minor changes.
    [ControlBoardT4_28PinSound_PowerAmp.kicad_pcb, ControlBoardT4_28PinSound_PowerAmp.sch, MAX9744.sch]
2020-09-24 Moved SMP parts to bottom
    Moved SMP parts to bottom of the board to make soldering easier. Extended leads on amp footprint to help with soldering. Moved power capacitor 8mm so it isn't in the way of the sound trigger board.
    [ControlBoardT4_28PinSound_PowerAmp.kicad_pcb]
2020-11-02 incorporating Randy's fixes for the logging code
    [a_constants.ino, b_eeprom.ino, bl_bluetooth.ino, e_configuration.ino, j_joystick.ino, k_button_drive.ino, p_drive_by_wire.ino, r_remote_control.ino]
2020-11-02 adjustments to potentiometer to servo wire pcb
    [PotentiometerToServoWire-B_Cu.gbr, PotentiometerToServoWire-B_Mask.gbr, PotentiometerToServoWire-B_Paste.gbr, PotentiometerToServoWire-B_SilkS.gbr, PotentiometerToServoWire-Edge_Cuts.gbr, PotentiometerToServoWire-F_Cu.gbr, PotentiometerToServoWire-F_Mask.gbr, PotentiometerToServoWire-F_Paste.gbr]
2020-11-02 generating gerbers for latest Teensy4 PCB with integrated power
    [ControlBoardT4_28PinSound_Power-B_Cu.gbr, ControlBoardT4_28PinSound_Power-B_Mask.gbr, ControlBoardT4_28PinSound_Power-B_Paste.gbr, ControlBoardT4_28PinSound_Power-B_SilkS.gbr, ControlBoardT4_28PinSound_Power-Edge_Cuts.gbr, ControlBoardT4_28PinSound_Power-F_Cu.gbr, ControlBoardT4_28PinSound_Power-F_Mask.gbr, ControlBoardT4_28PinSound_Power-F_Paste.gbr]
2020-11-02 vs1000 audio breakout PCBs for testing
    [VS1000BreakoutV2-B_Cu.gbr, VS1000BreakoutV2-B_Mask.gbr, VS1000BreakoutV2-B_Paste.gbr, VS1000BreakoutV2-B_SilkS.gbr, VS1000BreakoutV2-Edge_Cuts.gbr, VS1000BreakoutV2-F_Cu.gbr, VS1000BreakoutV2-F_Mask.gbr, VS1000BreakoutV2-F_Paste.gbr]
2020-11-02 renaming car firmware arduino code to 2020 to match reality
2020-11-04 New board to use the nRF52840
    New board to use the nRF52840
    [ControlBoardnRF_22PinSound_PowerAmp.kicad_pcb, ControlBoardnRF_22PinSound_PowerAmp.sch, MAX9744.sch]
2020-11-09 gerbers for v1 of the new nRF52840 PCB
    [ControlBoardnRF_22PinSound_PowerAmp-B_Cu.gbr, ControlBoardnRF_22PinSound_PowerAmp-B_Mask.gbr, ControlBoardnRF_22PinSound_PowerAmp-B_Paste.gbr, ControlBoardnRF_22PinSound_PowerAmp-B_SilkS.gbr, ControlBoardnRF_22PinSound_PowerAmp-Edge_Cuts.gbr, ControlBoardnRF_22PinSound_PowerAmp-F_Cu.gbr, ControlBoardnRF_22PinSound_PowerAmp-F_Mask.gbr, ControlBoardnRF_22PinSound_PowerAmp-F_Paste.gbr]
2020-11-09 updating arduino code to use SPI file system for configuration
2020-11-09 updating throttle and steering input pin mapping
2020-11-11 vs1000 breakout PCB updates
    [VS1000BreakoutV2.kicad_pcb, VS1000SimpleBreakout.sch]
2020-12-03 Component placement changes and updates
    [ControlBoardnRF_22PinSound_PowerAmp.kicad_pcb, ControlBoardnRF_22PinSound_PowerAmp.sch]
2020-12-05 Added the Amp chip to simple board
    In addition to the amp, updated Buck converter to Adafruit 5v buck converter. Also updated RJ45 to use the tab up footprint.
    [MAX9744.sch, SimpleBuildSoundsAmp.kicad_pcb, SimpleBuildSoundsAmp.sch]
2020-12-05 Board that only has the amp chip.
    Just in case we decide to keep the amp separate.
    [AmpOnly.kicad_pcb, AmpOnly.sch, MAX9744.sch]
2020-12-22 Minor pin adjustments
    Shifted all input pins way from RJ45 connector. Shifted BT Switch closer to RJ45 connector. Made the holds for the Feather 1mm instead of 1.1mm. Adjusted the screw hole on the MPM3610. Added the text USB on the usb side of the feather.
    [ControlBoardnRF_22PinSound_PowerAmp.kicad_pcb]
2020-12-22 Added 3v regulator and minor adjustments
    Added 3v regulator. Moved power label way from screw terminal. Added label for volume. Added label for Speaker wires. Added USB text on usb side of sound board.
    [SimpleBuildSoundsAmp.kicad_pcb, SimpleBuildSoundsAmp.sch]
2021-01-04 New Test Board
    New Test Board to test surface mounted components.
    [MAX9744.sch, TestBoard.kicad_pcb, TestBoard.sch]
2021-01-18 updates for 2021 simple and complex PCBs and new test PCB
    [AmpOnly-B_Cu.gbr, AmpOnly-B_Mask.gbr, AmpOnly-B_Paste.gbr, AmpOnly-B_SilkS.gbr, AmpOnly-Edge_Cuts.gbr, AmpOnly-F_Cu.gbr, AmpOnly-F_Mask.gbr, AmpOnly-F_Paste.gbr]
2021-01-18 reversing logic on bluetooth enable pin
    [bl_bluetooth.ino]
2021-01-18 adjustments to pin assignments for latest PCB layout
2021-01-30 initial design of SMD hall sensor PCB
    [HallSensorSMD.kicad_pcb, HallSensorSMD.sch]
2021-01-30 finishing v1 of the 7 pos SMD Hall sensor PCB
    [HallSensorSMD-B_Cu.gbr, HallSensorSMD-B_Mask.gbr, HallSensorSMD-B_Paste.gbr, HallSensorSMD-B_SilkS.gbr, HallSensorSMD-Edge_Cuts.gbr, HallSensorSMD-F_Cu.gbr, HallSensorSMD-F_Mask.gbr, HallSensorSMD-F_Paste.gbr]
2021-01-30 v1 of 9 position Hall Sensor PCB
    [HallSensorSMD_9_Pos-B_Cu.gbr, HallSensorSMD_9_Pos-B_Mask.gbr, HallSensorSMD_9_Pos-B_Paste.gbr, HallSensorSMD_9_Pos-B_SilkS.gbr, HallSensorSMD_9_Pos-Edge_Cuts.gbr, HallSensorSMD_9_Pos-F_Cu.gbr, HallSensorSMD_9_Pos-F_Mask.gbr, HallSensorSMD_9_Pos-F_Paste.gbr]
2021-01-31 New Input Board for button and drive by wire cars
    New board to be used in place of the joystick board when an analog signal is not being used.
    [InputBoard.kicad_pcb, InputBoard.sch]
2021-01-31 updating Hall Sensor 9 Position pin assignments
    [HallSensorSMD_9_Pos-B_Cu.gbr, HallSensorSMD_9_Pos-B_Mask.gbr, HallSensorSMD_9_Pos-B_Paste.gbr, HallSensorSMD_9_Pos-B_SilkS.gbr, HallSensorSMD_9_Pos-Edge_Cuts.gbr, HallSensorSMD_9_Pos-F_Cu.gbr, HallSensorSMD_9_Pos-F_Mask.gbr, HallSensorSMD_9_Pos-F_Paste.gbr]
2021-02-05 code changes to try and fix nrf52840 issues
    [a_constants.ino, b_spi.ino, s_steering.ino, x_logger.ino, z_setup_loop.ino]
2021-02-06 gerbers for input PCB
    [InputBoard-B_Cu.gbr, InputBoard-B_Mask.gbr, InputBoard-B_Paste.gbr, InputBoard-B_SilkS.gbr, InputBoard-Edge_Cuts.gbr, InputBoard-F_Cu.gbr, InputBoard-F_Mask.gbr, InputBoard-F_Paste.gbr]
2021-02-13 adjusting pins for input PCB to use PWM capable pins
    [InputBoard.sch]
2021-02-13 gerbers for V2 Input PCB
    [InputBoard-B_Cu.gbr, InputBoard-B_Mask.gbr, InputBoard-B_Paste.gbr, InputBoard-B_SilkS.gbr, InputBoard-Edge_Cuts.gbr, InputBoard-F_Cu.gbr, InputBoard-F_Mask.gbr, InputBoard-F_Paste.gbr]
2021-02-13 first attempt at Button Control Panel firmware
2021-02-13 simple code for PCB tester to print RC and Joystick X/Y values to serial output
2021-02-14 basic 7 position Hall Sensor code
2021-03-03 gerbers for HallSensor and InputBoard PCBs, updates to HallSensor PCBs
    [HallSensorSMD-B_Cu.gbr, HallSensorSMD-B_Mask.gbr, HallSensorSMD-B_Paste.gbr, HallSensorSMD-B_SilkS.gbr, HallSensorSMD-Edge_Cuts.gbr, HallSensorSMD-F_Cu.gbr, HallSensorSMD-F_Mask.gbr, HallSensorSMD-F_Paste.gbr]
2021-03-09 initial design for input control test board
    [ControlInputTest-B_Cu.gbr, ControlInputTest-B_Mask.gbr, ControlInputTest-B_Paste.gbr, ControlInputTest-B_SilkS.gbr, ControlInputTest-Edge_Cuts.gbr, ControlInputTest-F_Cu.gbr, ControlInputTest-F_Mask.gbr, ControlInputTest-F_Paste.gbr]
2021-03-14 Broke out Terminals to allow for Simple Caddy
    Updates that will help with making a Caddy for the simple Go Button cars. Spilt the power/relay terminal into two terminals and moved them to the other side of the board. This will allow for the removal of the WAGO connectors when wiring.
    [SimpleBuildSoundsAmp.kicad_pcb, SimpleBuildSoundsAmp.sch]
2021-03-14 fixing inputboard mounting holes and pin assignments
    [InputBoard-B_Cu.gbr, InputBoard-B_Mask.gbr, InputBoard-B_Paste.gbr, InputBoard-B_SilkS.gbr, InputBoard-Edge_Cuts.gbr, InputBoard-F_Cu.gbr, InputBoard-F_Mask.gbr, InputBoard-F_Paste.gbr]
2021-03-14 major rework of Input Board PCB V4
    [InputBoard.kicad_pcb, InputBoard.sch]
2021-03-15 hall sensor basic code for 9 positions
2021-03-16 input board pcb v4 gerbers
    [InputBoard-B_Cu.gbr, InputBoard-B_Mask.gbr, InputBoard-B_Paste.gbr, InputBoard-B_SilkS.gbr, InputBoard-Edge_Cuts.gbr, InputBoard-F_Cu.gbr, InputBoard-F_Mask.gbr, InputBoard-F_Paste.gbr]
2021-03-16 gerbers for new simple pcb for new caddy
    [SimpleBuildSoundsAmp-B_Cu.gbr, SimpleBuildSoundsAmp-B_Mask.gbr, SimpleBuildSoundsAmp-B_Paste.gbr, SimpleBuildSoundsAmp-B_SilkS.gbr, SimpleBuildSoundsAmp-Edge_Cuts.gbr, SimpleBuildSoundsAmp-F_Cu.gbr, SimpleBuildSoundsAmp-F_Mask.gbr, SimpleBuildSoundsAmp-F_Paste.gbr]
2021-03-27 updating pin assignments for 9 position hall sensor firmware
2021-03-27 updating pin assignments for control panel firmware
2021-03-27 adjusting car firmware to use analog values for RC input instead of PWM
2021-03-27 adding code to average linear actuator position readings to workaround jitter issue
    [s_steering.ino]
2021-04-03 adjusting steering, rc and joystick constants
2021-04-03 isolating 12v and amp from microcontroller
    [ControlBoardnRF_22PinSound_PowerAmp.kicad_pcb, ControlBoardnRF_22PinSound_PowerAmp.sch, MAX9744.sch, SimpleBuildSoundsAmp.kicad_pcb, SimpleBuildSoundsAmp.sch]
2021-04-04 Connected speaker traces
    Connected the speaker traces and updated some items on the silk screen.
    [SimpleBuildSoundsAmp.kicad_pcb]
2021-04-27 drive by wire firmware and 9 position hall sensor firmware from Randy
2021-05-03 more changes to sample ble code
2021-05-20 adjusting code to better tolerate missed pwm pulses
    [Drive_by_wire.ino]
2021-05-20 adjusting constants for actuator and loop delay
2021-05-20 adding method to allow the steering to be stopped by the main loop
2021-05-20 adding protection against continuing to run the steering actuator after a bad start or bluetooth activation
2021-05-21 adding reverse switch code to control panel firmware
    [control_panel_firmware.ino]
2021-05-21 updated code from Randy for hall sensor drive by wire firmware
2021-06-14 New board for Teensy 4.0
    22 pin sound board and integrated amp. Included changes that were made on the nRF board to allow the shift back to Teensy.
    [ControlBoardT4_22PinSound_PowerAmp.kicad_pcb, ControlBoardT4_22PinSound_PowerAmp.sch, MAX9744.sch]
2021-06-15 Updated printed version number
    [ControlBoardT4_22PinSound_PowerAmp.kicad_pcb]
2021-06-18 schematic almost complete for STM32 InputBoard
    [InputBoardSTM32.kicad_pcb, InputBoardSTM32.sch]
2021-06-19 InputBoardSTM32 V1 complete
    [InputBoardSTM32-B_Cu.gbr, InputBoardSTM32-B_Mask.gbr, InputBoardSTM32-B_Paste.gbr, InputBoardSTM32-B_SilkS.gbr, InputBoardSTM32-Edge_Cuts.gbr, InputBoardSTM32-F_Cu.gbr, InputBoardSTM32-F_Mask.gbr, InputBoardSTM32-F_Paste.gbr]
2021-06-19 updating joystick pcb to use tab-up rj-45 jack
    [JoystickBoard-B_Cu.gbr, JoystickBoard-B_Mask.gbr, JoystickBoard-B_Paste.gbr, JoystickBoard-B_SilkS.gbr, JoystickBoard-Edge_Cuts.gbr, JoystickBoard-F_Cu.gbr, JoystickBoard-F_Mask.gbr, JoystickBoard-F_Paste.gbr]
2021-07-13 starting to modify code for the new Teensy 4 PCB
2021-07-13 more teensy 4 code conversion
2021-07-17 reworking eeprom code and adding interrupt code for RC handling
    [a_constants.ino, b_eeprom.ino, e_configuration.ino, r_remote_control.ino, z_setup_loop.ino]
2021-07-17 adding PWM capabilities to joystick object
2021-07-17 adding STM32 symbol library
2021-07-18 adding missing KiCad library files
2021-07-18 updates to STM32 Input PCB and new STM32 QFN28 Input PCB
    [InputBoardSTM32.kicad_pcb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]
2021-07-19 Added space to allow for JST Connectors
    JST connectors are 2.54 pitch.
    [ControlBoardT4_22PinSound_PowerAmp.kicad_pcb, ControlBoardT4_22PinSound_PowerAmp.sch, MAX9744.sch]
2021-07-19 Added JST connector for Volume
    JST connector is 2.54 pitch. Added ground line on resistor R9.
    [MAX9744.sch, SimpleBuildSoundsAmp.kicad_pcb]
2021-07-19 creating Teensy version of the Input Tester with OLED Feather
    [ControlInputTestTeensy-B_Cu.gbr, ControlInputTestTeensy-B_Mask.gbr, ControlInputTestTeensy-B_Paste.gbr, ControlInputTestTeensy-B_SilkS.gbr, ControlInputTestTeensy-Edge_Cuts.gbr, ControlInputTestTeensy-F_Cu.gbr, ControlInputTestTeensy-F_Mask.gbr, ControlInputTestTeensy-F_Paste.gbr]
2021-07-19 STM32QFN28 Breakout PCB almost done
    [STM32QFN28Breakout.kicad_pcb, STM32QFN28Breakout.sch]
2021-07-19 adding software for prototype tank drive
2021-07-20 gerbers for various PCBs, update to potentiometer PCB to use JST
    [ControlBoardT4_22PinSound_PowerAmp-B_Cu.gbr, ControlBoardT4_22PinSound_PowerAmp-B_Mask.gbr, ControlBoardT4_22PinSound_PowerAmp-B_Paste.gbr, ControlBoardT4_22PinSound_PowerAmp-B_SilkS.gbr, ControlBoardT4_22PinSound_PowerAmp-Edge_Cuts.gbr, ControlBoardT4_22PinSound_PowerAmp-F_Cu.gbr, ControlBoardT4_22PinSound_PowerAmp-F_Mask.gbr, ControlBoardT4_22PinSound_PowerAmp-F_Paste.gbr]
2021-07-20 update to STM32QFN Breakout PCB
    [STM32QFN28Breakout-B_Cu.gbr, STM32QFN28Breakout-B_Mask.gbr, STM32QFN28Breakout-B_Paste.gbr, STM32QFN28Breakout-B_SilkS.gbr, STM32QFN28Breakout-Edge_Cuts.gbr, STM32QFN28Breakout-F_Cu.gbr, STM32QFN28Breakout-F_Mask.gbr, STM32QFN28Breakout-F_Paste.gbr]
2021-08-26 first set of STM32 projects including a couple of test projects
2021-09-13 fixing pin assignments for Teensy steering
    [a_constants.ino]
2021-10-13 adding halloween buzz lightyear costume code
    [halloween_2021_BuzzLighyear.ino]
2021-10-16 adusting version and fixing issue with loop delay not being called except during logging
    [a_constants.ino, z_setup_loop.ino]
2021-10-25 tweaks to Control Input for Teensy PCB
    [ControlInputTestTeensy-B_Cu.gbr, ControlInputTestTeensy-B_Mask.gbr, ControlInputTestTeensy-B_Paste.gbr, ControlInputTestTeensy-B_SilkS.gbr, ControlInputTestTeensy-Edge_Cuts.gbr, ControlInputTestTeensy-F_Cu.gbr, ControlInputTestTeensy-F_Mask.gbr, ControlInputTestTeensy-F_Paste.gbr]
2021-10-25 first pass at new Magnetic sensor PCB
    [MagneticSensor-B_Cu.gbr, MagneticSensor-B_Mask.gbr, MagneticSensor-B_Paste.gbr, MagneticSensor-B_SilkS.gbr, MagneticSensor-Edge_Cuts.gbr, MagneticSensor-F_Cu.gbr, MagneticSensor-F_Mask.gbr, MagneticSensor-F_Paste.gbr]
2021-10-25 fix and tweaks for STM32QFN28 breakout PCB
    [STM32QFN28Breakout-B_Cu.gbr, STM32QFN28Breakout-B_Mask.gbr, STM32QFN28Breakout-B_Paste.gbr, STM32QFN28Breakout-B_SilkS.gbr, STM32QFN28Breakout-Edge_Cuts.gbr, STM32QFN28Breakout-F_Cu.gbr, STM32QFN28Breakout-F_Mask.gbr, STM32QFN28Breakout-F_Paste.gbr]
2021-10-25 new adapter PCB for STM32 SWD programming
    [SWDAdapter.kicad_pcb, SWDAdapter.sch]
2021-11-09 first pass at drive by wire magnetoresistive sensor pcb
    [DriveByWireMrSensor.kicad_pcb, DriveByWireMrSensor.sch]
2021-11-12 adding second opamp into circuit
    [DriveByWireMrSensor.kicad_pcb, DriveByWireMrSensor.sch]
2021-11-16 first pass at new control panel PCB with JST connectors
    [ControlPanelSTM32QFN28.kicad_pcb, ControlPanelSTM32QFN28.sch]
2021-11-16 drive by wire pcb
    [DriveByWireMrSensor.kicad_pcb, DriveByWireMrSensor.sch, pcb_fusion_layout.dxf]
2021-11-18 New RJ45 Breakout board
    [RJ45Breakout.kicad_pcb, RJ45Breakout.sch]
2021-11-18 Updated surface mount location
    [ControlPanelSTM32QFN28.kicad_pcb]
2021-11-19 moving pcb file and generating gerbers
    [ControlPanelSTM32QFN28-B_Cu.gbr, ControlPanelSTM32QFN28-B_Mask.gbr, ControlPanelSTM32QFN28-B_Paste.gbr, ControlPanelSTM32QFN28-B_SilkS.gbr, ControlPanelSTM32QFN28-Edge_Cuts.gbr, ControlPanelSTM32QFN28-F_Cu.gbr, ControlPanelSTM32QFN28-F_Mask.gbr, ControlPanelSTM32QFN28-F_Paste.gbr]
2021-11-19 finalizing drive by wire magneto resistive PCB and gerbers
    [DriveByWireMrSensor-B_Cu.gbr, DriveByWireMrSensor-B_Mask.gbr, DriveByWireMrSensor-B_Paste.gbr, DriveByWireMrSensor-B_SilkS.gbr, DriveByWireMrSensor-Edge_Cuts.gbr, DriveByWireMrSensor-F_Cu.gbr, DriveByWireMrSensor-F_Mask.gbr, DriveByWireMrSensor-F_Paste.gbr]
2021-11-19 rj45 breakout gerbers
    [RJ45Breakout-B_Cu.gbr, RJ45Breakout-B_Mask.gbr, RJ45Breakout-B_Paste.gbr, RJ45Breakout-B_SilkS.gbr, RJ45Breakout-Edge_Cuts.gbr, RJ45Breakout-F_Cu.gbr, RJ45Breakout-F_Mask.gbr, RJ45Breakout-F_Paste.gbr]
2021-11-19 adding new 6 pin connector to swd adapter PCB and generating gerbers
    [SWDAdapter-B_Cu.gbr, SWDAdapter-B_Mask.gbr, SWDAdapter-B_Paste.gbr, SWDAdapter-B_SilkS.gbr, SWDAdapter-Edge_Cuts.gbr, SWDAdapter-F_Cu.gbr, SWDAdapter-F_Mask.gbr, SWDAdapter-F_Paste.gbr]
2021-11-19 fixing text on rj45 connector pcb and swd apapter shchematic
    [RJ45Breakout-B_Cu.gbr, RJ45Breakout-B_Mask.gbr, RJ45Breakout-B_Paste.gbr, RJ45Breakout-B_SilkS.gbr, RJ45Breakout-Edge_Cuts.gbr, RJ45Breakout-F_Cu.gbr, RJ45Breakout-F_Mask.gbr, RJ45Breakout-F_Paste.gbr]
2021-12-07 new input pcb for rugged digital joystick
    [InputBoardSTM32QFN28-B_Cu.gbr, InputBoardSTM32QFN28-B_Mask.gbr, InputBoardSTM32QFN28-B_Paste.gbr, InputBoardSTM32QFN28-B_SilkS.gbr, InputBoardSTM32QFN28-Edge_Cuts.gbr, InputBoardSTM32QFN28-F_Cu.gbr, InputBoardSTM32QFN28-F_Mask.gbr, InputBoardSTM32QFN28-F_Paste.gbr]
2021-12-07 STM32 Control Panel firmware tweaks to output PWM channels
2021-12-07 fixing drive by wire PCB to make space for shim and avoiding screw holes
    [DriveByWire PCB Sketch V2.dxf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]
2022-01-06 initial digital joystick firmware - includes LED debug code
2022-01-06 adding corrected input joystick PCB gerber files
    [InputBoardSTM32QFN28-B_Cu.gbr, InputBoardSTM32QFN28-B_Mask.gbr, InputBoardSTM32QFN28-B_SilkS.gbr, InputBoardSTM32QFN28-F_Mask.gbr, InputJoyStickSTM32QFN28-B_Cu.gbr, InputJoyStickSTM32QFN28-B_Mask.gbr, InputJoyStickSTM32QFN28-B_Paste.gbr, InputJoyStickSTM32QFN28-B_SilkS.gbr]
2022-01-06 adding RC Feather Control PCB and gerbers
    [MAX9744.sch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]
2022-01-07 swapping forward/reverse pins for Digital Joystick firmware
    [STM32G031G8_DigitalJoystickFirmware.ioc, main.c, main.h]
2022-01-14 updating pin assignments for digital joystick firmware
2022-01-14 initial OLED input tester for teensy code - analog readings only
2022-01-18 updating Teensy input tester to handle PWM and Analog display
2022-01-28 new drive by wire firmware
2022-01-28 test stepper motor code
2022-02-03 PCB image and schematics for a couple of boards
2022-02-03 moving old PCBs to Archive folder
    [AmpOnly-B_Cu.gbr, AmpOnly-B_Mask.gbr, AmpOnly-B_Paste.gbr, AmpOnly-B_SilkS.gbr, AmpOnly-Edge_Cuts.gbr, AmpOnly-F_Cu.gbr, AmpOnly-F_Mask.gbr, AmpOnly-F_Paste.gbr]
2022-02-03 New Teensy with Feather and I2C connector PCB
    [TeensyPlusFeather.kicad_pcb, TeensyPlusFeather.sch]
2022-02-04 TeensyPlusFeather PCB cleanup
    [TeensyPlusFeather.kicad_pcb]
2022-02-25 test code for Pitt State prototype
2022-02-25 drive by wire nearly final firmware
2022-02-25 adding throttle including reverse to test code
    [StepperSimpleJoystick.ino]
2022-02-26 first pass at car firmware for pitt state, sending steering over i2c
2022-02-26 steering firmware created and tweaked timings
2022-02-26 fixing weird startup issue and adding in reverse code
    [e_configuration.ino, s_steering.ino, t_throttle.ino, z_setup_loop.ino]
2022-02-28 braking tweaks, steering code cleanup, adding in GPIO expander code
2022-03-03 adjusting code to handle multiple brake motors and multiple drive motors, first pass
2022-03-03 updating steering code to handle four stepper motors and limit switches - first pass
2022-03-03 saving copy of working single stepper motor code
2022-03-03 fixed issue with steering code and removed some debugging output
    [SteeringFirmware.ino]
2022-03-11 changing steering firmware for pitt state from I2C to analog
2022-03-13 trying to sort out multiple stepper motor problems
    [SteeringFirmware.ino]
2022-03-16 removing GPIO expander for pitt state reverse signal
    [a_constants.ino, t_throttle.ino]
2022-03-16 remove all multi-stepper code
2022-03-16 adding defines for the three parameters that can change by wheel
2022-03-18 updating braking code to use the relays
2022-03-27 Nano Motor controller for Pitt State two Nanos on one PCB
    [Two Motor Nano Controller-B_Cu.gbr, Two Motor Nano Controller-B_Mask.gbr, Two Motor Nano Controller-B_Paste.gbr, Two Motor Nano Controller-B_SilkS.gbr, Two Motor Nano Controller-Edge_Cuts.gbr, Two Motor Nano Controller-F_Cu.gbr, Two Motor Nano Controller-F_Mask.gbr, Two Motor Nano Controller-F_Paste.gbr]
2022-03-27 additional file
    [Two Motor Nano Controller.kicad_pcb]
2022-03-28 additional pcb for pitt state prototype
    [ThrottleReverseBrake.kicad_pcb, ThrottleReverseBrake.sch]
2022-03-29 fixing go button issue in drive by wire firmware and upgrading to STM32 CubeIDE 1.9
    [STM32G031G8_DriveByWire.ioc, main.c]
2022-03-30 updated Pitt State PCBs
    [ThrottleReverseBrake-B_Cu.gbr, ThrottleReverseBrake-B_Mask.gbr, ThrottleReverseBrake-B_Paste.gbr, ThrottleReverseBrake-B_SilkS.gbr, ThrottleReverseBrake-Edge_Cuts.gbr, ThrottleReverseBrake-F_Cu.gbr, ThrottleReverseBrake-F_Mask.gbr, ThrottleReverseBrake-F_Paste.gbr]
2022-03-30 adding additional sound headers to primary Teensy 4 PCB
    [ControlBoardT4_22PinSound_PowerAmp-B_Cu.gbr, ControlBoardT4_22PinSound_PowerAmp-B_Mask.gbr, ControlBoardT4_22PinSound_PowerAmp-B_Paste.gbr, ControlBoardT4_22PinSound_PowerAmp-B_SilkS.gbr, ControlBoardT4_22PinSound_PowerAmp-Edge_Cuts.gbr, ControlBoardT4_22PinSound_PowerAmp-F_Cu.gbr, ControlBoardT4_22PinSound_PowerAmp-F_Mask.gbr, ControlBoardT4_22PinSound_PowerAmp-F_Paste.gbr]
2022-04-05 test code pitt state stepper motors
2022-04-14 pitt state steering code change for new PCBs
2022-04-16 more pitt state steering code tests
2022-04-16 adding limit switch code for pitt state steering partially done
2022-04-17 fixing up the pitt state steering code to use the flexystepper library and the new limit switches
    [SteeringFirmwareFlexyStepper.ino]
2022-04-22 reading both sin and cos for drive by wire firmware
2022-04-28 updating control panel to STM32 CubeIDE 1.9
2022-04-28 updating digital joystick firmware to lastest STM32 CubeIDE
2022-04-30 adding PWM support to EspNow Sender code for RC
2022-05-01 reversing forward backward pins
    [STM32G031G8_DigitalJoystickFirmware.ioc, main.c, main.h]
2022-06-02 adding feature to extend the throttle for a set period of time
2022-06-04 troubleshooting extend throttle code
2022-06-04 reworking extended throttle functionality
    [j_joystick.ino, z_setup_loop.ino]
2022-07-10 New RJ45 breakout board for Go Button
    [RJ45GoButton.kicad_pcb, RJ45GoButton.kicad_sch, RJ45GoButton.sch]
2022-07-10 Reordered pins to be 1-8 instead
    [RJ45Breakout.kicad_pcb, RJ45Breakout.kicad_sch]
2022-07-10 Connected 3 of the sound pins to teensy
    KiCad 6
    [ControlBoardT4_22PinSound_PowerAmp.kicad_pcb, ControlBoardT4_22PinSound_PowerAmp.kicad_sch, MAX9744.kicad_sch]
2022-07-10 Added Sound Pin Breakout
    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
    [MAX9744.kicad_sch, SimpleBuildSoundsAmp.kicad_pcb, SimpleBuildSoundsAmp.kicad_sch]
2022-07-14 fixing poorly defined digital joystick firmware variables
    [main.c]
2022-07-14 cleaning up drive-by-wire code
2022-07-21 adding RJ45 splitter PCB for clinic cars
    [Clinic_RJ45_Splitter-B_Cu.gbr, Clinic_RJ45_Splitter-B_Mask.gbr, Clinic_RJ45_Splitter-B_Paste.gbr, Clinic_RJ45_Splitter-B_Silkscreen.gbr, Clinic_RJ45_Splitter-Edge_Cuts.gbr, Clinic_RJ45_Splitter-F_Cu.gbr, Clinic_RJ45_Splitter-F_Mask.gbr, Clinic_RJ45_Splitter-F_Paste.gbr]
2022-07-24 first pass at new drive by wire input PCB
    [DriveByWireInputSTM32QFN28.kicad_pcb, DriveByWireInputSTM32QFN28.kicad_sch, DriveByWireInputSTM32QFN28.sch]
2022-07-24 Board for inside steering wheel of drive by wire
    [DriveByWireButton.kicad_pcb, DriveByWireButton.kicad_sch]
2022-07-24 finalizing drive-by-wire PCBs
    [DriveByWireInputAltSTM32QFN28-B_Cu.gbr, DriveByWireInputAltSTM32QFN28-B_Mask.gbr, DriveByWireInputAltSTM32QFN28-B_Paste.gbr, DriveByWireInputAltSTM32QFN28-B_Silkscreen.gbr, DriveByWireInputAltSTM32QFN28-Edge_Cuts.gbr, DriveByWireInputAltSTM32QFN28-F_Cu.gbr, DriveByWireInputAltSTM32QFN28-F_Mask.gbr, DriveByWireInputAltSTM32QFN28-F_Paste.gbr]
2022-07-25 drive by wire sensor PCB changes and new PCB
    [DriveByWireMr360Sensor-B_Cu.gbr, DriveByWireMr360Sensor-B_Mask.gbr, DriveByWireMr360Sensor-B_Paste.gbr, DriveByWireMr360Sensor-B_Silkscreen.gbr, DriveByWireMr360Sensor-Edge_Cuts.gbr, DriveByWireMr360Sensor-F_Cu.gbr, DriveByWireMr360Sensor-F_Mask.gbr, DriveByWireMr360Sensor-F_Paste.gbr]
2022-07-25 updating SWD adapter PCB to include 5 pin SH connector
    [SWDAdapter-B_Cu.gbr, SWDAdapter-B_Mask.gbr, SWDAdapter-B_Paste.gbr, SWDAdapter-B_Silkscreen.gbr, SWDAdapter-Edge_Cuts.gbr, SWDAdapter-F_Cu.gbr, SWDAdapter-F_Mask.gbr, SWDAdapter-F_Paste.gbr]
2022-07-25 RJ45 PCB Gerbers
    [RJ45Breakout-B_Cu.gbr, RJ45Breakout-B_Mask.gbr, RJ45Breakout-B_Paste.gbr, RJ45Breakout-B_SilkS.gbr, RJ45Breakout-B_Silkscreen.gbr, RJ45Breakout-Edge_Cuts.gbr, RJ45Breakout-F_SilkS.gbr, RJ45Breakout-F_Silkscreen.gbr]
2022-07-25 Drive by wire PCB Gerbers
    [DriveByWireButton-B_Cu.gbr, DriveByWireButton-B_Mask.gbr, DriveByWireButton-B_Paste.gbr, DriveByWireButton-B_Silkscreen.gbr, DriveByWireButton-Edge_Cuts.gbr, DriveByWireButton-F_Cu.gbr, DriveByWireButton-F_Mask.gbr, DriveByWireButton-F_Paste.gbr]
2022-07-25 Go Button PCB Gerbers
    [SimpleBuildSoundsAmp-B_Cu.gbr, SimpleBuildSoundsAmp-B_Mask.gbr, SimpleBuildSoundsAmp-B_Paste.gbr, SimpleBuildSoundsAmp-B_Silkscreen.gbr, SimpleBuildSoundsAmp-Edge_Cuts.gbr, SimpleBuildSoundsAmp-F_Cu.gbr, SimpleBuildSoundsAmp-F_Mask.gbr, SimpleBuildSoundsAmp-F_Paste.gbr]
2022-07-25 5 pin SH adapter PCB and tweaked Digital Joystick input PCB
    [5PinSHto5PinSh-B_Cu.gbr, 5PinSHto5PinSh-B_Mask.gbr, 5PinSHto5PinSh-B_Paste.gbr, 5PinSHto5PinSh-B_Silkscreen.gbr, 5PinSHto5PinSh-Edge_Cuts.gbr, 5PinSHto5PinSh-F_Cu.gbr, 5PinSHto5PinSh-F_Mask.gbr, 5PinSHto5PinSh-F_Paste.gbr]
2022-08-19 updating TLE5501 PCB to use new Sensor IC
    [DriveByWireMr360Sensor.kicad_pcb, DriveByWireMr360Sensor.kicad_sch, TLE5501E0001XUMA1.step]
2022-08-21 Moved traces around the voltage regulator screw
    [ControlBoardT4_22PinSound_PowerAmp.kicad_pcb]
2022-08-21 new Gerbers for updated primary Teensy 4 control PCB
    [ControlBoardT4_22PinSound_PowerAmp-B_Cu.gbr, ControlBoardT4_22PinSound_PowerAmp-B_Mask.gbr, ControlBoardT4_22PinSound_PowerAmp-B_Paste.gbr, ControlBoardT4_22PinSound_PowerAmp-B_SilkS.gbr, ControlBoardT4_22PinSound_PowerAmp-B_Silkscreen.gbr, ControlBoardT4_22PinSound_PowerAmp-Edge_Cuts.gbr, ControlBoardT4_22PinSound_PowerAmp-F_Cu.gbr, ControlBoardT4_22PinSound_PowerAmp-F_Mask.gbr]
2022-08-21 new Gerbers for updated Drive-By-Wire 360 degree sensor
    [DriveByWireMr360Sensor-B_Cu.gbr, DriveByWireMr360Sensor-B_Mask.gbr, DriveByWireMr360Sensor-B_Paste.gbr, DriveByWireMr360Sensor-B_Silkscreen.gbr, DriveByWireMr360Sensor-Edge_Cuts.gbr, DriveByWireMr360Sensor-F_Cu.gbr, DriveByWireMr360Sensor-F_Mask.gbr, DriveByWireMr360Sensor-F_Paste.gbr]
2022-08-21 step file for Drive-By-Wire input PCB
    [DriveByWireInputAltSTM32QFN28.step]
2022-08-21 updating gitignore for KiCad 6 backup folders
2022-09-20 fixing #defines for Control Panel Firmware
    [main.c]
2022-10-23 updating control panel PCB to KiCad 6
    [ControlPanelSTM32QFN28.kicad_pcb, ControlPanelSTM32QFN28.kicad_sch]
2022-10-23 drive by wire sensor PCB updates and gerbers
    [DriveByWireMr360Sensor-B_Cu.gbr, DriveByWireMr360Sensor-B_Mask.gbr, DriveByWireMr360Sensor-B_Paste.gbr, DriveByWireMr360Sensor-B_Silkscreen.gbr, DriveByWireMr360Sensor-Edge_Cuts.gbr, DriveByWireMr360Sensor-F_Cu.gbr, DriveByWireMr360Sensor-F_Mask.gbr, DriveByWireMr360Sensor-F_Paste.gbr]
2022-10-23 updates to STM32QFN28 breakout moving to 0603 components
    [STM32QFN28Breakout-B_Cu.gbr, STM32QFN28Breakout-B_Mask.gbr, STM32QFN28Breakout-B_Paste.gbr, STM32QFN28Breakout-B_Silkscreen.gbr, STM32QFN28Breakout-Edge_Cuts.gbr, STM32QFN28Breakout-F_Cu.gbr, STM32QFN28Breakout-F_Mask.gbr, STM32QFN28Breakout-F_Paste.gbr]
2022-10-23 adding readme file for EyeGaze Raspberry Pi setup
2022-11-03 adding basic MediaPipe Python sample code for EyeGaze
2022-11-28 fixing issue with primary car firmware and uninitialized arrays plus minor sound pin related fix
    [a_constants.ino, j_joystick.ino, r_remote_control.ino, s_steering.ino, z_setup_loop.ino]
2022-12-15 updating car firmware to average few values for the steering position to avoid overshoot
    [s_steering.ino]
2023-03-17 fixing digital input board sound buttons
    [STM32G031G8_DigitalJoystickFirmware.ioc, main.c, main.h]
2023-03-17 magic wand PCB
    [Magic_Wand_Timer-B_Cu.gbr, Magic_Wand_Timer-B_Mask.gbr, Magic_Wand_Timer-B_Paste.gbr, Magic_Wand_Timer-B_Silkscreen.gbr, Magic_Wand_Timer-Edge_Cuts.gbr, Magic_Wand_Timer-F_Cu.gbr, Magic_Wand_Timer-F_Mask.gbr, Magic_Wand_Timer-F_Paste.gbr]
2023-03-17 sd card to ffc PCB and 4 pin jst sh breakout
    [4PinJstShBreakout-B_Cu.gbr, 4PinJstShBreakout-B_Mask.gbr, 4PinJstShBreakout-B_Paste.gbr, 4PinJstShBreakout-B_Silkscreen.gbr, 4PinJstShBreakout-Edge_Cuts.gbr, 4PinJstShBreakout-F_Cu.gbr, 4PinJstShBreakout-F_Mask.gbr, 4PinJstShBreakout-F_Paste.gbr]
2023-03-25 new DAC CS4334 breakout PCB
    [CS4334Breakout-B_Cu.gbr, CS4334Breakout-B_Mask.gbr, CS4334Breakout-B_Paste.gbr, CS4334Breakout-B_Silkscreen.gbr, CS4334Breakout-Edge_Cuts.gbr, CS4334Breakout-F_Cu.gbr, CS4334Breakout-F_Mask.gbr, CS4334Breakout-F_Paste.gbr]
2023-03-25 adding version text to Magic Wand PCB and generating new Gerbers and drill files
    [Magic_Wand_Timer-B_Cu.gbr, Magic_Wand_Timer-B_Mask.gbr, Magic_Wand_Timer-B_Paste.gbr, Magic_Wand_Timer-B_Silkscreen.gbr, Magic_Wand_Timer-Edge_Cuts.gbr, Magic_Wand_Timer-F_Cu.gbr, Magic_Wand_Timer-F_Mask.gbr, Magic_Wand_Timer-F_Paste.gbr]
2023-03-31 fix for drive-by-wire sensor
    [main.c]
2023-04-27 New Board using DFRobot Mini Mp3 player
    New Board using DFRobot Mini Mp3 player and ATTiny
    [ControlBoardT4_DFminiSound_PowerAmp-B_Cu.gbr, ControlBoardT4_DFminiSound_PowerAmp-B_Mask.gbr, ControlBoardT4_DFminiSound_PowerAmp-B_Paste.gbr, ControlBoardT4_DFminiSound_PowerAmp-B_Silkscreen.gbr, ControlBoardT4_DFminiSound_PowerAmp-Edge_Cuts.gbr, ControlBoardT4_DFminiSound_PowerAmp-F_Cu.gbr, ControlBoardT4_DFminiSound_PowerAmp-F_Mask.gbr, ControlBoardT4_DFminiSound_PowerAmp-F_Paste.gbr]
2023-06-04 Add JST to RC adapter PCB
    [RC_DupontToJST.kicad_pcb, RC_DupontToJST.kicad_sch]
2023-06-15 Adding 3.3v line for ATTiny programing
    Adding 3.3v line for ATTiny programing also updated input silk screen to be more visible.
    [ControlBoardT4_DFminiSound_PowerAmp-B_Cu.gbr, ControlBoardT4_DFminiSound_PowerAmp-B_Mask.gbr, ControlBoardT4_DFminiSound_PowerAmp-B_Paste.gbr, ControlBoardT4_DFminiSound_PowerAmp-B_Silkscreen.gbr, ControlBoardT4_DFminiSound_PowerAmp-Edge_Cuts.gbr, ControlBoardT4_DFminiSound_PowerAmp-F_Cu.gbr, ControlBoardT4_DFminiSound_PowerAmp-F_Mask.gbr, ControlBoardT4_DFminiSound_PowerAmp-F_Paste.gbr]
2023-06-15 Removing autosave file
    Removing autosave file so Kicad does not warn save failure.
2023-06-29 Updating pins for drive system connection check
    Updating pins for drive system connection check
    [JoystickBoard-B_Cu.gbr, JoystickBoard-B_Mask.gbr, JoystickBoard-B_Paste.gbr, JoystickBoard-B_Silkscreen.gbr, JoystickBoard-Edge_Cuts.gbr, JoystickBoard-F_Cu.gbr, JoystickBoard-F_Mask.gbr, JoystickBoard-F_Paste.gbr]
2023-06-29 Updating pins for drive system connection check
    Updating pins for drive system connection check. Added Voltage divider for analog driving with motor controller.
    [RJ45GoButton-B_Cu.gbr, RJ45GoButton-B_Mask.gbr, RJ45GoButton-B_Paste.gbr, RJ45GoButton-B_Silkscreen.gbr, RJ45GoButton-Edge_Cuts.gbr, RJ45GoButton-F_Cu.gbr, RJ45GoButton-F_Mask.gbr, RJ45GoButton-F_Paste.gbr]
2023-07-07 Fixing OLED Input Tester Teensy file naming
    [OLED_InputTester.ino, OLED_InputTester_Teensy.ino]
2023-07-08 First pass at new test PCB for RP2040 feather
    [ControlInputTestFeather.kicad_pcb, ControlInputTestFeather.kicad_sch, ControlInputTestFeather.sch, MAX9744.sch]
2023-07-21 df robot sample sounds
2023-07-24 removing Debug code from DFRobot ATTiny code and adding a short delay in the setup so the mp3 player can boot up
    [GeeksSoundsDFRobotMini.ino]
2023-07-24 Add Audio_Module Design
    [ATmega328P.kicad_sch, Audio_Amplifier.kicad_sch, Audio_Module.kicad_pcb, Audio_Module.kicad_sch, Audio_Module.sch, USB.kicad_sch, bom.csv, designators.csv]
2023-07-24 Add Brushed_DC_Motor_Driver
    [Brushed_DC_Motor_Driver.csv, Brushed_DC_Motor_Driver.kicad_pcb, Brushed_DC_Motor_Driver.kicad_sch, Brushed_DC_Motor_Driver.sch, Brushed_DC_Motor_Driver.step, Brushed_DC_Motor_Driver.xml, bom.csv, designators.csv]
2023-07-24 Added Buck_Converter Design Files
    [Buck_Converter.kicad_pcb, Buck_Converter.kicad_sch, Buck_Converter.sch, bom.csv, designators.csv, positions.csv]
2023-07-25 first pass at PR2040 with DRRobot MP3 Player
    [ControlBoardT4_DFminiSound_PowerAmp.kicad_sch, MAX9744.kicad_sch]
2023-07-28 dfrobot rp2040 PCB not done yet
    [Audio_Module.kicad_sch, Buck_Converter.kicad_sch, ControlBoardT4_DFminiSound_PowerAmp.kicad_pcb, ControlBoardT4_DFminiSound_PowerAmp.kicad_sch]
2023-07-31 DFRobot RP2040 Still Not Done
    [Audio_Module.kicad_sch, Buck_Converter.kicad_sch, ControlBoardT4_DFminiSound_PowerAmp.kicad_pcb, ControlBoardT4_DFminiSound_PowerAmp.sch, MAX9744.kicad_sch, MAX9744.sch]
2023-08-01 Pico Control Board Design Update
    [Audio_Module.kicad_sch, ControlBoardT4_DFminiSound_PowerAmp.kicad_pcb, ControlBoardT4_DFminiSound_PowerAmp.kicad_sch]
2023-08-08 numerous changes to joystick and other PCBs
    [ControlBoardT4_DFminiSound_PowerAmp.kicad_pcb, ControlBoardT4_DFminiSound_PowerAmp.kicad_sch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]
2023-08-10 Updates to Joystick_L
    [JoystickBoard.kicad_pcb, JoystickBoard.kicad_sch]
2023-08-11 reworking L-shaped analog joystick PCB
    [JoystickBoard.kicad_pcb, JoystickBoard.kicad_sch]
2023-08-13 new PCB to connect buttons to standard action challenge
    [ButtonToActionChallenge.kicad_pcb, ButtonToActionChallenge.kicad_sch, ButtonToActionChallenge.sch]
2023-08-13 New control input tester PCB for RP2040 Pico
    [ControlInputTestRP2040Pico-B_Cu.gbr, ControlInputTestRP2040Pico-B_Mask.gbr, ControlInputTestRP2040Pico-B_Paste.gbr, ControlInputTestRP2040Pico-B_Silkscreen.gbr, ControlInputTestRP2040Pico-Edge_Cuts.gbr, ControlInputTestRP2040Pico-F_Cu.gbr, ControlInputTestRP2040Pico-F_Mask.gbr, ControlInputTestRP2040Pico-F_Paste.gbr]
2023-08-15 adding vias to a couple of PCBs, magic wand PCB changes
    [ButtonToActionChallenge.kicad_pcb, ControlInputTestRP2040Pico.kicad_pcb, Magic_Wand_Timer.kicad_sch]
2023-08-17 button to action challenge PCB gerbers for V1
    [ButtonToActionChallenge-B_Cu.gbr, ButtonToActionChallenge-B_Mask.gbr, ButtonToActionChallenge-B_Paste.gbr, ButtonToActionChallenge-B_Silkscreen.gbr, ButtonToActionChallenge-Edge_Cuts.gbr, ButtonToActionChallenge-F_Cu.gbr, ButtonToActionChallenge-F_Mask.gbr, ButtonToActionChallenge-F_Paste.gbr]
2023-08-17 rp2040 control input tester PCB gerbers for V1
    [ControlInputTestRP2040Pico-B_Cu.gbr, ControlInputTestRP2040Pico-B_Mask.gbr, ControlInputTestRP2040Pico-B_Paste.gbr, ControlInputTestRP2040Pico-B_Silkscreen.gbr, ControlInputTestRP2040Pico-Edge_Cuts.gbr, ControlInputTestRP2040Pico-F_Cu.gbr, ControlInputTestRP2040Pico-F_Mask.gbr, ControlInputTestRP2040Pico-F_Paste.gbr]
2023-08-17 L-shaped analog joystick PCB gerbers
    [JoystickBoard-B_Cu.gbr, JoystickBoard-B_Mask.gbr, JoystickBoard-B_Paste.gbr, JoystickBoard-B_SilkS.gbr, JoystickBoard-B_Silkscreen.gbr, JoystickBoard-Edge_Cuts.gbr, JoystickBoard-F_Cu.gbr, JoystickBoard-F_Mask.gbr]
2023-08-17 first pass at rp2040 pico car firmware
2023-08-17 drive-by-wire button PCB gerbers for v1
    [DriveByWireButton-B_Cu.gbr, DriveByWireButton-B_Mask.gbr, DriveByWireButton-B_Paste.gbr, DriveByWireButton-B_Silkscreen.gbr, DriveByWireButton-Edge_Cuts.gbr, DriveByWireButton-F_Cu.gbr, DriveByWireButton-F_Mask.gbr, DriveByWireButton-F_Paste.gbr]
2023-08-18 magic wand PCB updates
    [Magic_Wand_Timer.kicad_pcb, Magic_Wand_Timer.kicad_sch]
2023-08-18 Adding i2c to ATTiny code
2023-08-21 Updating Input Joystick PCB to add additional LED connector and switch to Tag-Connect for programming
    [InputJoyStickSTM32QFN28.kicad_pcb, InputJoyStickSTM32QFN28.kicad_sch]
2023-08-24 analog joystick firmware, updating drive-by-wire firmware to latest version
2023-08-25 Implementing reading the speed control value over I2C
2023-08-25 removing unnecessary PCB zip backups
2023-08-27 reversing sound settings read from potentiometer to reverse the direction the user turns the knob
    [GeeksSoundsDFRobotMini.ino]
2023-08-28 adding code to check for active pin to stop car if a control system is not connected - plus a little cleanup
2023-08-28 adding code for Analog Joystick Firmware to pull the active pin high
2023-09-01 updating control panel PCB to use new programming header, smaller SMDs and with JLCPCB part numbers
    [ControlPanelSTM32QFN28.kicad_pcb, ControlPanelSTM32QFN28.kicad_sch]
2023-09-05 New PCB for whack-a-mole to sit on top of main DF RP2040 control PCB - not complete yet
    [ControlBoardPico_Hat.kicad_pcb, ControlBoardPico_Hat.kicad_sch]
2023-09-06 Whack-a-mole Pico HAT PCB clean up
    [ControlBoardPico_Hat.kicad_pcb, ControlBoardPico_Hat.kicad_sch]
2023-09-14 new RP2040 Pico Expansion PCB
    [Audio_Module.kicad_sch, Buck_Converter.kicad_sch, ControlBoardPico_ExpansionBoard.kicad_pcb, ControlBoardPico_ExpansionBoard.kicad_sch]
2023-09-15 updating Drive By Wire PCB to latest KiCad
    [DriveByWireInputAltSTM32QFN28.kicad_pcb, DriveByWireInputAltSTM32QFN28.kicad_sch]
2023-09-15 updating default EEPROM values to PWM signals and RC true
2023-09-15 updating Control Panel Firmware to use Active Signal and updating to latest STM32 IDE
2023-09-15 Adding Active Switch checking to Input Tester code
2023-09-30 Drive by wire and Digital Joystick Firmware changes for Active signal
2023-10-20 reversing steering signal for analog joystick firmware
    [main.c]
2023-10-20 adding code to primary car firmware to check for a reverse switch
    [a_constants.ino, j_joystick.ino]
2023-10-24 primary pcb changes
    [Audio_Module.kicad_sch, ControlBoardT4_DFminiSound_PowerAmp.kicad_pcb, ControlBoardT4_DFminiSound_PowerAmp.kicad_sch]
2023-10-24 joystick L board updates
    [JoystickBoard.kicad_pcb, JoystickBoard.kicad_sch]
2023-10-25 drive by wire PCB changes for production order, Joystick_L PCB changes for production order
    [DriveByWireInputAltSTM32QFN28.kicad_pcb, DriveByWireInputAltSTM32QFN28.kicad_sch]
2023-11-01 Updating all projects to latest STM32 CubeIDE
2023-11-09 New PCB to handle both RJ45 and Can Bus connections in a feather format
    [FeatherRJ45.kicad_pcb, FeatherRJ45.kicad_sch, TS-1187A-B-A-B.step, TYPE-C-31-M-12.step]
2023-11-09 adjustments to SWD adapter PCB to support 14pin STM32 connector
    [SWDAdapter.kicad_pcb, SWDAdapter.kicad_sch]
2023-11-09 first pass at new input tester code to work with ESP32-S3 TFT Feather and Feather RJ45 PCB
2023-11-09 PCB for drive-by-wire button
    [DriveByWireButton.kicad_pcb]
2023-11-09 control panel pcb gerbers
    [ControlPanelSTM32QFN28.kicad_pcb]
2023-11-09 magic wand timer pcb gerbers
2023-11-09 disable A button on Teensy input tester because it conflicts with Active SW pin
2023-11-21 Auto stash before merge of "master" and "origin/master"
    [RJ45GoButton.kicad_sch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]
2023-11-21 moving numerous PCBs to archive folder
    [Clinic_RJ45_Splitter-B_Cu.gbr, Clinic_RJ45_Splitter-B_Mask.gbr, Clinic_RJ45_Splitter-B_Paste.gbr, Clinic_RJ45_Splitter-B_Silkscreen.gbr, Clinic_RJ45_Splitter-Edge_Cuts.gbr, Clinic_RJ45_Splitter-F_Cu.gbr, Clinic_RJ45_Splitter-F_Mask.gbr, Clinic_RJ45_Splitter-F_Paste.gbr]
2023-11-21 2nd try moving lots of PCBs to archive folder
    [Audio_Module.kicad_sch, Buck_Converter.kicad_sch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]
2023-12-19 misc changes
    [InputJoyStickSTM32QFN28.step]
2023-12-19 drive by wire button PCB Kicad version update
    [DriveByWireButton.kicad_pcb, DriveByWireButton.kicad_sch]
2024-02-12 Magic Wand Timer Updates
    Added 12V/5V switching, SMD/THT potentiometer options, Delayed start to handle erratic comparator behavior
    [Magic_Wand_Timer.kicad_pcb, Magic_Wand_Timer.kicad_sch]
2024-02-13 First Upload
    ATtiny Breakout board with DF Robot and amp for sounds.
    [ATTinyBreakOut_DFRobot_Amp-B_Cu.gbr, ATTinyBreakOut_DFRobot_Amp-B_Mask.gbr, ATTinyBreakOut_DFRobot_Amp-B_Paste.gbr, ATTinyBreakOut_DFRobot_Amp-B_Silkscreen.gbr, ATTinyBreakOut_DFRobot_Amp-Edge_Cuts.gbr, ATTinyBreakOut_DFRobot_Amp-F_Cu.gbr, ATTinyBreakOut_DFRobot_Amp-F_Mask.gbr, ATTinyBreakOut_DFRobot_Amp-F_Paste.gbr]
2024-02-13 Wand Timer V3 Routing
    Finished routing components for V3 Magic Wand Timer
    [Magic_Wand_Timer.kicad_pcb, Magic_Wand_Timer.kicad_sch]
2024-02-13 Fixed I2C Ground
    [ControlBoardT4_DFminiSound_PowerAmp.kicad_pcb, ControlBoardT4_DFminiSound_PowerAmp.kicad_sch]
2024-02-13 Minor Updates and BOM
    [ATTinyBreakOut_DFRobot_Amp-B_Cu.gbr, ATTinyBreakOut_DFRobot_Amp-B_Mask.gbr, ATTinyBreakOut_DFRobot_Amp-B_Paste.gbr, ATTinyBreakOut_DFRobot_Amp-B_Silkscreen.gbr, ATTinyBreakOut_DFRobot_Amp-Edge_Cuts.gbr, ATTinyBreakOut_DFRobot_Amp-F_Cu.gbr, ATTinyBreakOut_DFRobot_Amp-F_Mask.gbr, ATTinyBreakOut_DFRobot_Amp-F_Paste.gbr]
2024-03-02 adjusting primary drive firmware to allow the use of the RC when no drive system is attached
2024-03-02 asdjnsdav
    zkldfnvokwnaeuiohewf
    [Magic_Wand_Timer.kicad_pcb, Magic_Wand_Timer_Simplified.kicad_pcb, Magic_Wand_Timer_Simplified.kicad_sch]
2024-03-08 removing reverse switch from drive-by-wire code
    [main.c]
2024-03-21 Changes in progress for V2 - new PCB design
2024-04-02 fixxng issue with button index and updating volume pin
    [AnimalSoundsGame.ino]
2024-04-16 final magic wand sample PCB
    [Magic_Wand_Timer_Simplified.kicad_pcb]
2024-05-20 Update to Magic Wand Timer V4
    Added decoupling capacitors, voltage select through polyfuse, moved connectors for load, caddy, button
    [Magic_Wand_Timer-B_Mask.gbr, Magic_Wand_Timer-B_Paste.gbr, Magic_Wand_Timer-B_Silkscreen.gbr, Magic_Wand_Timer-Edge_Cuts.gbr, Magic_Wand_Timer-F_Cu.gbr, Magic_Wand_Timer-F_Fab.gbr, Magic_Wand_Timer-F_Mask.gbr, Magic_Wand_Timer-F_Paste.gbr]
2024-05-20 generated STEP file
    Needed as mechanical reference for printed mount
    [Magic_Wand_Timer_Simplified.step]
2024-05-21 re-exporting production files for magic wand timer
2024-08-15 prototype 60mm and 100mm button PCBs
    [Button 60mm.kicad_pcb, Button 60mm.kicad_sch, Button100mm.kicad_pcb, Button100mm.kicad_sch]
2024-09-14 new PCB for M5Dial Power
    [M5DialPowerAdapter.kicad_pcb, M5DialPowerAdapter.kicad_sch]
2024-09-26 fixing I2C code for configuration and updating version number
    [a_constants.ino, e_configuration.ino]
2024-09-27 Updates to bring 12 volts from Caddy
    [M5DialPowerAdapter.kicad_pcb, M5DialPowerAdapter.kicad_sch]
2024-09-27 Updates to send 12 volts from caddy to m5 dial
    [Audio_Module.kicad_sch, Buck_Converter.kicad_sch, ControlBoardT4_DFminiSound_PowerAmp.kicad_pcb, ControlBoardT4_DFminiSound_PowerAmp.kicad_sch]
2024-10-03 Early version of Raspberry Pi Hat for use with BTT 5 screen
    [Raspberry Pi BTT 5 Hat.kicad_pcb, Raspberry Pi BTT 5 Hat.kicad_sch]
2024-10-08 fixing I2C code for getting version, updating the version for Dial and Car
    [M5DialSpeedVolume.ino, a_constants.ino, e_configuration.ino, z_setup_loop.ino]
2024-10-08 new main caddy PCB for M5Dial
    [ControlBoardT4_DFminiSound_PowerAmp.kicad_pcb, ControlBoardT4_DFminiSound_PowerAmp.kicad_sch]
2024-10-08 adding large button pcb (V1)
    [button_pcb.step, large_button.kicad_pcb, large_button.kicad_sch]
2024-10-11 add small button
    [Small_Button.kicad_pcb, Small_Button.kicad_sch, button_pcb.step]
2024-10-12 Initial Commit
    Modified existing magic wand timer to create first revision of pulse pwm timer. Added PWM control and dedicated motor driver
    [Pulse_PWM_Timer-B_Cu.gbr, Pulse_PWM_Timer-B_Mask.gbr, Pulse_PWM_Timer-B_Paste.gbr, Pulse_PWM_Timer-B_Silkscreen.gbr, Pulse_PWM_Timer-Edge_Cuts.gbr, Pulse_PWM_Timer-F_Cu.gbr, Pulse_PWM_Timer-F_Fab.gbr, Pulse_PWM_Timer-F_Mask.gbr]
2024-10-12 Removed old gerbers
    Dropped cached gerbers from magic wand timer in pulse pwm timer folder
    [Pulse_PWM_Timer-B_Cu.gbr, Pulse_PWM_Timer-B_Mask.gbr, Pulse_PWM_Timer-B_Paste.gbr, Pulse_PWM_Timer-B_Silkscreen.gbr, Pulse_PWM_Timer-Edge_Cuts.gbr, Pulse_PWM_Timer-F_Cu.gbr, Pulse_PWM_Timer-F_Fab.gbr, Pulse_PWM_Timer-F_Mask.gbr]
2024-10-16 On-delay applied to motor controller
    555 on-delay tied to DRV8876 sleep line. Increased track widths to components with large thermal reliefs to mitigate tombstoning.
    [Pulse_PWM_Timer.kicad_pcb, Pulse_PWM_Timer.kicad_sch]
2024-10-19 Added 3D models and exported STEP
    Included missing models for LM393, 500K SMD trim pots, and DRV8876 controller. Added PCB STEP export
    [DFN8_LM393_STM.step, PWP0016C.stp, Pulse_PWM_Timer.kicad_pcb, Pulse_PWM_Timer.step, TC33X-2-504E.step]
2024-11-03 V2- Switched to POR IC
    Swapped power-on-reset circuit for dedicated 500ms reset IC. Added additional decoupling caps to reset lines.
    [Pulse_PWM_Timer.kicad_pcb, Pulse_PWM_Timer.kicad_sch]
2024-11-09 swapping pins for RC throttle and steering for new PCB car version C24.11.1
    [a_constants.ino]
2024-11-27 First pass at head control with pseudo buttons code
2024-12-04 switching to internal Pull Down for Head Control enable switch
2024-12-06 updating button to action challenge PCB to use 12v for button LED
    [ButtonToActionChallenge.kicad_pcb, ButtonToActionChallenge.kicad_sch]
2024-12-06 missed file for Button to Action Challenge PCB update
2024-12-07 Added step file
    [ControlPanelSTM32QFN28.step]
2024-12-16 first pass at TOF button PCB
    [TOF_Button.kicad_pcb, TOF_Button.kicad_sch]
2024-12-19 head control button software for two distance sensors
2024-12-21 first pass at TFT control panel STM32 RJ-45 PCB firmware
2024-12-21 Code for 7 inch TFT to mimic control panel buttons
2025-01-02 firmware for new head control and control panel PCBs
2025-01-02 2 new pcbs with 2 variants for control panels and tof buttons
    [ControlPanel_DistanceSensor.kicad_pcb, ControlPanel_DistanceSensor.kicad_sch, ControlPanel_DistanceSensor_KB2040.kicad_pcb, ControlPanel_DistanceSensor_KB2040.kicad_sch, TOF_Button KB2040.kicad_pcb, TOF_Button KB2040.kicad_sch, TOF_Button.kicad_pcb]
2025-01-17 minor changes to head control button code
2025-01-17 fixing NeoPixel symbol for TOF Button PCB
    [TOF_Button.kicad_pcb, TOF_Button.kicad_sch]
2025-02-04 empty project for single button control panel firmware
2025-02-08 single button cp code, vcnl4200 cp tweak, tof button version text change
    [TOF_Button.kicad_pcb]
2025-02-09 adding code to light the reverse signal LED for touchless cp
2025-02-09 PCB fix for TOF buttons
    [TOF_Button KB2040.kicad_pcb, TOF_Button KB2040.kicad_sch, TOF_Button KB2040.step, TOF_Button.kicad_pcb]
2025-02-12 adding the configuration parameter to car firmware to allow the parent to steer while the child drives
2025-02-14 tweaks for car firmware for single button drive system with parent steering
2025-03-01 initial M5Dial CircuitPython code
2025-03-03 first pass at Arduino code for M5Dial with Speed, Volume and Configuration
2025-03-10 tweaks to M5Dial Configuration I2C code
2025-03-13 Refactoring M5Dial configuration code and adding Linear actuator movement during configuration
2025-03-13 Changes for RC direct Plug
    [Audio_Module.kicad_sch, Buck_Converter.kicad_sch, ControlBoardT4_DFminiSound_PowerAmp.kicad_pcb, ControlBoardT4_DFminiSound_PowerAmp.kicad_sch]
2025-03-15 Fixing the Linear Actuator Configuration code
    [s_steering.ino]
2025-04-13 insert summary here
    [Small_Button.kicad_pcb, Small_Button.kicad_sch, button_pcb.step, large_button.kicad_pcb, large_button.kicad_sch]
2025-04-14 Push Control Panel PCB V3
    [ControlPanelV3-B_Cu.gbr, ControlPanelV3-B_Mask.gbr, ControlPanelV3-B_Paste.gbr, ControlPanelV3-B_SilkS.gbr, ControlPanelV3-Edge_Cuts.gbr, ControlPanelV3-F_Cu.gbr, ControlPanelV3-F_Mask.gbr, ControlPanelV3-F_Paste.gbr]
2025-04-14 Update Small Button PCB
    [Small_Button.kicad_pcb, Small_Button.kicad_sch]
2025-04-16 Update Large Button PCB
    [ControlPanelV3.kicad_pcb, Output_Connectors.kicad_sch, Small_Button.kicad_pcb, Small_Button.kicad_sch, button_pcb.step, large_button.kicad_pcb, large_button.kicad_sch]
2025-04-16 Fixing resistor pkg sizes
    [Small_Button.kicad_pcb, large_button.kicad_pcb]
2025-04-17 update button pcb
    [Small_Button.kicad_pcb, Small_Button.kicad_sch, large_button.kicad_pcb, large_button.kicad_sch]
2025-04-25 Flip SMT components for Large Button PCB to bottom side
    [large_button.kicad_pcb, large_button.kicad_sch]
2025-04-25 Generate Control Panel PCB Gerbers
    [ControlPanelV3.kicad_pcb, Small_Button.kicad_pcb]
2025-05-03 New Board for WhackAMole/Simon Game
    [WhackAMole-B_Cu.gbr, WhackAMole-B_Mask.gbr, WhackAMole-B_Paste.gbr, WhackAMole-B_Silkscreen.gbr, WhackAMole-Edge_Cuts.gbr, WhackAMole-F_Cu.gbr, WhackAMole-F_Mask.gbr, WhackAMole-F_Paste.gbr]
2025-05-03 Minor WhackAMole Silkscreen updates
    Minor WhackAMole Silkscreen updates. Also added "other pin" to the signal connector to the caddy.
    [WhackAMole-B_Cu.gbr, WhackAMole-B_Mask.gbr, WhackAMole-B_Paste.gbr, WhackAMole-B_Silkscreen.gbr, WhackAMole-Edge_Cuts.gbr, WhackAMole-F_Cu.gbr, WhackAMole-F_Mask.gbr, WhackAMole-F_Paste.gbr]
2025-05-05 Production PCB files for WhackAMole PCB
    [WhackAMole.kicad_pcb, bom.csv, designators.csv, positions.csv]
2025-05-06 Update Large Button PCB to V2
    Rotate Cherry MX switches / LEDs by 90 degrees so that LEDs are on outside edge of button
    [bom.csv, designators.csv, large_button.kicad_pcb, positions.csv]
2025-05-14 whack-a-mole code setting output current for LEDs and setting volume more frequently
2025-05-14 fixing issue with I2C bus triggering configuration mode unexpectedly car firmware version 25.04.1
    [a_constants.ino, e_configuration.ino, s_steering.ino, t_throttle.ino, u_m5dial_configuration.ino, z_setup_loop.ino]
2025-05-16 fixing two bugs on car firmware, one when no drive system is active and the other with bad i2c data
    [a_constants.ino, e_configuration.ino, t_throttle.ino]
2025-05-17 adding config parameter to car firmware to allow swapping pins for RC throttle and steering
    [a_constants.ino, b_eeprom.ino, e_configuration.ino, z_setup_loop.ino]
2025-05-18 Fixing bug with timeout in Simon Game
    Found Bug in Simon game. When the game returns from timeout the startup animation would play, then the "Right" or "Wrong" sound from the Simon game would play before starting a new game.
    Changed name of "checkTimeout" function to "hasTimeoutOccured" that returns a bool when the timeout occurs. Updated "checkIfGameChanged" function to change game state to 2 after the game returns from being deactivated. Updated skip logic in get_sequence function to break on all loops once skip is true instead of just the current loop.
    [AnimalSoundsGame_Simon.ino]
2025-05-19 pcb production files
    [bom.csv, designators.csv, positions.csv]
2025-05-20 Updating Simon difficulty ramping
    Changed from linear speed up to a cubic root function. Removed some unnecessary comments and print statements.
2025-05-20 Updating Simon difficulty ramping
    Uploaded the wrong file previously. Changed from linear speed up to a cubic root function. Removed some unnecessary comments and print statements.
    [AnimalSoundsGame_Simon.ino]
2025-05-20 Actually Updating Simon difficulty ramping
    Changing from linear speed up to a cubic root function. Removed some unnecessary comments and print statements.
2025-05-26 fixing remote issue with car firmware, fixing sound issue with soft touch control panel firmware
    [a_constants.ino, e_configuration.ino]
2025-05-29 changing drive system OLED tester to default to PWM and lower the startup delay
2025-05-29 LED updates to Cherry MX Control Panel firmware
2025-05-29 misc PCB production csv files
    [bom.csv, designators.csv, positions.csv]
2025-08-22 adding support for reverse RC channels in M5Dial and enabling it on Car Firmware
    [a_constants.ino, e_configuration.ino]
2025-09-19 Initial commit for pulse fixed timer
    Removed adjustable PWM and adjustable delay from Pulse PWM Timer
    [DFN8_LM393_STM.step, PWP0016C.stp, Pulse_Fixed_Timer.kicad_pcb, Pulse_Fixed_Timer.kicad_sch, TC33X-2-504E.step, bom.csv, designators.csv, positions.csv]
2025-09-21 updated BOM
    [Pulse_Fixed_Timer.kicad_pcb, Pulse_Fixed_Timer.kicad_sch]
2025-09-29 updating Pulse Fixed Timer to latest KiCad version
    [Pulse_Fixed_Timer.kicad_pcb, Pulse_Fixed_Timer.kicad_sch]
2025-09-29 Updated PCB name and version and generated Production files
    [Pulse_Fixed_Timer.kicad_pcb, bom.csv, designators.csv, positions.csv]
2025-10-16 3v to 5v RC Fix v4
    Changed the 3v line on the RC power to be 5v to help with issues with newer remotes. Changed Board Version to V4.
    [Audio_Module.kicad_sch, Buck_Converter.kicad_sch, ControlBoardT4_DFminiSound_PowerAmp.kicad_pcb, ControlBoardT4_DFminiSound_PowerAmp.kicad_sch]
2025-10-25 Added motor-controller-v3 draft KiCAD files
    [DRV8701.kicad_sch, motor-controller-v3.kicad_pcb, motor-controller-v3.kicad_sch]
2025-10-25 Rename old motor controller KiCAD folder to motor-controller-v2 for clarity
    [Brushed_DC_Motor_Driver.csv, Brushed_DC_Motor_Driver.kicad_pcb, Brushed_DC_Motor_Driver.kicad_sch, Brushed_DC_Motor_Driver.sch, Brushed_DC_Motor_Driver.step, Brushed_DC_Motor_Driver.xml, bom.csv, designators.csv]
2025-10-27 Finished motor-controller-v3 draft
    [DRV8701.kicad_sch, motor-controller-v3.kicad_pcb, motor-controller-v3.kicad_sch]
2025-10-29 Adjust R_sense
    [DRV8701.kicad_sch, bom.csv, designators.csv, motor-controller-v3.kicad_pcb, motor-controller-v3.kicad_sch, positions.csv]
2025-10-31 Big commit
    [Small_Button.kicad_pcb, Small_Button.kicad_sch, bom.csv, designators.csv, large_button.kicad_pcb, large_button.kicad_sch, positions.csv]
2026-02-14 Updated Action Challenge Connector Board
    [ButtonToActionChallenge.kicad_pcb, ButtonToActionChallenge.kicad_sch, bom.csv, designators.csv, export_cart_20240303_062546.csv, positions.csv]
2026-02-25 start of ryder steering wheel button connector pcb
    [RyderSteeringButtonConnector.kicad_pcb, RyderSteeringButtonConnector.kicad_sch]
2026-03-12 adding ryder drive-by-wire PCB - not finished yet
    [RyderDriveByWireMicrocontroller-B_Cu.gbr, RyderDriveByWireMicrocontroller-B_Mask.gbr, RyderDriveByWireMicrocontroller-B_Paste.gbr, RyderDriveByWireMicrocontroller-B_Silkscreen.gbr, RyderDriveByWireMicrocontroller-Edge_Cuts.gbr, RyderDriveByWireMicrocontroller-F_Cu.gbr, RyderDriveByWireMicrocontroller-F_Mask.gbr, RyderDriveByWireMicrocontroller-F_Paste.gbr]
2026-03-12 misc pcb changes and nunchuck code
    [InputJoyStickSTM32QFN28.kicad_pcb, M5DialPowerAdapter.kicad_pcb, bom.csv, designators.csv, positions.csv]
2026-03-13 minor changes to ryder drive by wire pcb
    [RyderDriveByWireMicrocontroller.kicad_pcb, RyderDriveByWireMicrocontroller.kicad_sch]
2026-03-15 v2 of ryder steering wheel button connnector pcb
    [RyderSteeringButtonConnector.kicad_pcb, RyderSteeringButtonConnector.kicad_sch, RyderSteeringButtonConnector.step, bom.csv, designators.csv, positions.csv]
2026-03-16 reworking layout of ryder steering button PCB again
    [RyderSteeringButtonConnector.kicad_pcb, RyderSteeringButtonConnector.step, positions.csv]
2026-03-20 Reorganize HW Folder
    [3557-2.step, 3568.step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]
2026-03-20 Reorganize HW folder pt 2
    [4PinJstShBreakout-B_Cu.gbr, 4PinJstShBreakout-B_Mask.gbr, 4PinJstShBreakout-B_Paste.gbr, 4PinJstShBreakout-B_Silkscreen.gbr, 4PinJstShBreakout-Edge_Cuts.gbr, 4PinJstShBreakout-F_Cu.gbr, 4PinJstShBreakout-F_Mask.gbr, 4PinJstShBreakout-F_Paste.gbr]
2026-03-21 more work on ryder steering wheel pcb
    [RyderDriveByWireMicrocontroller.kicad_pcb, RyderDriveByWireMicrocontroller.kicad_sch]
2026-03-21 re-adding ryder dbw microcontroller after merge wipeout
    [RyderDriveByWireMicrocontroller.kicad_pcb, RyderDriveByWireMicrocontroller.kicad_sch, RyderDriveByWireMicrocontroller.sch, RyderDriveByWireMicrocontroller.step]
2026-03-21 ryder dbw pcb v1 complete
    [RyderDriveByWireMicrocontroller.kicad_pcb, RyderDriveByWireMicrocontroller.kicad_sch, bom.csv, designators.csv, positions.csv]
2026-03-23 push ecu placement
    [3557-2.step, 3568.step, APR.stp, DRV8701.kicad_sch, J115F11A_Sealed_NoPin6.stp, LM5176.kicad_sch, RLT0007A.stp, RP2040.kicad_sch]
2026-03-23 moving drive by wire ryder pcb back into proper folder
    [RyderDriveByWireMicrocontroller-B_Cu.gbr, RyderDriveByWireMicrocontroller-B_Mask.gbr, RyderDriveByWireMicrocontroller-B_Paste.gbr, RyderDriveByWireMicrocontroller-B_Silkscreen.gbr, RyderDriveByWireMicrocontroller-Edge_Cuts.gbr, RyderDriveByWireMicrocontroller-F_Cu.gbr, RyderDriveByWireMicrocontroller-F_Mask.gbr, RyderDriveByWireMicrocontroller-F_Paste.gbr]
2026-04-05 Update Ryder ECU V1 Draft
    Ryder ECU is close to completion, power planes and high current paths still need some work.
    [RP2040.kicad_sch, audio.kicad_sch, geeks-ecu.kicad_sch]
2026-04-09 New Capacitive touch Control Panel PCB and a few tweaks to Ryder Steering wheel PCB
    [ControlPanel_CapacitiveTouch.kicad_pcb, ControlPanel_CapacitiveTouch.kicad_sch, RyderDriveByWireMicrocontroller.kicad_pcb, RyderDriveByWireMicrocontroller.step, RyderSteeringButtonConnector.kicad_sch]
2026-04-16 more work on capacitive touch CP PCB
    [ControlPanel_CapacitiveTouch.kicad_sch]
2026-04-19 updated pulse_fixed_timer to KiCad 10
    [Pulse_Fixed_Timer.kicad_pcb, Pulse_Fixed_Timer.kicad_sch]
2026-04-20 Initial commit for joystick actuator
    [Joystick_Actuator.kicad_pcb, Joystick_Actuator.kicad_sch]
2026-04-20 In progress Capacitive Touch PCB
    [ControlPanel_CapacitiveTouch.kicad_pcb, ControlPanel_CapacitiveTouch.kicad_sch]
2026-04-21 added major schematic components
    [Joystick_Actuator.kicad_sch]
2026-04-21 more capacitive touch pcb changes
    [ControlPanel_CapacitiveTouch.kicad_pcb, ControlPanel_CapacitiveTouch.kicad_sch]
2026-04-22 final v1 pcb for capacitive touch
    [ControlPanel_CapacitiveTouch.kicad_pcb, ControlPanel_CapacitiveTouch.kicad_sch, bom.csv, designators.csv, positions.csv]
2026-04-25 placed components and added power/signal traces
    [Joystick_Actuator.kicad_pcb, Joystick_Actuator.kicad_sch]
2026-04-25 Ryder ECU Updates
    Continuing to clean up ECU design
    [DRV8701.kicad_sch, LM5176.kicad_sch, RP2040.kicad_sch, audio.kicad_sch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]
2026-04-25 Added remaining routing and MPNs
    [Joystick_Actuator.kicad_pcb, Joystick_Actuator.kicad_sch]
2026-04-27 Ryder ECU Cleanup
    Still need to work on high current traces
    [DRV8701.kicad_sch, DRV8701_LowCurrent.kicad_sch, LM5176.kicad_sch, NS-Tech_Grove_1x04_P2mm_Vertical.step, RP2040.kicad_sch, TerminalBlock_CUI_TB007-508-02_1x02_P5.08mm_Horizontal.step, TerminalBlock_CUI_TB007-508-03_1x03_P5.08mm_Horizontal.step, audio.kicad_sch]
2026-04-28 Finalize Ryder ECU
    [DRV8701.kicad_sch, DRV8701_LowCurrent.kicad_sch, LM5176.kicad_sch, RP2040.kicad_sch, audio.kicad_sch, geeks-ecu.csv, geeks-ecu.kicad_sch, io_connectors.kicad_sch]
2026-04-30 production files for joystick actuator PCB
    [Joystick_Actuator.kicad_pcb, bom.csv, designators.csv, positions.csv]
2026-04-30 Final Ryder ECU Design Files
    All done!
    [DRV8701.kicad_sch, DRV8701_LowCurrent.kicad_sch, LM5176.kicad_sch, RP2040.kicad_sch, audio.kicad_sch, bom.csv, designators.csv, geeks-ecu.kicad_sch]
2026-05-01 Add SCM TODO note about RC connector
    [geeks-ecu.kicad_sch]
2026-05-18 ryder car code for driving, voltage, temp sensors, etc.
2026-05-18 more testing of sound code with rp2040 pico
2026-05-21 adding ryder firmware code for sound buttons
2026-05-23 getting sound to work on new Ryder PCB and adding sound files
2026-05-23 Update TODO notes on Ryder SCM
    [.step, ButtonToActionChallenge.kicad_pcb, ButtonToActionChallenge.step, geeks-ecu.kicad_sch]
2026-05-24 Renaming Ryder firmware Arduino code
2026-05-25 various fixes for Ryder firmware
    [a_constants.ino, aa_todo.ino, b_eeprom.ino, e_configuration.ino, g_gpio_expander.ino, j_joystick.ino, t_throttle.ino, u_m5dial_configuration.ino]
2026-05-25 Ryder firmware - fixing audio issue, documentation, new mp3 files
    [aa_todo.ino, car_firmware_ryder_rp2040_m5dial.ino, z_setup_loop.ino]
2026-05-25 adding additional Arduino IDE configuration instructions
2026-05-25 fixing remote control issue with Ryder firmware
    [a_constants.ino, car_firmware_ryder_rp2040_m5dial.ino, r_remote_control.ino]
2026-05-26 fixing braking code for Ryder firmware
    [a_constants.ino, r_remote_control.ino, t_throttle.ino, z_setup_loop.ino]
2026-05-27 adding brake intensity configuration parameter and reworking serial input
    [aa_todo.ino, b_eeprom.ino, e_configuration.ino, i_sound_processing.ino, t_throttle.ino, z_setup_loop.ino]
2026-05-28 adding m5 dial configuration for brake intensity and mute dac when not in use
2026-05-29 moviing Wire.h include to top of M5Dial code
2026-07-20 Replacement PCB for holding steering wheel button
    [RyderSteeringButtonHolder.kicad_pcb, RyderSteeringButtonHolder.kicad_sch, bom.csv, designators.csv, positions.csv]
2026-07-30 fixing footprint on button holder PCB
    [RyderSteeringButtonHolder.kicad_pcb, RyderSteeringButtonHolder.kicad_sch, bom.csv, positions.csv]
2026-07-30 missed a file
    [RyderSteeringButtonHolder.kicad_pcb]
2026-07-31 Capacitive Touch CP v2
    [ControlPanel_CapacitiveTouch.kicad_pcb, ControlPanel_CapacitiveTouch.kicad_sch, bom.csv, positions.csv]
2026-09-06 adding new action challenge pcb
    [Microprocessor_Action_Challenge.kicad_pcb, Microprocessor_Action_Challenge.kicad_sch]
