synthesissolutions/geeksforkids/(notices)

Notices in the files:
software/STM32Workspace/STM32G031G8_MxControlPanelFirmware/Core/Inc/main.h:
Copyright (c) 2025 STMicroelectronics.
All rights reserved.
This software is licensed under terms that can be found in the LICENSE file
software/STM32Workspace/STM32G031G8_DriveByWireRyder/Core/Src/main.c:
Copyright (c) 2026 STMicroelectronics.
parts and their libraries:
Copyright 2021 Accelerated Designs. All rights reserved.
